VICA-smarthandle/vica_ros2_ws/maps/vica_map_0630.png

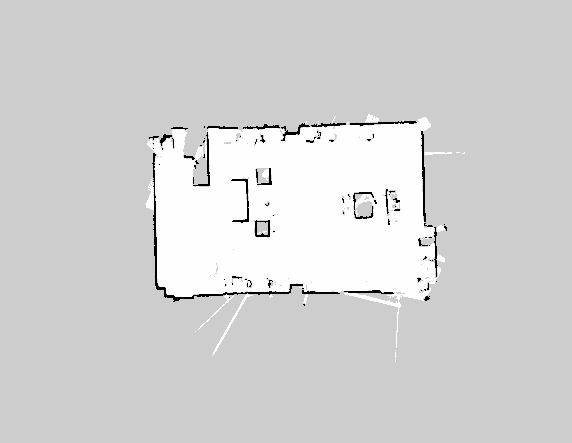
maps/vica_map_0630.png
