VICA-smarthandle/vica_ros2_ws/src/vica_description/meshes/left_wheel_1.stl

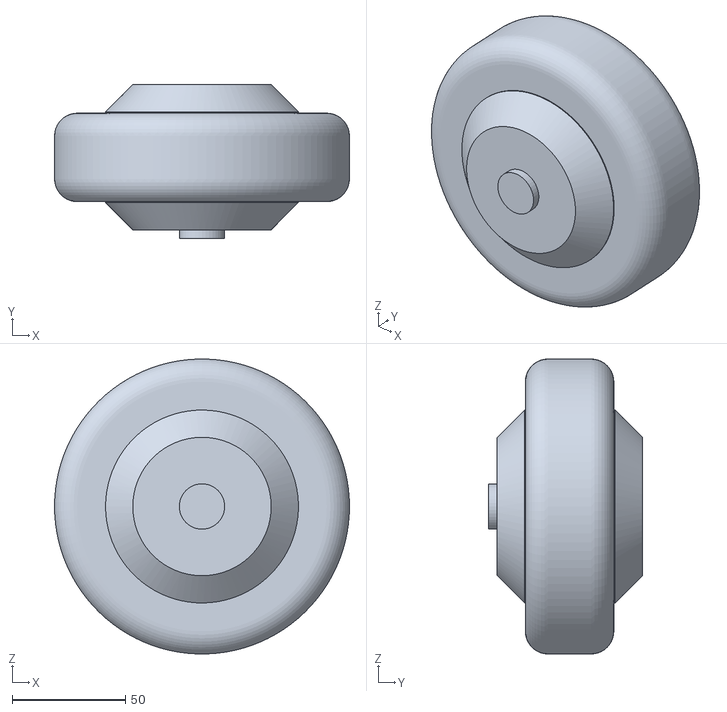
[picture p2: CAD file, 2026-09-11]
src/vica_description/meshes/left_wheel_1.stl
130.0 x 67.8 x 129.9
