VICA-smarthandle/vica_ros2_ws/src/vica_description/meshes/front_left_caster_steer_1.stl

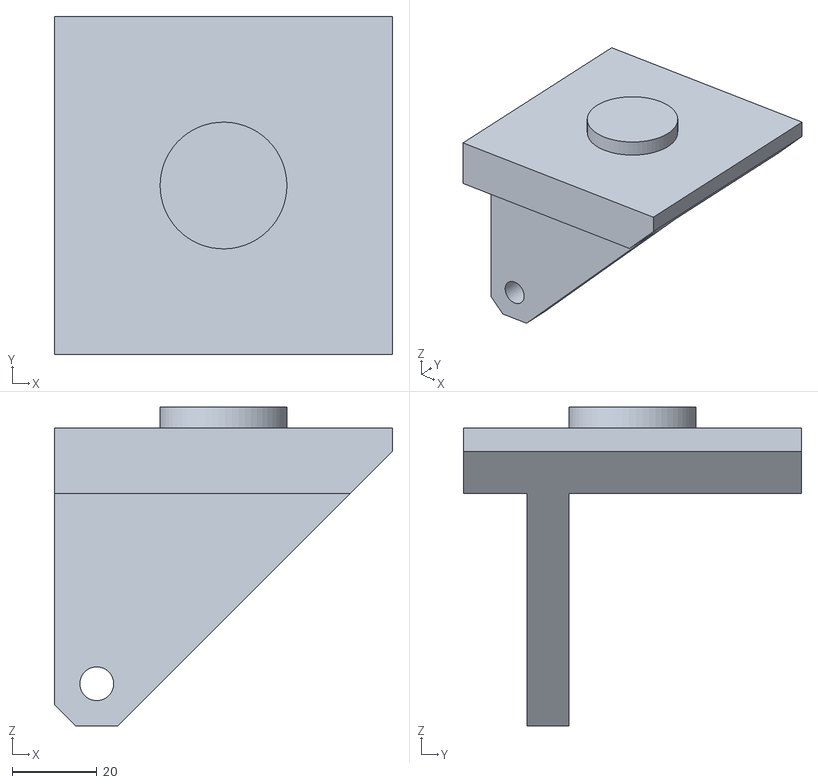
[picture p3: CAD file, 2026-09-11]
src/vica_description/meshes/front_left_caster_steer_1.stl
80.0 x 80.0 x 75.5
