VICA-smarthandle/vica_ros2_ws/src/vica_description/meshes/base_link.stl

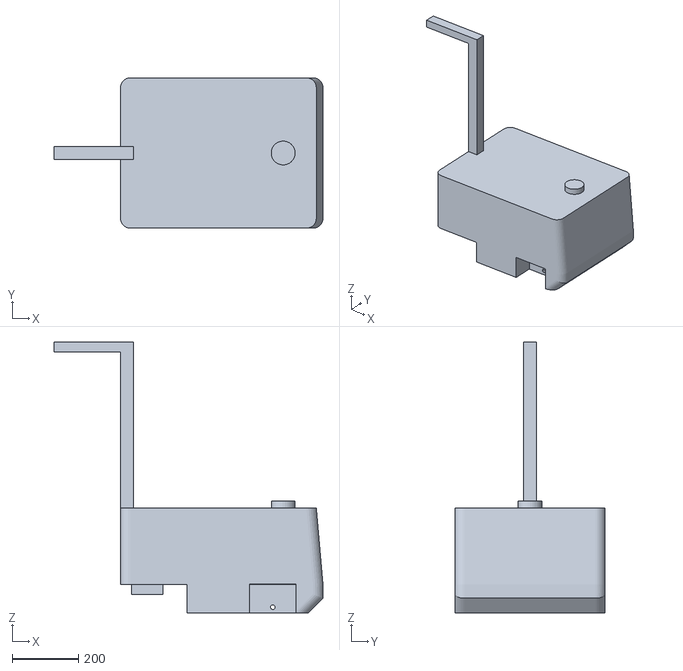
[picture p4: CAD file, 2026-09-11]
src/vica_description/meshes/base_link.stl
810.0 x 453.0 x 815.0
