VICA-smarthandle/vica_ros2_ws/src/vica_description/meshes/lidar_1.stl

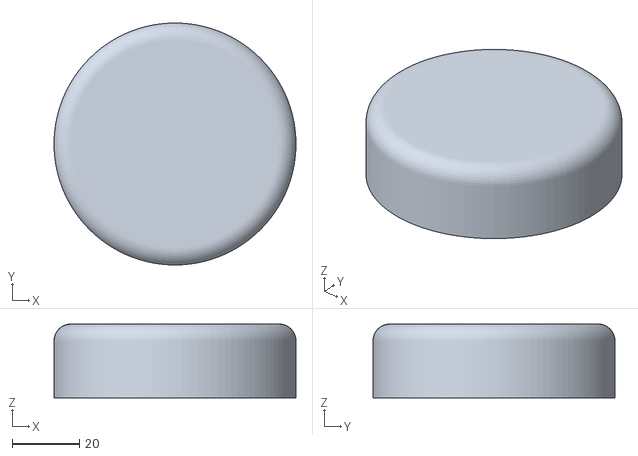
[picture p5: CAD file, 2026-09-11]
src/vica_description/meshes/lidar_1.stl
72.0 x 72.0 x 22.0
