VICA-smarthandle/vica_ros2_ws/src/vica_description/meshes/front_left_caster_wheel_1.stl

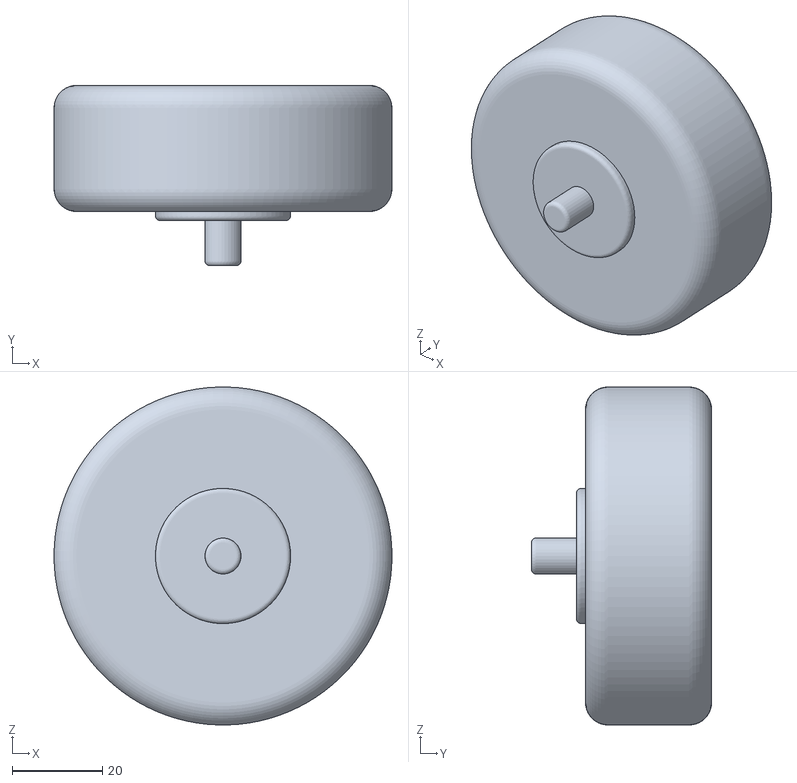
[picture p6: CAD file, 2026-09-11]
src/vica_description/meshes/front_left_caster_wheel_1.stl
75.0 x 40.0 x 75.0
