VICA-smarthandle/vica_ros2_ws/src/vica_description/meshes/base_link_mast.stl

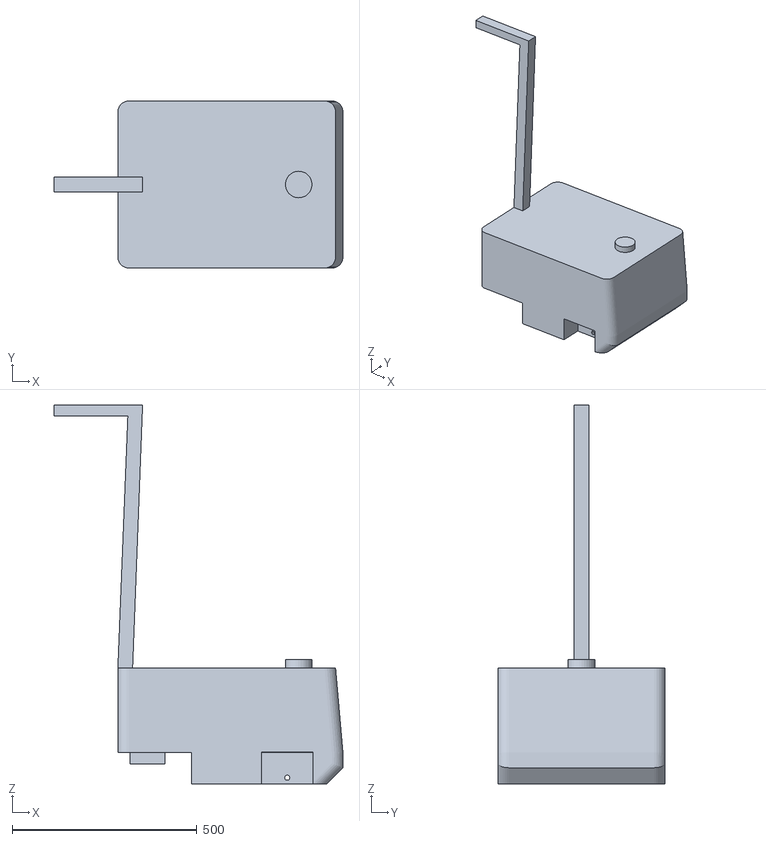
[picture p7: CAD file, 2026-09-11]
src/vica_description/meshes/base_link_mast.stl
783.0 x 453.0 x 1027.0
