VICA-smarthandle/vica_ros2_ws/(list of files, cad)

Other CAD files:
src/vica_description/meshes/front_right_caster_steer_1.stl
src/vica_description/meshes/right_wheel_1.stl
src/vica_description/meshes/front_right_caster_wheel_1.stl
