VICA-smarthandle/vica_ros2_ws/src/vica_system_monitor/config/probes.yaml

external_diagnostics_node:
  ros__parameters:
    diagnostic_period_sec: 1.0

    process_scan_period_sec: 5.0

    topic_probe_names:
      - lidar_scan
      - depth_scan
      - camera_depth
      - camera_color
      - odom
      - wheel_odom
      - handle_state
      - handle_uplink
      - app_bridge

    lidar_scan:
      component: lidar
      topic: /scan
      msg_type: sensor_msgs/msg/LaserScan
      qos: sensor_data
      min_hz: 7.0
      max_hz: 15.0
      fault_code: LIDAR_SCAN_STALE
      optional: false

    depth_scan:
      component: perception
      topic: /camera/depth_scan
      msg_type: sensor_msgs/msg/LaserScan
      qos: sensor_data
      min_hz: 3.0
      max_hz: 40.0
      fault_code: DEPTH_SCAN_STALE
      optional: true

    camera_depth:
      component: perception
      topic: /camera/camera/depth/camera_info
      msg_type: sensor_msgs/msg/CameraInfo
      qos: sensor_data
      min_hz: 10.0
      max_hz: 35.0
      fault_code: CAMERA_DEPTH_STALE
      optional: true

    camera_color:
      component: perception
      topic: /camera/camera/color/camera_info
      msg_type: sensor_msgs/msg/CameraInfo
      qos: sensor_data
      min_hz: 10.0
      max_hz: 35.0
      fault_code: CAMERA_COLOR_STALE
      optional: true

    odom:
      component: localization
      topic: /odom
      msg_type: nav_msgs/msg/Odometry
      qos: default
      min_hz: 20.0
      max_hz: 35.0
      fault_code: LOCALIZATION_ODOM_STALE
      optional: false

    wheel_odom:
      component: localization
      topic: /wheel/odom
      msg_type: nav_msgs/msg/Odometry
      qos: default
      min_hz: 5.0
      max_hz: 40.0
      fault_code: LOCALIZATION_WHEEL_ODOM_STALE
      optional: false

    link_probe_names:
      - cmd_vel_req_link

    cmd_vel_req_link:
      component: navigation
      topic: /cmd_vel_req
      min_publishers: 1
      fault_code: NAV2_CMD_PATH_DOWN

    handle_state:
      component: guidance
      topic: /vica/smart_handle_state
      msg_type: vica_interfaces/msg/SmartHandleState
      qos: default
      min_hz: 1.0
      max_hz: 4.0
      fault_code: GUIDANCE_NODE_SILENT
      optional: true

    handle_uplink:
      component: guidance
      topic: /ultrasonic/front_right
      msg_type: sensor_msgs/msg/Range
      qos: sensor_data
      min_hz: 2.0
      max_hz: 8.0
      fault_code: GUIDANCE_UPLINK_STALE
      optional: true

    app_bridge:
      component: app
      topic: /robot_status
      msg_type: std_msgs/msg/String
      qos: default
      min_hz: 1.0
      max_hz: 4.0
      fault_code: APP_BRIDGE_SILENT
      optional: true

    process_probe_names:
      - imu_adapter
      - ekf_node
      - controller_server
      - motor_node
      - realsense_node
      - voice_wakeword
      - voice_tts
      - voice_llm

    voice_wakeword:
      component: voice
      cmdline_pattern: src.ros_wakeword_node
      required: true
      warn_percent: 90.0

    voice_tts:
      component: voice
      cmdline_pattern: src.ros_tts_node
      required: true
      warn_percent: 90.0

    voice_llm:
      component: voice
      cmdline_pattern: src.ros_node
      required: true
      warn_percent: 90.0

    imu_adapter:
      component: localization
      cmdline_pattern: imu_base_link_adapter
      warn_percent: 55.0

    ekf_node:
      component: localization
      cmdline_pattern: ekf_node
      warn_percent: 20.0

    controller_server:
      component: navigation
      cmdline_pattern: controller_server
      warn_percent: 90.0

    motor_node:
      component: motor
      cmdline_pattern: mdrobot_can_keyboard_knob_node
      warn_percent: 25.0

    realsense_node:
      component: perception
      cmdline_pattern: realsense2_camera_node
      warn_percent: 60.0
