VICA-smarthandle/vica_ros2_ws/src/vica_safety/vica_safety/app_emergency_node.py

"""Public E-stop and reset orchestration ROS node."""

from datetime import datetime, timezone
import json
import threading
import time
from typing import Any, Optional

from action_msgs.msg import GoalStatus, GoalStatusArray
from action_msgs.srv import CancelGoal
from diagnostic_updater import Updater
import rclpy
from rclpy.callback_groups import ReentrantCallbackGroup
from rclpy.clock import Clock, ClockType
from rclpy.executors import ExternalShutdownException, MultiThreadedExecutor
from rclpy.node import Node
from rclpy.qos import qos_profile_action_status_default
from std_msgs.msg import Bool, String
from std_srvs.srv import Trigger

from .auto_recovery import AutoRecoveryPolicy
from .diagnostics import LABEL_BRIDGE, bridge_summary
from .freshness import is_fresh_ns, sec_to_ns
from .logging_utils import log_with_severity
from .reset_sequence import ResetSequence


CAUSE_MESSAGES = (
    ("tipped", "넘어짐이 감지되어 비상정지되었습니다."),
    ("physical_f1", "비상정지 버튼이 눌렸습니다."),
    ("voice", "이용자가 음성으로 멈춤을 요청해 비상정지되었습니다."),
    ("motor_can", "모터 드라이버 통신이 끊겨 비상정지되었습니다."),
    ("motor_can_stale", "모터 드라이버 통신이 끊겨 비상정지되었습니다."),
    ("physical_stale", "모터 드라이버 통신이 끊겨 비상정지되었습니다."),
)

TIP_RESET_REJECT_MESSAGE = (
    "비카가 아직 넘어져 있습니다. 비카를 세운 뒤 다시 해제해 주세요."
)

RESET_REJECT_PREFIX = "Safety reset 거부:"


def primary_cause(sources) -> Optional[str]:
    """Pick the latch cause the app popup should describe, or None."""
    names = set(sources)
    for name, _ in CAUSE_MESSAGES:
        if name in names:
            return name
    return None


def cause_message(cause: str) -> str:
    """Return the operator-facing popup text for one latch cause."""
    return dict(CAUSE_MESSAGES)[cause]


def reset_rejected_by_tip(step: str, reason: str) -> bool:
    """Report whether the central latch refused reset because the body is down."""
    if step != "estop_reset" or ":" not in reason:
        return False
    names = reason.split(":", 1)[1].strip().split(",")
    return "tipped" in names


def has_active_navigation_goals(statuses) -> bool:
    """Treat accepted, executing, and canceling Nav2 goals as active."""
    active = {
        GoalStatus.STATUS_ACCEPTED,
        GoalStatus.STATUS_EXECUTING,
        GoalStatus.STATUS_CANCELING,
    }
    return any(status in active for status in statuses)


def build_app_state(
    app_active: bool,
    emergency_active: bool,
    safety_state: str,
    message: str,
    timestamp: str,
    auto_recovered: bool = False,
    sources: tuple = (),
) -> dict:
    """Build the backward-compatible authoritative app state payload."""
    return {
        "node": "app_emergency_node",
        "active": emergency_active,
        "app_active": app_active,
        "emergency_active": emergency_active,
        "safety_state": safety_state,
        "reset_allowed": (
            not emergency_active
            and safety_state == "ESTOP_RELEASED_WAIT_RESET"
        ),
        "auto_recovered": auto_recovered,
        "sources": list(sources),
        "message": message,
        "timestamp": timestamp,
    }


class AppEmergencyNode(Node):
    """Own public E-stop services and the complete reset orchestration."""

    def __init__(self) -> None:
        super().__init__("app_emergency_node")

        self.declare_parameter("activate_service", "/app_estop_activate")
        self.declare_parameter("app_reset_service", "/app_estop_reset")
        self.declare_parameter("maintenance_reset_service", "/safety_reset")
        self.declare_parameter("app_emergency_stop_topic", "/app_emergency_stop")
        self.declare_parameter("state_topic", "/app_estop_state")
        self.declare_parameter("estop_reset_service", "/vica_safety/internal/estop_reset")
        self.declare_parameter(
            "supervisor_reset_service",
            "/vica_safety/internal/supervisor_reset",
        )
        self.declare_parameter("navigate_action_name", "/navigate_to_pose")
        self.declare_parameter("app_estop_publish_hz", 10.0)
        self.declare_parameter("state_publish_hz", 1.0)
        self.declare_parameter("call_timeout_sec", 2.0)
        self.declare_parameter("state_timeout_sec", 2.0)
        self.declare_parameter("source_settle_sec", 0.2)
        self.declare_parameter("estop_sources_topic", "/estop_sources")
        self.declare_parameter("auto_recover_settle_sec", 1.0)
        self.declare_parameter("auto_recover_check_hz", 2.0)
        self.declare_parameter("auto_recover_enabled", True)

        self.activate_service = str(
            self.get_parameter("activate_service").value
        )
        self.app_reset_service = str(
            self.get_parameter("app_reset_service").value
        )
        self.maintenance_reset_service = str(
            self.get_parameter("maintenance_reset_service").value
        )
        app_topic = str(self.get_parameter("app_emergency_stop_topic").value)
        state_topic = str(self.get_parameter("state_topic").value)
        estop_reset_service = str(
            self.get_parameter("estop_reset_service").value
        )
        supervisor_reset_service = str(
            self.get_parameter("supervisor_reset_service").value
        )
        action_name = str(
            self.get_parameter("navigate_action_name").value
        ).rstrip("/")
        app_publish_hz = float(
            self.get_parameter("app_estop_publish_hz").value
        )
        state_publish_hz = float(
            self.get_parameter("state_publish_hz").value
        )
        self.call_timeout_sec = float(
            self.get_parameter("call_timeout_sec").value
        )
        self.state_timeout_sec = float(
            self.get_parameter("state_timeout_sec").value
        )
        self.source_settle_sec = float(
            self.get_parameter("source_settle_sec").value
        )
        self.auto_recover_settle_sec = float(
            self.get_parameter("auto_recover_settle_sec").value
        )
        self.auto_recover_enabled = bool(
            self.get_parameter("auto_recover_enabled").value
        )
        auto_recover_check_hz = float(
            self.get_parameter("auto_recover_check_hz").value
        )
        estop_sources_topic = str(
            self.get_parameter("estop_sources_topic").value
        )

        self.cb_group = ReentrantCallbackGroup()
        self.reset_lock = threading.Lock()
        self.state_condition = threading.Condition()
        self.sequence = ResetSequence()

        self.steady_clock = Clock(clock_type=ClockType.STEADY_TIME)
        self.state_timeout_ns = sec_to_ns(self.state_timeout_sec)

        self.app_active = False
        self.emergency_active = True
        self.last_emergency_ns = None
        self.safety_state = "IDLE"
        self.last_safety_state_ns = None
        self.nav_statuses = []
        self.last_nav_status_ns = None
        self.last_message = "Safety 상태 확인 대기 중"
        self.auto_recovered = False
        self.last_estop_sources: tuple = ()
        self.last_cause: Optional[str] = None
        self.event_message = ""
        self.auto_recovery = AutoRecoveryPolicy(
            settle_ns=sec_to_ns(self.auto_recover_settle_sec),
        )

        self.app_estop_publisher = self.create_publisher(Bool, app_topic, 10)
        self.state_publisher = self.create_publisher(String, state_topic, 10)
        self.create_subscription(
            Bool,
            "/emergency_stop",
            self.emergency_callback,
            10,
            callback_group=self.cb_group,
        )
        self.create_subscription(
            String,
            "/safety_state",
            self.safety_state_callback,
            10,
            callback_group=self.cb_group,
        )
        self.create_subscription(
            String,
            estop_sources_topic,
            self.estop_sources_callback,
            10,
            callback_group=self.cb_group,
        )
        status_topic = f"{action_name}/_action/status"
        self.create_subscription(
            GoalStatusArray,
            status_topic,
            self.nav_status_callback,
            qos_profile_action_status_default,
            callback_group=self.cb_group,
        )

        cancel_service = f"{action_name}/_action/cancel_goal"
        self.cancel_client = self.create_client(
            CancelGoal,
            cancel_service,
            callback_group=self.cb_group,
        )
        self.estop_reset_client = self.create_client(
            Trigger,
            estop_reset_service,
            callback_group=self.cb_group,
        )
        self.supervisor_reset_client = self.create_client(
            Trigger,
            supervisor_reset_service,
            callback_group=self.cb_group,
        )

        self.create_service(
            Trigger,
            self.activate_service,
            self.handle_activate,
            callback_group=self.cb_group,
        )
        self.create_service(
            Trigger,
            self.app_reset_service,
            self.handle_reset,
            callback_group=self.cb_group,
        )
        self.create_service(
            Trigger,
            self.maintenance_reset_service,
            self.handle_reset,
            callback_group=self.cb_group,
        )
        self.create_timer(
            1.0 / app_publish_hz,
            self.publish_app_estop,
            callback_group=self.cb_group,
        )
        self.create_timer(
            1.0 / state_publish_hz,
            self.publish_state,
            callback_group=self.cb_group,
        )
        if self.auto_recover_enabled:
            self.create_timer(
                1.0 / auto_recover_check_hz,
                self.try_auto_recover,
                callback_group=self.cb_group,
            )

        self.diag_updater = Updater(self)
        self.diag_updater.setHardwareID('app_bridge')
        self.diag_updater.add(LABEL_BRIDGE, self.diagnose_bridge)

        self.get_logger().warn(
            "Public /safety_reset is an unauthenticated maintenance [GAP]."
        )
        self.get_logger().info(
            "Reset services share one orchestrator: "
            f"{self.app_reset_service}, {self.maintenance_reset_service}"
        )
        self.get_logger().info(
            "Reset clients: "
            f"{cancel_service}, {estop_reset_service}, "
            f"{supervisor_reset_service}"
        )

    def now_ns(self) -> int:
        """Return the current STEADY_TIME instant as integer nanoseconds."""
        return self.steady_clock.now().nanoseconds

    def emergency_callback(self, msg: Bool) -> None:
        """Track the authoritative central latch for app state and reset waits."""
        with self.state_condition:
            self.emergency_active = bool(msg.data)
            self.last_emergency_ns = self.now_ns()
            self.state_condition.notify_all()

    def safety_state_callback(self, msg: String) -> None:
        """Track Safety Supervisor state for the final reset confirmation."""
        with self.state_condition:
            previous = self.safety_state
            self.safety_state = str(msg.data)
            self.last_safety_state_ns = self.now_ns()
            self.auto_recovery.observe_safety_state(
                previous,
                self.safety_state,
            )
            self.state_condition.notify_all()

    def estop_sources_callback(self, msg: String) -> None:
        """Feed the central latch cause list into the auto-recovery policy."""
        sources = tuple(name for name in msg.data.split(",") if name)
        with self.state_condition:
            if sources:
                self.last_estop_sources = sources
            self.auto_recovery.observe_sources(sources, self.now_ns())
            self.update_cause_message(sources)

    def update_cause_message(self, sources) -> None:
        """Describe a new latch cause in the app popup (호출자가 lock 을 쥔다)."""
        cause = primary_cause(sources)
        if cause == self.last_cause:
            return
        previous = self.last_cause
        self.last_cause = cause
        if cause is not None:
            self.event_message = cause_message(cause)
            self.last_message = self.event_message
            return
        rejected = (
            self.last_message.startswith(RESET_REJECT_PREFIX)
            or self.last_message == TIP_RESET_REJECT_MESSAGE
        )
        if previous is not None and rejected and self.event_message:
            self.last_message = self.event_message

    def nav_status_callback(self, msg: GoalStatusArray) -> None:
        """Track active Nav2 action states, including canceling goals."""
        with self.state_condition:
            self.nav_statuses = [item.status for item in msg.status_list]
            self.last_nav_status_ns = self.now_ns()
            self.state_condition.notify_all()

    def handle_activate(self, request, response):
        """Latch the app source immediately and cancel Nav2 goals best-effort."""
        del request
        self.app_active = True
        self.publish_app_estop()
        self.last_message = "앱 E-stop이 활성화되었습니다."
        self.publish_state()
        nav_goal_clear, note = self.ensure_no_active_nav_goal()
        self.last_message = "앱 E-stop이 활성화되었습니다."
        if nav_goal_clear:
            self.last_message += " Nav2에 활성 Goal이 없음을 확인했습니다."
        else:
            self.last_message += f" Nav2 Goal 정리 확인 실패: {note}"
        self.get_logger().error(
            "[ESTOP ACTIVE] estop=True source=app "
            f"nav_goal_check={nav_goal_clear} reason={note}"
        )
        response.success = True
        response.message = self.last_message
        return response

    def handle_reset(self, request, response):
        """Run the same fail-closed orchestration for app and terminal reset."""
        del request
        if not self.reset_lock.acquire(blocking=False):
            return self.reject_reset(
                response,
                "nav_goal_check",
                "another reset is already in progress",
                sequence_started=False,
            )
        try:
            result = self.run_reset_sequence(response)
            if result.success:
                self.auto_recovery.notify_manual_reset()
                self.auto_recovered = False
            return result
        finally:
            self.reset_lock.release()

    def run_reset_sequence(self, response):
        """Cancel goals, clear the latch, then re-arm the supervisor."""
        self.sequence.begin()
        self.app_active = False
        self.publish_app_estop()
        self.publish_state()

        nav_goal_clear, message = self.ensure_no_active_nav_goal()
        if not nav_goal_clear:
            return self.reject_reset(response, "nav_goal_check", message)
        self.sequence.record("nav_goal_check", True, message)

        time.sleep(max(0.0, self.source_settle_sec))
        accepted, message = self.call_trigger(self.estop_reset_client, "estop_reset")
        if not accepted:
            return self.reject_reset(response, "estop_reset", message)
        self.sequence.record("estop_reset", True, message)

        if not self.wait_for_emergency_clear():
            return self.reject_reset(
                response,
                "emergency_clear",
                "fresh /emergency_stop=false was not observed",
            )
        self.sequence.record("emergency_clear", True, "emergency stop cleared")

        accepted, message = self.call_trigger(
            self.supervisor_reset_client,
            "supervisor_reset",
        )
        if not accepted:
            return self.reject_reset(response, "supervisor_reset", message)
        self.sequence.record("supervisor_reset", True, message)

        if not self.wait_for_safety_ready():
            return self.reject_reset(
                response,
                "ready",
                "fresh /safety_state=READY_TO_GO was not observed",
            )
        result = self.sequence.record("ready", True, "READY_TO_GO")
        self.last_message = (
            "Safety reset 완료: Nav2 Goal 없음, 중앙 래치 해제, "
            "Supervisor READY_TO_GO 확인"
        )
        self.get_logger().info(
            "[RESET ACCEPTED] ESTOP_RELEASED_WAIT_RESET -> READY_TO_GO "
            "estop=False"
        )
        response.success = result.success
        response.message = self.last_message
        return response

    def reject_reset(
        self,
        response,
        step: str,
        reason: str,
        sequence_started: bool = True,
    ):
        """Stop the sequence at the first failed step and report its cause."""
        if sequence_started and self.sequence.next_step == step:
            self.sequence.record(step, False, reason)
        if reset_rejected_by_tip(step, reason):
            self.last_message = TIP_RESET_REJECT_MESSAGE
        else:
            self.last_message = f"{RESET_REJECT_PREFIX} step={step}, reason={reason}"
        severity = "error" if "stale" in reason or "not observed" in reason else "warn"
        hint = ""
        if reset_rejected_by_tip(step, reason):
            hint = (" -- 세웠는데도 계속되면 ⑦ imu 칸(IMU 어댑터)을 다시 켠다: "
                    "1초 판정 뒤 지금 자세를 다시 낸다")
        log_with_severity(
            self.get_logger(),
            severity,
            f"[RESET REJECTED] step={step} reason={reason}{hint}",
        )
        response.success = False
        response.message = self.last_message
        return response

    def ensure_no_active_nav_goal(self) -> tuple[bool, str]:
        """Use the latest Nav2 state, requiring a new terminal state after cancel."""
        with self.state_condition:
            nav_status_seen = self.last_nav_status_ns is not None
            nav_statuses = tuple(self.nav_statuses)

        if not nav_status_seen:
            nav2_running = self.cancel_client.wait_for_service(timeout_sec=0.0)
            if not nav2_running:
                return True, "Nav2 is not running; goal check skipped"
            return True, "Nav2 has no goal status history; goal check skipped"
        if not has_active_navigation_goals(nav_statuses):
            return True, "no active Nav2 goal"

        if not self.cancel_client.wait_for_service(timeout_sec=1.0):
            return False, "Nav2 cancel service is unavailable"
        request_started = self.now_ns()
        result = self.call_sync(self.cancel_client, CancelGoal.Request())
        if result is None:
            return False, "Nav2 cancel response timed out"
        if result.return_code != CancelGoal.Response.ERROR_NONE:
            return False, f"Nav2 cancel return_code={result.return_code}"
        if not result.goals_canceling:
            return True, "no active Nav2 goal at cancel time"

        confirmed = self.wait_for_condition(
            lambda: (
                self.last_nav_status_ns is not None
                and self.last_nav_status_ns >= request_started
                and not has_active_navigation_goals(self.nav_statuses)
            )
        )
        if not confirmed:
            return False, "active or canceling Nav2 goal remains"
        return True, "all Nav2 goals canceled"

    def call_trigger(self, client, step: str) -> tuple[bool, str]:
        """Call one internal Trigger service with a finite deadline."""
        if not client.wait_for_service(timeout_sec=1.0):
            return False, f"{step} service is unavailable"
        result = self.call_sync(client, Trigger.Request())
        if result is None:
            return False, f"{step} response timed out"
        return bool(result.success), str(result.message)

    def call_sync(self, client, request) -> Optional[Any]:
        """Wait for a ROS service future while other executor threads run."""
        future = client.call_async(request)
        done = threading.Event()
        future.add_done_callback(lambda unused: done.set())
        if not done.wait(timeout=self.call_timeout_sec):
            return None
        try:
            return future.result()
        except Exception as exc:
            self.get_logger().error(f"service call failed: {exc}")
            return None

    def wait_for_condition(self, predicate) -> bool:
        """Wait for subscription state with a finite STEADY_TIME deadline."""
        deadline_ns = self.now_ns() + self.state_timeout_ns
        with self.state_condition:
            while not predicate():
                remaining_ns = deadline_ns - self.now_ns()
                if remaining_ns <= 0:
                    return False
                self.state_condition.wait(
                    timeout=min(remaining_ns / 1_000_000_000, 0.1)
                )
        return True

    def wait_for_emergency_clear(self) -> bool:
        """Require a fresh false central latch after its internal reset."""
        started = self.now_ns()
        return self.wait_for_condition(
            lambda: (
                self.last_emergency_ns is not None
                and self.last_emergency_ns >= started
                and not self.emergency_active
            )
        )

    def wait_for_safety_ready(self) -> bool:
        """Require a fresh READY_TO_GO state after Supervisor reset."""
        started = self.now_ns()
        return self.wait_for_condition(
            lambda: (
                self.last_safety_state_ns is not None
                and self.last_safety_state_ns >= started
                and self.safety_state == "READY_TO_GO"
            )
        )

    def try_auto_recover(self) -> None:
        """Clear a comm-only latch once, while stopped, without an operator."""
        with self.state_condition:
            if not self.auto_recovery.should_recover(self.now_ns()):
                return
            cause = ",".join(self.last_estop_sources) or "unknown"
            state_before = self.safety_state

        if not self.reset_lock.acquire(blocking=False):
            return
        try:
            self.get_logger().warn(
                f"[AUTO RECOVER] cause={cause} "
                f"settle={self.auto_recover_settle_sec:.1f}s "
                f"state_before={state_before}"
            )
            result = self.run_reset_sequence(Trigger.Response())
            with self.state_condition:
                self.auto_recovery.mark_attempted(success=result.success)
                self.auto_recovered = bool(result.success)
            if result.success:
                self.last_message = (
                    "통신이 복구되어 비상정지를 자동 해제했습니다 "
                    f"(원인: {cause})"
                )
                self.get_logger().info(
                    "[AUTO RECOVER] 완료: 관리자 개입 없이 래치를 해제했습니다"
                )
            else:
                self.get_logger().error(
                    f"[AUTO RECOVER] 실패: {result.message} "
                    "-- 이 사건은 관리자 reset이 필요합니다"
                )
        finally:
            self.reset_lock.release()

    def publish_app_estop(self) -> None:
        """Repeat the app source level without ever clearing the central latch."""
        msg = Bool()
        msg.data = self.app_active
        self.app_estop_publisher.publish(msg)

    def publish_state(self) -> None:
        """Publish authoritative integrated E-stop JSON for Flutter."""
        payload = build_app_state(
            app_active=self.app_active,
            emergency_active=self.emergency_active,
            safety_state=self.safety_state,
            message=self.last_message,
            timestamp=datetime.now(timezone.utc).isoformat(timespec="seconds"),
            auto_recovered=self.auto_recovered,
            sources=self.last_estop_sources if self.emergency_active else (),
        )
        msg = String()
        msg.data = json.dumps(payload, ensure_ascii=False)
        self.state_publisher.publish(msg)

    def diagnose_bridge(self, stat):
        """Report whether the app still has a working reset path."""
        now = self.steady_clock.now().nanoseconds
        emergency_fresh = is_fresh_ns(
            self.last_emergency_ns,
            now_ns=now,
            timeout_ns=self.state_timeout_ns,
        )
        safety_state_fresh = is_fresh_ns(
            self.last_safety_state_ns,
            now_ns=now,
            timeout_ns=self.state_timeout_ns,
        )
        level, message = bridge_summary(
            emergency_fresh=emergency_fresh,
            safety_state_fresh=safety_state_fresh,
        )
        stat.summary(level, message)
        stat.add('app_active', str(self.app_active))
        stat.add('emergency_active', str(self.emergency_active))
        stat.add('safety_state', self.safety_state)
        stat.add('emergency_fresh', str(emergency_fresh))
        stat.add('safety_state_fresh', str(safety_state_fresh))
        return stat


def main(args=None) -> None:
    """Run the public reset orchestrator with reentrant service callbacks."""
    rclpy.init(args=args)
    node = AppEmergencyNode()
    executor = MultiThreadedExecutor(num_threads=4)
    executor.add_node(node)
    try:
        executor.spin()
    except (KeyboardInterrupt, ExternalShutdownException):
        pass
    finally:
        node.destroy_node()
        if rclpy.ok():
            rclpy.shutdown()
