VICA-smarthandle/vica_ros2_ws/src/vica_user_guidance/vica_user_guidance/serial_link.py

"""Smart Handle 시리얼 전송 래퍼."""

from typing import Callable, Optional

from . import protocol

FAULT_NONE = 0
FAULT_PORT_OPEN = 1
FAULT_WRITE_FAIL = 2
FAULT_NOT_CONFIGURED = 3

DEFAULT_WRITE_TIMEOUT_SEC = 0.05
DEFAULT_RECONNECT_INTERVAL_NS = 2_000_000_000


class SerialLink:
    """1바이트 상태코드를 아두이노로 보낸다."""

    def __init__(
        self,
        port: str,
        baudrate: int,
        enabled: bool = True,
        write_timeout_sec: float = DEFAULT_WRITE_TIMEOUT_SEC,
        reconnect_interval_ns: int = DEFAULT_RECONNECT_INTERVAL_NS,
        serial_factory: Optional[Callable[..., object]] = None,
    ) -> None:
        self.port_name = port
        self.baudrate = baudrate
        self.enabled = enabled
        self.write_timeout_sec = write_timeout_sec
        self.reconnect_interval_ns = reconnect_interval_ns

        self._factory = serial_factory
        self._port = None
        self._fault_code = FAULT_NOT_CONFIGURED
        self._last_state_code = protocol.STATE_NORMAL
        self._write_error_count = 0
        self._last_attempt_ns: Optional[int] = None

        if self.enabled:
            self._open()

    @property
    def connected(self) -> bool:
        return self._port is not None

    @property
    def fault_code(self) -> int:
        return self._fault_code

    @property
    def last_state_code(self) -> int:
        return self._last_state_code

    @property
    def write_error_count(self) -> int:
        return self._write_error_count

    def send(self, state_code: int, now_ns: int) -> bool:
        """상태코드 1바이트를 전송한다. 성공하면 True."""
        if not protocol.is_sendable(state_code):
            raise ValueError(
                f"전송할 수 없는 상태코드입니다: {state_code} "
                f"({protocol.STATE_NAMES.get(state_code, '?')}). "
                "코드 4는 펌웨어 워치독 전용이고 6·7은 펌웨어 미구현입니다."
            )

        if self._port is None:
            return False

        try:
            self._port.write(bytes([state_code]))
            self._port.flush()
        except Exception:
            self._write_error_count += 1
            self._fault_code = FAULT_WRITE_FAIL
            self._close_port()
            self._last_attempt_ns = now_ns
            return False

        self._last_state_code = state_code
        self._fault_code = FAULT_NONE
        return True

    def send_raw(self, byte: int, now_ns: int) -> bool:
        """상태코드가 아닌 바이트(햅틱 명령 등)를 1개 전송한다. 성공하면 True."""
        if 0 <= byte <= protocol.STATE_CHARGED:
            raise ValueError(
                f"상태코드 범위({byte})는 send_raw 로 보내지 않는다. send() 를 쓸 것."
            )

        if self._port is None:
            return False

        try:
            self._port.write(bytes([byte]))
            self._port.flush()
        except Exception:
            self._write_error_count += 1
            self._fault_code = FAULT_WRITE_FAIL
            self._close_port()
            self._last_attempt_ns = now_ns
            return False

        self._fault_code = FAULT_NONE
        return True

    def read_available(self, now_ns: int) -> bytes:
        """수신 버퍼에 쌓인 바이트를 전부 반환한다. 없거나 미연결이면 b""."""
        if self._port is None:
            return b""
        try:
            waiting = self._port.in_waiting
            if not waiting:
                return b""
            data = self._port.read(waiting)
            return bytes(data) if data else b""
        except Exception:
            self._fault_code = FAULT_WRITE_FAIL
            self._close_port()
            self._last_attempt_ns = now_ns
            return b""

    def maybe_reconnect(self, now_ns: int) -> None:
        """backoff 간격이 지났으면 재연결을 1회 시도한다."""
        if not self.enabled or self._port is not None:
            return

        if self._last_attempt_ns is None:
            self._last_attempt_ns = now_ns
            return

        elapsed = now_ns - self._last_attempt_ns
        if 0 <= elapsed < self.reconnect_interval_ns:
            return

        self._last_attempt_ns = now_ns
        self._open()

    def close(self) -> None:
        """포트를 닫는다. 열린 적 없어도 안전하다."""
        self._close_port()

    def _open(self) -> None:
        factory = self._factory or self._default_factory
        try:
            self._port = factory(
                port=self.port_name,
                baudrate=self.baudrate,
                timeout=1,
                write_timeout=self.write_timeout_sec,
            )
        except Exception:
            self._port = None
            self._fault_code = FAULT_PORT_OPEN
            return
        self._fault_code = FAULT_NONE

    @staticmethod
    def _default_factory(**kwargs):
        """pyserial을 지연 import한다."""
        import serial  # noqa: PLC0415 — 지연 import가 의도다

        return serial.Serial(**kwargs)

    def _close_port(self) -> None:
        if self._port is not None:
            try:
                self._port.close()
            except Exception:
                pass
            self._port = None
