VICA-smarthandle/vica_ros2_ws/src/mdrobot_can_control/mdrobot_can_control/freshness.py

"""Shared steady-clock freshness predicate for the motor final stage."""

from typing import Optional


def sec_to_ns(seconds: float) -> int:
    """Convert a timeout expressed in seconds to integer nanoseconds."""
    return int(seconds * 1_000_000_000)


def is_fresh_ns(
    last_ns: Optional[int],
    now_ns: int,
    timeout_ns: int,
) -> bool:
    """Return True only for a received, non-reversed, in-window timestamp."""
    if last_ns is None:
        return False
    age_ns = now_ns - last_ns
    return 0 <= age_ns <= timeout_ns
