VICA-smarthandle/vica_ros2_ws/(commit log)

2026-06-01 Manage external ROS2 drivers with vica.repos
2026-06-01 Prepare motor odom launch workflow
2026-06-01 Defer motor launch workflow
2026-07-01 Integrate EKF, Nav2 scan filtering, and maps
2026-07-01 Add VICA description package
    [base_link.stl, controller.yaml, front_left_caster_steer_1.stl, front_left_caster_wheel_1.stl, front_right_caster_steer_1.stl, front_right_caster_wheel_1.stl, left_wheel_1.stl, lidar_1.stl]
2026-07-01 Update VICA description
    [VICA.xacro, base_link.stl, front_left_caster_steer_1.stl, front_left_caster_wheel_1.stl, front_right_caster_steer_1.stl, front_right_caster_wheel_1.stl, left_wheel_1.stl, lidar_1.stl]
2026-07-03 change TF
    [VICA.xacro]
2026-07-03 Update TF frame configuration
    [materials.xacro]
2026-07-14 [TONY] Import uncommitted work from operational ros2_ws
    지도(keepout·0529 location), nav2 파라미터, locations.json, URDF/rviz
    변경분을 실기 운영 워크스페이스(~/ros2_ws)에서 그대로 가져옴.
    [before_VICA.xacro]
2026-07-14 [TONY] Import app emergency-stop work from ros2_ws_test2
    앱 비상정지 체인 노드(emergency_stop_node, app_emergency_node,
    safety_supervisor_node)와 safety/motor bringup launch,
    keyboard_knob 수정분을 ~/ros2_ws_test2 미커밋 작업에서 가져옴.
    [app_emergency_node.py, emergency_stop_node.py, mdrobot_can_keyboard_knob_node.py, safety_supervisor_node.py]
2026-07-14 [TONY] Add vica_interfaces from vica-voice-llm (integration step 0)
    통합 진행순서 ⓪: 커스텀 msg(VicaIntent/EmergencyEvent/RobotState)의
    단일 소스를 로봇 워크스페이스로 이관. 원본은 vica-voice-llm
    ros2_ws/src/vica_interfaces (7007c86 기준, 내용 동일 복사).
2026-07-14 [TONY] Add vica_mission_manager v1 (integration step 2)
    /vica/intent 게이트 5조건 심사 후 통과 시에만 NavigateToPose 발행.
    상태 6종(idle/confirming/navigating/arrived/failed/estopped) 상태 머신,
    /vica/emergency 하드 긴급어 goal 취소(심층 방어), /emergency_stop 래치 연동,
    /vica/tts_request·/vica/robot_state 발행.
    게이트·전이 로직은 rclpy 비의존 순수 함수로 분리 (unit test 65개 통과).
    MultiThreadedExecutor + emergency 전용 callback group.
    스모크 테스트: (0,0) 플레이스홀더 거부, E-stop 체인, 해제 grace 검증 완료.
2026-07-14 [TONY] Publish TTS priority prefix from mission_manager
    Say 액션에 priority(emergency/narration/response) 추가, 노드가
    "{priority}:{text}" 형식으로 /vica/tts_request 발행 —
    ros_tts_node 큐 계약(vica-voice-llm src/tts_queue.py)과 정합.
    비상 멘트=emergency, 거부 응답=response, 시작·도착 등=narration.
    unit test 68개 통과, 토픽 스모크 확인 완료.
2026-07-14 [TONY] Wire voice emergency keywords to E-stop latch chain (integration step 3)
    emergency_estop_bridge(신규, vica_mission_manager 패키지): /vica/emergency
    하드 긴급어(멈춰/정지/스탑/스톱/안돼/위험해) → /voice_emergency_stop 펄스
    (기본 3s — keyboard_knob /estop_reset 이 /emergency_stop true 중에는
    해제를 거부하므로 입력은 방아쇠, 래치 유지는 keyboard_knob).
    emergency_stop_node 에 /voice_emergency_stop 입력 추가(앱 입력과 대칭 OR).
    감속 계열(천천히/느리게)은 v2 — 로그만 남기고 무시.
    unit test 74개 통과. 전체 체인 스모크: 긴급어→/emergency_stop true(32ms)
    → mission_manager estopped+긴급 TTS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
2026-07-21 Update VICA description visuals and camera link
    [VICA.xacro, materials.xacro]
2026-07-21 Align VICA base and sensor TF heights
    [VICA.xacro]
2026-07-22 [TONY] Switch default map to vica_map_0630 (demo map, integration step 1)
2026-07-22 [TONY] Gate estop release on /estop_state motor latch, not input OR
    실기 체인 시험(2026-07-16)에서 발견: 음성 펄스 만료로 /emergency_stop이
    false가 되면 모터는 아직 래치인데 mission_manager가 '해제되었습니다'
    멘트를 내보냄. estop 판정을 /emergency_stop OR /estop_state로 변경 —
    해제 멘트는 /estop_reset으로 래치가 실제 풀린 뒤에만 나간다.
2026-07-22 feat(localization): add wheel and imu EKF bringup
2026-07-22 refactor(safety): route motor commands through supervisor
2026-07-22 chore(sensor): remove unused rear scan filter
2026-07-23 fix(mission): remove emergency keywords from spoken messages
    The always-on emergency keyword monitor keeps the microphone open, so it
    also hears the robot's own speech. Four MSG_* strings contained hard
    emergency keywords, which made the robot trigger its own E-stop:
    speaker -> mic -> /vica/emergency -> emergency_estop_bridge
    -> /voice_emergency_stop -> emergency_stop_node
    "먼저 현재 안내를 멈춰 주세요" was the worst case: the phrase telling the
    user how to stop was itself a stop command.
    - MSG_BUSY: 멈춰 -> 취소해
    - MSG_ESTOP_REJECT / MSG_ESTOP_RELEASED: 비상 정지 -> 비상 멈춤
    - MSG_ESTOPPED: "비상 정지합니다." -> "안전을 위해 멈추겠습니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
2026-07-23 feat(mission): announce remaining distance while navigating
    A user who cannot see the robot has no way to tell whether arrival is
    imminent, so the guidance was silent between "안내를 시작합니다" and
    "도착했습니다". Announce the approach instead.
    - on_tick() now takes Nav2 feedback distance_remaining (optional, so
    existing callers keep working)
    - announce once per milestone, 10m and 3m by default
    - when several milestones are crossed at once (short trip), announce the
    one nearest to reality: starting 2m away must not say "10 meters left"
    - ignore None/0.0/negative, which Nav2 emits before the path is planned
    - milestones reset on new goal, idle and E-stop
    mission_manager_n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
2026-07-24 feat(ros2): integrate safety and destination mission flow
2026-07-24 fix(ros2): E-stop 리셋 판정과 RViz 설정 정비
    Nav2 action status의 마지막 상태를 기준으로 활성 Goal 취소 여부를 판정한다.\nGoal 이력이 없거나 취소 시점에 활성 Goal이 없는 경우를 안전하게 처리하고 관련 계약 테스트와 문서를 동기화한다.
    [app_emergency_node.py, test_app_emergency_contract.py]
2026-07-25 feat(nav2): nvblox_layer local costmap 통합 복구 + 도착 판정 contract
    Host 플러그인 dangling symlink(Goal 거부)와 nvblox slice 바닥 blanket
    (수락 후 무주행) 두 원인을 분리 해결. 실주행으로 nvblox_layer 활성 주행 확인.
    - vica_nvblox_bringup 신설: Docker nvblox 실행(global_frame=odom, camera
    remap) 고정, esdf_slice_min_height(기본 0.05)로 바닥 제외, run_nvblox.sh 대체
    - vica_nav2 dependency_checks + test_nvblox_dependency_contract: 플러그인
    xml/.so/msg 가용성 검증으로 dangling symlink 회귀를 런타임 이전에 차단
    - nav2_params.yaml: nvblox_layer 활성 상태 주석 정합화
    - test_nav2_params_contract: StoppedGo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
2026-07-25 feat(mission): Nav2 목적지 접근 감속(SpeedLimit) 추가
    목적지 잔여거리 approach_slowdown_distance_m(기본 3.0m) 이내 진입 시
    nav2_msgs/SpeedLimit(/speed_limit)로 controller 최대속도를
    approach_speed_limit_percent(기본 70%)로 제한한다. 주행 시작·도착·취소·
    실패·E-stop 시에는 제한을 해제(0%)한다.
    - SetNavSpeedLimit 액션 추가 및 mission_logic 상태 전이에 연동
    - approach_slowdown_distance_m / approach_speed_limit_percent 파라미터
    (launch → node → logic), 유효범위 검증 포함
    - nav2_msgs 의존 추가, /speed_limit 퍼블리셔
    - test_progress_narration: 접근 감속/해제 시나리오 계약 (89 tests 통과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
2026-07-25 chore(rviz): costmap layer marker·LaserScan 표시 조정
    nvblox/costmap 디버깅용 표시 설정 정리 — Marker namespace(layer) 활성화,
    LaserScan FlatColor·크기 5, Displays 트리 확장, 뷰 거리·창 크기 조정.
2026-07-25 docs(ros2): align current workspace documentation
2026-07-26 fix(safety): watchdog 시간 기준을 STEADY_TIME으로 통일
    Safety 입력 수신부터 motor 최종 정지까지 모든 경과시간 판단을 단일
    monotonic(STEADY_TIME) clock과 정수 나노초로 통일한다. system(wall) clock
    `time.time()`은 시간 동기화 보정·수동 변경·sim time 정지 시 age가 음수가 되어
    stale 판정을 뒤집을 수 있어 fail-safe를 깨뜨린다.
    - 공용 freshness 유틸(is_fresh_ns/sec_to_ns) 추가: vica_safety, mdrobot_can_control
    각 패키지 자립. 불변식 fresh = last_ns is not None and 0 <= age_ns <= timeout_ns
    - 미수신 sentinel을 0.0 → None으로, 음수 age(시간 역전)를 stale로 처리
    - 각 ROS 노드가 STEA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
    [app_emergency_node.py, emergency_latch.py, emergency_stop_node.py, freshness.py, mdrobot_can_keyboard_knob_node.py, motor_watchdog.py, safety_supervisor_node.py, test_app_emergency_contract.py]
2026-07-26 docs(safety): STEADY_TIME 실기 검증·머지 체크리스트 추가
    feat/safety-steady-clock 브랜치 전용 문서. Jetson 실기에서 이 브랜치를
    checkout하면 코드와 함께 딸려온다. 실기 종단 검증 3가지(Safety-CAN-motor
    종단, /clock 정지 내성, 시스템 시간 역전 내성)와 통과 시 dev 머지 / 실패 시
    브랜치 삭제 절차를 정리했다.
2026-07-27 fix(motor): knob stamp를 사이클 기준 시각으로 통일
    control_loop이 판정 기준 시각 `now`를 먼저 캡처한 뒤 drain_can_rx가 자체적으로
    더 나중 시각을 찍어, 방금 정상 수신한 knob이 음수 age(시간 역전)로 stale
    판정되었다. STEADY_TIME 전환에서 새로 도입한 "음수 age는 stale" 규칙과 기존
    호출 순서가 충돌한 결과다. fail-safe 방향이라 폭주 위험은 없으나, 최종 구동단
    출력이 주기적으로 0이 되어 주행이 끊긴다.
    - drain_can_rx(now_ns): stamp를 호출자의 사이클 기준 시각으로 주입한다.
    시각 재조회를 없애 호출 순서와 무관하게 사이클 내 음수 age가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
    [mdrobot_can_keyboard_knob_node.py, test_knob_cycle_stamp.py]
2026-07-27 docs(safety): STEADY_TIME 실기 검증 결과 기록
    2026-07-27 Jetson 실기(무부하)에서 체크리스트 세 검증을 모두 통과했다. 측정값과
    검증 방법, 그 과정에서 발견·수정한 결함을 5절에 기록한다.
    - §2.1 종단 4/4: 정상 주행 149샘플 안정, cmd 끊김 ≤234ms(기준 0.5s),
    knob 끊김 0.912s(기준 0.8s), 물리 E-stop 감지→정지 120ms
    - §2.2 /clock 정지: ROS 시간 45.96s 동결 중 타이머 4.5Hz 지속, 정지 233ms
    - §2.3 시간 역전: -1.09시간 점프에도 판정 유지, 역전 상태에서 정지 233ms.
    대조군인 표준 ros2 topic pub은 점프와 동시에 발행 정지
    - 측정 분해능 한계(로그 0.2s th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
2026-07-27 feat(motor): CAN 링크 상태 모델 추가
    주행 중 CAN 예외를 상태로 바꾸고 재연결 시점을 결정하는 순수 모델.
    시간 역전에서도 재연결을 막지 않아 복구 경로가 닫히지 않게 한다.
2026-07-27 fix(motor): CAN 장애에서 노드를 유지하고 /motor/can_ok를 발행
    주행 중 can1이 사라지면 bus.recv/send가 예외를 던져 프로세스가 종료됐다.
    예외를 CanLink 상태로 격리해 노드를 유지하고, 링크가 비정상이면 cmd·knob
    판정과 무관하게 출력을 0으로 막는다. 링크 상태는 /motor/can_ok로 발행해
    safety 계층이 걸쇠 판단에 쓴다. 재연결은 간격 제한을 두고 시도하되, 걸쇠는
    소유하지 않으므로 주행 재개는 관리자 reset을 거친다.
    [mdrobot_can_keyboard_knob_node.py]
2026-07-27 feat(safety): 중앙 걸쇠에 motor_can 원인 추가
    motor node의 CAN 링크 보고를 걸쇠 원인으로 흡수한다. false 수신은 물론
    미수신(motor_can_stale)도 원인으로 처리해 motor node 프로세스 사망까지
    fail-closed로 덮는다. 해제는 기존 관리자 reset 경로 하나를 그대로 쓴다.
    [emergency_latch.py, test_emergency_latch.py]
2026-07-27 feat(safety): /motor/can_ok를 중앙 걸쇠 입력으로 구독
    motor_can_timeout_sec(기본 0.5)로 신선도를 판정한다. f1_timeout_sec와 같은
    값으로 시작하며, 실기에서 실제 발행 주기를 측정해 확인한다.
2026-07-27 feat(motor): diagnostic_updater로 CAN 링크 상태 보고
    초안 6.1이 지정한 방식으로 /diagnostics에 CAN 링크 상태, 마지막 오류,
    cmd/knob age를 싣는다. 초안 3.1에 따라 보고 전용이며 정지 경로가 아니다.
2026-07-27 fix(motor): 재개방 실패가 노드를 죽이던 경로 차단
    try_reconnect_can이 재개방 전에 bus를 shutdown하지만, can.interface.Bus()
    자체가 실패하면 self.bus에 닫힌 핸들이 그대로 남았다. 닫힌 socketcan 소켓은
    CanError도 OSError도 아닌 ValueError('file descriptor cannot be a negative
    integer (-1)')를 던지므로(python-can 4.6.1, 실기 확인) except can.CanError를
    통과해 타이머 콜백 밖으로 탈출하고 노드가 죽었다. CAN 장애에서 노드를 살려
    두려던 이 브랜치의 목적이 장애 약 1초 뒤에 무너진다.
    - 재개방 실패 시 self.bus를 None으로 남기고, recv·send 앞에 None 가드를 둔다
    - CAN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
    [emergency_stop_node.py, mdrobot_can_keyboard_knob_node.py, test_can_reconnect.py, test_emergency_stop_contract.py]
2026-07-27 docs(safety): motor CAN health 실기 검증 결과 기록
    can1 down 시 motor node가 종료되던 결함(§5.5 범위 밖 결함)이 해소됐음을
    실기에서 확인했다. 세 시험 모두 통과했다.
    - can1 down: 노드 생존, 출력 0, 52ms 만에 중앙 걸쇠, reset 거부
    - 복구: 노드 재기동 없이 [CAN RECOVERED], 이후 관리자 reset 수락
    - 노드 강제 종료: 537ms 만에 motor_can_stale 중앙 걸쇠
    부수 확인 두 가지를 함께 남긴다. 드라이버 전원이 없으면 can1 up 자체가
    실패하므로 "CAN은 살아 있고 드라이버만 죽은" 거짓 OK 상태는 이 하드웨어에서
    성립하지 않는다. 반대로 인터페이스가 사라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
2026-07-27 test(safety): motor_can 커버리지 공백 3건 보강
    최종 리뷰가 지적한 대칭성·주장 검증 공백을 닫는다. 제품 코드 변경은 없다.
    - motor_can 시간 역전 테스트 추가 (physical에만 있던 축)
    - 모터 노드 사망 시 try_reset이 실제로 거부하는지 단언. evaluate가 stale을
    표시하는 것만으로는 이 브랜치의 핵심 주장이 보증되지 않는다
    - 경계값 테스트가 reset_allowed까지 단언하도록 보강
    [test_emergency_latch.py]
2026-07-28 docs(safety): 전부하 주행 중 /motor/can_ok 발행 주기 측정 결과
    Nav2 full stack + nvblox + RealSense가 모두 올라온 상태로 175초 실주행하며
    측정했다. 장애 0회, 최대 발행 간격 0.109초로 motor_can_timeout_sec 0.5초
    대비 4.6배 여유가 있다.
    무부하 0.042초(11.9배) 대비 여유가 절반 이하로 줄었으나 안전 범위다.
    0.109초는 Nav2 RUNNING 전환 순간의 일회성 스파이크이며 이후 130초 동안
    더 커지지 않았다.
    주행 중 장애가 0회이므로 걸쇠 디바운스 완화는 하지 않고 현재의 fail-closed와
    timeout 0.5초를 유지한다.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
2026-07-28 feat(mission): 안내 취소·일시정지·재개 경로 추가
    주행 중 로봇을 멈추는 방법이 비상정지뿐이었다. 비상정지는 중앙 래치가 걸려
    관리자 reset이 필요하므로, 사용자가 단순히 목표를 바꾸는 상황에는 과하다.
    안전 사건이 아닌 목표 조작을 위한 경로를 따로 만들었다.
    인터페이스:
    - MissionCommand.srv 신규. 취소·일시정지·재개가 공용으로 쓴다. 처음에는
    bool pause 하나로 정지와 재개를 겸하려 했으나 pause=false가 재개를 뜻해
    읽기 어렵고, E-stop 계열에서 false가 이미 다른 의미를 가져 혼동 위험이
    있었다. service를 셋으로 나눠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
2026-07-28 feat(user-guidance): Smart Handle 안내 계층 ROS 구현 (Phase 1~3)
    EKF /odom의 yaw 변화량으로 좌·우 회전을 감지해 Smart Handle 서보·LED에
    안내를 표시하는 계층을 추가한다.
    vica_interfaces:
    - TurnGuide.msg, SmartHandleState.msg 추가
    - Header·Time 사용에 따라 DEPENDENCIES std_msgs builtin_interfaces 선언
    (기존 msg 3종은 내장 타입만 써서 이 선언이 없었다)
    vica_user_guidance (신규):
    - turn_detector.py yaw 누적 → LEFT/RIGHT 판정 (순수 로직)
    - guidance_priority.py E-stop > 도착 > 회전 > 기본 병합 (순수 로직)
    - protocol.py 1바이트 상태코드 상수, 펌웨어 타이밍
    - serial_link.py 포트 부재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
2026-07-28 chore(user-guidance): 아두이노 펌웨어를 패키지 안으로 이동
    작업공간 루트의 source_file/smart_handle_firmware/를
    src/vica_user_guidance/firmware/로 옮긴다.
    이유:
    - source_file/은 루트 .gitignore에 제외되어 있어 bench로 검증한 펌웨어가
    어느 저장소에도 커밋되지 않는 상태였다
    - 펌웨어와 ROS 드라이버는 1바이트 상태코드 프로토콜을 공유한다. 같은
    패키지에 두면 프로토콜 변경 시 한쪽만 바뀌는 일을 막을 수 있다
    - source_file/은 원래 매뉴얼·데이터시트 보관용이며 그 용도로 남긴다
    경로 참조 갱신:
    - test_protocol.py, test_launch_contract.py가 새 경로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
2026-07-29 test(user-guidance): bench 단절 시험을 전송 중단 방식으로 재작성
    USB가 아두이노의 유일한 전원이라 케이블을 뽑으면 아두이노도 함께 꺼져
    LINK_LOST 표시를 볼 수 없었다(8번 항목이 유일한 미수행으로 남아 있었다).
    포트는 열어둔 채 전송만 멈춘다. 펌웨어 워치독은 lastRxMillis만 보므로
    "1.5초 무신호"라는 점에서 물리적 단절과 동일하다. 케이블을 뽑아서는 확인할
    수 없던 복구(전송 재개 -> 하늘색)까지 같은 항목에서 검증한다.
    실기 검증 결과 8/8 PASS.
    함께 고친 것:
    - 항목 설명 3건이 펌웨어 변경을 반영하지 못하고 있었다. 5번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
2026-07-29 feat(user-guidance): Smart Handle udev 규칙 추가
    /dev/ttyUSB* 번호는 USB 재열거 순서에 따라 바뀐다. 다른 USB-시리얼 장치를
    먼저 꽂으면 스마트핸들이 ttyUSB1이 되어 config 기본값이 어긋난다.
    /dev/vica_smart_handle 심볼릭 링크를 고정 부여한다.
    보드 시리얼(B003UMKG)까지 조건에 넣는다. 실측한 칩은 FTDI FT232R로
    idVendor/idProduct가 0403:6001인데, 이는 FT232R 계열 전체가 공유하는 값이라
    그것만으로는 장치를 특정하지 못하고 다른 FTDI 장치에도 같은 링크가 걸린다.
    보드를 교체하면 규칙도 함께 갱신해야 한다.
    ID_MM_DEVICE_IGNORE를 함께 둔다. 이 장비의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
2026-07-29 feat(user-guidance): goal 이벤트 파싱 실패를 경고로 남긴다
    /vica_goal_event의 payload를 파싱하지 못하면 도착 표시가 조용히 사라지는데,
    지금까지는 아무 로그도 남지 않아 단서가 없었다. mission_manager가 payload
    형식을 바꾸면 사용자에게 보이는 기능이 말없이 죽는다.
    2026-07-29 실기 검증에서 실제로 겪었다. 시험 스크립트가 평문
    "goal_succeeded"를 발행했고 도착이 동작하지 않았는데, 로그가 없어 원인
    파악에 디버깅 주기를 한 번 썼다. 실제 형식은 JSON이다.
    파싱 실패는 정상 운영에서 발생하지 않으므로 로그가 시끄러워지지 않는다.
    g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
2026-07-29 feat(user-guidance): 시리얼 포트를 udev 고정 이름으로 전환
    udev 규칙 설치와 /dev/vica_smart_handle 링크 생성을 확인한 뒤 기본값을 바꾼다.
    계획서 9.2절이 정한 순서다. 규칙 없이 먼저 바꾸면 모든 실행이
    FAULT_PORT_OPEN이 된다.
    적용 확인:
    - /etc/udev/rules.d/99-vica-smart-handle.rules 설치됨
    - /dev/vica_smart_handle -> ttyUSB0, root:dialout 0660 (chmod 불필요)
    - ID_MM_DEVICE_IGNORE=1 반영 (ModemManager 탐침 차단)
    - 노드 기동 시 connected=true, fault_code=0, write_error_count=0
    - arduino-cli upload도 심볼릭 링크로 정상 동작 (추정이 아니라 실행 확인)
    declare_parameter 기본값도 함께 바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
2026-07-29 feat(user-guidance): 정지 상태 yaw 드리프트 진단 도구 추가
    회전 임계값 25도가 실주행에서 안전한지 판단하려면 "yaw가 얼마나 흔들리나"
    보다 "정지 상태에서 회전 오탐이 나는가"를 직접 재는 편이 낫다. 전자는
    해석이 필요하고 후자는 답 그 자체다.
    그래서 turn_detector.TurnDetector를 그대로 재사용해 실제 판정 경로로
    측정한다. 로직을 복제하면 실제 노드와 달라져 측정이 무의미해진다.
    로봇을 움직이지 않는다. /odom을 구독만 하며 어떤 명령도 발행하지 않는다.
    판정:
    - 안전: 오탐 0, 임계값까지 여유 3배 이상
    - 주의: 오탐 0, 여유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
2026-07-29 fix(nav2): 복구 동작을 Safety 경로에 연결하고 planner를 SmacPlanner2D로 교체
    behavior_server의 속도 명령이 구독자 없는 /cmd_vel로 나가고 있었다. Nav2 humble
    navigation_launch.py는 controller_server에만 ('cmd_vel', 'cmd_vel_nav')를 주고
    behavior_server에는 remap을 주지 않는다. 2026-07-29 실측에서 /cmd_vel 발행자 5
    (전부 behavior_server), 구독자 0이었다. 즉 Spin·BackUp이 한 번도 로봇을 움직인
    적이 없고, planner가 실패하면 복구 6회가 전부 헛돌아 즉시 Goal failed가 됐다.
    CLAUDE.md의 "Nav2 최종 요청은 /cmd_vel_req" 계약 위반이기도 하다.
    노드 지정 remap(behavior_server:cmd_vel:=/cm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
    [vica_nvblox_overrides.yaml]
2026-07-29 docs(user-guidance): 회전 임계값 확정 근거를 주석에 반영
    enter_threshold_deg 25.0의 [미검증] 표기를 걷어낸다. 2026-07-29 바닥 주행
    (방2·화장실·안내소 순회)에서 실제 회전 8회가 전부 25.0~26.6°에 걸렸고,
    v=0.26 m/s로 40초 연속 직진하는 동안 오탐이 0회였다. 정지 상태 창 누적은
    yaw_drift_check 300초 측정에서 0.060°였다.
    값 자체는 바꾸지 않았다. 주석만 실측 근거로 교체한다.
2026-07-29 fix(nav2): 후방 footprint 기준을 STL에서 줄자 실측으로 바꾼다
    STL 실측 -0.505는 실제 차체보다 6 cm 짧다. 2026-07-29 줄자로 중심에서 핸들 끝까지
    56.5 cm를 쟀고, 같은 날 핸들 기둥 위치도 CAD(-0.265~-0.305) 대비 실측(-0.205)이
    7~10 cm 어긋나 CAD 후방부를 신뢰할 수 없음을 확인했다.
    구값 -0.60은 STL만 보고 "안전 여유"로 얹은 3.5 cm였는데 실측이 -0.565로 나와
    근거가 사라졌다. 전방·좌우와 같이 실측 + padding 0.05로 통일한다.
    외접반경은 0.707 -> 0.675 m가 된다. 지도 free 면적 106.4 m2 중 제자리 회전
    가능 면적이 42.0 -> 44.0 %다(+2.2 m2). 다만 이것으로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
2026-07-30 feat(nav2): planner를 Hybrid로 교체하고 nvblox를 global costmap에 넣는다
    같은 코스(방2 -> 화장실 -> 안내소)로 네 번 주행해 파라미터를 확정했다.
    결과: 완주 3/3, 총 145.6 s. 종전 최선(230.2 s) 대비 37 % 단축.
    ## 파라미터 변경 내역
    planner_server
    plugin SmacPlanner2D -> SmacPlannerHybrid
    SmacPlanner2D는 로봇을 점으로 본다(Node2D::isNodeValid ->
    inCollision(index, bool), 셀 하나). DWB ObstacleFootprint는 footprint
    전체를 보므로, planner가 통과 가능으로 만든 경로를 controller가 거부해
    통로 한가운데에서 20초 이상 굳었다. 맵 free 영역 106.4 m2에서 planner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
2026-07-30 tune(nvblox): 슬라이스를 분리하고 유령 decay 교착을 푼다
    주행 2회 결과를 담는다. 유령 지표는 개선됐으나 완주는 못 했다.
    ## 바꾼 파라미터와 이유
    vica_nvblox_overrides.yaml
    mapping_type static_tsdf -> dynamic
    global_costmap에 nvblox_layer를 넣은 뒤(직전 커밋) 사람이 static TSDF에 쌓여
    global costmap에 유령으로 남았다. 실측: 일시 LETHAL 셀 7,693 -> 33,138개,
    지속 중앙값 2.0 -> 9.0 s, p95 9.0 -> 46.0 s.
    하나의 decay로 '가구는 붙잡고 사람은 놓기'를 동시에 만족시킬 수 없어서
    두 mapper로 나눈다(nvblox_node.cpp 193~210, 921·927에서 decay가 따로 돈다).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
2026-07-30 feat(system-monitor): 관측 계층 메시지와 순수 판정 로직을 추가한다
    앱에 세부 오류를 표시하기 위한 관측 계층의 1·2단계다. 이 패키지는 정지 경로에
    들어가지 않는다(초안 3.1·3.2절). 기존 노드는 한 줄도 수정하지 않았다.
    vica_interfaces 메시지 3종:
    - RobotFault : 결함 하나. Header 없는 순수 데이터라 아래 둘이 재사용한다
    - RobotEvent : Header + RobotFault + transition(RAISED/ESCALATED/REMINDER/CLEARED)
    - RobotHealth : state + readiness 9종 + active_faults 배열
    readiness를 bool이 아니라 3상태(UNKNOWN/NOT_READY/READY)로 둔다. UNKNOWN은
    "정상"이 아니라 "관측 수단이 없다"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
    [freshness.py, test_agg_parser.py, test_event_deduplicator.py]
2026-07-30 tune(nvblox): 슬라이스 분리와 decay 가속을 되돌리고 exclude_last_view만 남긴다
    사람이 있는 조건에서 2/3 완주했다. 다만 유령에 대한 내 이론이 실측으로 틀렸다.
    되돌린 것 4개. 근거는 하나다 -- 유일하게 3/3 완주(145.6 s)한 조합 이후에 넣은
    변경 중 완주한 회차가 하나도 없다(1/3, 1/3, 1/3).
    mapping_type dynamic -> static_tsdf
    local nvblox 슬라이스 combined_map_slice -> static_map_slice
    슬라이스 분리는 유령 지표를 개선하지 못했다. 사람이 static TSDF에 쌓이는 것을
    막으려는 의도였는데 실측은 이랬다: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
2026-07-30 feat(system-monitor): 외부 대상을 대신 진단하는 어댑터 노드를 추가한다
    rplidar_ros, nvblox(Docker), D455는 외부 패키지라 fork하지 않으면 /diagnostics를 낼
    수 없다. 이 노드가 대신 관측해 표준 경로로 올린다. 그러면 외부 대상도 우리 노드와
    같은 경로(aggregator -> monitor -> 앱)로 흐른다.
    프로브 두 종류를 config/probes.yaml로 설정한다. 대상 추가에 코드 수정이 없다.
    - topic_rate : diagnostic_updater의 HeaderlessTopicDiagnostic + FrequencyStatusParam
    - process_cpu : /proc/<pid>/stat 기반 노드별 CPU %
    ROS 2 파라미터는 중첩 리스트를 담을 수 없어 이름 목록 + dotted namespa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
    [probes.yaml, test_config_contract.py, test_probe_config.py]
2026-07-30 test(nvblox): global의 nvblox_layer를 빼고 사람 조건에서 A/B 측정한다
    결론: 빼면 더 나쁘다. 예민함은 비용이 아니라 기능이었다.
    global_costmap.plugins
    [static_layer, obstacle_layer, nvblox_layer, inflation_layer]
    -> [static_layer, obstacle_layer, inflation_layer]
    이유: nvblox를 global에 넣은 뒤 평균 LETHAL이 벽(2,676셀)의 1.1배에서
    2.1~2.7배로 늘었다. 같은 코스 실측:
    nvblox 없음 2,923 / 2,918 / 2,954 (1.1배)
    nvblox 있음 7,164 / 6,814 / 6,140 / 5,578 / 6,865 (2.1~2.7배)
    사용자가 "인지가 너무 예민해졌다"고 지적했고 수치가 그것을 뒷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
2026-07-30 feat(system-monitor): 모니터 노드와 aggregator 설정·launch를 추가한다
    관측 계층 4단계다. /robot/health와 /robot/events를 발행해 앱이 세부 오류를 표시할 수
    있게 한다. 이 노드는 정지 경로에 들어가지 않는다(초안 3.1·3.2절).
    입력 경로가 두 갈래다:
    - 진단성 정보 : /diagnostics_agg (aggregator 집계)
    - 안전 상태 : /emergency_stop, /safety_state, TF를 직접 구독
    안전 상태를 직접 받는 이유는 aggregator가 1 Hz로 집계해 ESTOP 표시가 최대 1초
    늦어지기 때문이다. 진단이 1초 늦는 것은 유지관리에 문제가 없지만 안전 상태는 다르다.
    진단은 항목(name)별로 누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
2026-07-30 tune(nav2): planner를 Lattice로 바꾸고 global nvblox를 빼고 inflation을 0.35로 내린다
    주행 중 실제 충돌이 발생했다. 원인은 planner와 복구 동작의 충돌 임계값 비대칭이다.
    planner SmacPlannerHybrid -> SmacPlannerLattice
    두 블록의 키 이름을 바꿨다(GridBased <-> GridBasedAlt). Lattice는 Hybrid의
    minimum_turning_radius / motion_model_for_search / angle_quantization_bins /
    downsample_costmap을 받지 않아 블록 본문째로 교체해야 한다.
    이유: 하루 9회 주행을 전부 nvblox/costmap 축으로 썼는데 안내소 구간이 다섯 회차
    연속 실패했다. 다른 축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
2026-07-30 tune(nav2): inflation을 0.40으로 되돌린다 — 253 밴드 회전은 막지 못했다
    inflation_radius 0.35 -> 0.40 (양 costmap)
    사용자 지시. esdf_slice_max_height는 0.9 유지.
    0.35를 쓴 이유(지도에만 있는 유령 장애물의 inflation 회피)가 사라졌다 --
    사용자가 실물 장애물을 원위치로 복원했다. 그리고 0.35의 위험이 실제 충돌로
    나타났다(직전 회차: 화장실 구간에서 Spin이 253 밴드에서 회전해 핸들이 의자에
    부딪힘).
    완충 = 0.40 - 0.277 = 0.123 m 로 추종 오차 p95 0.120 m를 3 mm 차이로 덮는다.
    test_footprint_contract.py: inflatio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
2026-07-30 tune(bt): Spin 회전각을 90도에서 17도로 줄인다 — 사람 있는 조건 첫 3/3 완주
    ## 바꾼 것
    behavior_trees/vica_navigate_to_pose_no_backup.xml
    <Spin spin_dist="1.57"/> -> <Spin spin_dist="0.30"/> (90도 -> 17.2도)
    이유: 253 밴드에서 Spin이 회전을 시작해 핸들이 의자에 부딪혔다(직전 회차).
    Spin이 쓰는 CostmapTopicCollisionChecker::isCollisionFree는 254(LETHAL)에서만
    거부하고 253(INSCRIBED)은 통과시킨다. 헤더에 임계값 인자가 없고
    (isCollisionFree(pose, fetch)) Spin이 노출하는 파라미터는 simulate_ahead_time
    하나뿐이라, 설정으로 253을 거부하게 만들 수 없다. nav2_costmap_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
2026-07-31 fix(system-monitor): 실기동에서 드러난 기동 유예·문구·상태 결함 3건을 고친다
    젯슨 전 노트북 실행 검증에서 순수 로직 테스트가 원리적으로 잡을 수 없는 결함이
    드러났다. 셋 다 회귀 테스트를 먼저 쓰고 고쳤다.
    1. 기동 유예가 aggregator 경로에서 작동하지 않았다
    aggregator는 아직 뜨지 않은 부품에도 "Missing"을 1 Hz로 계속 발행한다. 그 입력은
    언제나 신선하므로 `not fresh` 조건을 쓰던 유예 분기에 도달조차 하지 못했다.
    미수신(None)으로 들어오는 TF 경로만 유예를 지켰다. 실측하면 grace 15~45초인
    컴포넌트들이 기동 1.3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
    [test_agg_parser.py, test_health_logic.py]
2026-07-31 refactor(system-monitor)!: 등급 축에서 비상정지를 떼어내 래치로 표현한다
    severity가 서로 다른 두 질문에 답하고 있었다.
    얼마나 나쁜가 OK / WARN / DEGRADED / STOP / FAULT
    어떤 모드인가 비상정지 래치가 걸렸다
    E-stop은 STOP보다 한 단계 심각한 것이 아니라 종류가 다르다. 래치가 걸리고, 관리자
    reset이 있어야 풀리고, emergency_stop_node가 소유한다. CLAUDE.md가 그 소유권을
    명시하는데 등급 값 하나가 그 의미를 몰래 들고 있었다.
    증상이 세 군데서 나왔고 셋째가 실제 버그다.
    1. _overall_state에 특례가 생겼다. "등급은 ESTOP인데 상태는 STOP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
    [test_config_contract.py, test_event_deduplicator.py, test_fault_catalog.py, test_health_logic.py]
2026-07-31 test(nav2): 복구를 걷어내 순수 주행을 측정한다 — inflation 0.45, Spin 양방향
    전제를 바꿨다. 지금까지의 완주 성적은 recovery가 실패를 흡수해서 나온 것이고
    순수 주행 실력은 한 번도 측정된 적이 없다. 12회차(155.4 s, 3/3)를 복구 없이
    다시 읽으면 DWB 무효 59회·lethal space 6회·최장정지 19.4 s가 전부 흡수되던
    것들이다. 측정 기준을 "완주했는가"에서 "어디서, 얼마의 여유를 남기고
    실패했는가"로 바꾼다.
    behavior_trees/vica_navigate_to_pose_clearing_only.xml (신규, 활성)
    Spin 2개와 Wait 1개를 뺐다. ClearEntireCostmap 4개, RecoveryNode,
    재시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
2026-08-01 fix(localization): 정지 중 자이로 편향을 빼서 EKF yaw 드리프트를 잡는다
    2026-08-01 Jetson 실측에서 바퀴를 띄운 정지 상태의 EKF /odom yaw가 시간당 161°
    드리프트했다. /wheel/odom yaw는 계속 정확히 0.00°였다.
    원인은 ekf.yaml의 두 입력이 모두 각'속도'만 준다는 것이다. odom0(/wheel/odom)은
    vx·vy·vyaw, imu0(/imu/base_link)는 vyaw다. 각도 그 자체를 주는 입력이 하나도 없어
    각속도를 적분해 각도를 만들며, 그래서 아무리 작은 편향도 시간에 비례해 무한히 쌓인다.
    경계별로 재서 편향 위치를 확정했다. 정지 30초 측정이다.
    원시 /camera/camera/imu gyro (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
2026-08-01 fix(system-monitor): process_cpu가 셸·런처 대신 실제 노드를 재게 한다
    2026-08-01 Jetson 실기에서 감시 노드가 imu_adapter CPU를 0.0 %로 보고했다. 실제는
    45 %였다. 같은 cmdline 패턴에 세 프로세스가 걸렸고 그중 노드가 아닌 것을 골랐다.
    pid 60999 /bin/bash -c ... imu_base_link_adapter ... 0.0 % <- 이것을 골랐다
    pid 61069 python3 /opt/ros/humble/bin/ros2 run ... adapter 0.1 %
    pid 61085 python3 .../vica_sensor_adapters/imu_base_link_... 45.5 % <- 진짜 노드
    _find_pid가 /proc 순회의 첫 일치를 그냥 반환했고 후보가 여럿이었다는 사실을 어디에도
    남기지 않았다. 셸 래핑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
    [test_process_selection.py]
2026-08-01 feat(system-monitor): probes.yaml 임계값을 실측으로 확정하고 Docker 프로브를 추가한다
    2026-08-01 Jetson 1차 측정(devlog 14절) 결과를 반영한다. 측정은 로봇 스택 40노드를
    띄운 뒤 **바퀴를 띄운 정지 상태**에서 했고 주행 명령은 발행하지 않았다.
    가장 중요한 수정은 /wheel/odom이다. 실측 9.53 Hz인데 min_hz가 20.0이라 **로봇이 주차만
    하면 영구 오탐이었다.** 20.0의 근거를 추적하니 encoder.yaml의 request_hz였는데 그 값은
    바로 위 request_position_feedback: false 때문에 적용되지 않는 벤치 전용 옵션이다.
    실제 주기는 모터 노드의 C5 요청 빈도가 정한다.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
    [probes.yaml, test_config_contract.py]
2026-08-01 fix(system-monitor): /wheel/odom 주기 설명을 주행 실측으로 정정한다
    앞 커밋(6b27905)에서 "실제 주기는 모터 노드의 C5 요청 빈도가 정한다"고 적었다. 틀렸다.
    주행 중 실측이 그것을 반증한다. 바퀴를 띄우고 0.26 m/s로 실제 회전시켰다.
    정지 9.45 Hz (바퀴 정지)
    일정 속도 9.45 Hz (바퀴 0.368 m/s)
    변동 속도 9.46 Hz (바퀴 0.534 m/s)
    CAN TX 14.9 -> 128.0 Hz
    CAN 요청이 8.6배 늘었는데 발행 주기는 전혀 변하지 않았다. 상한을 정하는 것은
    encoder_feedback 자신이다.
    self.timer = self.create_timer(1.0 / self.request_hz, self.loop) # 20.0
    def loop(sel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
    [probes.yaml]
2026-08-01 docs(system-monitor): /wheel/odom 9.45 Hz가 결함이 아님을 CAN 실측으로 확정한다
    앞 커밋(f93e53f)이 "약 37 %가 어디서 버려지는지 모른다"고 남겼다. 규명했다.
    MDROBOT 드라이버는 C5 응답을 약 105 ms마다 2~4프레임씩 뭉쳐서 보낸다. 버스트 자체가
    9.50 Hz이고 이것이 /wheel/odom 9.45 Hz와 일치한다. 버스트 안 프레임은 0.1 ms 간격이며
    같은 축의 값이 100 % 동일하다(68건 전부 동일, 다른 것 0건). 0.1 ms면 바퀴가 0.026 mm도
    움직이지 않으므로 애초에 다를 수 없다.
    즉 encoder_feedback이 버리는 37 %는 중복이며 정보 손실이 아니다. 9.45 Hz는 드라이버가
    실제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
2026-08-01 fix(localization): sensor_timeout을 실효 주기에 맞춰 0.1에서 0.2로 올린다
    /wheel/odom의 실효 주기가 9.45 Hz = 105.8 ms인데 sensor_timeout이 0.1(100 ms)이었다.
    즉 모든 주기마다 timeout을 넘겼다.
    robot_localization은 sensor_timeout이 지나면 그 센서가 끊겼다고 보고 보정 없이 예측만
    수행한다. 필터가 상시로 눈을 감고 도는 셈이었다.
    105.8 ms라는 값은 encoder_feedback의 설정이 아니라 MDROBOT 드라이버가 정한다. 드라이버가
    C5 응답을 약 105 ms마다 뭉쳐서 보내며 request_hz를 20에서 40으로 올려도 변하지 않는다
    (devlog 2026-07-31-health-monitor-implementation.md 14.14). 따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
2026-08-01 feat(safety): 세 노드가 /diagnostics를 발행해 Safety 상시 오탐을 없앤다
    vica_safety가 진단을 하나도 내지 않아 aggregator의 Safety 분석기가 항목 0개로
    남았고, 경로 자체가 Stale이 되어 앱에 "진단이 갱신되지 않았습니다"로 떴다.
    Safety가 READY_TO_GO로 정상 동작하는 중에도 관리자에게는 안전 장치가 고장난
    것처럼 보였다. 2026-08-01 Jetson 실기에서 확인한 오탐이다.
    /VICA/Safety level=3 message: "Stale"
    -> safety | DIAG_COMPONENT_STALE, safety_readiness=NOT_READY
    비상정지는 등급이 아니라 래치다. 버튼이 눌린 것을 ERROR로 올리면 정상 조작이
    고장으로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
    [app_emergency_node.py, diagnostics.py, emergency_stop_node.py, safety_supervisor_node.py, test_safety_diagnostics.py]
2026-08-01 feat(mission): 목적지 접근 감속을 다단계 사다리로 바꾼다
    급정지의 실체는 감속률이 아니라 속도 낙차(Δv)다. 최고속도가 0.26 m/s뿐이라
    decel_lim_x -2.5로도 0.104초·1.35 cm면 멈추므로, 핸들을 잡은 사용자에게
    전달되는 것은 "얼마에서 0으로 떨어졌는가"다. 그래서 "천천히 세운다"가 아니라
    "세우기 전에 이미 느리게 만든다"로 설계를 바꾼다.
    단발 래치(3.0 m에서 70 % 한 번)를 단계 목록으로 교체한다. 기본값은
    1.5 m 70 %, 1.0 m 55 %, 0.5 m 40 %다. 첫 감속 지점을 3.0 m에서 1.5 m로
    늦춘 것이 핵심 변경이며, 이미 저속인 로봇이라 3 m(그 자체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
2026-08-02 fix(monitor): 감시 계층이 만든 거짓 오류 세 건을 없앤다
    2026-08-01 실기에서 /robot/health가 상시 오류를 보고했고, 앱에 "주행 불가 ·
    위치추정 오류"가 떠서 설정을 의심하며 시간을 썼다. 셋 다 감시 쪽 문제였다.
    1) robot_localization의 죽은 진단
    name: 'ekf_filter_node: odometry/filtered topic status'
    message: No events recorded.
    Events since startup: 0 <- 기동 이후 단 한 번도 세지 않았다
    Minimum acceptable: 25.2 Hz
    같은 시각 /odom은 24.7 Hz로 정상 발행 중이었다. 주기가 낮은 것이 아니라
    카운터가 아예 돌지 않는다. ekf.yaml에 print_diagnostics: false를 넣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
    [test_agg_parser.py]
2026-08-02 tune(mission): 접근 감속을 3단계에서 2단계로 줄인다
    초안 (1.5, 70) (1.0, 55) (0.5, 40)에 "감속이 너무 느려서 답답하다"는 보고를
    받았다. 원인은 이 제한이 직진뿐 아니라 회전에도 같은 비율로 걸린다는 점이다.
    40 % 구간에서 max_vel_theta 0.4 -> 0.16 rad/s = 9도/초
    -> 도착 직전 제자리 회전 90도에 10초가 걸린다
    단계를 둘로 줄이고 시작 지점을 1.5 m에서 1.0 m로 늦춘다.
    마지막 1.5 m 소요 11.0 -> 7.5초
    마지막 회전 속도 9 -> 14도/초
    정지 시 Δv 0.104 -> 0.156 m/s
    정지 거리 3.3 -> 5.2 cm (xy_goal_tolerance 0.25 m의 1/5)
    안전 여유는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
2026-08-02 fix(guidance): 점멸등 좌우를 임시로 뒤집는다 — 정본은 펌웨어다
    "서보모터는 좌우 회전 피드백을 제대로 주는데 황색 점멸등만 좌우가 바뀌어서
    온다"는 실주행 보고를 받았다. 서보는 맞고 LED만 반대다.
    올바른 자리는 펌웨어다. 황색 점멸등은 .ino의 drawLine()이 그리는 ORANGE
    흐름선이고 어느 스트립에 그릴지는 WAVE_A/WAVE_B가 정한다. 그런데 젯슨에는
    arduino-cli도 Arduino IDE도 없어 펌웨어를 올릴 수 없다. 그래서 상위에서
    뒤집는다. 임시 조치이며, 펌웨어를 고칠 수 있게 되면 반드시 이 교환을 되돌리고
    .ino를 고친다. 양쪽을 다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
    [guidance_priority.py]
2026-08-02 chore(description): RViz 표시 구성을 주행 확인용으로 갱신한다
    2026-08-01 원격(xrdp)에서 RViz가 CPU를 크게 쓰며 느려졌다. 트리 높이를 줄이고
    동기화 기준을 PointCloud2로 바꿔 주행 중 확인에 필요한 항목만 남긴다.
    캐스터 링크 표시도 뺐다. 표시 구성일 뿐 주행 동작에는 영향이 없다.
    (cherry picked from commit e9700d5c139f9f53f0a5ff01fc562aefbcda7b03)
2026-08-02 tune(guidance): 회전 판정 임계값을 25도에서 20도로 낮춘다
    사용자 지시다. 방향 안내를 더 일찍 내보낸다.
    진입 시점 30°/s로 도는 자극 기준 0.83 -> 0.67초 (0.16초 빨라진다)
    직진 오탐 정지 시 창 누적 0.060°에 대해 여유 417배 -> 333배. 여전히 넓다
    놓치는 회전 2026-07-29 실주행에서 실제 회전 8회의 최솟값이 25.0°였으므로
    늘지 않는다
    config와 두 노드(turn_guide_node, yaw_drift_check)의 기본값을 함께 바꾼다.
    진단 도구가 다른 값을 쓰면 측정 결과를 그대로 비교할 수 없다.
    [미검증] exit_threshold_deg는 10.0으로 두어 히스테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
2026-08-02 fix(guidance): ROS의 좌우 교환을 걷어내고 보정 자리를 펌웨어로 못 박는다
    2026-08-01에 "황색 점멸등만 좌우가 바뀐다"는 보고를 guidance_priority.py에서
    상태코드를 뒤집어 대응했다. 그런데 아두이노는 상태코드 **하나**로 LED와 서보를
    같은 case에서 함께 정한다. LED는 맞았지만 **서보가 함께 뒤집혔다.** 시각장애인이
    손목으로 느끼는 것은 서보이므로 더 중요한 쪽을 깨뜨린 셈이다.
    2026-08-02에 ROS를 거치지 않고 펌웨어에 코드를 직접 넣어 원인을 확정했다
    (firmware/bench_test.py --hold 1 / --hold 2).
    코드 1 STATE_LEFT 서보 왼쪽 정상 · 주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
    [guidance_priority.py, smart_handle_firmware.ino]
2026-08-02 fix(guidance): 스마트핸들 LED 좌우를 펌웨어에서 바로잡는다
    D8(스트립 A)이 왼쪽, D9(스트립 B)가 오른쪽인데 주석 표기가 반대로 적혀 있어
    두 case의 LED 설정이 서로 뒤바뀌어 있었다. STATE_LEFT와 STATE_RIGHT에서
    currentMode와 setA/setB 두 줄만 맞바꾼다.
    servoMoveTo 줄은 건드리지 않았다. 서보가 물리적으로 거꾸로 장착돼 있어
    상수명과 반대로 부르는 것이 이미 올바른 보정이다. 상위 ROS에서 뒤집으면
    LED와 서보가 함께 뒤집히므로 보정 자리는 이 펌웨어뿐이다.
    노트북(x86_64)에서 arduino-cli로 실물에 업로드하고 bench_test.py로 확인했다.
    --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
    [smart_handle_firmware.ino]
2026-08-02 tune(nav2): planner 비교와 무관한 공통 설정을 Lattice 쪽에도 맞춘다
    이 브랜치는 SmacPlannerLattice 조합의 실주행 성능을 재는 A안이다. NavFn 조합
    (B안)과 **planner 축만 다르고 나머지는 같아야** 비교가 성립하는데, 2026-08-02
    오전에 두 축이 한 커밋(eab8003)에 섞여 있어 공통 개선이 B안에만 들어가 있었다.
    그 커밋에서 planner 비교와 무관한 부분만 옮긴다.
    Spin 회전속도 1.0/0.4 -> 0.4/0.15 도착 직전 급회전 보고
    smoother 직선감속 -2.5 -> -1.0 승차감. 정지거리 2.0 cm 증가는 padding이 덮는다
    BT 트리 clearing_only -> no_backup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
2026-08-02 tune(nav2): DWB가 내다보는 거리를 넓힌다 — sim_time 1.7 -> 2.5
    장애물을 4초 전부터 보고도 감속하지 않던 문제를 고친다.
    DWB는 '거리'가 아니라 '시간'을 내다본다. sim_time x max_vel_x 가 궤적 길이다.
    1.7 x 0.26 = 0.44 m + footprint 앞단 0.355 m = 검사 도달 0.80 m
    2.5 x 0.26 = 0.65 m + 0.355 m = 검사 도달 1.01 m
    obstacle_max_range 는 3.0 m 인데 DWB 는 0.80 m 앞만 검사했다. costmap 에 찍힌
    2.2 m 분을 controller 가 한 번도 읽지 않았다. 2026-08-02 run1104 에서 의자가
    1.5 m 앞에 찍히고 4초 뒤 LETHAL 이 될 때까지 속도가 0.20 -> 0.24 m/s 로 오히려
    올라간 이유다.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
2026-08-02 tune(nav2): inflation 0.50을 기준선으로 확정하고 회전반경 실험을 되돌린다
    2026-08-02 실주행 네 회차의 결과다. 사용자 판정: "회전반경 0.5 · inflation 0.5가
    베스트". 그 조합을 기준선으로 남긴다.
    ■ inflation_radius 0.45 -> 0.50
    0.45 1.0 m 통로에서 중앙 +-5 cm 가 전부 비용 0 -> 중앙으로 갈 유인이 없어
    벽에 붙어 돈다. planner "lethal space" 14회
    0.55 중앙마저 비용 115 -> planner 가 통로 자체를 우회한다.
    이동 거리 29.1 -> 36.2 m (+24 %), planner 실패 0회, Goal 전부 성공.
    "좁은 코너는 아예 안 간다"는 보고가 이 거리 증가다
    0.50 중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
2026-08-02 tune(nav2): footprint를 실측 육각형으로 바꾸고 padding 실험을 정리한다
    2026-08-02 실주행 세 회차의 결과다.
    ■ footprint 사각형 -> 육각형
    줄자 재실측: 손잡이 제외 차체 61 cm · 손잡이 돌출 29 cm · 합계 90 cm
    가로 45.5 cm · 손잡이 가장 넓은 곳 7 cm · 손잡이 높이 80 cm
    차체는 앞뒤 대칭(각 30.5 cm)이고 뒤로 29 cm 더 나온 것은 손잡이 하나다.
    사각형은 그 29 cm 를 차체 폭 45.5 cm 로 꽉 찬 것으로 다뤘다. 실제는 7 cm 막대다.
    R=0.5 호로 1.0 m 코너를 돌 때 필요한 폭
    사각형 0.990 m (여유 +1 cm) -> 육각형 0.750 m (여유 +25 cm)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
2026-08-02 perf(sensor): IMU 어댑터 출력을 50 Hz로 제한한다
    2026-08-02 주행 중 CPU 실측(scripts/vica_cpu_record.sh, 180초)에서 이 노드가
    **점유 1위**였다.
    imu_base_link_a 34.7 % <- 1위
    realsense2_came 26.6 %
    controller_serv 26.0 %
    ekf_node 25.7 %
    하는 일은 IMU 메시지의 좌표계를 바꿔 다시 내보내는 것뿐인데, D455 가 200 Hz 로
    보내고 EKF 는 30 Hz 만 쓰므로 6배를 헛돌고 있었다.
    같은 주행의 다른 수치가 문제의 성격을 보여준다.
    load average 17.1 (코어 8개)
    전체 CPU 461 % (4.6 코어) <- 40 % 이상 놀고 있다
    계산이 많아서가 아니라 **실행 대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
2026-08-02 tune(nav2): 판정 기준을 '사람이 따라올 수 있는가'로 바꿔 값을 확정한다
    2026-08-02 오후 여섯 회차의 결론이다. 최종값은 이렇다.
    planner SmacPlannerLattice · 0.5 m 격자
    footprint 육각형(손잡이 7 cm)
    footprint_padding 0.05
    inflation_radius 0.55 <- 이번 변경
    sim_time 2.5
    ObstacleFootprint.scale 0.15
    ■ inflation_radius 0.50 -> 0.55
    사용자 지시: "0.50 은 유턴할 때나 벽 근처에서 회전할 때 이용자가 부딪힐 수
    있을 것 같다."
    같은 날 오전에 0.55 를 '실패'로 판정했었다(이동 거리 +24 %, 좁은 통로 회피).
    그 판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
2026-08-04 test(nvblox): slice 계약이 VICA.xacro를 정본으로 읽게 한다
    COLLISION_Z_OFFSET = -0.044가 URDF와 별개로 하드코딩되어 있었다. body_center_z를
    고쳐도 이 테스트는 옛 값으로 계산해 통과하므로, 계약이 깨지지 않은 채 조용히
    어긋난다. 값을 복사하는 대신 정본을 파싱한다.
2026-08-04 fix(urdf): 구동륜·캐스터 조인트 기하를 CAD·실측에 맞춘다
    구동륜 간격이 0.293으로 적혀 있었다. 줄자 실측은 0.364이고 CAD 0.3618과도 2.2 mm
    안에서 맞는다. 캐스터 휠은 10 mm 안쪽, 차체·라이다 메시는 3 mm 어긋나 있었다.
    wheel_base_m 0.37은 그대로 둔다. 그건 회전 시험으로 맞춘 오도메트리 보정 상수라
    실측 기하와 같을 필요가 없다.
    -0.044를 인용하던 주석 세 곳을 같은 커밋에서 고친다. 나눠 두면 그 사이에 거짓
    주석이 남는다.
    visual origin이 joint origin을 정확히 상쇄해 RViz에서는 정상으로 보였고, 오차
    방향이 회전축과 같아 바퀴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
    [VICA.xacro]
2026-08-04 refactor(urdf): 좌표 상수를 property로 묶는다
    이번 오류 3건이 전부 손으로 적은 좌표 상수에서 나왔다. y 계열을 property 하나로
    모으고 라이다 메시 z를 body_center_z 수식으로 바꿔, 같은 수를 두 번 적지 않게
    한다. xacro 출력은 직전 커밋과 완전히 동일하다.
    [VICA.xacro]
2026-08-04 feat(urdf): camera_optical_frame을 추가한다
    실물은 RealSense 드라이버가 optical 프레임을 발행하지만 Isaac에는 드라이버가
    없다. 정본을 하나로 유지하려고 URDF가 제공한다. RealSense 기본 이름
    (camera_color_optical_frame 등)은 TF 중복 충돌을 피하려고 쓰지 않는다.
    [VICA.xacro]
2026-08-04 refactor(description): 실주행 TF launch를 GUI에서 분리한다
    기동 매뉴얼 ②단계가 실주행에서 display.launch.py를 띄우는데, 이 launch는
    joint_state_publisher_gui(Qt)를 조건 없이 함께 올린다. 헤드리스에서는 뜨지 않아
    TF 트리가 통째로 끊긴다.
    joint_state_publisher_gui는 joint_state_publisher에 Qt 창만 얹은 래퍼라 발행
    로직이 같다. 창만 빠지고 RViz의 바퀴 메시는 그대로다. display.launch.py는
    확인용으로 현행 유지한다.
2026-08-04 refactor(description): TF launch를 기반+상위 구조로 나눈다
    robot_state.launch.py를 기반으로 두고 gui 인자로 GUI 유무를 가른다.
    display.launch.py는 그것을 include하며 gui:=true를 넘기고 RViz만 얹는다.
    nav2_bringup과 이 저장소의 vica_slam_bringup이 쓰는 계층 구조와 같다.
    로직이 같다. 창만 빠지고 RViz의 바퀴 메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
2026-08-04 chore(scripts): 옛 좌표의 run_tf_vica.sh를 지운다
    before_VICA.xacro 시절 좌표(laser 0.00995/0.319, camera 0.105/0.265)로 static TF를
    발행한다. 현재 URDF는 0.185/0.192, 0.28683/0.130이다. 참조하는 문서·코드가 없고
    기동 매뉴얼도 언급하지 않으며, 존재하지 않는 /home/ji_w/ros2_ws를 source한다.
    살려두면 URDF와 이중 정본이 되어 같은 어긋남이 재발한다. git 이력에 남는다.
2026-08-04 chore(scripts): 일회성 진단 스크립트 run_tf_tree.sh 를 지운다
    view_frames 로 TF 트리를 덤프하고 RealSense optical 프레임 존재를 확인하던
    일회성 도구다. 사용자가 임시 발행용이었음을 확인해 주었다.
    ROS_DOMAIN_ID=7 과 $HOME/ros2_ws/tf_trees 를 하드코딩하고 있어 다른 장비에서
    그대로 쓸 수도 없다. 같은 진단이 필요하면 ros2 run tf2_tools view_frames 를
    직접 부르면 된다. git 이력에 남는다.
2026-08-04 fix(voice): 안내 멘트의 "(으)로" 를 이름 받침에 맞춰 정한다
    MSG_START·MSG_RESUMED 가 "(으)로" 표기를 그대로 두고 있어 TTS 가
    "별빛관 1층 화장실으로 안내를 시작합니다" 처럼 읽었다 (2026-08-04 실기 확인).
    안내를 시작할 때마다 나오는 문장이다.
    josa_euro() 로 받침을 보고 '로/으로' 를 정한다. vica-voice-llm 의
    destination_loader._josa_euro 와 같은 로직이며, 저장소 간 의존을 만들지 않으려고
    사본을 둔다 (freshness.py 사본과 같은 판단).
    say_destination() 을 거치게 해서 호출부가 josa 를 빠뜨릴 자리를 없앴다.
    test_spoken_text 에 회귀 검사 3건 추가:
    -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
2026-08-04 fix(description): display.launch.py의 gui 인자를 실제로 동작하게 한다
    --show-args가 gui(default: 'true')를 보였지만 include에서 "true"로
    하드코딩되어 gui:=false를 줘도 무시됐다. DeclareLaunchArgument로 gui를
    선언하고(기본값 false) 그 값을 robot_state.launch.py include에 그대로
    넘긴다.
    기본값을 false로 정한 이유: joint_state_publisher_gui를 쓴 이유는 RViz에서
    바퀴 메시가 사라져서였는데, 실제로 그 문제를 푸는 것은 슬라이더가 아니라
    그 안에 포함된 joint_state_publisher다 — 바퀴가 continuous 조인트라
    /joint_states가 있어야 TF가 생기고 RViz가 그 링크를 그린다. 슬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
    [VICA.xacro]
2026-08-04 fix(voice): 주행 실패·비상해제 안내를 폐기 대상 등급에서 올린다
    MSG_NAV_FAILED·MSG_ESTOP_RELEASED 가 priority 미지정(=narration)으로 나가고
    있었다. narration 은 TTS 큐 정원(8) 초과 시 가장 먼저 버려지는 등급이다
    (vica-voice-llm tts_queue._trim). 거리 안내가 밀린 상황에서 주행이 실패하면
    "이동에 실패했습니다" 가 조용히 사라질 수 있다.
    두 멘트 모두 사용자가 현재 상태를 아는 유일한 단서다. 눈으로 확인할 수 없는
    사용자에게는 침묵이 곧 상태 오해로 이어지므로 response 로 올린다.
    회귀 검사 2건 추가 — 주행 실패(NavStatus.FAILED)와 비상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
2026-08-06 chore(localization): 참조되지 않는 ekf 사본을 지운다
    ekf_config/ekf.yaml 은 어떤 launch 도 읽지 않는다(git grep 참조 0건). 그런데
    sensor_timeout 0.1 을 품고 있다 — 정본은 /wheel/odom 실효 주기가 9.45 Hz
    (105.8 ms)라 매 주기 timeout 을 넘기던 문제를 고쳐 0.2 로 올린 값이다.
    print_diagnostics 항목도 없어 기본 true 로 남으므로, 실기에서 앱에 "주행 불가 ·
    위치추정 오류"로 뜨던 거짓 ERROR 도 함께 되살아난다.
    누가 ekf_params_file:= 로 이 경로를 넘기면 조용히 두 버그로 돌아간다.
    정본은 src/vica_localization/config/ekf.yaml 하나다.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
2026-08-06 docs(nav2): 코드와 어긋난 주석을 고치고 근거 없는 값에 표식을 단다
    2026-08-06 설정 전수 점검에서 찾은 것들이다. Nav2 가 읽는 값은 하나도 바꾸지
    않았다 — YAML 을 파싱해 dev 와 대조한 결과 값 변경 0 / 키 추가 0 / 키 삭제 0
    이고, BT 도 XML 노드 구조가 동일하다.
    어긋나 있던 주석:
    - planner 두 블록의 헤더가 서로 반대편에 붙어 있었다. 활성 블록(GridBased)에
    "비교용 대안. Nav2 가 로드하지 않는다"가 달려 있어 실제로 돌아가는 planner 를
    안 쓰는 것으로 오해하게 했다. A/B 로 키 이름만 맞바꾸며 헤더를 안 옮긴 결과다.
    - inflation 0.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
2026-08-08 fix(monitor): Nav2 가 죽은 상태를 정상으로 읽던 판정을 고친다
    lifecycle_manager 진단으로 Nav2 생존을 판정하는 fallback 에 결함이 셋 있었다.
    셋 다 "Nav2 가 내려갔는데 앱에 주행 준비 완료가 뜬다"로 나타난다.
    - 문구: `'active' in message` 가 "Nav2 is inactive" 에도 걸렸다. Nav2 가 죽은
    바로 그 순간에 활성으로 보고했다. 두 문자열은
    libnav2_lifecycle_manager_core.so 에서 확인했다.
    - 등급·신선도: diag_items 는 만료 제거를 하지 않고, aggregator 는 발행이 끊긴
    항목의 message 를 그대로 둔 채 level 만 STALE 로 바꿔 재발행한다. 둘 다 보지
    않아 한 번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
    [test_nav2_liveness.py]
2026-08-11 chore: 린터를 통과하지 못하던 네 패키지를 정리한다
    encoder_feedback · mdrobot_can_control · vica_cartographer · vica_sensor_adapters 가
    ament_flake8 / ament_pep257 을 통과하지 못했다. 워크스페이스 시험이 8건 실패였고 그
    때문에 나머지 실패가 묻혔다. 이제 12개 패키지 678건이 전부 통과한다.
    기능 변경은 없다. 아래에 각 부류마다 무엇으로 그것을 증명했는지 함께 적는다.
    ## Q000 따옴표 321건 — AST 동일성으로 증명
    가장 큰 덩어리이자 유일하게 위험했던 부분이다. 모터·엔코더 노드 소스 전체의 따옴표를
    바꾸는 일이라 손으로 하면 오타 하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
2026-08-13 fix(nav2): footprint 를 하드웨어 최종 실측으로 갱신한다
    손잡이가 29 -> 19 cm 로 짧아졌다. 차체 61 cm 는 그대로여서 총 세로가
    90 -> 80 cm 가 되고, 폭은 45.5 -> 45 cm 다. 좌표로는 후방 -0.595 ->
    -0.495, 반폭 0.2275 -> 0.225 다.
    효과는 통과보다 회전에서 크다(padding 0.05 포함):
    내접 0.2775 -> 0.275 m 통과 가능성. 3 mm 차이라 사실상 그대로다
    외접 0.651 -> 0.552 m 제자리 회전. 10 cm 줄었다
    제자리 회전 필요 직경 1.30 -> 1.10 m
    L자 코너 최소 통로 0.728 -> 0.670 m
    손잡이 끝이 외접반경을 정하므로 뒤를 줄인 효과가 회전에 그대로 나타난다.
    코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
2026-08-13 tune(nav2): 검증된 update_min 을 반영하고 주행 속도를 0.5 로 올린다
    이번 회차의 기준선이다. 여기서부터 Spin 제거 · alpha1 · max_beams 를 한
    단계씩 얹는다.
    update_min_a/d 를 0.2 / 0.25 에서 0.10 / 0.10 으로 내린다. 2026-08-12 probe
    측정에서 효과가 확인됐다(~/vica_amcl_logs, 21:01 -> 21:15):
    1 m 당 갱신 4.83 -> 10.04 회 (2.08배)
    무갱신 중앙값 1.05 -> 0.45 s (0.43배)
    무갱신 p95 1.40 -> 0.65 s (0.47배)
    최악 무갱신은 2.75 -> 4.05 s 로 오히려 나빠져 8/11 기준(3 s 미만)에 못 미친다.
    비교 스크립트가 CPU 포화를 지목했으므로 max_beams 는 60 으로 둔다. CPU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
2026-08-13 fix(nav2): 복구에서 제자리 회전을 제거한다
    시뮬 12패스에서 복구가 주행 시간의 87~91 %를 차지했고 그중 Spin 이 27.6 s 로
    최대 항목이었다. 그런데 Spin 의 충돌 검사는 254 만 거부하고 253 은 통과시켜
    벽 가까이서도 회전을 시작한다. 253 은 내접반경 0.2775 m 이내라는 뜻이고 그
    자리에서 돌면 후방 꼭짓점이 0.651 m 를 쓸어 2026-07-30 에 핸들이 의자에
    부딪혔다. inflation_radius 를 올려 253 진입을 줄여봤으나 접촉 샘플이
    18개 -> 18개로 동일했다.
    효과도 없다. RoundRobin 이 좌/우를 번갈아 내므로 6회 순환의 순 회전은
    +17.2도뿐이고, 통로 1.0 m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
2026-08-13 test(nav2): 1단계 Spin 제거를 0810 지도에서 실주행으로 확인한다
    회차 run1_nospin_0810 (231 s, 목적지 3곳 순회). 기준선은 run0_baseline_0810.
    No valid trajectories 83 -> 14 6분의 1
    lethal space 18 -> 7
    제자리 회전 38회 32.4 s -> 12회 10.3 s
    벽 최소 이격 0.15 -> 0.22 m
    정지 구간 수 30 -> 9
    회전을 없앴더니 궤적 실패가 줄었다. Spin 이 상황을 악화시키고 있었다는 뜻이다.
    남은 회전 12회는 Spin 이 아니라 DWB 가 주행 중 내는 것이다. 사용자 관찰:
    "경로가 막히면 Spin 없이 멈춰 서 있는 것을 확인" — 예상한 대가이고, 이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
2026-08-13 tune(nav2): 2단계로 AMCL 회전 잡음 alpha1 을 0.4 로 올린다
    NAV2-B1 3단계다(회차 순서로는 2단계). alpha1 만 0.2 -> 0.4 로 올리고 나머지
    셋은 0.2 로 둔다. 이 로봇은 제자리 회전 직후에 오차가 컸고, 값을 올리면 회전
    시 입자 분산이 커져 스캔 매칭이 자세를 되돌릴 여지가 생긴다. 넷을 같은 값으로
    두면 "회전이 병진보다 못 미덥다"는 사실이 모델에 들어가지 않는다.
    근거는 devlog/2026-07-31.md:29-50 — t+86 의 AMCL 점프 -10.8도가 오히려 자세를
    더 틀리게 만들었다.
    max_beams 는 60 으로 둔다. 1단계 회차에서 load average 최대가 13.8 로 8코어를
    넘었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
2026-08-13 revert(nav2): alpha1 0.4 를 되돌린다 - 주행 품질이 나빠졌다
    2026-08-13 실기에서 실패했다. 사용자 판정: "주춤거림·머뭇거림이 눈에 띄게
    늘었다. 위치오차 민감도가 올라가서 그런 것 같다." 값을 0.2 로 되돌린다.
    bag 기록은 없다(회차 시작 신호를 놓쳤다). ~/.ros/log 로 확인했고 주행 길이가
    달라 발생률로 환산했다.
    alpha1 0.2 (611 s) alpha1 0.4 (209 s)
    No valid trajectories 28 0.046/s 60 0.287/s 6.3배
    lethal space 1 0.0016/s 16 0.077/s 47배
    plan 생성 실패 10 16 4.7배
    제어주기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
2026-08-13 tune(nav2): 3단계로 AMCL 라이다 표본을 180 빔으로 올린다
    max_beams 60 -> 180. AMCL 이 한 번 갱신할 때 쓰는 빔 수이고, 60 은 유효
    반사의 일부만 보는 것이라 좁은 곳에서 지형 특징을 놓친다.
    방향은 update_min 과 같은 쪽이다 — "더 잘 보게" 만든다. 실패한 alpha1 0.4 와는
    성격이 다르다. 그쪽은 입자를 퍼뜨려 "덜 확신하게" 만들었고 lethal space 가
    47배로 늘어 planner 가 멈춰 섰다.
    이번 회차의 관건은 CPU 다. 필터 갱신 비용이 빔 수에 비례하므로 amcl CPU 가
    3배 가까이 오를 수 있는데 여유가 넉넉한 편이 아니다:
    1단계 회차 실측 전체 346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
2026-08-13 test(nav2): max_beams 180 을 실주행으로 확인한다 - 오차가 줄고 CPU 는 안 올랐다
    회차 run3_beams180_0810 (509 s). AMCL probe 기록은 ~/vica_amcl_logs/beams180_0813_2028.
    갱신당 평균 보정량 0.021 -> 0.016 m 24 % 감소
    최대 보정량 0.275 -> 0.151 m 45 % 감소
    최악 무갱신(이동 중) 4.05 -> 2.10 s 8/11 기준 3 s 를 처음 통과
    무갱신 중앙값 0.45 -> 0.25 s
    amcl CPU 7.6 -> 6.7 % 오르지 않았다
    제어주기 놓침 32 -> 30 회
    odom 점프 0
    빔을 3배로 올렸는데 amcl CPU 가 오르지 않았다. 사용자 관찰도 "좌우 흔들림
    없음"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
2026-08-13 tune(nav2): 복구 대기를 재배분한다 - 2 s 씩 20회로 더 자주 다시 본다
    동적 장애물 절차서 2단계다. wait_duration 5 -> 2, number_of_retries 6 -> 20.
    두 값은 한 세트다 - 총 인내 = (retries / 2) x wait 이므로 하나만 바꾸면
    6 s(wait 만 2로) 또는 50 s(retries 만 20으로)라는 극단으로 간다.
    1단계 6회 x 5 s -> 15 s 버티고 재계획 6번
    2단계 20회 x 2 s -> 20 s 버티고 재계획 20번
    바뀌는 것은 총 시간보다 다시 보는 빈도다. 5초일 때는 사람이 비켜나도 남은
    시간을 다 채우고서야 상황을 본다.
    근거는 2026-08-13 run3 실측이다. 사람이 앞을 막으면 DWB 궤적 419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
2026-08-13 tune(nvblox): 3단계로 유령 소멸을 30.6 s 에서 9.6 s 로 줄인다
    static_mapper.tsdf_decay_factor 0.95 -> 0.85. 사용자 판정으로 10 초를 실기에서
    먼저 본다.
    근거는 run4_wait2x20_0810 의 129~157 s 구간 실측이다.
    130.7 s 라이다 전방 최소 0.81 -> 1.21 m 사람이 비켜났다
    132.0 s 전방 2.01 m 완전히 트였다
    157.0 s 전방 2.01 m, 명령 vx 0.000 26 초째 서 있다
    라이다는 즉시 지웠는데 지도가 사람을 붙잡고 있었다. 그동안 planner 는
    "no valid path found" 를 냈다. 2단계에서 BT 대기를 5 -> 2 s 로 줄여 열 배 자주
    다시 봐도 소용이 없었던 이유가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
2026-08-13 tune(nvblox): 유령 소멸을 20 s 로 정한다 - 10 s 는 낮은 장애물을 잃었다
    tsdf_decay_factor 0.85(9.6 s) -> 0.925(20.1 s).
    10 초를 실기에서 시험했고 실패했다. 사용자 판정: "낮은 의자다리 같은 부분을
    못 봐서 멈추고, 복구 시간도 크게 차이가 나지 않고 오히려 주행이 불안정하다."
    두 가지가 확인됐다.
    1. 소멸을 앞당겨도 복구가 빨라지지 않는다. 사람만 빨리 지워지는 것이 아니라
    지형 정보도 같이 사라지고, 낮은 장애물이 지도에서 빠지면 그 자리를 다시 볼
    때까지 planner 가 흔들려 복구를 새로 부른다. 벌어들인 시간을 도로 잃는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
2026-08-13 test(nav2): 복구 예산 A/B 를 준비하고 nvblox decay 축을 닫는다
    nvblox tsdf_decay_factor 를 0.95(소멸 30.6 s)로 되돌린다. 이 축은 양쪽으로
    시험했고 둘 다 실패했다. 사용자 판정으로 원래 값을 유지한다.
    0.85 ( 9.6 s) 낮은 의자다리를 못 봐서 멈춘다. 복구 시간도 차이가 없고
    오히려 주행이 불안정하다
    0.925(20.1 s) 같은 의자다리에서 같은 증상. 사람이 비켜난 뒤에도 대기를
    거의 다 채웠다
    실측도 단조롭지 않았다(No valid trajectories: 30.6 s 210회 / 9.6 s 61회 /
    20.1 s 382회). 회차마다 사람이 막은 시점과 위치가 달라 d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
2026-08-13 test(nav2): 복구 예산 A/B 판정 - 30회 x 1 s 를 채택한다
    같은 코스에서 두 회차를 재고 B 안을 고른다.
    A: 10회 x 2 s B: 30회 x 1 s
    No valid trajectories 160 7 23배 개선
    제어주기 놓침 18 5
    최장 정지 70.9 s 34.7 s
    load average 최대 18.50 9.99 8코어 아래로
    도착 후 대기 평균 7.16 s 5.20 s
    lethal space 1 53
    lethal space 가 늘어난 것은 분모가 달라서다. A 는 10번 시도하고 포기했고 B 는
    30번 시도했다. 결과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
2026-08-13 tune(nav2): 복구 재시도를 20회로 줄인다 - wait 1 s 는 고정
    30회 x 1 s(총 15 s) -> 20회 x 1 s(총 10 s). 재계획 빈도는 그대로 두고 총 인내만
    줄인다. 사용자 판정: 30회는 통과 불가능한 자리에서 15 s 를 다 쓰는데 그것이 길다.
    wait 1 s 는 고정이다. A/B 실측에서 갈린 것이 총 시간이 아니라 다시 보는
    빈도였다(A 10회 x 2 s: No valid 160 / B 30회 x 1 s: 7). Wait 가 도는 동안에는
    상황을 보지 않으므로 wait 값이 곧 재출발 지연이고, 1 s 가 이 구조의 최소값이다
    (Humble WaitAction 은 InputPort<int>).
    [미검증] 총 10 s 는 계약 하한 15 s 에 못 미쳐
    test_recovery_patien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
2026-08-15 revert(nav2): 복구 예산을 nav2 기본값 6 x 5 s 로 되돌린다
    사용자 판정이다. 하루 동안 네 조합을 실기로 쟀는데 어느 쪽도 만족스럽지 않아
    기준점으로 복귀한다.
    6회 x 5 s = 15 s, 재계획 6번 <- 지금 (nav2 기본값)
    20회 x 2 s = 20 s, 재계획 20번 Goal failed 0. 그러나 비켜난 뒤에도 대기를 다 채움
    10회 x 2 s = 10 s, 재계획 10번 No valid 160, 놓침 18, load 18.5
    30회 x 1 s = 15 s, 재계획 30번 No valid 7, 놓침 5, load 10.0
    20회 x 1 s = 10 s, 재계획 20번 Goal failed 재발(run7, 82.2 s 지점)
    run7 이 마지막 시도였고 예산을 줄이는 방향을 닫았다. 20 s 였던 run4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
2026-08-15 feat(nav2): dev(DWB) 에 collision_monitor 를 넣는다 - 갇히기 전에 멈춘다
    NAV2-B5. velocity_smoother 와 /cmd_vel_req 사이에 끼운다.
    controller --cmd_vel_nav--> velocity_smoother --cmd_vel_smoothed-->
    collision_monitor --/cmd_vel_req--> Safety --> motor
    종전의 SetRemap(cmd_vel_smoothed -> /cmd_vel_req)을 지운다. 남겨 두면
    velocity_smoother 가 monitor 를 건너뛰어 감시가 통째로 무의미해진다.
    /cmd_vel_req 가 Safety 의 유일한 입력이라는 계약은 그대로고 발행자만 바뀐다.
    근거는 2026-08-15 run9 실측이다. 사람이 정면 0.36 m 까지 붙자 DWB 궤적 419개가
    전멸했고 그 뒤 46초를 서 있었다. footprin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
2026-08-15 fix(nav2): collision_monitor 입력 토픽을 /cmd_vel 로 바로잡는다
    배선이 통째로 끊겨 있었다. 2026-08-15 실기에서 로봇이 한 발도 못 움직였다.
    /cmd_vel_nav 23.8 Hz controller 는 명령을 내고 있었다
    /cmd_vel_smoothed 발행 없음 monitor 가 여기를 보고 있었다
    /cmd_vel_req 발행 없음
    /cmd_vel_safe 발행 없음 모터까지 아무것도 못 갔다
    앱에는 "주행 중" 으로 보이는데 로봇은 정지해 있었다. collision_monitor 는
    active 였고 발동 로그도 없어서, 노드만 보면 정상으로 보인다.
    원인은 velocity_smoother 의 실제 발행 이름이다. 노드 기본 출력은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
2026-08-15 feat(mission): 주행 실패 시 같은 목적지로 자동 재시도한다
    2026-08-15 실기에서 정체의 절반이 "사람이 앱을 다시 누르기까지 걸린 시간"
    이었다. run9 #6 구간 46초의 내역:
    198.3~222.4 s (24 s) Nav2 가 복구를 시도하다 Goal failed
    222.4~242.6 s (20 s) 아무도 아무것도 안 함. 로봇은 실패 상태로 대기
    242.6 s 사람이 앱에서 목적지를 다시 보냄
    뒤의 20초는 Nav2 도 nvblox 도 아니다. 재시도가 없어서 생긴 공백이다. Nav2 는
    이미 포기하고 "다시 시도해 주세요" 안내까지 마친 상태였다.
    기본값은 3초 간격 2회다. 무한 재시도는 하지 않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
2026-08-15 tune(nav2): 복구 예산을 30회 x 1 s 로 바꾼다 - 두 계약을 동시에 만족한다
    총 인내 15 s · 재계획 30회 · 재출발 지연 1 s.
    오늘 여섯 조합을 실기로 재고 나온 값이다.
    6회 x 5 s = 15 s, 재계획 6번 Goal failed 발생 · 정체 34.0 s
    20회 x 2 s = 20 s, 재계획 20번 failed 0. 그러나 비켜난 뒤에도 대기를 다 채움
    10회 x 2 s = 10 s, 재계획 10번 No valid 160 · 놓침 18 · load 18.5
    30회 x 1 s = 15 s, 재계획 30번 No valid 7 · 놓침 5 · load 10.0 <- 지금
    20회 x 1 s = 10 s, 재계획 20번 Goal failed 재발
    40회 x 1 s = 20 s, 재계획 40번 총량이 길다는 사용자 우려로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
2026-08-15 fix(cartographer): 차체 프레임이 지도에 들어오지 않게 min_range 를 올린다
    TRAJECTORY_BUILDER_2D.min_range 0.15 -> 0.25.
    /scan 30장 정밀 측정에서 후방 좌우 대칭으로 근접 반사가 잡혔다.
    -147~-138도 0.221~0.239 m(검출률 89%), +138~+150도 0.220~0.273 m(98%).
    손잡이를 분리한 상태와 부착한 상태의 값이 거의 같아(차이 0~17 mm) 차체
    고정 구조물로 확정했다. 라이다가 로봇 중심보다 18.5 cm 앞이라 중앙의
    구조물이 뒤쪽으로 보인 것이다. base_footprint 로 옮기면 x +0.003 y ±0.136 이다.
    Nav2 는 영향이 없다. costmap 은 footprint_clearing_enabled 로 매 주기
    footprint 내부를 FRE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
2026-08-15 fix(cartographer): 삼켜지던 odom_topic 인자를 실제로 연결한다
    vica_slam_bringup.launch.py 가 자식 launch 에 '/odom' 을 하드코딩해서, 명령줄의
    odom_topic:=... 이 경고 한 줄 없이 무시되고 있었다. ROS 2 launch 는 선언 안 된
    인자를 오류로 잡지 않는다 - include_launch_description.py 의 raise 는 '필수 인자
    누락'에만 해당한다.
    실제 launch 파일로 재현해 확인했다.
    수정 전 odom_topic:=/wheel/odom -> cartographer_node 의 remap odom:=/odom
    수정 후 odom_topic:=/wheel/odom -> odom:=/wheel/odom
    인자 없음 -> odom:=/odo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
2026-08-15 chore: 라이선스 미선언 패키지 셋에 Apache-2.0 을 선언한다
    vica_nav2 · vica_nvblox_bringup · vica_sensor_adapters 의 package.xml 이
    "TODO: License declaration" 인 채였다. 나머지 패키지가 Apache-2.0 이므로
    같은 값으로 맞춘다(vica_description 만 MIT).
    공모전 제출물에 라이선스 미선언 패키지가 섞여 있으면 지적받을 수 있어 정리한다.
    근거와 전체 목록은 docs/model_licenses.md 4절.
    vica_sensor_adapters 는 description 도 "TODO: Package description" 이었다.
    실제 구성(imu_base_link_adapter · vslam_covariance_adapter)을 적는다.
    mdrobot_can_control 과 encoder_feedback 에도 같은 미선언이 남아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
2026-08-15 feat(nvblox): human 모드로 사람만 골라 빨리 잊게 한다 [시험]
    mapping_type: static_tsdf -> human_with_static_tsdf, use_segmentation: true.
    마스크 공급자는 PeopleSemSegNet shuffleseg(TensorRT fp16)다.
    dynamic 모드와 다르다. dynamic 은 nvblox 가 스스로 판정하다 사람이 배경에도
    섞여 3회 실패했고, human 은 밖에서 준 마스크로만 가른다. 코드가 둘을 섞지
    못하게 막는다(multi_mapper.cpp:244 의 CHECK).
    마스크는 네 토픽 시간 동기의 한 축이라 camera_info 짝이 반드시 필요하다.
    리사이즈된 960x544 쪽을 물린다 - 마스크가 그 크기다. 실측으로 확인했다.
    토픽 이름에 camera0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
2026-08-15 feat(nav2): 뒤가 막혀 갇혔을 때 앞으로 빠져나오게 한다
    복구 RoundRobin 에 DriveOnHeading(전진 0.15 m, 0.05 m/s)을 넣는다.
    왜 필요한가. 이 로봇은 뒤가 길어서, 서 있을 때 planner 가 요구하는 뒤 여유가
    footprint 뒤끝 0.545 + inscribed_radius 0.275 = 0.820 m 다. 그런데 안내
    로봇이라 이용자가 항상 0.4~0.7 m 뒤에 선다. 라이다가 그 사람을 찍으면 global
    costmap 에 253 이 생기고 footprint 가 그것을 밟아 planner 가 "Starting point
    in lethal space" 로 출발을 거부한다. 설계상 상시 발생하는 조건이다.
    run13(2026-08-15) 실측. 벽에서 1.78 m 떨어진 빈 공간인데도
    뒤 0.45 m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
2026-08-15 Revert "feat(nav2): 뒤가 막혀 갇혔을 때 앞으로 빠져나오게 한다"
    This reverts commit ff8a7a81bfa62275cc43c49f28e443e236673cd5.
2026-08-15 feat(mission): 질문 발화에 재청취 요청을 함께 발행한다 (/vica/listen_request)
    "안내를 취소할까요?"는 질문인데, 지금은 사용자가 답 한마디("아니요")를 하려면
    웨이크워드를 다시 불러야 한다. 음성 저장소의 재청취 신설(96581c6)에 맞춰,
    Mission Manager 도 질문을 말할 때 /vica/listen_request(true)를 발행한다.
    웨이크워드 노드가 질문 TTS 종료 직후 청취 창을 연다.
    - Say 에 expects_reply 필드(기본 False)를 더한다. 일반 안내 멘트에 재청취가
    걸리면 말 끝날 때마다 마이크가 열려 소음이 발화로 들어가므로, 질문에만
    명시적으로 표시한다 (현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
2026-08-16 perf(sensors): IMU 어댑터 출력 상한을 40 Hz 로 내린다
    publish_rate_hz 50.0 -> 40.0.
    2026-08-15 주행 실측에서 이 노드가 CPU 32.6 % 로 3위였다. 하는 일은 IMU
    메시지의 좌표계를 바꿔 다시 내보내는 것뿐이고, 비용의 대부분은 메시지당
    tf_buffer.lookup_transform 이다. 그런데 실제 출력이 41.3 Hz 여서 상한 50 은
    사실상 걸리지도 않고 있었다. 40 으로 내려야 상한이 실제로 작동한다.
    30 으로 더 내리지 않는다. EKF 주기(30 Hz)와 같아져 여유가 사라지고, 지터
    때문에 어떤 주기는 표본 0개 어떤 주기는 2개를 받게 된다. 40 은 1.33배다.
    곁가지로 자이로 편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
2026-08-16 fix(nvblox): 전경 감쇠를 5 Hz 로 맞춘다 - 카메라 15 Hz 와 한 세트다
    decay_dynamic_occupancy_rate_hz 10.0 -> 5.0.
    전경 지도는 관측으로 쌓이고 감쇠로 줄어든다. 그 균형이 깨지면 블록이 통째로
    해제되어(decay_integrator.deallocate_decayed_blocks: 1) dynamic_map_slice 가
    "빈 지도"가 아니라 0칸이 된다.
    카메라 30 Hz · 감쇠 10 Hz -> 3:1 쌓인다 (종전)
    카메라 15 Hz · 감쇠 10 Hz -> 1.5:1 못 버틴다 (실측 0칸)
    카메라 15 Hz · 감쇠 5 Hz -> 3:1 쌓인다 (지금)
    2026-08-15 CPU 경합(코어 평균 81 %, load 14)을 풀려고 run_d455.sh 를 30 -> 15 Hz
    로 내렸는데 감쇠를 그대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
    [vica_nvblox_overrides.yaml]
2026-08-16 fix(nvblox): human 모드에서 컬러를 리사이즈된 스트림으로 물린다
    원본 컬러(640x480)를 물리면 nvblox가 4초 만에 SIGABRT로 죽었다.
    image_masker.cu:258 Check failed:
    (input.rows() == mask.rows()) && (input.cols() == mask.cols())
    호출 경로 NvbloxNode::processColorImage()
    깊이 경로는 마스크 카메라 모델로 투영해 자르므로 크기가 달라도 되지만,
    컬러 경로는 픽셀 대 픽셀로 겹치는 방식이라 마스크(960x544)와 크기가
    같아야 한다. 세그멘테이션이 리사이즈한 컬러를 그대로 발행하므로 그것을
    쓴다. 타임스탬프도 같은 파이프라인에서 나와 4개 동기가 더 잘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
2026-08-16 fix(nvblox): 마스크 잡티 제거를 꺼 사람이 static으로 새는 것을 막는다
    run17에서 정체 두 건(23.0초·18.4초)을 slice bag과 대조했더니, 정체 내내
    마스크는 0 %(사람 없음)인데 static 가까운칸이 10196 -> 5335로 서서히
    줄었다. 사람이 이미 비킨 뒤 static에 남은 자국이 감쇠하기를 기다린 것이다.
    원인은 multi_mapper의 잡티 제거였다. 마스크에서 2000픽셀보다 작은 연결
    덩어리를 잡음으로 보고 지우는데, 지워진 픽셀은 배경이 되어 static TSDF로
    들어간다.
    run17 마스크 3625장, 사람이 잡힌 1077장을 덩어리 단위로 셌다.
    임계 살아남는 픽셀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
    [vica_nvblox_overrides.yaml]
2026-08-16 tune(nav2): 사람이 앞을 막는 것을 주행 실패로 보지 않게 한다
    controller_server.failure_tolerance 0.3 -> 10.0.
    사람이 앞을 막으면 DWB 가 궤적을 전부 버리는 것은 정상이다. 로봇이 사람
    쪽으로 갈 궤적을 고르면 안 되기 때문이다. 그런데 0.3 초는 그 정상 상태를
    곧바로 '주행 실패'로 바꾼다. 실패로 선언되면 경로를 통째로 버리고
    복구동작(지도 지우기 -> Wait 1 s -> 경로 재작성)으로 넘어가는데, 그 절차가
    돌던 중에는 사람이 비켜도 절차를 마쳐야 다시 간다. 사용자가 관찰한
    "무조건 30초 이상 서 있다"가 이것이다.
    run19 실측. 좁은 모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
2026-08-16 tune(nav2): 복구 재시도를 20회로 되돌린다 (사용자 지정)
    number_of_retries 30 -> 20. wait_duration 1 s 는 그대로다.
    같은 날 controller_server.failure_tolerance 를 0.3 -> 10.0 으로 올렸으므로
    두 값은 한 세트로 본다. 참는 구간(컨트롤러 10 s)이 앞에 오고 그 뒤에
    복구 구간(20회)이 온다.
    DriveOnHeading 은 이미 67f1a89 에서 되돌아가 있어 손대지 않았다.
2026-08-16 fix(nav2): global costmap 에 nvblox_layer 를 다시 넣는다
    plugins 에 "nvblox_layer" 추가(inflation_layer 앞). 2026-07-30 에 뺐던 것을
    되돌린다.
    7월에 적어 둔 기전이 그대로 재현됐다. run22 를 odom 이동거리 기준으로
    재니(1초에 3 cm 미만을 멈춤으로 판정) 주행 중 정체가 6건이었고, 가장 긴
    두 건이 이것이었다:
    +256~286 30.0초 앞 0.52~1.56 m 경로재작성 29회 Starting point in lethal
    +204~225 21.0초 앞 1.08~3.12 m 경로재작성 19회 (같은 문구)
    앞이 1.5~3.1 m 비어 있는데도 못 간다. global 이 장애물을 늦게 알아서
    planner 가 그 자리로 경로를 냈고, 도착하니 이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
2026-08-16 revert(nav2): global 의 nvblox_layer 를 다시 뺀다 - 실주행에서 크게 나빠졌다
    8753ad6 을 한 회차 만에 되돌린다. 이 축은 닫는다.
    run22(309초, 없음) run23(211초, 있음)
    planner 시작점 lethal 6회 -> 146회 24배
    planner 경로 실패 17회 -> 161회 9배
    복구 동작 2회 -> 37회 18배
    주행 시간이 2/3 인데도 이렇다. 시간으로 보정하면 35배다. 그리고 +93초부터
    기록 끝까지 118초를 한 번도 못 나아갔다(odom 이동거리 기준, 1초에 3 cm
    미만을 멈춤으로 판정). 회복하지 못했다.
    바닥 오인은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
2026-08-16 tune(nvblox): 전경 감쇠를 10 Hz 로 되돌린다 - 카메라를 30 Hz 로 올린 짝이다
    decay_dynamic_occupancy_rate_hz 5.0 -> 10.0.
    run_d455.sh 를 640x480x15 -> 640x480x30 으로 되돌리면서 함께 간다. 관측보다
    감쇠가 빠르면 전경 블록이 해제되어 dynamic_map_slice 가 0칸이 된다
    (decay_integrator.deallocate_decayed_blocks: 1). 카메라 30 Hz 에 감쇠 10 Hz 는
    3:1 로 2026-08-15 이전과 같은 비율이다.
    카메라를 올리는 근거는 사람 마스크 검출률 실측이다.
    1 m 100 % / 0.6 m 93 % / 코앞 0 %
    놓친 프레임의 사람은 배경 취급되어 static TSDF 로 들어가고, 로봇이 그 자리를
    지나가 버리면 카메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
2026-08-16 tune(nvblox): 카메라를 15 Hz 로 되돌리며 전경 감쇠도 5 Hz 로 되돌린다
    8af9b4f 를 되돌린다. decay_dynamic_occupancy_rate_hz 10.0 -> 5.0.
    run_d455.sh 도 640x480x30 -> 640x480x15 로 함께 되돌렸다(git 밖).
    30 Hz 시험에서 얻은 것:
    깊이 29.99 Hz · 마스크 29.99 Hz 로 어긋나지 않았다. 지난번 30 Hz 를
    깨뜨린 4중 동기 실패(깊이 11.6 / 마스크 5.2)는 재현되지 않았다.
    CPU 코어 평균 56 %(지난번 81 %), RAM 6.9/16.0 GB.
    IMU 40 Hz · align_depth off · 리사이즈 배선이 만든 여유다.
    되돌리는 이유는 nvblox 쪽 기준이 15 Hz 로 충분하기 때문이다.
    update_esdf_rate_hz 10.0 <-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
2026-08-16 tune(nvblox): 관측 무게 상한을 2.0 으로 낮춰 코앞 잔상만 골라 줄인다
    static_mapper.projective_integrator_max_weight 5.0 -> 2.0 (기본값에서 override).
    소멸 30.6 초 -> 23.4 초.
    관측무게 x tsdf_decay_factor^n <= esdf_integrator_min_weight
    5.0 x 0.95^n <= 0.1 -> 76 tick / 2.5 Hz = 30.6 초
    2.0 x 0.95^n <= 0.1 -> 58 tick = 23.4 초
    이 축을 여는 근거는 run24 실측이다. 컨트롤러가 보는 지도(local costmap)에서
    로봇 앞 부채꼴(0.3~1.5 m, 좌우 ±0.7 m)의 통과불가 칸을 셌다.
    +33.5 ~ +55.1 초 218 ~ 296칸, 그동안 라이다 최근접 2.8 m
    +55.7 초 0칸
    **22초 동안 앞이 막혀 있었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
2026-08-16 tune(nvblox): 관측 무게 상한을 1.0 으로 한 단계 더 내린다 - 대가가 안 나타났다
    static_mapper.projective_integrator_max_weight 2.0 -> 1.0. 23.4 초 -> 18.0 초.
    2.0 으로 두 회차(run25·run26)를 돌린 결과 우려한 대가가 나타나지 않았다.
    지워지는 속도 평빨라졌다 (사용자 관찰)
    낮은 장애물을 스칠 뻔한 일 0회 (사용자 확인)
    run25 에서 감쇠가 실제로 일하는 것도 확인했다. 앞쪽 부채꼴의 통과불가 칸이
    286 -> 87 -> 63 -> 0 으로 내려갔는데, 마지막 0 은 복구의 ClearEntireCostmap 이
    아니라 감쇠였다(지우기 요청 +170.1, 0 이 된 것 +176.3). 로봇이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
2026-08-16 revert(nvblox): 관측 무게 상한을 2.0 으로 확정 복귀 - 1.0 에서 접촉이 났다
    684ffc5 를 되돌린다. projective_integrator_max_weight 1.0 -> 2.0.
    1.0(18.0 초)에서 접촉이 두 번 났다.
    1회차 주행 중 부딪힘. 다만 그때 nvblox 가 두 개 떠 있어 판정 보류했다
    2회차 중복을 모두 정리한 깨끗한 조건에서 코너를 돌다 스쳤다
    두 번째는 변수가 하나뿐이라 1.0 이 원인으로 확정된다.
    5.0(기본) 30.6 초 원래 값
    2.0 23.4 초 run25·run26 두 회차, 스칠 뻔한 일 0회 <- 확정값
    1.0 18.0 초 접촉 2회 <- 실패
    0.5 12.6 초 2026-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
    [vica_nvblox_overrides.yaml]
2026-08-16 revert(nvblox): 관측 무게 상한을 기본값 5.0 으로 되돌린다 - 여유가 줄었다
    cb2c9a3 을 되돌린다. projective_integrator_max_weight override 를 주석 처리해
    nvblox 기본값 5.0(소멸 30.6 초)으로 돌아간다.
    2.0 은 세 회차(run25·run26·run27) 접촉 0회였지만 사용자 관찰이 "안정성이
    떨어지는 느낌, 장애물에 좀 더 붙는 느낌"이었다. 기전이 맞다 - 지도에서 빨리
    사라지면 costmap 이 더 비어 보이고 로봇이 더 붙어서 돈다. 값이 일을 하고
    있고 그 양이 과했다.
    되돌리는 이유 셋:
    1. 얻는 게 7.2초뿐이고 정작 고치려던 "코앞 사람"은 그대로다. 코앞은 마스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
    [vica_nvblox_overrides.yaml]
2026-08-18 feat(urdf): 카메라를 핸들 기둥 마스트로 옮긴다 (설계값 - 실측 대기)
    camera_x 0.28683 -> -0.225, camera_z 0.130 -> 0.885 (지면 1.075 m).
    2026-08-17 실주행에서 카메라를 높이니 주행이 좋아진 것을 확인하고
    하드웨어 설계를 바꾸는 중이다.
    STL 실측(base_link.stl)으로 자기 몸 가림을 계산했다:
    앞쪽 최고 구조물 0.385 m (x 0.1~0.3)
    카메라(-0.225, 1.075)에서의 내림각 52.5도, 시야 반각 32.3도
    -> 수평~아래 20도까지 자기 몸이 화면에 안 들어온다
    -> 아래 15도 권장 (바닥 사각 앞끝 1.17 -> 0.46 m). rpy 주석에 기록
    IMU 어댑터는 안 바꾼다 - TF 의 회전만 쓰고(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
    [VICA.xacro]
2026-08-18 perf(sensors): IMU 어댑터에 평균 내기와 TF 캐시를 넣는다
    카메라(와 그 안의 IMU)를 핸들 기둥 마스트(지면 1.075 m)로 올리는 준비다.
    평균 내기: 스로틀이 200 Hz 표본 5장 중 4장을 버리던 것을, 버리지 않고
    합산해 뒀다가 발행 주기(40 Hz)마다 평균 낸다. 5표본 평균이라 40 Hz 진동
    성분은 완전 상쇄, 백색잡음은 sqrt(5)=2.2배 감쇠한다. 수 Hz 의 느린
    흔들림은 평균으로 못 지운다 - 자이로에게 그건 진짜 회전이다. 그쪽은
    기구 강성이 담당한다. 비용은 콜백당 덧셈 6개로, 콜백 깨움·역직렬화는
    구독하는 이상 어차피 200 Hz 로 일어나므로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
2026-08-18 feat(urdf): 마스트·손잡이 바 미리보기 형상을 얹는다 (시각화 전용)
    연장 기둥(0.863->1.075)·손잡이 바(지면 약 1.05, 카메라 7.5cm 뒤)·마운트 팔.
    collision 에는 넣지 않는다 - footprint·계약 시험의 실측 기준(base_link.stl)을
    지킨다. 치수는 어림값이며 실물 CAD 가 나오면 메시로 교체한다.
    [VICA.xacro]
2026-08-18 fix(urdf): 마스트 미리보기를 실제 손잡이 형상 연장으로 바꾼다
    어림 프리미티브 3개(사용자 판정: 별로)를 지우고, base_link.stl 사본에서
    지면 0.5 m 위 정점만 +212 mm 올린 base_link_mast_preview.stl 로 교체한다.
    그 높이 위에는 기둥·손잡이뿐이라 손잡이 형태·방향은 그대로 두고 기둥
    길이만 늘어난다. 손잡이 꼭대기 0.863 -> 1.075 m (카메라 높이).
    visual 만 바꾼다. collision 은 base_link.stl 원본 그대로 - footprint·계약
    시험의 실측 기준이다.
    [VICA.xacro, base_link_mast_preview.stl]
2026-08-18 fix(urdf): 미리보기에서 아래 가로대를 지우고 기둥을 카메라에 붙인다
    사용자 확인 반영. base_link_mast_preview.stl 재생성:
    - 뒤끝 전폭 레일(높이 0.248~0.363)과 그 치마(차체 연결면 0.133~0.363)를
    삭제 - 손잡이 두 개로 보이던 것의 아래쪽
    - 손잡이 기둥을 +27 mm 전진해 앞면(-0.265)을 카메라 상자 뒤면(-0.238)에
    밀착
    - 기둥 밑동은 차체 안(지면 0.15)까지 내려 심어 뜨지 않게 함
    - 그립은 형태 그대로 지면 1.045~1.075 (카메라 높이)
    collision 은 여전히 base_link.stl 원본. TF(joint)는 손대지 않음.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
    [base_link_mast_preview.stl]
2026-08-18 chore(urdf): 마스트 메시를 정식 이름으로 승격한다
    base_link_mast_preview.stl -> base_link_mast.stl. 사용자가 이 형상을 새
    설계의 정식 모델로 확정했다. visual 참조·주석을 함께 갱신한다.
    collision 은 base_link.stl 원본 유지 - 실물 완성 후 재실측 전에는 바꾸지
    않는다.
    [VICA.xacro, base_link_mast.stl]
2026-08-18 fix(urdf): 마스트 메시를 삭제 없이 재생성한다 - 뒷몸통을 잘못 지웠었다
    이전 판(2c01187)은 "아래 손잡이"를 지운다며 뒤끝 곡면 껍데기(0.248~0.363)와
    치마를 삭제했는데, 그것은 가로대가 아니라 **로봇 뒷몸통 껍데기**였다.
    RViz 의 Collision Enabled 가 켜져 있는 동안 원본 collision 메시가 구멍을
    대신 메워 보여서 못 알아챘고, collision 을 끄자 몸통이 사라져 드러났다.
    사용자가 본 "아래 손잡이"의 정체는 collision 이 그리던 옛 그립(0.863)이었다.
    visual(새 마스트 1.075)과 collision(옛 형상)이 겹쳐 그려진 것이므로
    메시에서 지울 것이 애초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
    [base_link_mast.stl]
2026-08-18 chore(maps): 안 쓰는 옛 지도 부속 파일을 지운다
    location/vica_map_0529·0604 의 목적지 파일과 maps/map_keepout 세트.
    keepout 은 시험 장소가 계속 바뀌어 쓰지 않기로 했고(2026-08-16 사용자 판단),
    옛 지도 목적지도 더는 안 쓴다. 사용자가 직접 정리했다.
2026-08-20 feat(nav2): D455 깊이를 voxel_layer 관측 소스로 넣는다 [시험]
    local costmap voxel_layer 의 observation_sources 에 depth_cloud
    (/camera/camera/depth/color/points, PointCloud2) 를 추가한다. 카메라는
    run_d455_cloud.sh(pointcloud + decimation 4 -> 160x120 x 15 Hz)로 띄우고,
    이 시험에서는 세그멘테이션·nvblox 를 기동하지 않는다.
    목적: 사용자 기준(2026-08-19) "잔상을 남기지 않고 지형 정보를 빠르게
    갱신"의 판정. nvblox human 모드는 검출 실패분이 static TSDF 로 새어
    30.6초 감쇠를 기다려야 하는 구조인 반면, voxel_layer 는 광선 청소라
    잔상 개념이 구조적으로 없다. 사람은 비키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
2026-08-20 fix(nav2): voxel 격자를 1.2 m 로 올려 마스트 카메라의 광선 청소를 살린다
    z_voxels 16 -> 24 (0~0.8 -> 0~1.2 m). 카메라(지면 1.075)가 격자 밖이라
    'sensor origin out of map bounds... cannot raytrace' 와 함께 청소만 꺼지고
    마킹은 계속되어 전방이 까맣게 영구 축적 -> 무주행 (첫 기동에서 실측 재현).
    1.2 m 는 카메라에 12.5 cm 여유. 라이다(0.382)는 원래 격자 안이라 무관.
2026-08-20 fix(nav2): voxel 층 두께로 천장을 1.2 m 로 올린다 - 층수는 16 이 하드 상한
    z_voxels 24 는 무효였다. nav2_voxel_grid 가 열 하나를 uint32 에 2비트씩
    담는 구조라 'only sizes <= 16 are supported'(voxel_grid.hpp:72)이고,
    파라미터는 24 를 받되 격자는 조용히 16 으로 돌았다(voxel_grid 토픽
    size_z=16 실측). z_resolution 0.05 -> 0.075 로 바꿔 16 x 0.075 = 1.2 m.
    카메라(1.075)가 격자 안에 들어와 광선 청소가 산다.
2026-08-20 revert(nav2): voxel depth_cloud 시험을 원복한다 - dev(1927123) 상태로
    두 함정(NEON 파라미터 이름, z_voxels 16 하드 상한)을 고친 뒤에도 전방이
    까맣게 차며 무주행이 재현됐다(사용자 실측 2회). 관문 ①(바닥 오검출)을
    통과하지 못한 상태로 판단 - min_obstacle_height 0.10 으로 원거리 바닥
    잡음을 못 막았거나 청소가 여전히 죽어 있던 것으로 추정되나 규명 전에
    사용자 판단으로 중단. 조사 기록은 이 브랜치 커밋들에 남긴다.
    카메라 포인트클라우드는 런타임 파라미터로 껐고, 다음 기동부터는 기존
    run_d455.sh 를 쓴다.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
2026-08-20 fix(ekf): IMU 융합을 임시 비활성한다 - 마스트 진동이 yaw 를 흔든다
    imu0 블록을 주석 처리한다(삭제 아님 - 사용자 지시: 지우지 말 것).
    카메라에 내장된 IMU 가 마스트(지면 1.075 m)로 올라간 뒤 기둥 진동이
    자이로 vyaw 에 섞여 yaw 가 크게 틀어진다. 기구 고정 전까지 바퀴
    오도메트리(/wheel/odom: vx·vy·vyaw)만으로 /odom 을 발행한다.
    대가는 회전 정밀도(자이로 161->4.7 deg/h 보정을 잃음, 표류는 AMCL 이
    지도로 보정). 마스트 강성 확보 후 주석을 풀어 되돌린다.
2026-08-20 revert(ekf): IMU 융합을 되돌린다 (5f442c0 원복, 사용자 지시)
    바퀴 단독 시험을 마치고 원래 구성(wheel/odom + imu vyaw)으로 복귀한다.
2026-08-20 fix(ekf): IMU 융합 비활성을 재적용한다 (사용자 결정)
    되돌렸던 8803f33 을 다시 뒤집어 5f442c0 상태로 간다. 마스트 기구 고정
    전까지 바퀴 오도메트리만으로 /odom 을 발행한다. imu0 블록은 주석으로
    보존되어 있어 강성 확보 후 주석 해제로 복귀한다.
2026-08-20 feat(nav2): 회전 속도 상한을 0.4에서 0.5로 올린다
    사용자가 직접 변경·실주행 1회 수행. 회전은 그간 유일하게 안 건드린
    병목 축이었다(2026-08-12 동적 장애물 회차 기록). 코너·유턴에서 회전이
    느려 머뭇거리는 문제를 줄이려는 시도이며, 이번 회차는 EKF 바퀴 단독
    (IMU 비활성) 상태로 달렸으므로 회전 정밀도 판정은 다음 회차와 함께 본다.
2026-08-20 revert(nav2): 회전 속도 상한을 0.4로 되돌린다 (df60ce6 원복)
    0.5로 올려 실주행했으나 좋아진 점이 없어 사용자 결정으로 원복한다.
2026-08-20 revert(ekf): IMU 융합을 복원한다 (02c1fae 원복)
    바퀴 단독(엔코더만) 실주행에서 나아진 점이 없었고 지도 틀어짐이 보여
    사용자 결정으로 IMU vyaw 융합을 되살린다. 마스트 진동 문제는 기구
    고정으로 풀고 융합은 유지한다.
2026-08-21 fix(monitor,mission): 알람 폭주를 줄이고 일시정지 복구 불가를 고친다
    ## vica_system_monitor — 알람이 너무 많고 같은 알람이 반복되던 문제
    원인은 두 가지였고 서로 다르다.
    1. 래치된 결함(SAFETY_ESTOP_LATCHED, SAFETY_RESET_REQUIRED)이 재알림 간격을
    무시하고 매 tick(1 Hz) 이벤트를 냈다. 앱은 reminder 를 화면에 쌓지 않으므로
    목록이 넘치지는 않았으나 그 메시지가 전부 rosbridge 를 지난다. 시험 중에는
    ESTOP_RELEASED_WAIT_RESET 로 한참 있게 되므로 그동안 초당 한 건이 계속 나갔다.
    2. 화면에서 같은 항목이 반복되던 진짜 기전은 깜빡임이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
    [test_event_deduplicator.py]
2026-08-23 feat(interfaces): 사람 접근에 필요한 계약 두 개를 넣는다
    PersonDetection.msg 와 RequestApproach.srv 를 추가한다. 설계는
    devlog/2026-08-23-사람접근-구현설계.md 3절이다.
    탐지 결과는 요청이지 goal 이 아니다. RequestApproach 가 goal 권한의 경계이며
    좌표를 Nav2 로 보내는 것은 Mission Manager 뿐이다.
    두 가지를 관행에 맞췄다.
    - request_id 를 넣는다. MissionCommand·RequestDestination 과 같은 자리이며
    mission_manager_node 가 canonical UUID 인지 검증하고 어긋나면 거절한다.
    - 응답 필드를 message 로 한다. 기존 두 srv 와 이름을 통일한다.
    TRACK_ID_NONE 상수를 둔다. 추적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
2026-08-23 feat(mission): 사람 앞 1.1 m 지점을 goal 로 계산한다
    approach_goal(person, robot, safety_distance_m=1.1) 을 넣는다. 사람에게서
    로봇 쪽으로 안전거리만큼 물러난 점과 사람을 바라보는 yaw 를 돌려준다.
    rclpy 에 의존하지 않으며 Pose2D 는 mission_logic 것을 그대로 쓴다.
    1.1 m 의 근거를 상수로 박고 시험이 직접 검산한다.
    circumscribed 0.4962 + 사람 몸 반경 0.25 + goal 오차 = 하한 1.00 m
    1.1 m 는 여유 10.4 cm (접근 전용 tolerance 0.10 이면 25.4 cm)
    경계 조건 넷을 정한다.
    - 사람과 로봇이 같은 위치(1 mm 미만)면 None 을 돌려준다. 예외를 던지지 않는
    이유는 이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
2026-08-23 feat(perception): 접근 대상 판정 로직을 새 패키지로 넣는다
    vica_perception 패키지를 만들고 detection_gate.py 에 두 판정을 넣는다.
    rclpy 에 의존하지 않는 순수 로직이며 ROS 노드는 아직 없다.
    stable 신뢰도 0.6 이상이 1.0초 연속 오탐을 거른다
    approachable 3초간 이동 0.3 m 미만 + 1.5~4.0 m 지나가는 사람을 거른다
    판정을 둘로 나눈 근거는 로봇이 걷는 사람을 따라잡지 못한다는 것이다. 주행
    상한 0.5 m/s 로도 보행 1.2 m/s 의 2.4배 느리다. 3 m 접근에 6.3초 걸리는 동안
    걷는 사람은 7.6 m 를 가 포기 기준(2.0 m)을 4배 넘긴다. stable 만으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
2026-08-23 feat(mission): 접근 상태 세 개를 상태 기계에 넣는다
    APPROACHING·AWAITING_USER·RETURNING 을 추가한다. 기존 코드는 세 줄만 고쳤고
    나머지는 전부 추가다(+427/-3).
    IDLE -approachable-> APPROACHING -도착-> AWAITING_USER
    ^ | |
    | | 실패·이탈·포기 +- "네" -> IDLE
    +----- RETURNING <------+--------------------+- "아니오"·8초 -> RETURNING
    E-stop 과 긴급어의 goal 취소 조건을 NAVIGATING 에서 _GOAL_ACTIVE_STATES
    (NAVIGATING·APPROACHING·RETURNING)로 넓힌다. 접근·복귀 중에도 goal 이 살아
    있으므로 이것을 안 고치면 로봇이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
2026-08-24 fix(description): 카메라 높이를 줄자 실측 0.910 m 로 맞춘다
    2026-08-18 에 넣은 1075 mm 는 설계값이었고 한 번도 재본 적이 없었다. 이번
    재부착으로 실제 높이가 바뀌어, 바닥에서 카메라 몸체 중앙까지 910 mm 로
    실측했다. D455 는 렌즈가 몸체 중앙 높이에 일렬이라 몸체 중앙 = 렌즈 중심이다.
    camera_z 0.885 -> 0.720 (지면 0.910 - base_link 0.190. 16.5 cm 내려감)
    오차 방향이 비대칭이라 그냥 두면 안 된다. URDF 가 실물보다 높으면 nvblox 가
    바닥을 그만큼 띄워 투영해 slice 띠(0.05~0.9) 한가운데에 걸리고 주변이 통째로
    장애물이 된다. 반대로 낮으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
    [VICA.xacro]
2026-08-24 feat(cartographer): 앱이 매핑을 시작·저장하고 지도를 실시간으로 보게 한다
    지도를 그리는 동안 어디를 더 돌아야 하는지 보려면 지도가 자라는 것을 봐야 한다
    (vica_map 프로파일: "rviz 는 ... 여기서는 필수다"). 그런데 그 확인 수단이 젯슨
    화면의 RViz 뿐이고, RViz 하나가 코어 1.5개를 쓴다. CPU 가 모자라면 EKF 가 30 Hz
    에서 15.5 Hz 로 떨어지고, Cartographer 는 오도메트리 예측에 기대므로 **보려는
    행위가 지도를 직접 나쁘게 만든다**(devlog/2026-08-01).
    그래서 화면이 아니라 지도만 보낸다.
    ## map_preview_node — /map 을 PNG 로 떠서 앱에 준다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
2026-08-24 feat(perception): person_detector_node 골격을 넣는다 (Phase A5)
    - YOLO(.engine, track 모드) 로 시각장애인을 찾아 /vica/person_detection 발행.
    계약(PersonDetection.msg) 준수: frame map 변환은 노드가 끝내고, distance_m 은
    몸통 depth 중앙값(지팡이 픽셀 배제), 못 재면 NaN. stable/approachable 판정은
    detection_gate(A3) 에 위임한다.
    - 순수 기하(person_geometry)를 분리해 pytest 12건. 전체 72 passed.
    - 컨테이너에서 빌드·기동 확인. ros2 run 은 venv 를 못 태우므로
    'yolo_env 활성화 후 python3 -m vica_perception.person_detector_node' 로 띄운다.
    - [미검증] 사람이 화면에 있을 때의 실발행.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
2026-08-24 feat(mission): RequestApproach 서비스를 배선한다 (Phase B2)
    - /vica/mission/request_approach: UUID·track_id 일치·좌표 유효성 검증 후
    approach_goal(1.1 m) 계산, mission_logic.on_approach_request 로 판단 위임.
    - /vica/mission/cancel_approach: MissionCommand 재사용(srv 계약대로).
    - 로봇 map 위치는 /amcl_pose 구독으로 얻는다 - goal 후퇴 방향용이라
    AMCL 갱신 주기 신선도면 충분하다. tf2 리스너보다 싸다.
    - 스모크 실측: 검증 사슬 7단 전부 설계대로 응답
    (UUID/불일치/NONE/NaN/위치없음 -> 노드 거절, appr=F -> not_approachable,
    정상 -> nav_not_ready). pytest 317 passed.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
2026-08-24 feat(perception): approachable 탐지를 Mission Manager 에 요청한다 (Phase B3)
    - RequestApproach 클라이언트: canonical UUID, 비동기 호출(5 Hz 콜백을 서비스
    왕복에 볼모로 잡지 않는다), 미응답 중 재호출 건너뜀.
    - ApproachRequestThrottle(순수): track 당 초 1건으로 호출 상한. 거부된 호출은
    기록을 안 남긴다 - 창이 밀려 영원히 못 보내는 함정 방지. 시험 9건.
    - pytest 326 passed. 컨테이너 빌드 완료.
    Claude-Session: https://claude.ai/code/session_017szPSgWRk9pHGvApxpipi9
2026-08-24 feat(interfaces,mission): affirm/deny 의도 계약과 접근 응답 라우팅 (Phase B7 절반)
    - VicaIntent.intent 에 affirm/deny 값을 계약으로 추가(구조 변경 없음).
    어느 질문의 답인지는 담지 않는다 - 상태를 가진 Mission 이 판정한다.
    reply 는 빈 문자열이어야 한다(수락/거절 발화는 Mission 몫, 이중발화 방지).
    취소 확인 긍/부정은 기존 경로(cancel 재발화) 유지 - 경로를 섞지 않는다.
    - mission_manager_node: affirm/deny -> on_approach_answer 라우팅.
    AWAITING_USER 가 아니면 로그만 남기고 무시(로직이 빈 목록 반환).
    - producer/consumer 전수조사: 생산 vica-voice-llm, 소비 여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
2026-08-24 fix(cartographer): 매핑 launch 에서 safety 를 빼고 motor 를 끌 수 있게 한다
    터미네이터 vica_map 레이아웃의 safety 칸이 `mode=AUTO` 다. 창을 띄우는 순간
    자동으로 실행되므로, 매핑 launch 가 또 띄우면 **항상** 두 벌이 된다.
    motor 칸은 `mode=HOLD`(사람이 엔터를 눌러야 실행)라 사정이 다르다. 사람이 먼저
    눌렀을 수도 있고 안 눌렀을 수도 있어서, 끄고 켤 수 있어야 한다.
    - safety include 제거. safety 가 motor 보다 먼저여야 한다는 순서
    (docs/vica_robot_bringup_manual.md 4절)는 그대로 유효하고, 그 순서를 지키는
    주체가 이 파일이 아니라 터미네이터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
2026-08-24 feat(mission): 수락하면 180도 돌아 핸들을 사람 쪽으로 낸다 (TURNING)
    - affirm -> Say(수락) + SpinInPlace(pi) -> State.TURNING -> spin 종료/실패/
    15초 시계로 IDLE. 회전 실패는 안내 실패가 아니라 조용히 끝낸다.
    - 재접근 억제는 회전 전에 건다. 회전 중 재요청은 busy 거절(시험 반영).
    - E-stop 은 _GOAL_ACTIVE_STATES 에 TURNING 이 들어가 spin 도 취소된다.
    - 노드: BasicNavigator.spin() 실행, 상태 감시는 기존 _poll_nav_status 재사용.
    파라미터 approach_turn_yaw_deg=180 (0 = 끔).
    - 정지 거리 1.1 m 가 애초에 이 회전 반경 기준 설계다(설계 6.3절).
    - detector: TF 조회를 이미지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
2026-08-24 fix(mission,perception): 실기에서 잡힌 결함 2건을 고친다
    - mission: /amcl_pose 구독을 transient_local 로. AMCL 은 보관(latched) 발행이라
    volatile 구독은 노드가 나중에 켜지면 보관본을 못 받아, 로봇이 움직이기
    전까지 접근 요청이 전부 '위치 없음'으로 거절됐다(실측).
    - perception: 접근 요청 미응답 플래그가 서비스 사망 시 영구 고착되던 것을
    2초 시계로 풀어준다. Mission 재시작 사이에 보낸 call_async 가 영영 안 끝나
    이후 요청이 전부 조용히 건너뛰어졌다(실측).
    Claude-Session: https://claude.ai/code/ses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
2026-08-24 tune(cartographer): 라이다가 보는 만큼 쓰게 하고 원본 상태를 함께 남긴다
    ## CM-1 — max_range 8.0 -> 11.0
    라이다는 12 m 를 보는데 8 m 에서 자르고 있었다. RPLIDAR 드라이버 신고값이
    0.15~12.00 m 이고 실내 실측 최대 반사가 9.04 m 였다.
    복도에서 앞뒤 위치를 알려 주는 것은 **멀리 있는 것들**이다 — 복도 끝, 문, 교차로.
    8 m 에서 자르면 그걸 버리고 양옆 벽만 남는데, 양옆 벽은 앞뒤에 대해 아무 말도
    하지 않는다. 2026-08-12 에 44 m 복도에서 최대 7.01 m 가 어긋난 것이 그 앞뒤
    미끄러짐이다(회전은 0.031 로 멀쩡했다).
    12.0 이 아니라 11.0 인 이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
2026-08-24 feat(interfaces): 지도 삭제 서비스 정의를 추가한다
    srv/DeleteMap.srv. 처리는 VICA_Supervisor 의 map_list_node 가 한다 — 그 노드가
    maps_root 를 이미 소유하고 목록을 발행하기 때문이다.
    안전장치를 srv 주석에 함께 적었다. 이름 규칙(^[A-Za-z0-9_-]+$)으로 경로 문자를
    막고, maps/CURRENT_MAP 이 가리키는 지도는 거부하며, 목적지 카탈로그는
    delete_destinations 가 true 일 때만 함께 지운다.
2026-08-24 tune(cartographer): 라이다 사거리를 8 m 에서 11 m 로 올린다 (NAV2 CM-1)
    TRAJECTORY_BUILDER_2D.max_range 8.0 -> 11.0
    TRAJECTORY_BUILDER_2D.missing_data_ray_length 8.5 -> 11.5
    ## 왜
    8 m 에서 자르면 그걸 버리고 양옆 벽만 남는데, **양옆 벽은 앞뒤에 대해 아무 말도
    하지 않는다.** 2026-08-12 에 44 m 복도를 그렸을 때 최대 7.01 m 가 어긋난 것이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
2026-08-24 chore(gitignore): pbstream 예외를 뺀다
    .pbstream 을 만들지 않기로 했다(사용자 판정 2026-08-21). 만들지 않는 파일을 제외
    목록에 들고 있을 이유가 없다. pure localization 작업이 확정되면 그때 다시 넣는다.
    map_list_node 의 삭제 대상 확장자에는 .pbstream 을 남겨 둔다. 수동으로 만든 것이
    있을 수 있고, 없으면 지우는 시도가 그냥 무시되기 때문이다.
2026-08-25 fix(mission): SpinInPlace import 누락으로 첫 승인에서 노드가 죽던 것을 고친다
    증상: 접근 요청이 승인되는 순간 _run_actions 의 isinstance(action, SpinInPlace)
    에서 NameError -> executor 전파 -> 프로세스 exit 1. 함수 안에서만 쓰는 이름이라
    구문검사·모듈 import·pytest 를 모두 통과하고 실기에서만 터졌다 (2026-08-25
    14:18 실측, 8/24 저녁 침묵의 진범이기도 하다).
    원인: TURNING 배선 때 import 치환 대상 문자열이 직전 편집(Pose2D 추가)으로
    달라져 있었는데 그 치환에만 assert 를 안 걸어 조용히 누락됐다.
    교훈: 자동 치환은 전 건 assert, 검증은 심볼 존재(m.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
2026-08-25 feat(nav2): 앱에서 초기 위치를 잡고 확정 전에 채점한다
    Nav2 를 켜면 AMCL 은 자기가 어디 있는지 모른다. 지금까지는 젯슨 화면의 RViz 에서
    2D Pose Estimate 로 찍어 줬다. 관리자 앱만 들고 현장에 나가면 그 일을 할 방법이
    없어서 앱에서 하게 만든다.
    확인과 확정을 나눈다. /initialpose 는 발행하는 순간 되돌릴 수 없고, AMCL 은
    recovery_alpha_fast/slow 가 0.0 이라 스스로 전역 재초기화를 하지 않는다. 잘못
    찍으면 사람이 다시 잡아 주기 전까지 계속 틀린 채로 간다.
    /vica/pose_check 점수만 계산한다. AMCL 을 건드리지 않는다
    /vica/pose_commit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
2026-08-25 fix(description): 카메라 높이를 재고정 실측 1.05 m 로 맞춘다
    재부착으로 0.910 -> 1.050 m (사용자 고정). depth 바닥 실측으로 검증:
    광선각 20.6/26.6/29.4도에서 높이차 1.05/1.03/1.04 m 일정 = 높이·수평 일치.
    camera_z 0.720 -> 0.860. 재학습 데이터셋(robot_view_dataset)도 이 높이에서
    촬영됨(CAPTURE_INFO.md).
    Claude-Session: https://claude.ai/code/session_01SBWJs3nzeAJhrX24pyNb8i
    [VICA.xacro]
2026-08-25 tune(nav2): 도착 방향 허용범위를 0.25 -> 0.15 rad 로 좁힌다
    도착한 뒤 로봇이 바라보는 방향을 더 정확히 맞추려는 것이다. 0.25 rad 는 14.3도라
    안내 로봇이 "저쪽입니다" 하고 선 방향이 눈에 띄게 어긋난다. 0.15 rad 는 8.6도다.
    xy_goal_tolerance 는 건드리지 않는다. 한 번에 한 축만 움직인다.
    docs/nav2_backlog.md §9 확인함 -- goal tolerance 는 닫힌 축이 아니다.
    파일 전체에 이 값은 general_goal_checker 한 곳뿐이고 FollowPath 에는 없다.
    대가는 도착까지 걸리는 시간이다. stateful 이 False 라 매 주기 yaw 를 다시 보고,
    StoppedGoalChecker 라 rot_stopped_velocity 0.05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
2026-08-25 fix(nav2): 초기 위치 확정의 유령 재검 두 결함을 고친다
    2026-08-25 실기에서 나왔다. Nav2 를 내린 채 확정했더니 (1) 받는 쪽이 없는데
    '반영했습니다'라고 답했고 (2) 재검을 죽은 회차가 마지막으로 믿던 자세와 비교해
    '요청한 자리에서 308 cm 차이'라는 유령 오보를 냈다. 지도·스캔이 캐시로 살아
    있어 기존 입력 검사로는 못 잡는 구멍이었다.
    - /initialpose 구독자가 0 이면 확정을 거부하고 Nav2 를 켜라고 안내한다
    - 확정 직전에 AMCL 자세 캐시를 비워, 재검은 확정 이후 새로 온 자세로만 한다
    (안 오면 기존의 '검증은 못 했습니다'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
2026-08-25 fix(nav2): 힌트 창이 못 보는 180도 뒤집힘을 격차에 드러낸다
    2026-08-25 실기 ①에서 대칭 복도의 반대 방향 힌트가 77점·격차 41로 조용히
    통과했다. 힌트 창(±45도)은 진짜 방향을 아예 못 보므로 창 안 2등만으로는
    뒤집힘을 잡을 수 없다.
    - 찾은 자세의 180도 반대쌍을 직접 채점해 **보고용** 격차에 넣는다. 앱은
    '헷갈릴 방향 있음(차이 N점)' 을 보여주고, 노드는 경고 문구를 붙인다
    - 확정 가능(ok) 판정은 창 안 격차 그대로다 — 대칭 복도에서 방향을 가르는
    것은 사람뿐이라는 설계 계약(test_direction_hint_resolves_the_flip)을 지킨다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
2026-08-25 fix(cartographer): motor 소유권을 터미네이터로 고정한다
    2026-08-25 매핑 실기 결정. E-stop 해제가 motor 생존을 요구하므로 매핑을
    시작하려면 어차피 motor 가 먼저 떠 있어야 하고, 매핑 중 motor 가 죽었을
    때(CAN 순단 등)의 복구 경로도 터미네이터뿐이다. 감독이 반쪽만 소유하면
    시작과 복구의 규칙이 갈라진다 — 실기에서 관리자가 그 틈에 빠졌다.
    - motor 를 필수 노드에 넣는다: 없으면 앱 준비 카드에 '먼저 띄워야 할 것:
    motor' 가 뜨고 시작이 잠긴다
    - 매핑 launch 에 start_motor:=false 를 고정해 감독은 motor 를 절대 띄우지
    않는다. 중복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
2026-08-26 fix(mission): 거리 안내를 3m 한 번으로 줄이고 짧은 출발은 침묵한다
    10m 지점을 없앤다 — 목적지 간 거리가 3~7m 인 지도에서 출발하자마자
    '10미터 남았습니다' 오보가 반복됐다(2026-08-20 실기, 사용자 결정).
    첫 양수 잔여거리를 출발 거리로 삼아, 출발이 지점 이하면 그 지점은
    안내 없이 접는다. 시험 145 통과.
2026-08-26 feat(interfaces): 지도별 홈 위치 서비스 계약을 추가한다
    홈은 목적지가 아니라 로봇의 설정값이다. 사용자가 고르는 장소가 아니라 안내가
    끝난 뒤 스스로 돌아가는 자리라, destinations.yaml 에 넣지 않고 같은 폴더의
    home.yaml 하나로 관리한다. 파일이 하나라서 "지도당 1개"가 저절로 지켜진다.
    목적지에 is_home 플래그를 두지 않은 이유는 그렇게 하면 "홈이면 사용자 요청을
    거른다"를 모든 진입점(음성·앱·재시도·일시정지 복귀)마다 넣어야 하고, 한 곳만
    빠뜨려도 사용자가 로봇을 홈으로 보낼 수 있게 되기 때문이다. 그 실수는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
2026-08-26 feat(mission): 홈 위치를 파일로 저장하는 순수 로직을 만든다
    rclpy 에 기대지 않아 로봇 없이 개발 PC 에서 시험할 수 있다. pose_score.py ·
    mapping_session.py 와 같은 이유다.
    새로 만든 홈은 visited_ok 가 항상 False 다. 좌표를 정한 것과 그 자리에 실제로
    갈 수 있는 것은 다른 사실이고, 후자는 한 번 가 봐야만 안다. 로봇을 세워놓고
    잡은 경우에도 마찬가지다 - 그 자리에 서 있다는 것이 "Nav2 가 거기까지 경로를
    그릴 수 있다"를 뜻하지는 않는다.
    invalidate_if_map_is_newer 는 같은 map_id 로 지도 파일만 바뀐 경우를 잡는다.
    새 이름으로 저장하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
2026-08-26 feat(mission): 홈으로 돌아가는 길을 잇고 관리자 복귀 서비스를 연다
    복귀 기계는 이미 있었고 갈 곳만 없었다. 사람 접근 기능을 만들 때 "거절당하면
    대기 위치로 돌아간다"를 함께 만들어 뒀는데, return_destination 에 좌표를 넣어
    주는 코드가 없어 항상 None 이었다(mission_logic.py:543). home.yaml 을 읽어 그
    자리에 넣는다. 복귀 주행 코드는 새로 쓰지 않았다.
    /vica/mission/return_home 은 관리자 전용이다. 권한을 검사해서 막는 것이 아니라
    사용자 쪽에 문이 없게 만들었다 - 홈은 목적지 카탈로그에 없어 UUID 가 없고,
    음성은 목적지를 UUID 로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
2026-08-26 feat(mission): 거리 안내를 전면 제거한다 (2026-08-26 사용자 결정)
    실사용에서 거리 멘트가 회전·도착 멘트와 겹쳐 큐를 밀리게 했고 정보
    가치보다 소음이 컸다. 이정표를 빈 튜플로 두고 판정 배선은 남긴다.
2026-08-27 fix(mission): 접근 뒤 자동 홈 복귀를 기본으로 끄고 파라미터로 연다
    어제 홈 좌표를 return_destination 에 넣으면서, 사람에게 다가갔다 거절당했을 때
    로봇이 홈까지 스스로 달리게 됐다. 그 동작은 아직 실기로 한 번도 확인되지
    않았다. 확인 전에 자동 주행부터 켜면 아무도 안 보는 사이에 로봇이 처음 달려
    보게 된다.
    auto_return_home 파라미터를 두고 기본값을 false 로 한다. 꺼져 있으면 접근을
    마친 자리에 그대로 서며, 홈 좌표를 넣기 전의 원래 동작과 같다.
    관리자가 앱에서 부르는 복귀(/vica/mission/return_home)는 이 값과 무관하게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
2026-08-28 fix(mission): 접근 질문의 응답 8초를 재생 종료부터 세도록 배선한다
    on_approach_question_spoken(설계 6.2절)은 있었지만 부르는 곳이 없어
    시계가 질문 생성 시각부터 돌았다. STT 자동 답변 창(재생 종료 후
    4초 녹음 + whisper 2초)과 합치면 8초와 경주가 된다. /vica/tts_done
    에서 접근 질문 문장을 확인해 로직에 알린다.
    Claude-Session: https://claude.ai/code/session_01ERdX5FrQ3GuAbHEJ8PaXs4
2026-08-28 feat(nav2): local costmap 에서 nvblox 층을 빼고 라이다 단독으로 간다 (사용자 판정)
    nvblox 는 잔상 문제로 노드를 안 띄운 지 오래라 층만 남은 구성은 굶은
    눈이었다. 구성을 현실과 일치시킨다. 블록은 남겨 한 줄로 복귀 가능하다.
    대가는 라이다 평면(0.382 m) 밖 장애물을 어떤 층도 못 보는 것 — 시험
    구역에서 그 높이 물체를 치우고 운용한다. install 에만 있던 yaw 0.15
    블록도 src 로 동기화해 빌드가 8/25 튜닝을 되돌리지 않게 했다.
    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
2026-08-28 fix(nav2): local costmap 을 obstacle_layer 로 교체한다 - voxel 2D 출력 고장
    voxel_layer 는 스캔을 받아 내부 3D 격자에 장애물 기둥을 실시간으로
    찍으면서(실측 226~264개 변동) 2D costmap 출력은 14,400칸 전부 0 이었다.
    장애물 회피·감속이 전혀 없던 당일 충돌들의 원인이다. 2D 라이다
    단독에는 global costmap 이 쓰는 표준 obstacle_layer 로 간다.
    voxel_layer 블록은 카메라 3D 복귀 대비로 남긴다.
    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
2026-08-28 fix(nav2): yaw_goal_tolerance 를 0.25 로 유지한다 (사용자 결정)
    0.15 는 8/25 에 install 에만 적용된 미검증 값이었다. 검증 전이므로
    0.25 를 유지하고, 낮추는 실험은 주석의 절차대로 별도 회차에서 한다.
    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
2026-08-28 revert(nav2): obstacle_layer 교체를 되돌린다 - voxel 유지 (사용자 판정)
    1ee3dd9 원복. 사용자 실기 이력: 과거 obstacle_layer 구성에서 장애물
    회피가 안 됐고 voxel_layer 로 바꾼 뒤 우회에 성공했다. 그 이력을
    근거로 voxel 을 유지한다. 오늘 실측(내부 3D 는 찍히는데 2D 출력 0)은
    사실로 남는다 - 다음 기동에서 costmap 출력부터 재검증할 것.
    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
2026-08-28 feat(safety): 통신 원인 E-stop에 부팅 유예와 정지 중 자동 복구를 넣는다
    젯슨 로그 8월 전체(1215개 파일) 집계가 근거다. E-stop 원인의 70 %가
    motor_can_stale 이고, 전이 직전 상태로 나누면 이렇다.
    IDLE -> FAULT 229회 부팅 직후
    CLEARED -> * 154회 대기 중
    READY_TO_GO -> * 142회 reset 후 출발 대기 중
    RUNNING -> ESTOP_ACTIVE 12회 주행 중
    RUNNING -> FAULT 2회 주행 중 통신 지연
    앞의 세 줄(525회)이 이 커밋의 대상이고 마지막 두 줄은 손대지 않는다.
    타임아웃은 타이트하지 않았다. /motor/can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
    [app_emergency_node.py, auto_recovery.py, diagnostics.py, emergency_latch.py, emergency_stop_node.py, test_app_emergency_contract.py, test_auto_recovery.py, test_emergency_latch.py]
2026-08-28 docs(safety): E-stop 원인 분류표와 부팅 유예·자동 복구를 문서에 반영한다
    원인 6종의 감지 대상을 표로 고정한다. 특히 motor_can 이 CAN 소켓 오류만 잡고
    드라이버 무응답은 physical_stale 로 나타난다는 점을 적는다 - 이 구분을 모르면
    physical_stale 을 보고 물리 버튼을 찾게 된다.
    Claude-Session: https://claude.ai/code/session_01LVGWKdj4m7BPkXtSMMQPNh
2026-08-28 fix(mission): "다시 말씀해 주세요" 뒤에 재청취 창을 연다
    MSG_STALE_CONFIRM 은 다시 말해 달라는 질문인데 expects_reply 표시가
    빠져, 말해 놓고 안 들어서 사용자가 "비카야"를 다시 불러야 했다
    (2026-08-28 조사). 같은 파일의 취소 되묻기(MSG_CANCEL_CONFIRM)와 같은
    방식으로 표시만 추가 — 절차·상태 전이는 그대로다.
    Claude-Session: https://claude.ai/code/session_01AuwT8hoDQ2CSqrRrzjaPPK
2026-08-29 fix(description,nav2): 카메라 높이와 차체 세로 실측을 반영한다
    2026-08-29 줄자 실측(사용자 확정)으로 두 값이 바뀌었다.
    - camera_z 0.860 -> 0.835. 지면 1.05 -> 1.025 m 다. nvblox 가 깊이를 투영하는
    높이라 실물과 어긋나면 바닥이 뜨거나(주변이 통째로 장애물) 꺼진다(조용히
    안 보임). 2026-08-17 에 실제로 겪은 실패라 1 cm 도 넘기지 않는다.
    - footprint 후방 -0.495 -> -0.415. 손잡이 돌출이 19 -> 11 cm 로 줄어 총 세로가
    80 -> 72 cm 가 됐다. 앞(+0.305)과 반폭(±0.225)은 그대로다. local·global
    두 costmap 에 같은 값을 넣는다.
    내접반경은 0.275 m 로 바뀌지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
    [VICA.xacro]
2026-08-29 tune(nav2): 유턴 폭을 줄이려고 rotation_penalty 를 5.0 -> 2.0 으로 내린다
    목표는 사용자 요구다 — 폭 3 m 복도에서 1.5 m 안에 유턴한다.
    padded footprint 스윕으로 재보면 호로만 돌 때와 제자리 회전이 이만큼 다르다.
    제자리 회전 0.945 m
    R 0.35 1.438 m
    R 0.50 1.705 m <- 지금 격자. 3 m 복도의 절반을 넘게 쓴다
    활성 planner 는 Lattice(GridBased)이고 격자는 diff · turning_radius 0.5 다.
    그 격자에 제자리 회전 primitive 가 112개 중 32개 들어 있는데 rotation_penalty
    5.0 이 그것을 5배 비싸게 만들어 planner 가 고르지 않고 있었다. 격자를 갈거나
    Hybri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
2026-08-29 tune(nav2): rotation_penalty 축을 닫고 5.0 으로 되돌린다
    5.0 -> 2.0 -> 1.0(하한) 세 값 모두 주행 거동이 달라지지 않았다.
    이유는 회전을 정하는 것이 planner 가 아니기 때문이다. DWB 는 경로를 '따라야 할
    선'이 아니라 점수 기준의 하나로 쓴다. 궤적을 수십 개 시뮬레이션해 점수 합이 가장
    높은 것을 고르므로, planner 가 어떤 경로를 내든 DWB 가 자기 점수표로 다시 고른다.
    bag run1047(498.8 s): 주행 중 제자리 회전 4건, 전부 0.5~1.2 s(최대 27도).
    유턴 180도 는 max_vel_theta 0.4 로도 7.85 s 가 필요한데 그런 회전은 0건이다.
    1.3 m 공간 유턴 실패. r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
2026-08-29 feat(mission): 접근 멘트를 녹음 정본으로 바꾸고 회전 완료 훅을 단다
    approach-voice-flow.md 확정 흐름의 남은 두 조각 (2026-08-25 설계):
    - 멘트 교체: 임시 문구를 사전 녹음 정본(voice ment_cache)과 글자까지
    일치시킨다 - 일치해야 합성 없이 녹음이 재생된다. 수락 멘트는 회전
    예고다(예고 없는 움직임 금지). tts_done 8초 기점 비교는 상수를
    따라가므로 함께 움직인다.
    - 회전 완료 훅: TURNING 성공 시 "회전이 완료되었습니다" + 온보딩을
    말한다. 온보딩 끝은 질문이라 expects_reply 로 재청취 창이 열리고,
    회전으로 사용자가 핸들 방향에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
2026-08-29 tune(nav2): NAV2-B7 세 단계를 실주행으로 판정한다 — 셋 다 유턴을 못 고쳤다
    유턴 시 호를 그리다 lethal 에 걸리는 문제(NAV2-B7)에 DWB 튜닝 3단계를 시도했다.
    사용자 선택으로 안전한 것부터 3 -> 2 -> 1 순으로 실행했다.
    ## 3단계 max_vel_theta 0.4 -> 0.5 (유지)
    상한이 실제 병목임을 먼저 확인했다 — run1241 에서 이동 시간의 17.4 % 를 상한에
    눌려 보냈고 p90 이 정확히 0.400 이었다.
    결과(run1326): 상한에 눌린 시간 17.4 -> 13.1 %, 손 횡속도 0.066 유지,
    제어주기 150 ms 초과 0.1 %, Goal 실패 0
    유턴: **무효**. 각속도 상한은 '얼마나 빨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
2026-08-29 tune(mission): 온보딩 문구를 음성 정본(B안)과 함께 움직인다
    "새로 말을 걸 때는 '비카야'라고 불러주세요" — 호출어의 사용 시점을
    알려주는 판 (2026-08-29 사용자 결정, voice replies.py 와 글자 일치).
    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
2026-08-29 feat(mission): E-stop 전이를 음성으로 안내한다 (관리자 호출·reset 대기·자동 복구)
    시각장애인에게 E-stop 이후는 "말없이 안 움직이는 시간"이었다 — 걸리는
    순간만 말하고, 관리자만 풀 수 있는 reset 대기 구간은 침묵했다
    (2026-08-29 사용자 확정 문구 3종):
    - 걸림(사람 개입·주행 중 끊김): "안전을 위해 멈추겠습니다. 관리자를
    호출했습니다."
    - 걸림(통신 원인·정지 중): "연결 문제로 잠시 섰습니다. 곧 자동으로
    복구됩니다." — 1.4초 자동 복구 상황에 관리자 호출은 거짓이라 갈랐다.
    - 원인 전부 해제·래치만 남음: "안전 확인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
2026-08-29 feat(nav2): R 0.30 diff 격자를 만들어 Lattice 에 넣는다 — 작은 호와 제자리 회전을 함께
    화장실 구간(vica_map_0630, 목표 3.5/5.4) 유턴이 항상 실패했다. 원인은 공간이
    아니라 경로 모양이었다.
    지도 실측: 그 지점 여유 0.70 m+ => 통로 폭 1.40 m
    반경 1 m 안 free 셀의 92 % 가 제자리 회전 가능
    제자리 회전 0.945 m 면 되는데 planner 가 1.705 m 짜리 호를 그려 벽으로 들어갔다.
    Nav2 가 제공하는 격자는 0.5 / 1.0 뿐이고 1.0 은 §11 에서 닫혔다. Hybrid 로 바꾸면
    반경을 파라미터로 줄일 수 있으나 제자리 회전 primitive 가 없어 좁은 곳에서 60초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
2026-08-29 feat(nav2): R 0.25 · R 0.10 격자를 저장소에 넣는다 — 실주행으로 R 0.10 을 택했다
    2026-08-29 유턴 작업의 후속이다. R 0.30(0d37de8)만으로는 좁은 구간을 못 돌아
    반경을 더 줄인 격자 두 벌을 만들어 실주행으로 비교했다. 생성기와 절차는
    config/lattice/README.md 에 적힌 그대로다(nav2_smac_planner lattice_primitives).
    R 0.30 조각 88 (제자리 32 + 직진 16 + 곡선 40)
    R 0.25 조각 104 (제자리 32 + 직진 16 + 곡선 56)
    R 0.10 조각 112 (제자리 32 + 직진 16 + 곡선 64)
    실주행 판정:
    R 0.25 호가 커져 "방 -> 경유지2 / 입구" 에서 테이블 다리에 부딪혔다.
    l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
2026-08-29 feat(nav2,description): D455 깊이를 2D 스캔으로 눌러 costmap 에 넣고 마스트 기울기 3도를 실측 반영한다
    라이다는 지면 0.382 m 단일 평면만 본다. 그 밖의 물체 -- 책상 상판·다리 -- 는
    어떤 costmap 에도 안 들어와 8/29 주행에서 "방 -> 경유지2 / 입구"가 두 번
    충돌로 막혔다. 깊이를 두 번째 눈으로 넣는다.
    ## 1. 마스트가 위로 3.0도 들려 있었다 (VICA.xacro)
    URDF 는 수평(rpy 0 0 0)이라고 알고 있었다. 그 어긋남 때문에 바닥점이 20~40 cm
    떠서 계산됐고, costmap 이 로봇 앞을 통째로 LETHAL 로 덮어 "길이 막혔다"가 났다.
    3도는 2 m 앞에서 10.5 cm 다.
    재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
    [VICA.xacro]
2026-08-30 tune(nav2): sim_time 을 2.5 -> 2.0 으로 내린다 — 갇혀 있는 시간이 3분의 2로 줄었다
    2026-08-02 에 2.0 을 시험해 실패하고 2.5 로 되돌린 기록이 있다(No valid
    trajectories 74 -> 168회). 그러나 **그때는 max_vel_x 가 0.26 이었다.** 그 뒤 0.5 로
    올렸으므로 같은 sim_time 이라도 실제 검사 거리가 다르다.
    8/02 실패한 2.0 2.0 x 0.26 + 0.355 = 0.875 m
    8/02 되돌린 2.5 2.5 x 0.26 + 0.355 = 1.005 m
    지금 2.0 2.0 x 0.50 + 0.355 = 1.355 m <- 8/02 의 2.5 보다 35 % 멀다
    8/02 의 결론("우회 궤적은 멀리 봐야 나온다")은 여전히 옳고, 지금의 2.0 이 그 조건을
    이미 만족한다. 처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
2026-08-30 tune(mission): 목적지 접근 감속 거리를 [1.0, 0.5] -> [0.8, 0.4] 로 당긴다
    max_vel_x 를 0.26 -> 0.5 로 올린 뒤 이 사다리가 재검토되지 않았다. 같은 60 % 라도
    속도가 두 배라 도착 직전 상황이 달라졌다.
    설계(0.26/0.4) 지금(0.50/0.5)
    0.5 m 이내 60 % 직진 0.156 m/s 직진 0.300 m/s
    회전 13.8 도/초 회전 17.2 도/초 <- 오히려 빨라졌다
    즉 **회전은 설계보다 빠르고 정지 낙차만 두 배**가 됐다. 사용자가 느낀 "도착 직전이
    답답하다"는 무제한 구간(28.6 도/초)과의 대비였다.
    정지 낙차를 절대값으로 재보니 급하지 않았다.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
2026-08-30 fix(localization): wheel_base_m 을 0.37 -> 0.387 로 올린다 — 휠이 회전을 4.7 % 과대평가했다
    bag 실측으로 찾았다. 1초 넘게 이어진 회전 구간에서 IMU 와 휠의 회전각을 견주면
    휠이 일관되게 크게 잰다(자이로 편향은 빼고 비교).
    run0918 10구간 IMU/휠 0.9527 총 회전 550도에서 26도 차이
    구간별 0.902 ~ 0.973 로 모두 같은 방향 — 우연이 아니라 계통 오차다
    자이로의 스케일 오차는 보통 1 % 이내이므로 휠 쪽으로 봤다. 회전각은
    (오른바퀴 - 왼바퀴) / wheel_base_m x 시간 이므로 이 값이 작으면 회전각이 크게
    나온다. 0.37 x 1.047 = 0.387.
    ## 실주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
2026-08-30 feat(sensors): 정차할 때마다 자이로 편향을 다시 잰다 (ZUPT)
    종전에는 기동 직후 한 번만 재고 고정이었다. 편향은 온도에 따라 변하므로 30분
    뒤에는 안 맞는다.
    wheel_base 를 고쳐 회전 스케일을 맞춘 뒤(473d2cb) bag 을 다시 보니 AMCL yaw 보정
    추세가 -1.16 도/분 남아 있었고, 그 정체가 이 편향(+0.013 도/초)이었다. 스케일
    오차는 회전한 양에, 편향은 시간에 비례하므로 둘은 따로 잡아야 한다.
    ## 가장 큰 위험 — 직진을 정차로 착각하는 것
    직진 중에도 자이로 평균은 0 에 가까워 크기만으로는 정지와 구별되지 않는다.
    그런데 직진 중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
2026-08-30 docs(sensors): ZUPT 실주행 검증을 기록한다 — 드리프트 추세가 0 에 붙었다
    run1202 (317초 · 44.4 m):
    AMCL yaw 보정 추세 -1.16 도/분 -> +0.03 도/분
    IMU/휠 회전 비율 1.010 -> 0.992 (유지)
    주행 중 28회 갱신
    로그가 결정적이다. 편향이 주행 내내 145 ~ 233 deg/hour 사이에서 움직였다.
    **편향은 고정된 값이 아니었다.** 기동 시 한 번 재서 고정하면 그 순간 값에
    갇히는데 실제로는 60 % 폭으로 변한다.
    가장 긴 주행이었는데도 추세가 0 에 붙은 것이 특히 의미가 있다 — 편향은 시간에
    비례해 쌓이므로 길수록 잘 드러나야 하는데 그렇지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
2026-08-30 feat(interfaces): VicaIntent 에 wait/finish 절과 wait_minutes 필드를 더한다
    도착 후 대화(arrival-dialog-flow) 작업 A — 계약 확장. wait 는 시간을
    wait_minutes(없으면 -1)에 담고, finish 는 홈 복귀 신호. 둘 다 reply=""
    (발화는 상태를 아는 Mission 몫). 상한 강제는 Mission. colcon 재빌드 필요.
    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
2026-08-30 feat(mission): 도착 후 대화 상태기계를 구현한다 (작업 C, 로직)
    arrival-dialog-flow 정본. 도착 → 유형별 질문(restroom=대기 제안 /
    entrance=종료 제안 / 그 외=대기 여부) → 답 갈래:
    - affirm/deny 는 질문 태그(_asking_is_finish)로 해석 — "네"의 뜻이 유형마다
    뒤집힌다. wait 는 시간 있으면 즉시 대기, 없으면 그 외 유형만 "몇 분쯤?"
    후속 질문(restroom/entrance 는 기본 30분). finish·도착 후 cancel(=finish,
    사용자 결정)·종료형 affirm 은 홈 복귀.
    - 무응답 사다리: 못 알아들으면 재질문 1회, 완전 침묵 8초 또는 재질문 실패 시
    떠나기 예고 + 3초 유예(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
2026-08-30 feat(mission): 도착 후 대화를 노드에 배선한다 (작업 C 노드 + D + E)
    - 라우팅: 도착 후 대화 중이면(is_awaiting_arrival_answer) 모든 답을
    on_arrival_answer 로 보낸다 — 같은 말도 이 상태에선 뜻이 다르다.
    - IntentData 에 wait_minutes 를 msg 에서 채운다.
    - /vica/tts_done: 도착 후 질문 재생완료도 8초 기점으로 배선.
    - /vica/wake 구독: WAITING 각성(on_wake) + 복귀 브레이크(on_return_brake,
    작업 E — RETURNING 중 '비카야'면 복귀 취소하고 다시 안내 질문).
    - home.yaml 로더(load_home): 목적지 폴더의 __home__ 을 복귀 목적지로.
    없으면 제자리 대기 폴백. 앱팀 홈 저장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
2026-08-30 tune(mission): 도착 후 대화를 기본 on 으로 바꾼다 (2026-08-30 사용자 결정)
    arrival_dialog 기본값 False -> True. 끄려면 arrival_dialog:=false.
    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
2026-08-30 fix(mission): 도착 멘트와 대기 질문을 한 발화로 합친다 (실기 순서 역전)
    실기(2026-08-30): 도착 멘트는 narration, 대기 질문은 response 라 TTS 큐
    우선순위(response > narration)로 질문이 먼저 재생돼 순서가 뒤집혔다.
    게다가 narration TTL 6초라 도착 멘트가 폐기될 수도. 두 멘트를 한 문장
    ("방 앞에 도착했습니다. 다녀오시는 동안 여기서 기다릴까요?")으로 합쳐
    response 로 낸다 — 순서 역전·폐기가 사라지고 재생 완료 시점이 명확해
    8초 응답 창 시작도 어긋나지 않는다. 캐시 미적중(매번 합성)은 수용
    (도착 멘트가 목적지별이라 원래 캐시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
2026-08-30 fix(mission): 도착 후 대화의 새 목적지 '제안'은 즉시 출발하지 않는다
    실기(2026-08-30): WAITING 각성 후 "입구로 가자"에 확인 질문("안내해드릴
    까요?")이 나오기도 전에 출발했고, 뒤따라온 "그래" 확정 답은 이미 주행
    중이라 MSG_BUSY 로 거절됐다. 원인: on_arrival_answer 의 navigate 분기가
    need_confirm(제안/확정 2단계)을 무시하고 무조건 Navigate 를 냈다.
    수리: 제안(need_confirm=True)은 exit_arrival_dialog 로 대화를 닫고 일반
    확인 흐름(CONFIRMING)에 합류 — 음성이 말한 확인 질문에 "그래" 하면
    그때 출발한다(평소 흐름과 동일). 확정(need_confirm=False)만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
2026-08-30 fix(mission): 무응답 시계가 귀를 보고, 복귀 중 답이 로봇을 세운다
    실기(2026-08-30): 답이 STT(1.5초)·LLM(1~2초)을 통과하는 동안 8초 시계가
    먼저 울려 "응답이 없어" 하고 홈으로 떠났고, 늦게 도착한 답은 버려져
    세울 방법이 없었다. 두 겹으로 수리:
    ① 귀 홀드 — /vica/listen_state(음성 0ffa3ca) 구독. 창이 열려 있거나
    (open/speech) 전사 직후 LLM 처리 중(closed +6초 유예)이면 무응답
    판정을 잡아둔다. 빈손(empty)은 유예 없음. 닫힘 신호 유실 대비 20초
    상한 — 귀가 영영 바빠 보여도 결국 떠난다.
    ② 복귀 그물 — RETURNING 중 wait/navigate 답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
2026-08-31 fix(safety): 통신 미수신 판정을 0.5초에서 3초로 늘린다
    0.5초는 순간적인 CAN·DDS 지연을 통신 단절과 구분하지 못했다. 2026-08-20
    "다시출발 먹통" 사건의 원인 중 하나가 그 순단이었고, 아무도 끊지 않았는데
    걸린 래치를 관리자가 앱에서 풀어야 했다.
    f1_timeout_sec 와 motor_can_timeout_sec 를 3.0 으로 올린다. 대가는 진짜
    단절일 때 정지가 2.5초 늦는 것이다 - 0.5 m/s 주행 중이면 그사이 1.25 m 를
    더 간다. 사용자가 그 대가를 알고 지정했다(2026-08-31).
    물리 버튼 반응은 느려지지 않는다. 이 값은 프레임이 아예 안 오는 시간을
    재는 것이고,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
    [emergency_stop_node.py]
2026-08-31 fix(mission): WAITING 을 앱 취소로 풀 수 있게 한다 (관리자 회수)
    WAITING(최대 30분 제자리 대기) 신설 때 취소 게이트를 갱신하지 않아,
    관리자가 대기 중인 로봇을 회수할 방법이 없었다(새 목적지도 취소도
    거절 — E-stop 뿐). 취소 게이트에 WAITING 을 더하고, 취소 시 대기
    타이머·질문 태그를 완전히 정리한 뒤 제자리 IDLE 로 내린다 —
    "취소 후 새 명령" 두 걸음 철학 그대로. ASKING_* 는 길어야 1분이고
    침묵이면 저절로 홈에 오므로 열지 않는다(사용자 결정 — 범위 최소).
    시험 2건 추가, 미션 289 통과.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
2026-08-31 fix(mission): 그 외 유형 질문을 대기형으로 바꾸고 상태 구멍 둘을 막는다
    ① 질문 개편(사용자 결정): "이제 괜찮으신가요? 아니면 여기서 대기할까요?"
    → "여기서 대기할까요?" — 네=대기(시간 질문으로), 아니오=종료로 단순.
    유형 태그를 (종료형, 시간질문형) 2축으로: restroom 네→기본 30분,
    entrance 는 시간 안 묻고 30분(스펙 정합), 그 외만 "몇 분쯤?".
    ② 시간 질문의 네/아니오 오해석 차단: 옛 질문 태그가 남아 "네"가
    종료(홈행)로 둔갑하던 구멍 — 숫자가 올 때까지 재질문 사다리로.
    ③ 시계 유실 폴백: 질문 재생이 barge-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
2026-08-31 docs(mission): 30초 폴백을 최후 안전망(watchdog)으로 격하 표기한다
    근본 수리는 TTS 쪽(끊긴 발화도 tts_done 발행) — 이 폴백은 신호 유실·
    TTS 사망 같은 계통 밖 사고 전용임을 주석으로 못박는다.
    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
2026-08-31 fix(nav2): 초기 위치 탐색을 3단계로 바꾸고 공분산을 RViz 값으로 넓힌다
    같은 자리 주변을 여러 번 짚어도 68 점과 72 점이 오갔다. 합격선이 70 이라
    손가락 1~2 cm 차이로 당락이 갈렸다. 원인이 둘이었다.
    **격자 해상도.** 정밀 탐색이 2.5 cm 격자 위에서만 답을 골라 그 사이의 진짜
    최고점을 못 찾았다. 정밀 범위(+-10 cm)도 거친 격자(10 cm)의 반올림 오차를
    겨우 덮는 크기라, 거친 1등이 조금만 어긋나면 따라가지 못했다.
    단계를 하나 더 뒀다. 1단계가 넓게 훑어 봉우리 후보 10 개를 추리고(서로 15 cm
    /10도 이상 떨어진 것만 - 안 그러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
2026-08-31 fix(description): 카메라 재장착 후 높이·기울기를 다시 실측해 반영한다
    카메라를 탈착 후 재장착하면서 자세가 바뀌었다.
    높이 1.025 -> 1.045 m (지면에서 렌즈 중심까지, 줄자 실측)
    camera_z 0.835 -> 0.855
    기울기 위로 3.00도 -> 위로 0.71도
    camera_pitch -0.0524 -> -0.0124
    기울기 측정 3회 -2.35 / -2.31 / -2.24 도, 편차 0.05. 평면 두께 8 mm, 점 17,000개.
    바닥 평면 RANSAC 으로 쟀다(scripts/vica_camera_pitch.py).
    ## 도구의 결함을 하나 고쳤다
    이 도구가 재는 것은 **URDF 기준 잔여 오차**다. TF 가 이미 camera_pitch 를 반영하고
    있기 때문이다.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
    [VICA.xacro]
2026-08-31 feat(mission): 앱 명령 전권화 — 선점 주행과 전면 취소 (2026-08-31 결정)
    관리자 앱의 권한을 확정한다 (ESTOPPED 만 예외 — reset 경로 보호):
    - 새 목적지(on_app_destination): 어느 상태든 내부적으로 전부 취소하고
    즉시 출발. 멘트는 기존 출발 안내만(신규 문구 없음 — 사용자 결정).
    목적지 품질 검증(공개·좌표·Nav2 준비)은 음성 게이트와 같은 기준.
    - 취소(on_app_cancel): 어느 상태든 전부 정리하고 IDLE. IDLE 취소는
    조용히 수락. **음성 취소와 분리** — 음성은 기존 게이트(주행·일시정지·
    대기) 유지: 지나가는 "취소" 한마디가 접근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
2026-08-31 tune(mission): E-stop 해제 멘트를 짧게 바꾼다
    "비상 멈춤이 해제되었습니다. 새로운 목적지를 말씀해 주세요." →
    "비상멈춤이 해제되었습니다." (2026-08-31 사용자 확정 — E-stop 에피소드의
    멘트가 많다는 지적에 따른 감량). 구운 캐시 재굽기 전까지는 실시간 합성
    (F2, 0.7초)으로 폴백된다.
    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
2026-08-31 tune(mission): E-stop 멘트를 걸림 1 + 해제 1 로 감량한다
    "멈춰" 한 번에 비슷한 말 3연발(음성 즉답 + 걸림 멘트 + 곧이어 대기
    멘트)이던 것을 정리 (2026-08-31 사용자 결정):
    - reset 대기 멘트(MSG_ESTOP_WAIT_ADMIN) 삭제 — 원인 펄스가 몇 초 만에
    꺼져 걸림 멘트 직후 연달아 나왔다. on_estop_sources 는 통신/사람 판별
    스냅샷 추적만 남김.
    - 걸림 분기(관리자 호출 vs 자동복구)와 해제 멘트는 유지.
    음성 즉답 제거는 voice 쪽 커밋. 시험 305 통과.
    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
2026-08-31 tune(mission): 정지 중 E-stop 은 침묵한다 — 안내 규칙 최종 단순화
    움직이는 중(주행·접근·회전·복귀)에 걸릴 때만 "안전을 위해 멈추겠습니다.
    관리자를 호출했습니다"를 말한다 (2026-08-31 사용자 결정 — 정지 중 걸림은
    사용자에게 달라지는 게 없다). 침묵 걸림은 해제도 침묵(짝 맞춤,
    _estop_announced). 연쇄 단순화: 자동복구 예고 멘트(MSG_ESTOP_COMM)는
    정지 중 전용이라 존재 이유가 사라져 삭제, 그 판별 재료였던
    /estop_sources 구독·추적·COMM 상수도 전부 제거. E-stop 중 명령 거절
    멘트는 유지(반복이 아니라 응답). 시험 306 통과.
    Co-Au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
2026-08-31 feat(interfaces): 금지구역 저장·조회 서비스 계약을 추가한다
    SaveKeepout·GetKeepout 두 srv 를 넣는다. keepout_map_node 가 제공하고 관리자
    앱이 부른다.
    topic 왕복이 아니라 service 인 이유는 이 요청에 "됐다/안 됐다"가 있기
    때문이다. topic 이면 request_id 를 붙여 답장을 짝짓는 일과 상태 5종을 앱이
    직접 관리해야 한다. 최근 앱 기능(PoseCheck·SaveHome·SaveMap·DeleteMap)이
    모두 service 이고 앱에는 이미 callService 가 있다.
    zones_json 은 사각형 목록 **전체**다. 부분 수정 규약을 두지 않으므로 삭제도
    '그 사각형이 빠진 목록'이며, 그래서 삭제 전용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
2026-08-31 feat(nav2): 앱이 그린 금지구역을 global costmap 에 물린다
    global_costmap 에 filters 와 KeepoutFilter 를 넣고, 마스크를 발행하는 서버
    두 대(map_server + costmap_filter_info_server)와 전용 lifecycle_manager 를
    launch 에 붙인다. filters 는 plugins 와 별개 항목이다 — 공식 문서가 inflation
    layer 와의 간섭을 막으려고 분리했다고 명시한다.
    기존 plugins 목록과 순서, inflation·footprint·padding 은 건드리지 않았다
    (docs/nav2_backlog.md §9). 금지구역은 그 위에 더하는 기능이지 닫아 둔 축을
    다시 여는 구실이 아니다.
    **local_costmap 에는 아직 넣지 않는다.** local 의 global_frame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
2026-08-31 feat(nav2): 확인한 자세에서 본 라이다 점을 앱에 함께 보낸다
    RViz 는 초기 위치를 잡고 나면 그 자세 기준으로 라이다 점을 지도에 겹쳐
    보여준다. 사람은 그 그림으로 "맞았나"를 눈으로 판단한다. 앱에는 점수 하나뿐이라
    68 점이 나와도 사람 때문인지 자세가 틀린 것인지 알 수 없었다.
    앱이 /scan 을 직접 구독하지 않는다. 10 Hz x 721 점이 rosbridge 로 오가는 것도
    낭비지만, 더 큰 문제는 **좌표 변환을 앱이 할 수 없다**는 것이다. /scan 은 라이다
    기준 각도·거리로 오므로 지도에 그리려면 로봇의 정확한 자세가 필요한데, 지금
    잡으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
2026-08-31 tune(mission): 해제 안내를 emergency 로 올린다 — 걸림 멘트를 끊고 즉시 알린다
    response 등급이면 걸림 멘트("안전을 위해 멈추겠습니다…")가 아직 재생 중일 때
    그 완주를 기다려 낡은 소식이 된다. TTS 큐의 emergency 선점(하던 말 끊고 즉시
    재생)을 그대로 타서 해제 순간 "비상멈춤이 해제되었습니다"가 바로 나간다.
    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
2026-08-31 tune(mission): E-stop 해제 유예를 2초에서 1초로 줄인다
    해제 안내가 그만큼 빨리 나간다. 래치 깜빡임 방어(유예 자체)는 유지한다.
    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
2026-08-31 fix(mission): 접근 응답 8초를 질문 재생완료부터 센다 — 창이 0초였다
    접근 질문 음성이 정확히 8.0초인데 응답 시계가 질문을 큐에 넣는 순간부터
    돌아, 재생이 끝나는 순간 만료 판정과 경합해 답할 창이 0초였다
    (2026-08-31 실기 로그 2건 — 질문 후 8.2초 만에 "실례했습니다" 이탈).
    도착 후 대화와 같은 방식으로: 진입 시엔 탈출용 안전망 30초만 걸고,
    진짜 8초는 tts_done(끊긴 발화에도 발행됨)부터 센다.
    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
2026-08-31 fix(mission): 확인 질문의 네/아니오에 정식 통로를 만든다 — LLM 추측 제거
    CONFIRMING 에서 출발이 확정되는 유일한 길이 "LLM 이 '그래'를 대화 기록으로
    목적지를 추측해 확정 navigate 로 재구성하는 것"뿐이었다. 추측이 어긋나면
    엉뚱한 목적지, affirm 으로 해석되면 접근 질문 전용 배선이라 통째로 버려져
    30초 뒤 "안내 요청이 취소되었습니다"로 끝났다 (2026-08-31 야간 실기:
    affirm 무시 4건·확인 타임아웃 취소 7건·'그래' 단독 navigate 추측 8건).
    확인 중인 목적지는 미션이 이미 안다(_confirming_dest_id). affirm 이면 그
    목적지로 on_intent 의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
2026-08-31 feat(user-guidance): 전방 초음파 2채널을 스마트핸들 펌웨어에 얹는다
    DYP-A22 IIC x2 를 나노 A4/A5 에 논블로킹 상태머신으로 통합한다.
    기존 서보·LED 로직은 한 줄도 건드리지 않는다(A-2 사고 이력).
    - 순차 발사(GAP 5ms -> TRIG 0xBC -> WAIT 100ms -> READ), 채널당 약 4.8Hz.
    빔이 겹치는 배치라 동시 발사는 서로의 메아리를 읽는다(설계 문서 §4.2)
    - 0xFFFF(미완료)/0xFFFE(간섭) 폐기 + 3점 중앙값, 3연속 실패 시 0(무효)
    - 0xFFFD 는 실기로 규명한 '범위 내 에코 없음' 마커 — clear(3001)로 구분해
    전달한다. 실패로 치면 앞이 뚫릴 때마다 costmap 을 지울 수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
2026-08-31 feat(user-guidance): 상향 초음파 프레임을 받아 Range 로 발행한다
    같은 시리얼 포트의 상향 8B 프레임을 드라이버가 읽어
    /ultrasonic/front_left·front_right (sensor_msgs/Range) 로 발행한다.
    노드를 새로 만들지 않는 이유: 포트는 하나고 두 프로세스가 같이 못 연다.
    - ultrasonic_frame.py: 스트림 누적 파서(순수 함수). 반쪽 프레임·붙은
    프레임·쓰레기 재동기·체크섬·버퍼 상한을 시험 9개가 고정한다
    - serial_link.read_available(): 논블로킹 수신. 수신 예외도 전송 실패와
    같은 경로로 포트를 닫아 재연결에 합류(시험 3개)
    - 타임스탬프 보정: 순차 발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
2026-08-31 feat(nav2,description): 초음파 URDF 링크와 센서별 range 레이어를 단다
    - VICA.xacro: usonic_front_left/right 링크 (+0.305, ±0.107, -0.0987, 수평).
    드라이버 ultrasonic_frame_ids 와 이름 일치 필수
    - local_costmap: range_sensor_front_left/right 두 레이어로 분리해서 추가.
    한 레이어에 두 토픽을 넣으면 확률 장부를 공유해, 겹침 구역에서 비스듬한
    면에 소리가 튕긴 센서의 거짓 '에코 없음'이 이웃 센서의 마크까지 지운다
    — 실주행에서 LETHAL 109->0->109 깜빡임으로 로봇이 상자를 밀고 갔다.
    분리하면 clear 는 자기 장부만 지우고 master 는 max 결합이라 마크가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
    [VICA.xacro]
2026-09-01 fix(monitor): nvblox 대신 카메라 스캔을 감시한다
    Nav2 는 nvblox 를 쓰지 않는다. nav2_params.yaml 의 global·local plugins 어디에도
    nvblox_layer 가 없다. 그런데 감시만 남아 있어서 Docker 를 띄우지 않으면 앱
    시스템 진단에 '3D 인식 저하'가 상시로 떴다. **쓰지도 않는 것을 감시하다 낸
    경고**이고, 이런 경고가 상시로 떠 있으면 사람이 결함 표시 자체를 무시하게 된다.
    카메라가 실제로 쓰이는 길은 이것뿐이다.
    /camera/camera/depth/color/points (D455)
    -> depth_band_to_scan (0.30~1.05 m 띠만 눌러 2D 로)
    /camera/depth_scan
    -> local_costmap 의 observation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
    [probes.yaml, test_config_contract.py, test_fault_catalog.py]
2026-09-01 feat(safety): 비상정지 원인을 앱 상태에 함께 보낸다
    /app_estop_state 에 sources 를 더한다. 지금 래치를 붙들고 있는 원인
    (physical_f1·app·voice·motor_can·*_stale)이다.
    앱이 이 값을 쓰는 이유는 하나다. 물리 버튼이나 음성으로 걸린 비상정지는 로봇이
    이용자에게 "관리자를 부르겠다"고 안내하므로 관리자 화면도 그 사실을 알아야
    한다. 반대로 관리자가 앱에서 직접 누른 것은 부르는 사람과 받는 사람이 같아
    그 안내가 필요 없다. **원인 없이는 앱이 이 둘을 가릴 수 없다.**
    /estop_sources 로도 나가지만 앱이 그것을 따로 구독하게 하지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
2026-09-01 fix(mission): 늦은 취소가 방금 보낸 goal 을 죽이지 않게 번호표를 단다
    앱 전권화의 [취소 -> 즉시 출발] 경로에서 취소 스레드가 _nav_lock 을 새
    출발보다 늦게 잡으면 cancelTask() 가 '지금 잡혀 있는' 새 goal 을 취소했다
    — 앱 명령이 조용히 사라지는 증상(8/20 다시출발 먹통과 같은 얼굴).
    goToPose/spin 이 수락될 때마다 주행 번호(_nav_gen)를 올리고, 취소 스레드는
    쪽지에 적힌 번호와 지금 번호가 다르면 취소를 건너뛴다 — 옛 goal 은 Nav2
    선점으로 이미 내려가 있다. 거부된 goal 은 번호를 올리지 않아 대기 중인
    취소가 옛 goal 을 마저 지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
2026-09-01 fix(mission): 안내 종료의 홈 복귀가 auto_return_home 에 막히지 않게 한다
    dev 의 도착 후 대화(종료 답·무응답 떠남·대기 만료 -> 홈 복귀)가 머지되면서
    feat 의 접근 뒤 제자리 정책(auto_return_home 기본 꺼짐, 2026-08-27) 게이트
    뒤로 지나가게 됐다. 기본 설정에서 사용자가 '끝났어요'라고 해도 로봇이
    종료 멘트만 하고 제자리에 서 있었다 — test_arrival_dialog 3건이 이것을
    잡고 있었다.
    _go_home 이 dialog_finish=True 로 게이트를 지나가게 한다. 접근 뒤 복귀
    (_enter_returning 직접 호출 3곳)는 종전대로 스위치를 따른다 — 두 상황은
    다르다: 접근 거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
2026-09-01 tune(mission): 중복·군더더기 멘트 5건을 지운다 (2026-09-01 감량)
    회전 완료(온보딩이 대신함)·재시도 안내(침묵 재출발)·홈 복귀중 2곳
    (예고·대기 안내가 이미 말함)·엇갈린 confirm(침묵이면 재요청 유도)·
    취소 재확인 타임아웃의 "이어갑니다"(조용히 계속). "약 N미터"는 이미
    마일스톤이 비어 안 나가므로 배선만 남긴다. 질문 11·안전/확인 12는 유지.
    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
2026-09-01 fix(cartographer): 매핑 정지를 비동기로, 시작 전 필수 노드를 실제로 검사한다
    정지: 종전 handle_stop 은 SIGINT->SIGTERM->SIGKILL 각 8초 유예를 콜백 안에서
    _lock 을 잡은 채 기다렸다(최악 24초). 그동안 start/stop/save/상태 tick 이 줄을
    서고 rosbridge(default_call_service_timeout=0.0)까지 막혀 앱 전체가 먹통이
    됐다 — 저장을 즉시 응답으로 바꾼 2026-08-21 교훈과 같은 병. 이제 StopEscalation
    (순수 로직)이 '지금 보낼 신호'만 알려주고, 상태 타이머가 매 tick 사다리를 한
    칸씩 밟는다. 완료는 /vica/mapping_status 의 idle 로 알린다. STARTING 시한
    초과 정리도 같은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
2026-09-01 feat(mission): 취소·앱 선점 때 발화 큐를 청소한다 (StopSpeech)
    상태는 즉시 바뀌는데 입에 물린 낡은 멘트가 이어 나와 헛소리가 됐다.
    _force_clear_all 맨 앞에 StopSpeech 를 넣어 음성 취소·앱 취소·앱 선점
    세 경로 모두 하던 말 중단 + 대기 비긴급 폐기(/vica/tts_stop, barge-in
    과 같은 계약)를 먼저 밟는다. 긴급 발화는 건드리지 않는다.
    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
2026-09-01 feat(mission): "비카야"가 답-대기 상태를 조용히 접는다 — 옛 질문의 답 차단
    호출 = 새 대화(2026-09-01 사용자 결정). CONFIRMING·도착 질문·접근 질문
    상태가 살아 있으면 새 대화의 첫 마디(짧은 "그래" 오전사 등)가 옛 질문의
    답으로 오인 접수된다. 접는 멘트는 없고, WAITING 각성·RETURNING 브레이크
    흐름은 그대로다. 접근 질문 접기는 같은 사람 재접근을 억제하고 제자리에
    선다(복귀 주행 없음).
    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
2026-09-01 fix(mission): WAITING·복귀 중 "비카야"도 질문 없이 접는다 (A안)
    각성 질문("다시 안내를 시작할까요?")은 도착-대화 문법을 빌려 쓴 오배선
    이라 "네"가 시간 질문("몇 분쯤 걸리실까요?")으로 샜고, 실기(8/31 21:42)
    에서 혼란→무응답 판정→사용자를 두고 홈행 연쇄를 만들었다. "네?"가 이미
    말할 차례를 알리므로 대기·복귀를 접고 새 대화(확인 흐름)로 받는다.
    복귀 브레이크의 quiet 경로(늦은 답 선처리용 ASKING 진입)는 유지.
    MSG_WAIT_RESUME_ASK 삭제 — 멘트 감량 6번째.
    Claude-Session: https://claude.ai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
2026-09-01 fix(mission): 확인 중 같은 목적지 재제안은 답으로 확정한다
    "응 화장실로 가자"를 LLM 이 재제안(confirm=True)으로 되돌리면 같은 확인
    질문이 반복됐다(8/31 야간: 3수째에야 출발). 확인 중인 목적지와 같으면
    on_confirm_answer 정식 통로(게이트 포함)로 보내 출발한다.
    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
2026-09-01 tune(user-guidance): 초음파 지향각을 50도에서 40도로 되돌린다 — 운영 과잉 봉쇄
    50도(호 폭 1.31m)를 운영에 올려 보니 좁은 곳 과잉 봉쇄가 체감으로
    심해졌다(사용자 보고). 실주행 8회차에서 봉쇄/회피 양립을 검증한
    40도(호 폭 1.05m)로 복귀한다. max_range 1.5m·센서별 레이어 분리 등
    다른 조건은 무변경. 펌웨어 레지스터(US_ANGLE_LEVEL 0x02)와 ROS
    fov(0.698)를 함께 바꿔 일치를 유지한다. 실기 재플래시 완료(프레임 5.0Hz).
    Claude-Session: https://claude.ai/code/session_01Nr4RVBupFvpBqJZQQdqEaw
2026-09-01 tune(user-guidance): 지향각을 50도로 재확정한다 — 40도 복귀는 오진이었다
    e3e72a5 의 근거였던 '50도 과잉 봉쇄 체감'은 초음파가 아니라 라이다가
    바닥의 모니터 선을 장애물로 본 것이 원인으로 판명됐다(사용자 확인).
    9회차 주행에서 검증된 50도(fov 0.873)로 되돌린다. max_range 1.5m·
    레이어 분리는 무변경. 실기 재플래시 완료(프레임 5.0Hz).
    교훈을 config 주석에 남긴다: 봉쇄 증상이 보이면 각도를 의심하기 전에
    라이다가 보는 실물(선·틈)부터 확인할 것.
    Claude-Session: https://claude.ai/code/session_0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
2026-09-01 fix(mission): StopSpeech 를 tts_request 제어 메시지로 보낸다 — 순서 보장
    별도 토픽(tts_stop)은 뒤이어 시키는 새 멘트("안내를 시작합니다")와 도착
    순서가 뒤집힐 수 있다 — 음성 쪽 "네?" 증발과 같은 경합. 같은 토픽의
    "control:stop" 으로 청소→새 멘트 순서를 보장한다.
    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
2026-09-01 feat(perception): 주행 중에는 사람 탐지 추론을 멈춘다
    접근 요청은 mission_logic 이 IDLE 에서만 수락하므로("안내를 받고 있는
    사용자가 우선이다") 주행 중 추론은 결과가 버려질 것이 확정된 계산이었다.
    /vica/robot_state 의 is_moving·is_paused 를 보고 _on_color 첫 줄에서
    되돌아 나온다. 구독은 유지한다 — 끊었다 다시 걸면 DDS 재발견 동안
    도착 직후의 재개가 늦는다(A안, 사용자 결정).
    상태를 모르면(미수신·3초 stale·시간 역전) 켜는 쪽으로 넘어진다. 이
    노드는 안전 회로가 아니고(/vica/person_detection 구독자 0, 장애물은
    라이다·depth_band_to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
2026-09-01 fix(safety,nav2): 유령 정지와 허위 실패를 만들던 시한 두 개를 넓힌다
    estop_timeout_sec 0.5 -> 2.0: /emergency_stop 하트비트(30Hz)가 CPU·DDS
    순단에 0.5초 지각하는 것만으로 감독이 FAULT -> WAIT_RESET 로 떨어져,
    래치는 안 걸렸는데 관리자 초기화만 요구하는 유령 정지가 실기에서 반복됐다
    (17:34 로그 실증, 자동복구 사각지대). motor_can 3.0초와 같은 철학이다.
    bt_navigator default_server_timeout 20 -> 100ms: load 높을 때 서버가
    20ms 안에 접수를 못 해 'Timed out ... acknowledge' / 'Failed to get
    result in node halt' 로 goal 이 ABORTED — 로봇은 도착했는데 앱에는
    실패+관리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
    [safety_supervisor_node.py]
2026-09-01 feat(nav2): pose_bootstrap 세션 게이트와 실기 확정 합격선 65
    세션 게이트: scan 상시 수신 + TF 청취기가 이 노드 CPU 의 사실상 전부
    (코어 ~16%)인데 쓰이는 건 초기위치 잡는 몇 분뿐이다. 서비스가 불릴 때
    스스로 귀를 열고(첫 스캔 최대 1.5초 대기 — MultiThreadedExecutor 라
    구독은 계속 돈다) 마지막 요청 후 5분 무사용이면 닫는다. 앱 변경 불필요.
    MIN_SCORE 70 -> 65: [TARGET] 절차대로 실기에서 확정. 정답 자리 주변인데
    71부터야 통과했고 주위 5m 가 트인 자리는 더 낮았다. 낮춘 만큼의 오확정
    위험은 라이다 점 겹쳐보기로 사람이 이중 확인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
2026-09-02 tune(user-guidance): 초음파 마킹 폭만 30도로 줄인다 — 코너 부풀림·주춤 실험
    물리 빔(레벨 3, 50도)은 그대로 두고 발행 field_of_view 만 0.873 -> 0.524.
    이 값은 costmap 이 그리는 호의 폭이라 감지력·감속 반응은 불변이다.
    근거(bag 실측):
    - usonic_stutter01: 부분 감속 13건 중 92%가 초음파 마크 상관(CM 0발동)
    - usonic_corner01 렌더링 3장: 실물 실루엣 너머로 초음파 호가 살을 붙여
    코너 10cm 틈을 지도에서 닫음 — 복불복 통과의 원인
    - inflate_cone 은 소스 확인 결과 원뿔 밖 자투리 판정용이라 부적합
    효과: 1.5m 거리 마킹 호 폭 1.31 -> 0.79m. 대가: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
2026-09-02 docs(user-guidance): 마킹 폭 30도를 A/B 실측으로 확정 표기한다
    같은 검출 잣대로 마킹 50° 1.6건/분 -> 30° 0.2건/분(8분의 1),
    평균 속도 동일, 스냅샷에서 마크가 실물 실루엣 밀착. 사용자 체감
    '주행 중 멈춤 좋아짐'으로 확정. (usonic_stutter01 vs usonic_fovnarrow02)
    Claude-Session: https://claude.ai/code/session_019wqHp2h915isRz2yPtaqnr
2026-09-02 fix(mission): 취소할 주행이 없을 때도 대기 사실을 앱에 알린다
    2026-09-02 실기: 홈 도착 뒤 앱이 '주행 중'으로 굳어 주행 취소를 눌러도 아무
    일이 없었다. 로봇은 이미 IDLE 이라 on_app_cancel 이 조용히 수락하고 아무
    이벤트도 내지 않아, 앱의 유령 표시를 되맞출 길이 없었다.
    대기 상태에서 앱 취소가 오면 state_idle 을 한 번 낸다. 앞으로 어떤 이유로
    앱 표시가 뒤처져도 취소 버튼이 새로고침 역할을 한다. 주행 중 취소는 종전대로
    goal_canceled 만 낸다 — 같은 사건을 두 번 알리지 않는다.
    _publish_goal_event 가 destination=None 을 받게 했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
2026-09-02 feat(monitor): 감독 FAULT 를 결함으로 보고하고 할 일을 문구에 담는다
    아무도 누르지 않았는데 주행이 막히는 유일한 안전 상태인데, 화면에 이름이
    없었다. 2026-09-01 실기에서 관리자가 본 것은 "일부 기능 저하" 다섯 글자뿐이라
    왜 안 가는지도, 무엇을 해야 하는지도 알 수 없었다.
    ## 왜 조용히 지나갔나
    _judge_safety 의 검사 다섯 개를 감독 FAULT 가 전부 통과했다.
    래치 걸렸나 -> 아니다 (estop_latched=False, 중앙 래치는 안 걸린다)
    상태 방송이 끊겼나 -> 아니다 (감독은 살아서 방송 중이다)
    ESTOP_ACTIVE 인가 -> 아니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
2026-09-02 feat(description): 초음파 센서를 URDF 에 보이게 한다
    usonic_front_left/right 가 visual 없는 빈 링크라 rviz 에서 TF 축만 떴다.
    센서가 실제로 어디에 붙어 있는지, 범퍼 앞면보다 튀어나오지는 않는지를 눈으로
    확인할 수 없었다.
    DYP-A22 일반 규격(방수 원통형, 직경 22 mm · 길이 20 mm)을 cylinder 로 넣는다.
    카메라(D455)를 box placeholder 로 둔 것과 같은 방식이다.
    링크 원점은 **센서 앞면**(측정 원점)이고 몸체는 그 뒤로 뻗으므로, 원통 중심을
    길이의 절반만큼 -x 로 물렸다. 이걸 빼먹으면 실물보다 20 mm 앞으로 튀어나온
    것처럼 그려져 usonic_x(0.30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
    [VICA.xacro]
2026-09-02 feat(monitor): 스마트 핸들·초음파와 앱 브리지를 진단에 연결한다
    앱 시스템 진단의 부품 9개 중 3개가 회색('관측 불가')이었다. 그중 둘의 근거가
    낡아 있었다.
    ## guidance — 상향 통신이 이미 생겼다
    설정 주석은 "아두이노 -> 젯슨 상향 통신이 없다"였는데, 2026-08-31 초음파
    연동으로 생겼다. 펌웨어가 4.8Hz 로 프레임을 올리고 드라이버가 Range 로
    발행한다(실측 4.675Hz). fault_catalog 의 GUIDANCE_UPLINK_STALE 도 "현재 상향
    경로가 없어 발행되지 않으며"라고 적혀 있었다 — 그 코드가 이제 실제로 쓰인다.
    **아두이노 하나에 핸들 안내와 초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
2026-09-02 feat(monitor): 음성은 노드 실행만 확인하고, 그 한계를 화면에 남긴다
    앱 진단의 마지막 회색 칸이었다. 주기 토픽이 없어 topic_rate 로는 볼 수 없고
    (음성 토픽은 사람이 말을 걸 때만 나온다), 프로세스 생존만 /proc 으로 볼 수
    있다. 사용자 판정(2026-09-02): **일단 실행 여부만 보고, 정확한 상태 연결은
    LLM 파트 수정이 끝난 뒤에 한다.**
    ## required 옵션을 프로세스 프로브에 추가했다
    종전 프로세스 프로브는 대상이 없으면 OK('미구성')로 보고했다. Docker 안
    프로세스는 안 떠 있는 것이 정상인 경우가 많아서다. 그대로 두면 **음성 노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
    [probes.yaml, test_config_contract.py]
2026-09-02 fix(nav2,monitor): 주행 명령 경로를 되살리고 감시하며, 합격선을 55 로 내린다
    세 가지를 함께 넣는다. 앞의 둘은 같은 사고의 예방과 탐지다.
    ## 1. collision_monitor 기동 재시도 (D-1)
    2026-09-02 하루에 두 번, 초기 위치를 제대로 잡았는데도 로봇이 안 갔다. 두 번
    다 Nav2 재기동으로만 풀렸다. 원인은 collision_monitor 활성화 실패다 — 그 노드가
    /cmd_vel_req 를 만드는 **유일한 발행자**라, 잠들면 Nav2 가 멀쩡히 경로를 계산해도
    명령이 밖으로 못 나간다. 프로세스는 살아 있어 노드 목록에는 보인다.
    실패 기록(19:25 회차):
    19:25:54.98 관리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
    [probes.yaml, test_config_contract.py]
2026-09-02 feat(destination): 목적지에 도착 문자 연락처(contact_phone)를 저장한다
    물류 배송이 도착하면 앱이 문자를 보낼 번호다. normalize_destination 은
    적힌 키만 새 dict 로 만들어서, 여기 넣지 않으면 앱이 보내도 조용히 버려진다
    (저장은 성공한 것처럼 보이고 다시 불러오면 비어 있다).
    - 숫자만 남겨 저장하고 휴대폰 번호 모양(01[016789] + 7~8자리)이 아니면 거부한다.
    'abc' 처럼 숫자가 없는 값은 빈 값으로 눙치지 않고 거부한다 — 오타가 조용히
    사라지면 관리자는 번호를 적었다고 믿는다.
    - 비어 있으면 빈 값이다. 연락처 없는 장소는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
2026-09-02 feat(mission): 물류 배송 전용 서비스 /vica/mission/request_delivery — private 목적지 허용
    배송은 교수 사무실처럼 private 로 저장된 곳으로 가는 일이 많다(2026-09-02
    사용자 결정). 일반 앱 주행과 음성 경로의 private 차단은 그대로 둔다.
    - 요청 모양은 RequestDestination 그대로이고 이름만 다르다. MissionCommand 처럼
    "무엇을 할지는 service 이름이 정한다". 음성/LLM 은 서비스 클라이언트가 없어
    이 문에 닿지 못한다(홈 복귀와 같은 논리).
    - on_app_destination(allow_private=True) 는 authorization 검사 하나만 푼다.
    접근 불가·지도 밖·Nav2 미준비·E-stop 은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
2026-09-03 feat(mission): 배송 출발 멘트를 "배달을 시작합니다"로 가른다
    배송은 사람을 데려가는 일이 아니라 물건을 옮기는 일이라 "안내를 시작합니다"가
    어색하다. 2026-09-03 사용자 승인:
    MSG_START_DELIVERY = "{name}{josa} 배달을 시작합니다."
    문장 틀만 다르고 조사 계산(say_destination)은 그대로다 — "407호로",
    "식당으로" 처럼 받침에 맞게 붙는다.
    가르는 것은 `is_delivery` 하나이며 request_delivery 서비스에서만 켠다.
    `allow_private`(권한)와 겸용하지 않는다 — 지금은 늘 같이 켜지지만 뜻이
    달라(하나는 권한, 하나는 말투) 겸용하면 "배송인데 공개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
2026-09-03 feat(carto): CM-7 loop closure 검색창을 3 m 로 줄인다 [실기 전]
    복도 매핑 실패 3회(8/12·9/3 두 회)의 translation 최대 오차가 전부
    기본 검색창 7 m 언저리(7.01/7.27/7.85)였다. 복도 자기유사성 때문에 창
    끝까지 미끄러진 가짜 loop closure 가 62~68 % 점수로 통과해 지도를
    찢는다(9/3 1 m 초과 48~59 %). CM-1(max_range 11)이 적용된 상태의
    결과라 다음 축으로 이 창을 연다.
    이번 실주행의 변수는 이 값 하나다. 2.0·min_score 0.70 은 이번 bag 의
    offline 재생으로 비교한다. 판정은 §6 — 최대 1 m 미만, 1 m 초과 0건.
    Claude-S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
2026-09-03 feat(carto): CM-3 loop closure 합격 점수를 0.70 으로 올린다 [실기 전]
    CM-7(창 3 m) 위에 얹는 2회차. 1회차에서 가짜 매칭이 창 끝(2~3 m)에
    몰려 창만으로는 못 막는다는 것이 확인됐다. 1회차 점수 분포에서
    진짜 중앙 71.0 / 가짜 중앙 67.0 이라 0.70 이 가짜 73 % 를 걸러내고
    진짜 2168건을 남긴다. 구속조건 총수가 절반 밑으로 떨어지면 0.68 로.
    Claude-Session: https://claude.ai/code/session_014TcPNrrVrrQj9VTJE6CdgF
2026-09-03 feat(mission): 관리자 홈 복귀 중 일시정지·다시 출발을 허용한다 [실기 9/3 통과]
    배송을 마치고 홈으로 돌아가는 로봇을 관리자가 앱에서 잠깐 세울 길이 없었다.
    check_pause_gate 가 NAVIGATING 만 허용했기 때문이다(2026-09-03 검토).
    - check_pause_gate(returning_home=): 관리자가 부른 홈 복귀(RETURNING +
    _returning_home)도 허용한다. 접근 뒤 자동 복귀는 그대로 막는다 — 다시
    출발을 누를 주체가 없다.
    - on_pause_request: 홈 복귀를 멈춘 사실을 _paused_returning_home 에 보관한다.
    - on_resume_request: 보관 표시가 있으면 NAVIGATING 이 아니라
    _enter_returning(is_home=T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
2026-09-03 fix(monitor): 진단 어댑터가 설정 타입 오류로 죽지 않게 하고, 죽으면 한 건으로 알린다
    2026-09-03 실기: 시스템 진단에 라이다·위치추정(STOP)·인지·안내·음성·앱
    (DEGRADED) 여섯 개가 "진단이 갱신되지 않았습니다"로 떴고 알림에
    [발생] 라이다… 가 쌓였다. 주행은 정상이었다. 원인은
    external_diagnostics_node 가 기동 8초 만에 죽은 것이다.
    InvalidParameterTypeException: 'cmd_vel_req_link.min_publishers'
    to '1' of type 'INTEGER', expecting type 'DOUBLE'
    probes.yaml 의 min_publishers: 1(정수)이 노드 기본값 1.0(실수)과 달랐다.
    150296d(9/2)가 넣은 뒤 이 노드가 정상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
    [test_agg_parser.py, test_config_contract.py]
2026-09-03 fix(monitor): 진단 경고를 부품 등급으로 승격하지 않고, 발생도 3 tick 확인 뒤 알린다
    2026-09-03 16:33 실기: 앱 '알림 및 로그'에 위치추정이 [발생]/[해소]를 번갈아 20~40초
    간격으로 쌓였다. 로봇은 정상 주행이었다.
    실측: /odom 은 EKF 명목 30 Hz 인데 CPU 부하(1분 15~24, YOLO 구경 칸 85~94 %) 아래서
    정지 상태에도 24.2~24.9 Hz, 주행 중엔 잠깐씩 허용 하한 16 Hz(min 20×0.8) 아래로
    떨어졌다. 어댑터는 그때 WARN 을 냈다.
    번갈아 뜬 경로는 둘이었다.
    1) health_logic._build_fault 가 진단 등급이 아니라 부품 정책 등급(위치추정=STOP)을
    써서 "주기 조금 처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
    [test_config_contract.py, test_event_deduplicator.py, test_health_logic.py]
2026-09-03 fix(ekf): 회전(vyaw)을 바퀴 대신 자이로에만 맡긴다 [벤치·실기 전]
    복도 매핑 bag 에서 한 바퀴(정답 360°) 누적 회전이 자이로 +361.1° ·
    바퀴 +334.9° · EKF +343.8° 였다. EKF 가 바퀴의 7 % 과소를 따라가
    복도가 24 m 에 4° 씩 휘었다(두 회차 동일, 실측 폭은 같음). 바퀴
    과소는 모든 속도에서 나타나고 바닥에 따라 달라지므로 wheel_base 재조정
    대신 yaw 입력에서 바퀴를 뺀다. 직진·횡은 그대로 바퀴.
    판정: 제자리 10바퀴 벤치 3600°±5° → 매핑 1회 복도 휨 소멸.
    Claude-Session: https://claude.ai/code/sessi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
2026-09-03 docs(ekf): 자이로 단독 yaw 벤치 결과 — 9바퀴에서 EKF−자이로 −0.3° 합격
    제자리 회전 175초: 자이로 +3244.7°(9.01바퀴) · 바퀴 +3084.5°(−4.8 %) ·
    EKF +3244.5°. 바퀴 vyaw 를 뺀 뒤 EKF 가 자이로에 붙었다. 남은 검증은
    복도 매핑 1회에서 왼쪽 복도 휨(24 m 에 4°)이 사라지는지.
    Claude-Session: https://claude.ai/code/session_01XZ6KpJWeCFP6rXMJTaKWKA
2026-09-03 fix(localization): wheel_base_m 0.387 -> 0.37 재조정 [B안 벤치 전]
    제자리 회전 벤치 2회에서 바퀴가 자이로보다 4.6~4.8 % 덜 셌다.
    회전 = (우-좌)/wheel_base 라 0.387 이 그만큼 크다는 뜻이고,
    0.387 x 0.953 = 0.369 ≈ 옛 값 0.37. EKF 는 바퀴 회전을 포함한 원래
    설정 그대로 두고, A안(자이로 단독)과 같은 벤치로 비교한다.
    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
2026-09-03 docs(localization): B안 벤치 — 바퀴는 0.37 로 −0.6 % 정확, EKF 는 +111° 이탈
    5바퀴 벤치(bag yaw_bench_5L_B): 자이로 +1817° · 바퀴 +1806°(−0.6 %) ·
    EKF +1928°. wheel_base 0.37 은 이 바닥에서 맞는 값이지만, 바퀴 회전을
    EKF 에 넣으면 두 입력이 일치하는데도 EKF 가 70초 이후 앞서 나간다.
    원인 미규명. 같은 벤치에서 A안(자이로 단독)은 EKF−자이로 ±0.4°.
    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
2026-09-03 chore(localization): C안 구성 — 자이로 단독 yaw(EKF) + wheel_base 0.37
    A안(EKF 바퀴 vyaw 제외, 벤치 ±0.4°)에 B안 벤치에서 확인된 바퀴 제원
    교정(0.37, 바퀴−자이로 −0.6 %)을 얹는다. 바퀴 회전은 EKF 에 안 들어가지만
    /wheel/odom 자체는 정확해진다. 판정: 5바퀴 벤치 EKF−자이로 ±3° → 매핑 1회.
    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
2026-09-03 docs(localization): C안 벤치 합격 — EKF−자이로 −0.2°, 바퀴−자이로 −0.55 %
    5바퀴 벤치(bag yaw_bench_5L_C): 자이로 +1807.1° · 바퀴 +1797.1° · EKF
    +1806.9°. 자이로 단독 yaw + wheel_base 0.37 조합이 벤치를 통과했다.
    남은 검증은 복도 매핑 1회(왼쪽 복도 휨 소멸, 길이 66 m·단면 17.1 m).
    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
2026-09-04 fix(firmware): 서보 좌우를 반전한다 — 실물이 상수명과 일치하게 바뀌었다
    사용자가 실물에서 서보가 반대로 움직이는 것을 확인했다. LED 는 정상이다.
    2026-08-02 부터 이 자리에는 "서보가 거꾸로 장착돼 있으니 상수명과 반대로 부르는
    것이 정상이다. 건드리지 말 것"이라고 적혀 있었다. 그 전제가 더는 맞지 않아
    두 case 의 servoMoveTo 인자를 서로 맞바꾼다.
    STATE_LEFT SERVO_RIGHT -> SERVO_LEFT
    STATE_RIGHT SERVO_LEFT -> SERVO_RIGHT
    이제 상수명 그대로다. 뒤집힘이 사라진 이유(장착 방향 변경·서보 교체 등)는
    확인하지 않았다.
    **LED 줄(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
    [smart_handle_firmware.ino]
2026-09-04 feat(carto): 매핑 미리보기 JSON 에 로봇 자세를 동봉한다 — 앱 지도 위 화살표용
    매핑 중에는 AMCL 이 없어 /robot_status 의 위치가 /odom 좌표로 대체되고
    map_id 도 비어, 앱이 미리보기 위에 로봇을 그릴 길이 없었다(RViz 없이는
    어디를 그리는지 알 수 없다는 운영자 불편, 2026-09-04).
    - vica_2d.lua: publish_tracked_pose = true. map 프레임 기준 base_footprint
    자세를 /tracked_pose 로 낸다. SLAM 계산에는 관여하지 않는 노드 옵션.
    - map_preview_node: /tracked_pose 를 BEST_EFFORT depth 1 로 받아 저장만 하고,
    period_sec(2초)마다 나가는 JSON 에 robot_x·robot_y·robot_yaw(도, 반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
2026-09-04 feat(carto): 지도 이름을 한글로 받고 id 는 자동 생성한다 — 표시 이름은 meta.json 에만
    "사람이 읽는 이름"과 "기계가 쓰는 id"를 가른다. id 는 파일·yaml·URL·터미널에
    그대로 들어가므로 영문 규칙(^[A-Za-z0-9_-]+$)을 그대로 두고, 한글은 표시 이름으로만
    maps/<id>.meta.json 과 상태 JSON(map_name)에 싣는다. 지도를 쓰는 다른 노드는 한
    줄도 바뀌지 않는다.
    - plan_map_save: 영문 이름은 옛 규칙 그대로(lobby -> lobby_0904, 표시 이름도 id),
    그 밖은 표시 이름 + map_<MMDD>_<HHMMSS>. NFC 고정(macOS 자모 분해), 40자·경로
    문자 거부. normalise_map_name 은 그대로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
2026-09-04 feat(interfaces): RenameMap.srv — 지도 표시 이름만 바꾸는 서비스
    VICA_Supervisor 의 map_list_node 가 /rename_map 으로 처리한다. maps/<id>.meta.json
    의 display_name 만 바뀌고 파일·URL·목적지·금지구역(map_id 기준)은 그대로다.
    새 srv 라 vica_interfaces 는 다시 빌드해야 한다.
    Claude-Session: https://claude.ai/code/session_01434vSfgENuk2Kpo77exM2k
2026-09-05 feat(guidance): 손잡이 터치센서를 상향으로 올린다 (1단계)
    D10 에 정전식 터치센서가 붙었다. 설계는
    docs/superpowers/specs/2026-09-04-touch-sensor-integration-design.md 다.
    신호를 ROS 까지 올리는 데까지가 이번 범위다. 그 신호로 무엇을 할지(모드 진입
    3초·손 놓음 0.5초 판정, /vica/handle_mode)는 mission_manager 몫이라 2단계다.
    이 순서인 이유는 상위 계약이 이미 확정돼 있기 때문이다. vica-voice-llm 의
    src/handle_mode.py 가 전체 흐름과 멘트를 갖춰 두고 "터치센서가 미장착이라
    3초를 감지할 수단이 없다"며 대기 중이다. 음성 쪽은 만들어져 있고 신호만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
2026-09-05 feat(firmware): 진동모터를 수동 명령으로 울린다 — D10 은 터치센서가 아니라 햅틱이었다
    D10 에 붙은 것은 터치센서가 아니라 진동모터였다(사용자 정정). 7/28 계획서 6절이
    예정한 부품이며 MOSFET 드라이버·플라이백 다이오드 회로다. 진짜 터치센서는
    미장착이다.
    햅틱 수동 명령 두 개를 하향 프로토콜에 더한다. 상태코드(0~7)와 겹치지 않는 별도
    바이트라 applyState() 를 거치지 않는다 — LED·서보는 그대로이고 모터만 떨린다.
    0x10 150ms on/off x3 도착 패턴
    0x11 800ms x1 비상 패턴
    패턴은 계획서 6.2절 그대로다("비상제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
2026-09-05 tune(firmware): 햅틱 ON 시간을 두 배로 — 진동이 약하다
    사용자 판정 "좀 더 강하게". 디지털 핀은 ON 동안 이미 100% 라 세기를 올릴 손잡이는
    ON 시간뿐이다. ERM 진동모터는 회전이 올라오는 데 50~100ms 가 걸려서 150ms ON 은
    채 돌기도 전에 꺼진다.
    짧은 패턴 150 -> 300 ms ON (OFF 150 유지, 3회)
    긴 패턴 800 -> 1200 ms ON
    protocol.py·bench_test.py 의 문구를 같이 맞췄다.
    [미검증] 실물 체감은 사용자 확인 대기. 여전히 약하면 다음 손잡이는 하드웨어다 —
    MOSFET 게이트 전압(로직레벨 여부)·모터 전원 전압·직렬 저항.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
2026-09-05 feat(guidance): 주행 중 햅틱을 토픽으로 수동 트리거한다 — /vica/haptic_request
    사용자 요구: "주행 중 원하는 타이밍에 명령으로 진동 울리기". 터치센서는 보류.
    주행 중에는 user_guidance_driver_node 가 시리얼 포트를 잡고 있어 bench_test.py
    --haptic 이 못 붙는다. 억지로 열면 DTR 토글로 나노가 리셋돼 LED·서보가 잠깐
    죽는다. 그래서 떠 있는 노드를 거친다.
    /vica/haptic_request std_msgs/String "short" | "long"
    → 0x10 / 0x11 한 바이트를 10 Hz 상태코드 사이에 끼워 보낸다
    주행 중: ros2 topic pub --once /vica/haptic_request std_msgs/String "{data: long}"
    bench 중: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
    [serial_link.py, test_launch_contract.py, user_guidance_driver_node.py]
2026-09-05 revert(guidance): 터치센서 ROS 연동을 걷어내고 햅틱 토픽만 남긴다
    실기: 스마트핸들 노드를 띄우자 빨간불(LINK_LOST) + 연동 불가. 원인은 노드 사망.
    AttributeError: 'UserGuidanceDriverNode' object has no attribute 'touch_contact'
    in diag_loop
    touch_enabled=false 로 끄면 _setup_touch() 를 건너뛰는데 diag_loop 가 거기서만
    만들어지는 touch_contact 를 읽었다. 첫 진단 tick(0.5초)에 죽고 → 펌웨어 워치독
    1.5초 → 빨간불. 780f720 을 노드로 실제 띄워보지 않고 넘긴 탓이다.
    사용자 결정: 터치센서는 보류(오늘 작업 불가). **터치는 원상복구, 햅틱 토픽만 유지.**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
    [protocol.py, touch_frame.py, user_guidance.yaml, user_guidance_driver_node.py]
2026-09-05 feat(guidance): 터치센서 1단계 재도입 — active-low·시간 브리지, 노드 사망 결함 수정
    2026-09-05 인수인계 문서로 바로잡은 사실 위에 다시 올린다.
    핀 D11 (D10 은 진동모터)
    극성 idle HIGH / 터치 LOW — 09-04 의 "잡으면 HIGH" 는 반대였다
    신호 터치 중 출력이 LOW/HIGH 로 빠르게 튄다. idle 은 994회 측정에 흔들림 0
    펌웨어
    - INPUT_PULLUP + LOW=잡음. 풀업이라 OUT 선이 빠지면 HIGH 로 떠서 '놓음'이 된다
    (단선 = 놓음). 07-30 결정의 NC fail-safe 가 그대로 성립한다.
    - 디바운스 -> 시간 브리지. 마지막으로 LOW 를 본 시각 하나만 기억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
    [protocol.py, smart_handle_firmware.ino, test_launch_contract.py, touch_frame.py, user_guidance.yaml, user_guidance_driver_node.py]
2026-09-05 config(guidance): 터치센서를 끈다 — touch_enabled false (09-05 실기, 센서 하드웨어 미확정)
    실기에서 손잡이를 잡아도 user_contact 가 뒤집히지 않았다. 노드 없이 시리얼을
    직접 관찰해도 2,400 프레임 중 D11 이 LOW 인 적이 0 — 노드·파서·펌웨어는 무죄,
    센서 부품·배선 쪽이다(금속선만 있고 모듈이 없을 가능성). true 로 두면
    "센서는 살아 있는데 손이 없다"로 보여 2단계가 헷갈리므로 false 로 확정한다.
    정식 터치 모듈을 D11 에 달고 LOW 가 보이면 이 한 줄만 true 로 되돌린다.
    Claude-Session: https://c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
2026-09-07 fix(guidance,localization): TF 공백에 Nav2 가 죽지 않게 한다 — 초음파 발행 게이트·엔코더 respawn
    2026-09-07 실기에서 규명한 사슬을 두 곳에서 끊는다. 모터 노드를 껐다 켜는
    사이 /wheel/odom 이 34 초 끊겼고, 그동안 Nav2 의 RangeSensorLayer 가
    odom -> usonic_* 조회 예외를 미포착으로 흘려 controller_server 가 SIGABRT 로
    죽었다(크래시 덤프 스택으로 확인). 그 뒤 Nav2 가 goal 을 전량 거부해
    사람접근이 track_suppressed 로 막혔고, 회전 안내·AMCL·detector 도 함께 무너졌다.
    - range_tf_gate(신설): TF 가 없는 채널은 Range 를 발행하지 않는다. 메시지가
    없으면 upd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
    [range_tf_gate.py, user_guidance_driver_node.py]
2026-09-09 feat(perception): 접근 거리 범위를 파라미터로 뺀다 — 기본값은 그대로 1.5~4.0 m
    상한 4.0 m 가 상수로 박혀 있어 "얼마나 먼 데까지 접근하게 할 것인가" 를 실기에서
    비교할 수 없었다. 값은 그대로 두고 밖에서 바꿀 수 있게만 한다.
    approach_min_distance_m 기본 1.5 (DEFAULT_MIN_DISTANCE_M)
    approach_max_distance_m 기본 4.0 (DEFAULT_MAX_DISTANCE_M)
    아무것도 안 주면 종전과 완전히 같다. 잘못된 범위(하한 >= 상한)는 GateThresholds
    의 __post_init__ 이 기동 때 예외로 막으므로 조용히 틀리지 않는다.
    기동 로그에 실제 적용값을 찍는다 — 실기에서 "지금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
2026-09-09 feat(perception): 사람 접근 상한을 4.0 -> 8.0 m 로 올린다 (2026-09-09 실기 판정)
    3 m 앞까지 와야 로봇이 반응하는 것이 실제 이용자에게 너무 늦다는 사용자 판정이다.
    체감 거리와 로봇이 재는 거리가 1~1.5 m 어긋나기 때문에, 상한 4.0 m 는 실제로는
    **체감 3 m** 에서만 접근이 걸렸다(같은 날 여러 차례 확인).
    체감 4 m -> 로봇 4.8~5.0 m
    체감 5 m -> 로봇 6.0 m
    체감 6 m -> 로봇 7.0~7.5 m
    체감 7 m -> 로봇 8 m 초과
    어느 쪽이 맞는지는 사람 키로 독립 계산해 갈랐다: 1.7 m x fy 379.2 / 화면 134 px
    = 4.81 m 이고 depth 측정은 4.97 m 였다. 카메라와 무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
2026-09-09 feat(sensor_adapters): IMU base_link 어댑터를 C++ 로 옮긴다 — 25.2% -> 3.8%
    D455 자이로는 200Hz 가 하드웨어 최저(200/400 만 지원)라 입력을 줄일 수 없는데,
    파이썬은 그 194Hz 를 **받기만 해도 16.4%** 를 쓴다. 2026-09-09 확인 실험에서
    같은 조건 C++ 는 0.0% 였다(아무 계산 없이 합산만 하는 최소 노드로 대조).
    그 탓에 EKF 가 설정 30Hz 를 못 지키고 9.6Hz 로 절뚝였고, 그 여유 부족이 9/7
    TF 공백 사고를 키웠다(load 20.69 에서 TF 완전 정지 -> controller_server 사망,
    13.65 에서는 최대 공백 2.29 초로 무사).
    옮기면서 계약은 한 줄도 바꾸지 않았다.
    - gyro_bias: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
2026-09-09 feat(mission): 사람 접근 속도 상한을 파라미터로 뺀다 — 기본값은 그대로 60 %
    2026-09-09 실측에서 접근이 느린 원인을 이 값으로 특정했다. 7.77 m 접근에 19.6 초가
    걸렸는데, 속도가 깎이는 곳을 전 구간에서 확인해 보니 요청·승인·실제 바퀴가
    0.300 / 0.300 / 0.40 으로 **일치**했다 — 즉 어디서 막힌 것이 아니라 처음부터
    0.5 x 60 % = 0.30 m/s 로 허락된 만큼만 가고 있었다.
    knob(당시 35 %)도 Nav2 도 범인이 아니었다. 좁은 문이 이 값 하나였다.
    감지~1.1 m 이 값이 정한다 (60 % = 0.30 m/s)
    마지막 1.1 m collision_monitor 가 (40 % = 0.12 m/s,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
2026-09-09 feat(mission): 접근 속도 상한을 launch 인자로도 받는다
    노드 파라미터로만 빼 두면 실기에서 값을 바꿀 길이 없다 — ros2 launch 는
    --ros-args 를 받지 않기 때문이다(2026-09-09 실기에서 그 명령을 안내했다가 에러).
    ros2 launch vica_mission_manager mission_manager.launch.py \
    person_approach_speed_percent:=100.0
    기본값 60.0 은 그대로다.
    Claude-Session: https://claude.ai/code/session_01GXJDPemN2hkP8moEe7VmrC
2026-09-09 feat(mission): 사람 접근 속도를 60 % -> 100 % 로 올린다 (2026-09-09 실기 판정)
    접근 거리를 4 m 에서 8 m 로 늘리면서 도착까지 19.6 초가 걸렸고, 종전 상한 4.0 의
    근거였던 "10초 이내" 를 지킬 수 없게 됐다. 원인을 구간별로 재보니 속도가 깎이는
    곳이 한 군데도 없었다 — 요청·승인·실제 바퀴가 0.300 / 0.300 / 0.40 으로 일치했다.
    즉 어디서 막힌 것이 아니라 처음부터 이 값(0.5 x 60 %)만큼만 허락된 것이었다.
    knob 도 Nav2 도 범인이 아니었다. 당시 knob 35 % 였는데 접근 상한 0.30 이 그보다
    낮아 걸리지도 않았고, 뒤에 98 % 로 올려도 접근 속도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
2026-09-09 feat(motor): 속도 조절 줄의 실제 구간을 0~100 으로 편다 (knob_min/max_pct)
    2026-09-09 실기에서 "줄을 당겨도 속도가 안 준다" 는 것을 확인하고 원인을 잡았다.
    줄이 실제로 움직이는 knob 구간이 **55~98** 인데 코드는 0~100 으로 해석해, 눈금의
    가운데 43 % 만 쓰고 있었다. 그래서 줄이 아무 역할도 못 했다:
    완전히 당겨도 55 % -> 정지 기준(deadzone 5 %)에 한참 못 미쳐 서지 않는다
    조금 놓으면 60~98 % -> 전부 주행 상한 0.5 m/s 위라 속도가 변하지 않는다
    다이얼 자체는 멀쩡했다(25초 관찰: 54~98 사이를 부드럽게 오감). 값이 아니라 **해석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
2026-09-09 feat(motor): 이 로봇의 줄 구간(55~98)을 launch 기본값으로 준다
    노드 기본값은 (0, 100) 이라 아무것도 바꾸지 않는다 — 종전 동작을 지키기 위한
    값이다. 이 장비에서 실제로 쓰려면 값을 줘야 하는데, motor_bringup.launch.py 에
    인자 선언이 없어 줄 방법이 없었다(2026-09-09 실기에서 실행 실패).
    knob_min_pct 55
    knob_max_pct 98
    바꾸려면 launch 인자로 준다. 줄이나 연결부를 고쳐 실제로 0~100 이 나오게 되면
    두 값을 0, 100 으로 되돌린다.
    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
2026-09-10 feat(mission): 마이크 방향을 제자리 회전량으로 바꾼다
    DOA 는 0~359 도이고 SpinInPlace 는 양수가 반시계다. 270 도를 왼쪽으로
    270 도 돌지 않고 오른쪽으로 90 도 돌도록 -파이~파이 로 접는다.
    sign 은 마이크 각도 증가 방향이라 장비마다 실측으로 정한다.
    Claude-Session: https://claude.ai/code/session_011taY6SXMXEdCF6mmSxbQsT
2026-09-10 feat(mission): 대기 중 호출 방향으로 고개를 돌린다 (SEEKING)
    마이크는 거리를 모르고 각도도 오차가 커서 소리로 목표점을 만들지 않는다.
    돌아서 카메라가 확인한 뒤에야 기존 접근 경로가 이어받는다.
    안내 중 호출은 열지 않는다 — 그것은 지금 안내받는 사용자의 명령이다.
    정면(10도 미만)이면 돌지 않고 찾는 창만 연다.
    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
2026-09-10 fix(mission): SEEKING 중 목적지 요청도 접근 상태와 같이 거부한다
    _APPROACH_STATES 에 SEEKING 이 빠져 있어 회전 중 음성 목적지 명령이
    그대로 통과했다. Navigate 가 나가면서 진행 중인 SpinInPlace 를
    취소하지 않아 두 goal 이 동시에 /cmd_vel_req 로 나가는 결함이었다
    (리뷰 라운드 1 결함 1). TURNING 과 같은 처리로 맞추고, 기존
    MSG_APPROACH_BUSY 멘트를 그대로 쓴다 — 새 멘트 없음.
    _GOAL_ACTIVE_STATES 설명 주석도 SEEKING 을 반영해 갱신한다(지적 2).
    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
2026-09-10 feat(mission): 고개를 돌린 뒤 찾는 창을 열고, 없으면 조용히 되돌아간다
    회전이 끝나면 IDLE 로 내려놓는다. 접근 관문이 IDLE 만 통과시키므로 관문을
    건드리지 않고 기존 접근 경로에 합류할 수 있다.
    사람을 못 찾으면 말없이 원래 각도로 돌아간다. 안 되돌리면 오작동 한 번에
    카메라가 벽만 보는 자세로 굳는다. 복도 소음 오인에 말을 걸면 주변을
    놀래키므로 멘트는 없다.
    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
2026-09-10 feat(mission): /vica/wake_doa 를 받아 SEEKING 을 연다
    마이크 각도 증가 방향(wake_doa_sign)은 장비 실측값이라 파라미터로 뺐다.
    회전 중에는 is_moving 을 세워 YOLO 추론을 멈춘다 — 화면이 통째로 흐르는
    동안의 탐지는 변위 관문에 어차피 걸려 버려진다.
    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
2026-09-10 fix(mission): wake 소비 직후의 wake_doa 를 시각으로 거절한다 (C1)
    /vica/wake 와 /vica/wake_doa 는 같은 콜백 그룹이라 wake 가 먼저 상태를
    IDLE 로 내린다. 그 직후 도착하는 wake_doa 를 state == IDLE 만으로 통과시키면
    "옛 대화를 접었을 뿐"인 wake 소비를 새 호출로 오인해 SEEKING 이 열린다 —
    사용자가 핸들을 잡고 로봇 뒤(WAITING/ASKING_NEXT 등)에 서 있을 때 "비카야"
    한마디에 최대 180도 제자리 회전이 터지는 사고.
    on_wake·on_return_brake 가 실제로 상태를 바꿨을 때만 소비 시각을 기록하고
    (_wake_consumed_at), on_wake_doa 가 그 직후 WAKE_CONSUMED_GUARD_SEC(2.0초)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
2026-09-10 fix(mission): 탐색 창·회전 goal 이 상태 청산 경로 두 곳에서 안 끊긴다 (I1, I2)
    I1: _seek_deadline/_seek_return_yaw 를 비우는 곳은 _to_idle() 하나뿐인데,
    IDLE 로 가는 길 중 두 곳이 그걸 안 거친다 — on_intent 의 확정 navigate
    시작 블록과 exit_arrival_dialog. 탐색 창이 열린 채로 이 길을 타면 안내
    한 판이 통째로 끝난 뒤 IDLE 에서 낡은 복귀각으로 갑자기 도는 사고가 난다.
    두 곳 모두에서 두 필드를 비운다.
    I2: _force_clear_all(앱 선점·전체 취소)이 CancelNav 를 내는 조건이 등록
    목적지 상태(NAVIGATING/APPROACHING/RETURNING)로 좁게 걸려 있었다. SEEKING
    (제자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
2026-09-10 feat(launch): wake_doa_sign·seek_look_sec 를 launch 인자로 노출한다 (I3)
    두 파라미터가 노드에는 있는데 DeclareLaunchArgument 가 없어 표준 기동
    경로로는 값을 넣을 수 없었다. 기존 인자들과 같은 패턴(ParameterValue +
    value_type)으로 노출한다.
    wake_doa_sign 실측값 +1.0 을 근거와 함께 주석에 남긴다(2026-09-10, 사용자와
    2회 걷기 측정 — 로봇을 마주 보고 오른쪽으로 이동 시 마이크 각도가 0°에서
    119°로 증가, 반시계 증가로 Nav2 규약과 같은 부호). 기본값 1.0 은 그대로 둔다.
    seek_look_sec 기본값은 8.0(mission_logic.SEEK_LOOK_SEC 과 같은 근거, I6).
    Co-Authored-By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
2026-09-10 fix(mission): wake_doa 무판정 로그를 항상 남기고 창 시간을 재검토한다 (I4, I6)
    I4: /vica/wake_doa 를 받고도 아무 일을 안 한 4가지 경우(10도 미만이라
    회전 생략·IDLE 아님·E-stop·nav 미준비, 여기에 C1 의 방금 wake 소비 직후
    까지 더해 5가지)가 전부 무로그였다. 실기에서 "로봇이 안 돌았다"의 원인을
    부호 오류/관문 거절/사각지대 중 무엇인지 가릴 수 없었다. 수신 DOA·계산된
    yaw·판정을 한 줄로 항상 남긴다. 멘트가 아니라 로그이므로 멘트 최소주의와
    무관하다.
    I6: SEEK_LOOK_SEC=6.0 의 근거 주석이 "stable 1.0s + still window 3.0s"만
    계산했는데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
2026-09-10 docs(mission): 운영 코드 주석의 절차 참조를 파일 관례로 바꾼다 (M2, M3)
    M2: "리뷰 라운드 1 결함 1" 은 이 저장소 밖에서는 무엇인지 알 수 없는 내부
    절차 참조다. 이 파일의 관례(설계 N절·날짜)로 바꾼다 — 운영 코드 주석과
    그 결함을 재현하는 시험 docstring 둘 다.
    M3: _APPROACH_STATES 분기의 인라인 주석이 "접근·질문·복귀 중에는"이라
    TURNING·SEEKING 을 안 적는다. 이 튜플을 의심하는 사람이 가장 먼저 읽는
    줄이라, 둘을 넣고 왜 필요한지(진행 중인 SpinInPlace 취소 없이 Navigate 가
    나가는 사고 방지)도 함께 적는다.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
2026-09-10 test(mission): 복귀 회전 시험 2건을 보강한다 (M4, M5)
    M5: test_calling_again_accumulates_the_way_back 가 상태·필드만 보고 두 번째
    SpinInPlace 발행 자체는 확인하지 않았다 — 액션이 안 나가도 통과해버린다.
    반환 액션에서 SpinInPlace 를 직접 단언하도록 고친다.
    M4: "복귀 회전도 10도 미만이면 생략한다"(설계 5요점) 시험이 0건이었다.
    설계 5요점 중 유일한 무보험 분기이며, 회귀하면 사람 옆에서 5도짜리 잔여
    회전이 튀어나온다. 정면 근처 호출 2회(각 10도 미만, 누적도 10도 미만) 뒤
    창 만료에 SpinInPlace 가 없는지 확인하는 시험을 추가한다.
    C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
2026-09-10 feat(mission): 접근 온보딩 직후 60초간 wake_doa 를 거절한다
    접근 회전이 끝나 사용자가 손잡이를 받아든 직후는 wake 가 아니라 회전
    완료가 상태를 IDLE 로 내린 것이라 기존 _wake_consumed_at 도장이 안 찍힌다.
    재청취 창이 만료된 뒤 "비카야, 화장실"처럼 부르면 DOA≈180(핸들 쪽)이
    그대로 SEEKING 을 열어, 손잡이를 잡고 로봇 옆에 선 사용자 앞에서 최대
    180도 제자리 회전이 재현된다(2026-09-10 사용자 결정).
    on_tick 의 TURNING 분기(회전 성공·실패 둘 다)에서 _user_attached_until 을
    now + USER_ATTACHED_SUPPRESS_SEC(60초, REAPPROACH_SUPPRESS_SEC 와 같은 값)
    로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
2026-09-10 fix(mission): wake_doa 진단 로그 순서를 실제 관문과 맞추고 가드를 3초로
    _on_wake_doa 의 판정 문자열이 "10도 미만" 을 시각 관문(_wake_consumed_at·
    _user_attached_until)보다 먼저 확인하고 있었다. 그 결과 시각 관문이
    실제로 거절했는데 yaw 가 우연히 10도 미만이면 로그가 "생략(10도 미만,
    창만 유지)" 로 찍혀 창이 열린 것처럼 보였다 — 실제로는 열리지도 않았다.
    이 로그는 실기에서 "로봇이 안 돌았다"의 원인(부호 오류·관문 거절·
    사각지대)을 가릴 유일한 단서라 순서가 맞아야 계측기 노릇을 한다.
    on_wake_doa 안의 실제 순서(state/estop/na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
2026-09-10 test(mission): on_return_brake·AWAITING_USER 의 wake_doa 도장을 검증한다
    on_return_brake 가 찍는 _wake_consumed_at 도장을 부르는 시험이 이제까지
    없었다 — 그 도장 한 줄을 지워도 기존 시험이 전부 통과했다(리뷰 지적).
    그 줄은 복귀 중 "비카야" 직후의 wake_doa 를 막는 유일한 장치이고 취소
    경합까지 딸려 있다. AWAITING_USER(사람 1.1m 앞에서 질문 대기 중)도
    같은 사각지대였다.
    각각 도장 줄을 임시로 지우고 새 시험이 실제로 빨개지는 것을 확인한 뒤
    되돌렸다 — 지우고도 통과하면 아무것도 안 지키는 시험이기 때문이다.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
2026-09-10 docs(mission): 주석에 남은 절차 참조("C1")를 현상 서술로 바꾼다
    자기 검토에서 발견 — WAKE_CONSUMED_GUARD_SEC 주석과 새 시험 docstring
    에 "C1" 이 남아 있었다. 이 저장소 관례는 코드 주석에 절차 라벨 대신
    증상을 그대로 적는 것이다. 뜻은 그대로 두고 표현만 고쳤다.
    Claude-Session: https://claude.ai/code/session_01YE5j95Z2JJ8NQVaiXeoDmR
2026-09-10 fix(mission): 회전량 0 지름길에도 접근 온보딩 억제를 건다
    on_approach_answer 의 approach_turn_yaw_rad == 0.0 지름길은 State.TURNING
    을 거치지 않고 곧장 온보딩으로 가 on_tick 의 도장 두 곳에 안 닿았다.
    회전을 껐어도 사용자는 이미 승낙하고 그 자리에 있으므로 회전 여부와
    무관하게 같은 억제가 필요하다. 지금 기본값(180도)에서는 안 타는 길이지만
    그 파라미터를 0으로 두면(좁은 곳 등) 억제 없이 사고 조건이 조용히
    되살아난다.
    시험 1건 추가: approach_turn_yaw_rad=0.0 으로 접근 승낙 → 곧바로
    on_wake_doa → SpinInPlace 부재. 도장 줄을 지우면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
2026-09-10 fix(mission): 제자리 회전 로그에 용도를 실어 세 회전을 가른다
    지금 제자리 회전은 세 종류다: 수락 뒤 핸들 내주기(180도), 호출 방향 보기,
    못 찾아 원위치로. 셋이 같은 문구로 찍혀서 실기에서 "왜 돌았는지"를 사후에
    가릴 수 없었다.
    특히 호출 회전과 그 8초 뒤의 원위치 회전은 밖에서 보면 "부르지도 않았는데
    또 돌았다"로 보인다. 2026-09-10 실기에서 실제로 그 관찰이 나왔다.
    각도를 도(度)로 함께 찍는다 — 라디안만으로는 어느 쪽으로 얼마나 돌았는지
    현장에서 읽기 어렵다.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
2026-09-10 feat(mission): 코앞 호출은 걸어가지 않고 바로 질문한다 (근접 호출)
    detection_gate 가 TOO_NEAR(1.5 m 안)로 거절해도 stable=true·approachable=false
    결과는 이미 /vica/person_detection 에 발행되고 있었다. 그 값을 안 써서 탐색
    창(8초) 동안 사람을 보면서도 말없이 원위치로 돌아가는 문제를 고친다.
    mission_logic.on_person_detection 을 새로 추가해 탐색 창(IDLE +
    _seek_deadline) 중에만 이 결과를 본다. 1.0~1.5 m 는 걸어가지 않고 질문 후
    수락 시 정상 회전, 1.0 m 미만은 회전까지 생략한다 — 손잡이가 뒤로 길게 나와
    있어 코앞에서 180도를 돌면 사람을 칠 수 있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
2026-09-10 feat(mission): 복귀 중 호출로 끊기면 무응답 뒤 스스로 복귀를 재개한다
    홈 복귀 중 "비카야"로 브레이크가 걸리면 IDLE 에서 무기한 멈춰 있었다
    (재개 타이머가 없었다). 15초 침묵하면 떠나기 예고(MSG_LEAVING_NOTICE
    재사용), 3초 유예(LEAVING_GRACE_SEC 재사용) 뒤 복귀를 다시 낸다.
    "복귀가 끊겨 있다"는 사실(_return_interrupted)과 "언제 재개할지"
    (_return_resume_deadline)를 필드로 나눴다 — 탐색 회전(SEEKING)이
    끼어들어도 사실은 _to_idle() 을 거치며 살아남고, 시각은 회전이 끝나
    IDLE 로 돌아온 시점 기준으로 새로 잡는다(호출 시각부터 누적하지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
2026-09-10 fix(mission): 복귀 사다리 대기 중에는 호출 회전을 아예 거절한다
    리뷰 수정 라운드 1. 회전 왕복(최대 16초)에 사다리 재대기(18초)가 겹치면
    오탐 한 번이 30초 넘게 로봇을 통행로에 붙잡을 수 있다는 판단으로,
    _return_interrupted 가 살아 있는 동안은 on_wake_doa 를 통째로 거절한다.
    같은 관문이 무회전 분기(정면 호출)가 _to_idle() 을 안 거치고 탐색 창만
    열어 사다리와 겹치던 결함도 뿌리에서 없앤다 — 재현 시나리오를 시험으로
    남겼다.
    기존 시험 하나(회전이 끼어들어도 결국 재개된다)는 이제 회전이 거절되는
    쪽으로 뜻을 바꿨다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
2026-09-10 feat(mission): 핸들 쪽(뒤 180도±45도) 호출은 회전 없이 곧바로 접근 질문한다
    핸들이 로봇 뒤에 있어, 뒤에서 "비카야"로 부르면 회전해 사람을 보는 순간
    핸들을 사람 반대편으로 빼앗아 갔다(2026-09-10 실기 관찰). 소리가 핸들
    부채꼴(180도±45도)에서 왔다는 사실 자체가 "이미 핸들 옆에 서 있다"는
    증거이므로 카메라 확인 없이 곧바로 질문한다.
    - HANDLE_SIDE_MIN_YAW_RAD(135도) 추가: 정면 사각지대 SEEK_MIN_YAW_RAD의
    거울쌍. on_wake_doa 의 같은 층(yaw 계산 뒤, SEEKING 진입 전)에 놓았다.
    - 새 대화는 approach_track_id 가 없다 — _suppress_track 이 이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
2026-09-10 feat(mission): 안내를 수락하면 손잡이 위치를 말하고 손잡이를 진동시킨다
    시각장애인은 로봇이 돌았는지, 손잡이가 어느 쪽인지 알 방법이 없어 실기에서
    손잡이를 더듬어 찾는 상황이 반복됐다(2026-09-10). 수락 직후·온보딩 직전에
    "손잡이는 지금 계신 쪽에 있습니다. 진동이 나는 곳을 잡아주세요." 를 말하고
    같은 순간 /vica/haptic_request 로 long 을 낸다.
    온보딩이 나가는 세 자리(회전 생략·회전 성공·회전 실패) 전부에 넣었다.
    회전 실패가 가장 중요하다 — 손잡이가 어긋난 채 남아 가장 헤매는 사용자다.
    거절에는 안내도 진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
2026-09-11 fix(mission): 핸들 쪽 호출의 형제 wake 가 같은 호출의 질문을 접지 못하게 한다
    on_wake_doa 가 먼저 처리돼 핸들 쪽(180°±45°) 질문을 연 경우, 같은 호출의
    형제 신호인 /vica/wake 가 수 ms 뒤 뒤따라 오면 on_wake 의 AWAITING_USER
    분기가 이를 "옛 대화"로 오인해 접었다 — 2026-09-11 오전 실기 5회 연속
    재현. C1(wake 먼저 도착)의 거울상이라 같은 _wake_consumed_at 도장을
    반대 방향으로 쓴다: on_wake_doa 의 핸들 쪽 분기가 도장을 찍고, on_wake 의
    AWAITING_USER 분기 맨 앞에서 도장이 3초 이내면 접지 않고 그대로 둔다.
    3초가 지난 뒤의 진짜 "비카야"와, 정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
2026-09-11 fix(mission): 뒤쪽 호출로 연 질문의 거절·무응답을 제자리에서 끝낸다
    핸들 쪽(로봇 뒤 180°±45°) 호출은 사람이 이미 손잡이 자리에 서 있고
    로봇이 걸어간 적이 없다. 이 상태의 거절·무응답이 기존처럼 복귀 주행
    (_enter_returning)으로 새면, 출발 회전(rotate-to-heading)이 손잡이로
    그 사람을 훑는다 — auto_return_home 기본 설정에서 실기 없이도 발견되는
    안전 결함이다. on_wake_doa 의 핸들 쪽 분기에서 세우는 _never_approached
    로 갈라, 거절·무응답 모두 멘트는 그대로 내고 _to_idle() 로 끝낸다(홈
    미지정일 때의 기존 동작과 같은 모양). 정상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
2026-09-11 docs(user_guidance): haptic_request 주석을 실제 발행자에 맞춘다
    미션 매니저가 손잡이 안내 시점에 /vica/haptic_request 를 자동 발행하게
    됐는데(affb594) protocol.py 와 user_guidance_driver_node.py 는 여전히
    "수동 전용"이라 적어 계약을 잘못 말하고 있었다. 드라이버 노드 자체가
    스스로 보내지 않는다는 사실은 그대로 남기고, 자동 발행자가 생겼다는
    사실만 덧붙인다. 겸사겸사 HAPTIC_CMD_LONG 의 "비상 패턴" 주석에 손잡이
    안내가 같은 패턴을 재사용하기로 한 사용자 결정을 남긴다 — 나중에 진짜
    비상 진동을 붙일 때 패턴 구분 문제가 생길 수 있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
2026-09-11 docs(mission): Action Union·wake_doa 판정 순서 주석을 코드에 맞춘다
    M-2: Action Union 에 SpinInPlace·StopSpeech 가 빠져 있던 기존 결함을
    고친다 — Haptic 을 넣으면서 목록이 정본처럼 보이게 됐으니 나머지 액션
    타입도 채운다.
    M-4: _on_wake_doa 의 판정 순서 서술이 실제 elif 체인과 달랐다. 코드는
    결과(회전 시작·핸들 쪽 전이)를 먼저 보고 못 맞히면 그제서야 개별 관문을
    순서대로 되짚는데, 주석은 관문 순서가 그대로 결과 판정 순서인 것처럼
    적어 "10도 미만"과 "180도 근방"의 순서가 코드와 반대였다. 글을 코드에
    맞춘다.
2026-09-11 fix(mission): 온보딩 멘트에서 인사말을 뺀다
    MSG_APPROACH_ONBOARDING 앞의 "안녕하세요? 반갑습니다! "를 없앤다(사용자
    승인 문구, 2026-09-11) — 접근 질문(MSG_APPROACH_QUESTION)에서 이미 인사를
    했으니 온보딩에서 또 하면 중복이다. 나머지 문구("비카야"로 불러 달라는
    안내·목적지 질문)는 그대로다.
2026-09-11 Revert "fix(mission): 온보딩 멘트에서 인사말을 뺀다"
    This reverts commit 61c1ac541001fe466f7bc9d4a41a91f99ed0c3f7.
2026-09-11 fix(mission): 손잡이 진동을 힌트 재생이 끝난 시점에 낸다
    Haptic 을 Say(MSG_HANDLE_HINT) 와 같은 자리에서 그 즉시 내보내면, 노드가
    /vica/haptic_request 로 바로 발행하는 반면 TTS 는 앞선 큐(이전 멘트·LLM
    응답)를 다 비운 뒤에야 재생된다. HAPTIC_CMD_LONG 은 1200ms 한 번뿐이라
    사용자가 "진동이 나는 곳을 잡아주세요"를 들을 즈음엔 진동이 이미 멎어
    있었다(I-2).
    on_approach_question_spoken 이 쓰던 것과 같은 모양으로 판다: 상태기계는
    힌트를 낼 때 _pending_handle_hint 만 세우고 Haptic 은 만들지 않는다.
    새 on_handle_hint_spoken(now) 가 그 표시를 보고서야 H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
2026-09-11 fix(mission): 뒤쪽 호출의 거절·무응답도 다른 접근과 같이 홈 복귀로 통일한다
    b149c93 을 되돌린다. 뒤쪽(핸들 쪽) 호출로 연 질문의 거절·무응답만 제자리에서
    끝내던 예외를 걷어내고, 정면·옆·근접 호출과 같은 복귀 주행(_enter_returning)
    을 탄다 — 홈이 있고 auto_return_home 이면 Navigate(홈), 없으면 제자리.
    "뒤쪽만 다르게"를 두지 않고 한 가지 동작으로 통일하자는 사용자 결정
    (2026-09-11 실기 중)이다.
    b149c93 이 적은 위험(뒤에 선 사람을 출발 회전의 손잡이가 훑을 수 있음,
    costmap 이 사람을 막아 goal 실패·collision_monitor 정지 가능)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
2026-09-11 feat(mission): 온보딩 뒤 빈손이면 한 번 되묻고 홈으로 돌아간다
    실기 2026-09-11: 온보딩("자, 이제 어디로 가고 싶으신가요?")을 말한 뒤
    mission_logic 은 IDLE 로 내려가 아무 시계도 걸지 않았다. 음성 노드가 15초
    창을 열었는데 사용자 말이 너무 짧거나 조용해 STT 가 기각하면
    /vica/listen_state 로 "empty:ghost"/"empty:short-reject" 같은 상태만 내고
    아무 말 없이 닫혔다 — 시각장애인은 말을 했는데 로봇이 침묵하고, 다시
    "비카야"를 불러야 한다는 것을 알 길이 없었다.
    도착 후 대화의 무응답 사다리(MSG_ARRIVAL_RETRY/_arrival_retried, 복귀
    재개 사다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
2026-09-11 fix(mission): 뒤쪽 호출의 거절·무응답을 다시 제자리에서 끝낸다 (사용자 재결정)
    1378f8c 를 되돌려 b149c93 의 동작을 복원한다. 실기(2026-09-11 15:40)에서
    사용자가 다시 정했다: 뒤쪽(핸들 쪽) 호출은 로봇이 대개 홈에서 응대하므로
    거절·무응답 뒤 굳이 홈 복귀 주행을 걸 이유가 없고, 뒤에 선 사람 옆에서
    출발 회전을 하지 않는 편이 낫다. 정면·옆·근접 호출의 거절·무응답은 기존대로
    복귀 주행이다. 온보딩 뒤 되묻기 사다리(e7b938c)의 마지막 홈 복귀는 그대로
    둔다 — 이미 수락한 뒤의 무응답이라 성격이 다르고, 홈이면 움직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
2026-09-11 fix(mission): 온보딩 되묻기 사다리의 시계를 멘트 재생이 끝난 시점부터 15초로 잰다
    실기(2026-09-11 15:32~15:48)에서 사다리 한 판이 76~95초 걸렸다. 두 원인:
    ① 질문 뒤 음성 청취 창은 30초(확인 질문용 CONFIRM_WINDOW_SEC)라 빈손 신호를
    기다리면 한 단이 30초, ② 미션의 40초 폴백이 그 창보다 먼저 울려 신호 대신
    시계로 움직였다. 사용자 결정: "15초 → 되묻기 → 15초 → 예고 → 3초".
    접근 질문의 8초와 같은 방식으로 노드가 tts_done 문구 대조(온보딩·되묻기)로
    재생 종료를 알리고(on_dest_prompt_spoken), 그 시점 + DEST_ANSWER_WAIT_SEC(15)
    에 전진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
2026-09-11 fix(mission): 회전 뒤 사람 찾는 창을 8초에서 6초로 줄인다
    사용자 결정(2026-09-11 실기): 정면·측면 호출로 돌아선 뒤 8초를 기다리는
    것이 길다 — 사람이 없을 때(오탐·미검출)만 체감되는 시간이고 그동안 다음
    "비카야"가 쌓인다. 오늘 실기 11회에서 회전 종료→사람 확인은 1.5~4.0초
    (최대 4.0)였다. 6초는 실측 최댓값에 2초 여유로, 프레임 간격 리셋 한 번을
    견딘다. launch seek_look_sec 기본값도 6.0.
    Claude-Session: https://claude.ai/code/session_01X6TuVrkmpyHJ1PHDZyaUEf
2026-09-16 fix(nav2): 초기 위치 점수 미달 문구를 '다른 위치입니다. 다시 선택해 주세요.'로
    앱 화면에 그대로 뜨는 문장이라 짧고 지시가 분명한 말로 바꾼다(2026-09-15 사용자
    수정). 방향 창 끝자락 안내(YAW_EDGE_NOTE)는 로그 진단용으로 남기고 앱이 화면에서
    뗀다. test_pose_score 35건 통과.
    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
2026-09-16 fix(description,nav2): base_link 원점을 차체 중심에서 구동륜 축으로 15.4 cm 옮긴다
    차동구동이라 실제 회전 중심은 구동륜 축 중점이다. 그런데 base_link 원점은 CAD
    원점인 차체 한가운데였고 구동륜 joint 가 거기서 x +0.154 에 있었다. 한편
    encoder_feedback.py(292~299행)는 좌우 바퀴 이동거리의 평균과 차이로
    odom -> base_footprint 를 내므로, TF 가 실제로 추적하는 점은 이미 구동륜 축이었다.
    보정 항은 없다. 즉 '오도메트리가 가리키는 점'과 '거기 붙여 둔 몸 모양'이
    15.4 cm 어긋난 채로 돌아가고 있었다.
    nav2_params.yaml 의 footprint 주석은 "base_link(구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
    [VICA.xacro]
2026-09-16 chore(maps): 8/10~9/10 실기 지도와 keepout 을 저장소에 넣는다
    `.gitignore` 는 `maps/_live/` 와 `maps/CURRENT_MAP` 만 빼고 `maps/` 자체는 추적한다.
    그런데 실제로 추적되던 것은 `vica_map_0630` 셋뿐이고, 그 뒤 실기에서 만든 지도는
    전부 작업 트리에만 있었다. 폴더가 지워지면 9/3 배송·9/4 촬영에 쓴 지도가 사라진다.
    들어가는 것(16 셋, 약 15 MB)
    - 매핑 회차: 0810 · 0817 · 0819 · 0829 · 0829_2 · 0903 · 0903_1 · 0903_c ·
    0903_d · 0910 · vica_map_00 · vica_map_01 · robot_0903 · robot-4_0903
    - 0630 은 지도 본체만 추적 중이었으므로 빠져 있던 keepout 두 파일을 마저 넣는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
    [robot-4_0903.yaml, robot-4_0903_keepout.yaml, robot_0903.yaml]
2026-09-16 feat(nav2): Route Server 2판 — 레일 1 m 간격·IsRoutePathUsable 거름망·2단계 BT (run8 실주행 7/7)
    왜 (2026-09-16 run1·3·5 bag 으로 확정)
    - 1판은 route_server 가 "Route found with 1 nodes and 0 edges" 로 점 1개 경로를
    내놓아 controller 가 "Received plan with zero length" 를 2739·999·237회 뱉으며
    섰다. route 없이 달린 run4 는 0회. 유령 장애물·목적지 좌표·keepout 은 대조로 배제.
    - 원인 둘. (1) 레일이 꺾이는 점만 남겨 작업실→화장실 복도가 6.71 m 엣지 하나였다.
    (2) nav2_route 1.1.20 goal_intent_extractor.cpp 는 로봇이 첫 노드를 지나치면 그
    노드를 잘라내고, 엣지가 하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
2026-09-17 feat(nav2,mission): 레일 코너 둥글리기(fillet)·접근 감속 사다리 출발 굳음 수리 (run9 실주행 8/8)
    레일 (scripts/vica_route_graph.py fillet_corners, 루트 저장소 커밋 참조)
    - run8 에서 smooth_corners 를 끄니(NaN 사고) 코너가 뾰족해져 DWB 가 지나쳤다 되돌아왔다
    (방2→화장실 w ±0.29 왕복). 생성기가 15~120° 코너를 반지름 ≤0.5 m 호로 바꿔 GeoJSON 에
    굽는다. 호 위 점이 설 수 없는 칸이면 그 코너는 그대로 둔다. 0630: 노드 42→74, 최대 엣지
    0.94 m, 30~120° 뾰족 코너 0(되돌림 4 = 목적지 스퍼). run9: w 표준편차 0.20→0.18.
    - 시험 test_route_graph_corners_are_rounde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
2026-09-17 feat(nav2): 레일 5판 — README 방식 2 "당근"(레일 위 3 m 앞까지만 planner) + 2단계 GoalReached 게이트 (run11 9/9)
    왜 (run9·run10 bag)
    - 4판까지는 레일이 costmap 에서 무효면 planner 가 최종 목적지까지 자유주행을 그렸다.
    출발 순간 레일 첫 0.8 m 위에 뒤따르는 사람이 서 있어(run10: 치명 칸이 로봇 뒤
    0.78~0.80 m·±170°) 첫 틱이 늘 무효였고, 그 자유주행이 로봇을 planner 가 좋아하는
    휴게실 대각선으로 끌고 가 1초마다 레일과 엇갈려 배회했다(화장실→안내소 46~70 s).
    - 4판의 앞 2.5 m 검사(TruncatePathLocal→IsPathValid)로는 첫 0.8 m 문제를 못 막았다.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
2026-09-17 fix(nav2): 레일 6판 — 당근 planner 실패 시 레일 경로로 후퇴, 목적지 0.25 m 안에서는 재계획 중단
    run11(5판) 부작용 둘의 수리. 둘 다 기성 BT 노드, XML 만.
    A. CarrotOrRail: ComputePathToPose(당근)이 실패하면 ComputeRoute 를 다시 불러 레일 경로를
    그대로 FollowPath 에 준다(4판까지의 동작). 5판은 매 틱 planner 가 필요해 벽 옆(여유
    0.3~0.45 m)에서 뒤에 사람이 0.5~0.6 m 로 붙으면 발자국 테두리가 치명 칸에 닿아
    "Starting point in lethal" 140회(run10 4회), 당근·목적지 둘 다 계획 실패로 11 s·28 s
    정지, costmap 초기화 60회. 레일로 후퇴하면 DWB 가 스스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
2026-09-17 fix(nav2): 레일 7판 — 레일 원본을 {rail_path} 로 분리, 6판의 도착 방향 사고 수리
    run12(6판) 12/12 완주였으나 성공 순간 로봇 방향이 목적지와 달랐다: 방2 +48/+143/+80/+82°,
    입구 −155°, 안내소 −144° (run11 은 ≤9°). 원인: ComputeRoute 가 레일을 {path} 에 쓰는데
    목적지 옆에서 레일이 점 1개(방향 identity=0°)로 줄면 거름망이 거르기 전에 {path} 가 그
    점으로 덮이고, 6판 B(GoalReached 면 재계획 안 함) 때문에 아무도 덮어쓰지 않아 FollowPath
    가 그 점을 목표로 삼아 0° 에서 도착 처리했다. 목적지 yaw 가 0° 인 곳(화장실·안내소)만
    우연히 멀쩡했다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
2026-09-17 feat(nav2): 0903_d 나무형 레일 + global scan 표시 6 m·소거 8 m (run16·17 실주행)
    - maps/vica_map_0903_d_route.{geojson,png}: 등뼈 407호↔테스트1 42.7 m + 화장실 곁가지 6.1 m, 노드 60·
    무방향 엣지 60·최대 엣지 0.98·뾰족 코너 0·가닥 1·교차 0·금지구역 침범 0. run15 9/9·run16 5/5.
    - global_costmap obstacle_layer.scan: obstacle_max_range 3.0→6.0, raytrace_max_range 3.5→8.0.
    이유: run15 에서 사람이 3 m 안에 들어와야 costmap 에 적혀 당근 planner 의 유효 반응 거리가 1.2 m 였다.
    결과(run16·17): 경로 이탈 시작 1.07→1.68/1.77 m, 3 m 밖에서 보인 2건은 정지 없이 통과. CPU 45~51 %,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
2026-09-17 feat(nav2): 레일 8판 — 앞 3 m 레일이 비면 레일 직접, 막히면 6 m 당근
    - RouteCarrot: ComputeRoute → 거름망 → TruncatePathLocal(3 m) → Fallback[
    RailDirect = IsPathValid({rail_ahead}) → ComputeRoute({path}) … 레일을 그대로 FollowPath
    CarrotBeyond = TruncatePathLocal(6 m) → GetPoseFromPath(당근) → Fallback[ComputePathToPose, ComputeRoute] ]
    - 왜: run15~17(0903_d)에서 5~7판의 "늘 당근" 은 코너를 끊어 돌았다(w 버스트 4~9, 기존 planner 도 같음 —
    lattice 가 매초 22.5° 눈금에서 새로 그림) 하고 레일에 굽어 둔 호를 쓰지 않았다(접점 이탈 1 m).
    4판(레일 직접)은 코너 w 표준편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
2026-09-17 fix(nav2): 레일 8판-1 — 레일에서 0.5 m 안에 있을 때만 레일 직접 모드
    - RailDirect 앞에 IsRoutePathUsable(max_dist_from_path 0.5, NearRailGate). 0.5 m 밖이면 당근 모드가
    매끄러운 복귀선을 그린다.
    - 왜(run18): 출발 때 뒤 0.4 m 에 선 사용자가 앞 3 m 레일 조각을 막아 당근 모드 → 6 m 당근이 넓은 호 U턴
    (레일 이탈 1.39 m·벽 0.36 m·far 3회) → 호 끝에서 레일 모드가 멀리서 켜지자 레일 경로(가까운 노드에서
    시작하는 선)가 로봇 옆 1.3 m 에 놓여 DWB 가 w ±0.5 로 좌우를 번갈아 치며 8 s 다가붙음(407호→화장실
    직진 w 표준편차 0.23, 다른 구간 0.03~0.1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
2026-09-17 fix(nav2): 레일 8판-2 — 문턱 0.8 m + 복귀용 당근 3 m (모드 셋)
    - NearRailGate 0.5→0.8 m. run19: 0.5 는 정상 주행의 13 %(레일선 0.5 m 밖) 까지 걸어 당근 모드 81 %·far 96회,
    코너가 당근식(붙어 감 1.3 m·화장실→407호 펄스 버스트 7~8)으로 돌아갔다. 0.8 m 밖은 3~6 %, 1.0 m 밖은
    0~4 % 로 전부 U턴 뒤 복귀 구간(run16·18 실측).
    - RejoinCarrot: 앞 3 m 조각이 비었는데 0.8 m 밖이면 3 m 조각 끝점을 당근으로 planner 가 완만한 복귀선을
    그린다. run18 은 이 상황에서 레일 모드가 멀리서 켜져 DWB 가 옆 선에 붙느라 지그재그(w 표준편차 0.23).
    막혔을 때만 6 m 당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
2026-09-17 feat(nav2): 0903_d 레일 재생성 — Y 접점 호 반지름 1.0 m (run21 시험용)
    접점 호 R 0.48→0.97~1.0. 노드 60→59, 최대 엣지 1.00, 뾰족 0, 벽 여유 최소 1.20 m, 교차 0, 금지구역 침범 0.
    이유: run20 에서 R 0.48 은 w 상한 0.5 에 0.5 m/s 로 못 따라가 안쪽 자르기·펄스가 남았다(devlog §11).
    Claude-Session: https://claude.ai/code/session_01EQr7nT17VwBmqKhRyKscpi
2026-09-17 test(nav2): 비교 시험용 — BT 를 8판(e0e781b)으로 되돌림, 레일은 호 1.0 m 유지 (run22)
    - 사용자 요청: 코너 기하(접점 호 1.0)는 두고 "레일 0.5/0.8 m 안" 문과 복귀 당근(8판-1·8판-2)을 뺀 8판 BT 로
    빠르게 A/B. run21(8판-2 + 호 1.0)은 짧게 달려 "별로 나아진 것 같지 않다"는 체감. 이따 run20·21·22 를 한 번에 비교.
    - 되돌린 내용: NearRailGate·RejoinCarrot 제거. 앞 3 m 레일이 비면 레일 직접, 막히면 6 m 당근(8판 그대로).
    - 계약 시험도 e0e781b 판(13 통과).
    Claude-Session: https://claude.ai/code/session_01EQr7nT17VwBmqKhRyKscpi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
2026-09-17 fix(nav2): 레일 8판-2 복원 — 문턱 0.8 m + 복귀 당근 3 m (run22 A/B 결과)
    - run22(8판 BT + 접점 호 1.0): 사용자 판정 "너무 경로로 가려 한다, 못 쓸 것 같다". 8판-2(836f103)로 되돌린다.
    - 유지: 접점 호 1.0 m 레일(99e9458), 표시 6 m·소거 8 m.
    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
2026-09-18 fix(nav2): 레일 8판-3 — 회피 당근 6 → 3 m
    - 8판에서 3→6 으로 늘린 근거("run16 회피 횡 이탈 0.27 m 에 묶임")는 실주행으로 반증됐다:
    6 m 에서도 횡 이탈 0.25~0.37 m 로 그대로(run18·19·20). DWB 는 sim_time 으로 앞 1.4 m 만 보고
    사람은 1.5~2 m 에서 나타나므로 planner 목표를 멀리 둔다고 회피 폭이 늘지 않는다.
    - 비용은 컸다. U턴 창에서 planner 경로가 옆으로 벌어진 폭 중앙값: 3 m 0.52 m vs 6 m 3.02~4.31 m
    (굽이는 1.04~1.06 로 동일 — 폭만 목표 거리에 비례). 그 폭 → 레일 이탈 0.6~0.9 m → 안쪽 문(0.8 m)
    실패 58 % → 모드 갈림 → 코너·직진 흔들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
2026-09-18 feat(nav2): controller 를 DWB → MPPI 로 전환 (레일 8판-3 위에서)
    - DWB 설정은 `FollowPathDWB` 로 이름만 바꿔 그대로 보존했다. 되돌리기 = MPPI 블록을
    지우고 FollowPathDWB 를 FollowPath 로 되돌리기.
    - 왜: 레일까지 온 뒤 남은 것이 controller 축이다. run23 에서도 코너 조향이 펄스로 남았고
    (버스트 3.9·부호 반전 2.7) 원인은 1 Hz 로 바뀌는 경로를 DWB 가 이산 속도 격자에서 매번
    새로 쫓는 구조였다. MPPI 는 이전 명령에 잡음을 얹어 궤적 수천 개의 가중평균을 내므로
    경로가 바뀌어도 명령이 튀지 않는다. 08-29 실측(nav2/mppi2 5a6acc7): 손 횡속도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
2026-09-18 fix(nav2): MPPI 7개 값을 08-29 실측 조합으로 되돌린다 (run24 결과)
    run24(2026-09-18, 0903_d, 목적지 8) 판정: 8/8 완주·CPU 문제 없음이나
    요구 네 가지 중 셋이 미달이라 되돌린다.
    직진 조향 부호반전 17.3 -> 46.3 회/분 (run23 DWB 대비, 같은 레일·같은 코스)
    흔들림 한 주기 4.2 -> 2.3 s
    조향이 직전과 같은 주기 76.4 -> 14.1 %
    U턴 제자리 비율 38 -> 51 %
    일반 코너 벽 여유 0.73 -> 0.95 m (유일한 성공)
    사람 사건당 정지 0.64 -> 2.67 s
    사람이 손잡이로 느낀 것: 좌우 약 8도씩 2.3초마다, 장애물 없는 직선에서도.
    범인은 MPPI 가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
2026-09-18 fix(nav2): MPPI temperature 0.3 -> 0.6 — 손잡이 잔떨림의 정본 원인은 표본 잡음
    run25(2026-09-18, 되돌린 값 eef2aa0)로 원인이 확정됐다. 직전 가설
    ("따라가는 힘↑ + 감쇠↓ 가 진동을 만든다")은 **반증됐다** — critic 7개를
    08-29 실측 조합으로 되돌렸는데 직진 조향 반전이 46.3 -> 47.9 회/분으로
    그대로였다. critic 가중치는 이 축이 아니다.
    진짜 사슬(수치로 닫힘):
    1) MPPI 출력은 궤적 1000개의 가중평균이라 표본 잡음이 남는다.
    주기당 |Δw| ≈ 1.9 x wz_std / √batch_size
    run24 wz_std 0.45 → 0.0271 (예측 0.0142, 배수 1.91)
    run25 wz_std 0.50 → 0.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
2026-09-20 feat(mission): 도착 대화 — 대기형 질문의 거절은 종료형으로 되묻고, 침묵은 같은 질문을 한 번 더
    2026-09-20 사용자 결정: '아니오' 한 번(오전사 포함)이나 8초 침묵 한 번으로 떠나지 않는다.
    - deny(대기형): "여기까지 안내를 마칠까요?"로 되묻는다. 네=끝(홈행), 아니오=대기.
    - 침묵 8초: 같은 도착 질문을 한 번 더 묻고, 그래도 침묵이면 떠나기 예고(기존 사다리).
    실기 18:18('그럴래?'→거절→귀가)·18:55(노드 사망 중 무응답→귀가) 사건.
    test_progress_narration 3건 실패는 이 변경 전에도 같음(기존 표류).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
2026-09-21 feat(nav2): MPPI 남은 네 값을 한 번에 — 잡음 축 둘 + 시야 축 둘
    run26 까지로 두 축이 분리돼 확인 가능해졌으므로(잡음은 식으로, 시야는 코너
    속도로) 네 값을 함께 적용한다. 사용자 판단(2026-09-21).
    [잡음 축] batch_size 1000 -> 2000 표본 잡음 x1/√N = x0.71
    wz_std 0.5 -> 0.35 표본 잡음에 비례 = x0.70
    [시야 축] time_steps 36 -> 56 지평 1.8 -> 2.8 s (nav2 기본)
    prune_distance 1.5 -> 3.0 MPPI 가 보는 경로 길이
    **잡음 축은 식으로 검증된다**(7.1): 주기당 |Δw| ≈ 1.9 x wz_std / √batch.
    run26 실측 0.0159 → 예상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
2026-09-21 feat(nav2): 제어 주기 20 -> 10 Hz (model_dt 0.1 · steps 28) + temperature 1.2
    run27 에서 제어주기 놓침 225회(그 전 네 회차는 0). 계산을 줄이되 지평은 지킨다.
    controller_frequency 20.0 -> 10.0
    model_dt 0.05 -> 0.1 **강제 짝**
    time_steps 56 -> 28 지평 2.8 s 그대로
    temperature 0.6 -> 1.2
    **model_dt 는 선택이 아니다.** optimizer.cpp setOffset():
    controller_period > model_dt -> throw runtime_error (노드가 안 뜬다)
    controller_period == model_dt -> shift_control_sequence = ON (warm start)
    controller_period < model_dt -> WARN, shifting OFF
    1/10 = 0.1 이므로 model_dt 0.1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
2026-09-21 feat(interfaces): RobotState 에 로봇 대장 칸 10개 — 대화 단계·지금 있는 곳·가는 중·직전 도착·하려다 만 곳·대기·배터리
2026-09-21 feat(mission): map.yaml 에서 건물·층을 읽는 map_meta — 지도 한 장 = 한 층
2026-09-21 feat(mission): 로봇 대장 자료형·좌표→장소 라벨·ledger.json 보존·메시지 칸 파생 (순수 모듈)
2026-09-21 fix(mission): LedgerStore.read()가 손상된 UTF-8 파일도 복원하지 않도록 — UnicodeDecodeError 포착
2026-09-21 feat(mission): 대장용 접근자 — 대기 요청 분·남은 초
2026-09-21 feat(mission): 로봇 대장을 채워 방송·보존 — 층은 map.yaml, 위치는 AMCL 좌표, 도착·취소·확인 접힘은 사건과 전이로
2026-09-21 fix(nav2): MPPI temperature 1.2 -> 0.9 — 너그러운 평균은 경계심도 낮춘다
    run28 에서 잔떨림은 DWB 급이 됐다(손잡이 좌우속도 0.072 vs DWB 0.084, 좌우가속
    0.159 vs 0.183). 실효 표본도 545 -> 1412/2000 으로 돌아왔다.
    그런데 같은 회차에 로봇이 레일에서 0.63 m 벗어나 벽 0.43 m 까지 갔다(외접 0.620).
    `start_lethal` 12회 · abort 24 · 완주 7/8 · 일반코너 제자리 36 %.
    **temperature 는 부드러움과 경계심을 같은 손잡이로 돌린다** — 꼴찌 의견까지 평균에
    넣으면 "저기 벽이 있다"는 의견도 묻힌다. 0.9 면 실효 표본 1000 근처로 경계심을
    얼마간 되찾으면서 잔떨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
2026-09-21 docs(mission): map.yaml·ledger.json 경로 규약
2026-09-21 feat(nav2): MPPI gamma 0.015 -> 0.05 — 직전 명령을 더 붙들어 조향 뒤집힘을 줄인다
    run30(temperature 0.9)으로 잔떨림 **크기**는 DWB 를 넘어섰다(손잡이 좌우속도 0.071
    vs DWB 0.084 · 좌우가속 0.164 vs 0.183). 남은 것은 **방향 바뀜** 37.5 vs DWB 35.8 뿐이다.
    `gamma` 는 그 축을 직접 건드리는데 **아직 한 번도 안 건드렸다.**
    소스 근거(optimizer.cpp `updateControlSequence`): 비용에 아래 항이 더해진다.
    gamma / wz_std² × Σ(지금 명령 × 잡음)
    즉 **직전 명령에서 벗어나는 표본에 값을 물린다.** 올리면 가중평균이 직전 명령 쪽에
    머물러 조향이 덜 뒤집힌다.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
2026-09-21 fix(nav2): MPPI gamma 0.05 -> 0.03 — 0.05 는 한 번에 너무 올렸다
    run31(gamma 0.05) 사용자 관찰:
    ① 직진 성향이 너무 강하다 — 코너 돌 때와 회피할 때 확실히 **각지게** 간다
    ② 직진 주행이 오히려 **더 비틀거린다**
    가설(미검증): gamma 는 직전 명령에서 벗어나는 표본에 벌점을 물린다. 0.05 면 직진 중
    "꺾자"는 후보가 계속 비싸져 꺾기를 미루다 한 번에 꺾는다 — "각지게" 와 맞는다.
    늦게·크게 고치는 탓에 직진도 덜 고요해졌을 수 있다.
    0.03 은 nav2 기본값 0.015 와 0.05 의 중간이다. 되돌림이 아니라 이분 탐색이다.
    바꾼 값은 이것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
2026-09-21 feat(nav2): gamma 축 종료(0.015 복귀) + wz_std 0.35 -> 0.5 로 유턴 축 개방
    **gamma 는 코너를 못 고친다.** 실주행 세 점으로 닫는다.
    0.05 (run31) 각짐 심함 + 직진이 오히려 더 비틀거림
    0.03 (run32) 둘 다 중간
    **어느 값에서도 코너의 흔들림·멈칫은 그대로**였다.
    nav2 기본값 0.015 로 되돌려 변수를 하나 줄인다.
    **wz_std 0.35 -> 0.5** — 이번 회차의 유일한 변수다.
    이 값은 회전 후보의 폭이다. 넓히면 '확 꺾는' 답이 후보에 들어와 유턴을 호로 돌 수
    있고, 좁히면 잔떨림이 준다. **둘을 반대로 움직이는 단일 노브**라 run27 부터 잔떨림
    쪽에 붙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
2026-09-21 fix(mission): 대장 전이표를 순수 함수로 — 접근 대상 제외·goal_sent 저장·NaN 방어·미캘리브레이션 제외 (최종 리뷰 M1·M4)
    goal-event→대장 전이(_publish_goal_event)와 CONFIRMING 접힘 감지(_tick)를
    ledger.py 의 순수 함수 apply_goal_event·confirm_abort_name 으로 옮겼다.
    노드는 결과만 복사·저장한다 — 리뷰가 지적한 "시험 0건" 구멍이 이제 시험
    가능해졌다.
    - M1: 사람 접근 합성 목적지(approach: 접두)가 홈처럼 이름을 ""로 취급돼
    대장에 안 남는다. 감지기가 켜진 실기에서 접근 한 번이 "아까 어디
    갔었지?" → "접근 대상" 으로 오염되던 결함.
    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
2026-09-21 fix(mission): map_meta 가 깨진 인코딩 파일에도 안 죽게 (최종 리뷰 M2)
    load_map_meta 의 except 에 ValueError 를 더한다 — Path.read_text 의
    UnicodeDecodeError 는 ValueError 계열이라 OSError·yaml.YAMLError 만으로는
    안 잡혔다. 이 로더는 노드 __init__ 에서 불려 못 잡으면 미션 노드 기동
    자체가 죽는다. LedgerStore.read() 는 이미 같은 결함을 고쳤는데(Task 3)
    이 로더만 남아 있었다.
2026-09-21 feat(nav2): wz_std 0.42 로 절충 + pose_bootstrap 실행기 스레드 28 -> 2
    **wz_std 0.5 -> 0.42.** run32(0.35) 와 run33(0.5) 사이를 찾는다.
    0.35 제자리 15.9 % · 일반코너 33 % · 손잡이 0.072 · 벽여유 0.89 m
    0.50 제자리 5.6 % · 일반코너 0 % · 손잡이 0.096 · 벽여유 0.30 m
    0.5 가 **일반 코너의 제자리 회전을 33 -> 0 %** 로 확실히 고쳤다(사용자 관찰
    "코너에서 멈칫"의 정체). 대가는 잔떨림 +33 % 와 벽여유였다.
    **U턴 제자리는 55 -> 50 % 뿐이라 이 축으로는 안 고쳐진다** — 유턴은 별개 축이다.
    **pose_bootstrap_node 실행기 수정.** `MultiThreadedExecutor()` 가 인자 없이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
2026-09-21 feat(nav2): controller 를 MPPI -> RPP 로 전환. MPPI 는 FollowPathMPPI 로 보존
    **MPPI 판정 — 열한 회차(run24~34) 끝에 접점이 없다.**
    MPPI 가 이긴 것: 손잡이 진동 **크기**(0.071 vs DWB 0.084) · 벽 여유(0.75 vs 0.56 m) ·
    동적 장애물(첫 포착 2.03 vs 1.24 m) · 궤적 전멸 0회 · controller CPU(15.1 vs 19.1 %).
    **끝내 못 고친 둘**:
    ① 방향 바뀜 DWB 35.8 회/분 vs MPPI 최선 37.5 — **구조적**이다. MPPI 는 평균이라
    명령이 거의 매 주기 바뀐다(같은 값 유지 5 % vs DWB 76 %).
    ② U턴 제자리 DWB 38 % vs MPPI 50~61 % — 어떤 값으로도 못 내렸다.
    `wz_std` 하나가 둘을 반대로 돌리고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
2026-09-21 fix(nav2): velocity_smoother min_velocity[2] -1.0 -> -0.5 — 좌우 회전 상한을 맞춘다
    RPP 전환(8335a23)에서 max_velocity[2] 를 1.0 -> 0.5 로 내렸는데 min_velocity[2] 가
    -1.0 으로 남아 **좌우가 비대칭**이었다. 왼쪽은 0.5 까지만 돌면서 오른쪽은 1.0 까지
    열려 있었다는 뜻이다.
    지금까지 안 드러난 이유: DWB 는 자체 max_vel_theta, MPPI 는 자체 wz_max 를 갖고 있어
    스무더가 회전 상한이 아니었다. **RPP 에는 회전 상한 파라미터가 없어 이 값이 유일한
    방어**이므로 비대칭이 그대로 새어 나간다.
    이제 셋 다 대칭이다.
    max_velocity[2] 0.5 min_velocity[2] -0.5
    max_a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
2026-09-21 fix(nav2): RPP max_lookahead_dist 0.75 -> 1.20 — 조준점이 레일 노드를 건너뛰게 한다
    run35 사용자 관찰: "직진을 잘하기도 하고 아니기도 하다. 곡선으로 노드들을 따라가려
    해서 그런가?" **맞다.** 실측 흔들림 파장 1.25 m 가 레일 노드 간격 1.00 m 와 맞는다.
    **고칠 자리는 min 이 아니라 max 였다.**
    조준거리 = v x lookahead_time 을 [min, max] 로 자른다. 순항 0.44 m/s 면
    0.44 x 2.5 = 1.10 m 인데 **max 0.75 에 걸려 잘리고 있었다**(0.30 m/s 이상 전부).
    레일은 직선 구간도 1 m 마다 점이 찍힌 꺾은선이다. 조준점이 그보다 짧으면 한 구간
    안에만 머물다 **노드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
2026-09-23 feat(guidance): 스마트핸들 보드를 Arduino Nano에서 ESP32U로 이식
    시나리오·상태코드·상향 프레임·타이밍은 그대로 두고 보드에 묶인 것만 고쳤다.
    - 핀: 서보 19 / LED 왼쪽 17·오른쪽 18 / 레벨시프터 OE 16(HIGH=켜짐, 신설) /
    I2C SDA 22·SCL 21(ESP32 기본과 반대, 스캔 실측) / 진동 4 / 터치 14
    - 서보: AVR Servo.h → ESP32Servo (50 Hz·544~2400 µs 명시 = 나노 기본과 동일)
    - I2C: Wire.begin(SDA,SCL), setWireTimeout(AVR 전용) → setTimeOut(25)
    - LED 30→31개 (실물 끝 1개 미점등)
    - 초음파 앞 두 채널 주소 {0x68,0x74} → {0x69,0x6A}: 사용자가 센서 8개를
    0x68~0x6F로 재주소했고,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
2026-09-23 feat(guidance,nav2,description): 초음파 8채널 — 펌웨어·파서·URDF·costmap 레이어
    왜
    - 09-22 에 센서 8개(0x68~0x6F)를 자리별로 실측했지만 펌웨어·ROS 는 앞 두 개만 읽었다.
    사용자 요청(09-23): 8개 전부 costmap 에 넣는다. 유효 거리·발행 fov 는 앞 두 개와 동일
    (1.5 m, 물리 빔 50°, 지도 표시 30°).
    무엇을
    - 펌웨어: 서로 등진 채널 2개를 한 라운드로 묶어 4라운드(420 ms/바퀴, 채널당 약 2.4 Hz).
    같은 방향 센서는 서로의 메아리를 읽으므로(인수인계 §4.2) 절대 같이 쏘지 않는다.
    상향에 8채널 프레임 AA 57(20 B) 추가. 옛 AA 55(8 B, 앞 두 개)는 라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
    [VICA.xacro]
2026-09-23 feat(description): RViz 기본 설정에 초음파 Range 표시 8개 추가
    urdf.rviz 에는 Range 표시가 하나도 없었다. 앞 2(하늘색)·옆 4(초록)·뒤 2(주황)를
    LaserScan 다음에 넣어 기동 즉시 부채꼴 8개가 보이게 한다.
2026-09-24 fix(guidance): 드라이버 실행기를 2스레드로 — TF 수신이 시리얼 루프에 굶어 초음파 TF 게이트가 항상 닫히던 결함
    run37(09-24) 31분 동안 /ultrasonic/* 8채널이 0건이었다. 보드는 2.4 Hz 로 정상이었고
    (재기동 8분에 보류 프레임 1,133개), _range_tf_ok 의 can_transform(odom->usonic_*, 프레임시각)
    이 계속 실패해 Range 를 내지 않았다. 원인은 단일 스레드 spin: uplink_loop(20 Hz)·send·diag 와
    /tf 수신(≈135 msg/s)이 한 줄에서 처리돼 TF 버퍼가 뒤처졌다(별도 스레드 버퍼로 같은 조회는
    49/50 성공, 정지 중 드라이버는 1/3 만 통과). tf2_ros.TransformListener 는 /tf 구독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
    [user_guidance_driver_node.py]
2026-09-24 fix(nav2): 후방 초음파 레이어 2개 끔 — 손잡이 잡은 사람 다리를 장애물로 찍어 출발·회전을 막는다
    run38(09-24, 초음파 8채널 첫 유효 회차). goal 시작 8회 중 7회에서 첫 전진까지 2.9~13.8 s 걸렸고
    그 사이 RPP 'detected collision ahead' 11~111회. 그때 후방 초음파 값 0.12~0.23 m = 손잡이를
    잡고 선 사람의 다리(차체 뒷면에서 패딩 포함 발자국 끝 0.16 m 안쪽). 유일하게 바로 출발한
    11:34:07 은 후방 0.92~1.04 m. 회차 전체 collision ahead 1,325회(run36 11 · run37 228).
    뒷바퀴 옆 두 개(5·8)도 정지 시 0.27~0.30 m 를 찍은 적이 있어 회전 중 발자국 회전 반경(0.62)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
2026-09-24 fix(nav2): RPP min_lookahead_dist 0.45 -> 0.6 — 레일 복귀 호를 키운다
    복귀는 느린 속도에서 시작해 조준거리가 하한에 붙는다. 반지름 = L^2/(2*옆이탈)이라 옆이탈
    0.5 m 에서 0.20 -> 0.36 m, 조준각 asin(0.5/L) 90 -> 56 도로 제자리 회전 문턱(74.5 도) 아래.
    run36 코너 창 재계산에서 조준점 각 최대 101~113 -> 93~101 도. 장애물 감지엔 영향 없음
    (충돌 예측 길이는 min(1.2 s, 조준점 거리)). 대가는 코너 안쪽 자르기(R 1.0 호에서 4.5 cm).
    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
2026-09-24 fix(nav2): 도착 yaw 축 — planner tolerance 0.05, PoseProgressChecker, RPP 회전 0.5/가속 2.0
    run37 409호(-80 도로 도착) 해부: (1) Lattice 가 tolerance 0.2 안의 근사해로 -90 도 끝점(0.14 m)을
    내고 목적지 0.25 m 안에서 얼려짐, (2) 그 방향으로 20 s 제자리 회전 -> SimpleProgressChecker 가
    이동 0 으로 '진전 없음' -> 복구 재전송 -> 그 자리(-80 도)에서 즉시 도착. 화장실은 끝 방향이
    0/90 도로 1초마다 교대. 도착 판정(xy 0.25/yaw 0.25 rad)은 DWB 때와 같아 건드리지 않았다.
    - GridBased.tolerance 0.2 -> 0.05: 방향 틀린 근사해 금지(90 도 = Dubins 0.157 m).
    - progress_checker Simple -> Pose(requi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
2026-09-24 revert(nav2): 도착 yaw 축 4개를 수정 전(852c3db)으로 되돌린다 — run41 도착 헌팅
    tolerance 0.05·PoseProgressChecker·RPP 회전 0.5/가속 2.0 → 0.2·Simple·0.35/1.2.
    run41(09-24 13:44, CPU 정상·TF 30 Hz·지연 14 ms)에서 도착 정렬이 헌팅했다.
    run40 에서는 TF 지연 탓으로 봤으나 TF 가 정상인 이번에도 재현돼 그 판단은 틀렸다.
    - 409호(첫 도착): 정렬 59.6 s 뒤 사용자 취소. 목적지 0.22~0.30 m 에서
    좌우 ±16~19° 로 넘쳐 돌기를 반복(허용 ±14.3°). 반경 경계(0.25)를 넘나들
    때마다 당근 쪽으로 −110°·−154° 까지 크게 돌았다.
    - 테스트1: 반경 안(0.18~0.20 m)에서도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
2026-09-24 fix(nav2): 초음파를 costmap 에서 빼고 collision_monitor Range 소스로 — 정지 대신 감속
    local costmap 초음파 레이어 6개 enabled False(후방 2개는 9ad3caa 에서 이미 off),
    collision_monitor observation_sources 에 us_front_left·us_front_right·us_left_wheel·
    us_right_wheel(type range, obstacles_angle 0.05) 추가. 뒷바퀴 옆 2개는 어디에도 넣지 않는다.
    run43(09-24 14:44, 초음파 6층·후방 off) 근거:
    - 주행 중 완전 정지(≥1 s) 9회 전부 RPP "collision ahead" → failure_tolerance 10 s →
    ClearLocalCostmap → 즉시 0.5 m/s 출발. RangeSensorLayer 마크는 같은 센서가 그 칸을
    다시 비춰야만 지워져 로봇이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
2026-09-24 revert(nav2): 초음파 collision_monitor 이전을 되돌린다 — run44, 감속만 하고 못 피함 (뒷바퀴 옆 2층은 off 유지)
    413c8dd 되돌림: costmap 초음파 층(앞 2·바퀴 옆 2) 다시 켬, collision_monitor 는 scan 단독.
    뒷바퀴 옆 2층(right_rear_wheel·left_rear_wheel)은 사용자 요청대로 off 유지.
    run44(09-24 15:50~16:07) 결과 — "시험해 봤다" 기록:
    - 완주 5/5. collision ahead 9/분(run43 110), 완전 정지 0.6/분(run43 1.5).
    - 레일 위 30 cm 꼬깔콘: 라이다(0.382 m)는 못 봄(전방 1.7~2.4 m), 앞 초음파 0.13~0.52 m
    → collision_monitor 감속 → 정지 11 s. 지도에 없으니 planner·RPP 가 돌아가지 못하고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
2026-09-24 feat(guidance): 초음파 측정 결과 통계 프레임(AA 58) — 0xFFFE 간섭을 다른 실패와 나눠 센다
    펌웨어가 0xFFFF(미완료)·0xFFFE(동주파수 간섭)·I2C 실패를 모두 usFail 로 뭉뚱그려
    "간섭이 있나"를 알 수 없었다(3회 연속이면 값이 0 이 되어 간섭은 유령이 아니라 감지
    누락으로 나타난다). 판정 로직과 거리 프레임(AA 57)은 그대로 두고 세기만 추가한다.
    - 펌웨어: 채널별 ok/clr(FFFD)/ffff/fffe/oth/i2c 를 창마다 세어 12바퀴(≈5 s)마다
    AA 58 seq [8×6] xor(52 B) 송신. 옛 파서는 헤더가 달라 1바이트씩 지나친다.
    - 드라이버: StatFrameAccumulator 로 같은 스트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
2026-09-24 feat(guidance): 초음파 레지스터 정지 시험 — 채널별 지향각·노이즈 레벨, 시험 명령, 되읽기 프레임(AA 59)
    run45(09-24) 에서 0xFFFE 는 7.5분 8,630회 중 9회(전부 costmap 에서 꺼 둔 후방 오른쪽)로
    간섭은 사실상 없었다. 다음 축은 레지스터: 0x06 노이즈 저감(바닥 1 cm 물체 과민 억제)과
    바퀴 옆 지향각 60°(측면이 센서 하나라 넓혀 보기). 세워 두고 설정을 바꿔 가며 재려고 만든다.
    - 펌웨어: 지향각·노이즈를 채널별 배열로(부팅 기본값 3 / 1 — 운영 동작 불변).
    하향 시험 명령(드라이버는 안 보냄, 워치독 무관): 0x30 기본값, 0x31~0x35 노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
2026-09-24 feat(guidance): 바퀴 옆 초음파 2개를 60° 로 — 물리 빔(레벨 4)과 costmap 칠하는 폭을 함께
    측면은 costmap 에 들어가는 센서가 한쪽에 하나뿐이라(뒷바퀴 옆은 run43 뒤 off) 넓혔다.
    노이즈 저감(0x06)은 1 유지 — 정지 시험 두 판에서 1~5 결과가 같았다(마우스 100 %·충전 선
    0 % 가 레벨과 무관, 데이터시트는 올리면 약한 물체를 놓친다고 적음).
    정지 시험(09-24, usonic_register_bench.py, 바퀴 옆 50° 대 60°):
    - 빈 곳: 바닥 헛값 0(두 각도 모두 72/72 에코 없음)
    - 박스 30·60·≈100 cm: 차이 ≤0.6 cm, 놓침 0/71, 표준편차 ≤0.5 cm
    - 빔 가장자리 꼬깔콘 약 0.5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
2026-09-28 feat(vcc): 자작 컨트롤러 VCC 패키지 뼈대와 기하 계산 — 유턴 폭 표 재현 시험 포함
    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
2026-09-28 feat(vcc): LETHAL 거리장과 몸 전체 여유 계산 — inflation 사각지대 없음을 시험으로 고정
    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
2026-09-28 feat(vcc): 조준점·곡률·차선 평행이동 경로 — RPP 교점 식 재사용(Apache 2.0 표기)
    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
2026-09-28 feat(vcc): 코너 미리보기 감속·직접 거리 근접 감속·도착 감속
    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
2026-09-28 feat(vcc): 공용 출력단 — 출발 0.25 까지 0.5 s·이후 1.75 s, 제동 1.25 유지, 외부 정지 뒤 재동기화
    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
2026-09-28 feat(vcc): 초음파 확인 규칙 — 받은 지 1 s·연속 2회 일치·에코 없음 제외
    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
2026-09-28 fix(vcc): 몸 여유 계산 — 창 밖 자세에서 칸 범위 자르기
    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
2026-09-28 feat(vcc): 차선 13개 고르기 — 20 cm 확보 > 레일 가까움 > 차선 유지, 0.3 s 줏대·1 s 복귀·옆 이동 0.10 m/s·옮기는 동안 감속
    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
2026-09-28 feat(vcc): 유턴 방식 고르기 — R 0.2 → 0.1 → 제자리 → 막힘, 몸 모양으로 가상 주행
    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
2026-09-28 feat(vcc): 도착 정렬 — 남은 각 한 번 회전, 모터 지연만큼 일찍 끊고 넘침으로 지연 학습, 최대 3회, 최악 15 s 안(진행 감시 20 s)
    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
2026-09-28 feat(vcc): 상황 4개 전환 — 전환표·60/25도 히스테리시스·0.5 s 유지·안전 즉시·평행 이탈은 유턴 아님
    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
2026-09-28 feat(vcc): 한 주기 조립 — 거리·차선·상황·출력단을 잇고 실패 3종을 구분
    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
2026-09-28 feat(vcc): 경로 창 부품 — FeasiblePathHandler 개념(가까운 점 범위·끝 2점 유지·1점 경로 거부 선택)을 Humble 용으로
    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
2026-09-28 feat(vcc): nav2_core::Controller 어댑터 — LETHAL 거리장·초음파 직접 구독·PlannerException 3종·/vcc/state
    Task 13. vica_vcc_controller::VccController(nav2_core::Controller) 를 구현했다.
    setPlan 은 core::PathWindow 에 경로를 넘기고, computeVelocityCommands 는 로봇 자세를
    plan 좌표계로 옮겨 창을 뽑고, local costmap LETHAL 칸만으로 거리장을 채우고,
    초음파 4채널을 직접 구독(SensorDataQoS, mutex 로 콜백 스레드와 공유)해 거리장에
    합친 뒤 core::VccCore::step 을 부른다. 실패 3종(CollisionAhead/Blocked/AlignFailed)
    은 모두 nav2_core::PlannerException 으로만 던진다(std::runtime_error 금지).
    /vcc/stat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
2026-09-28 feat(nav2): FollowPath 를 VCC 로, RPP 는 FollowPathRPP 로 보존·초음파 range 층 4개 끔·계약 시험 VCC 분기
    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
2026-09-28 test(vcc): 젯슨 한 주기 bench — p99 6.09 ms (예산 19.1 ms)
    CMakeLists.txt 의 bench_vcc_core 세 줄(add_executable·target_link_libraries·
    install) 주석을 풀고 test/bench_vcc_core.cpp 를 추가한다. 매 주기 5x5 m
    거리장을 새로 만들고(field.grid().reset·markLethal·compute) 움직이는
    기둥까지 넣어 실제 플러그인과 같은 부하로 1000회 잰다.
    젯슨(aarch64, this Jetson) 실측 3회:
    p50=5.92 p90=6.08 p99=6.09 max=10.02 (exit=0)
    p50=5.92 p90=6.08 p99=6.10 max=15.01
    p50=6.14 p90=6.31 p99=6.32 max=16.67
    p99 는 예산 19.1 ms(DWB 수준, 설계서 9절) 의 3분의 1 이하다. 파라미터를
    줄이지 않았다(계산량 예산은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
2026-09-28 fix(vcc): 초음파 확인을 받은 순간 odom 호 중심점 비교로 — 다가가는 중 확인 실패·v·나이만큼 멀어 보임(I1)
    2.4 Hz 측정에서 정면 접근 시 연속 거리 차가 0.42·v 라 v > 0.36 m/s 면 0.15 비교로 영영 확인되지
    않았다. 또 제어 주기의 최신 TF 로 옮겨 물체가 v·나이만큼 멀리 놓였다(위험한 쪽).
    - 구독 콜백에서 받는 순간 센서 자세(odom, 최신 TF)를 측정값에 저장, TF 실패 시 버린다
    - confirmed 는 두 측정의 호 중심점(odom) 거리 ≤ us_confirm_tol 로 판정
    - 여유 계산 점은 최신 측정의 저장 자세로 만든다(readingToArcPoints)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
2026-09-28 fix(vcc): 막힌 유턴에서 Hold↔Track 반복·앞으로 기어감 제거(I2)
    Hold 가 차선만 보고 풀려 Track 으로 나가면, 최소 유지 0.5 s 동안 조준점이 뒤인데 곡률 ≈0 의 전진
    명령(≤0.18 m/s)이 나갔다. 0.80 m 통로 20 s 모의에서 반대로 1.42 m, Blocked 62회가 정상 명령 138회와
    섞여 failure_tolerance 가 끝내 차지 않았다.
    - Hold 는 (도착 전·유턴 필요·유턴 막힘) 이면 나가지 않는다
    - Track 에서 유턴이 필요하면 최소 유지 시간 전이라도 v = 0(돌 수 있으면 Turn 이 제자리로 돈다)
    Claude-Session: https://claude.a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
2026-09-28 fix(vcc): 새 goal 은 도착 정렬만 초기화·reset 은 실측 속도에서 이어 감·reset_gap 1.5 s(I3)
    setPlan 이 끝점 0.5 m 이동을 새 goal 로 보고 core 전체를 reset 했다. 레일 BT 당근 모드는 끝점을
    ~1 Hz 로 옮겨 reset 이 반복됐고, 출력단이 0 이 되어 명령이 0.5 -> 0.05 로 떨어졌다가 다시 램프,
    차선 d 도 0 으로 돌아갔다. reset_gap 0.5 s 는 CPU 멈칫에도 걸렸다.
    - VccCore::onNewGoal: 도착 정렬(횟수·지연 추정)만, Align·Hold 면 상황도 초기화. 차선·출력단 유지
    - OutputStage::reset(measured): 실측 (v, w) 를 한계로 잘라 이어 간다. reset_gap 경로가 velocity 를 넘긴다
    - reset_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
2026-09-28 fix(vcc): 실제 명령 호로 충돌 예측(모든 이동 상황)·차선 d 를 실제 옆 위치에 재동기(I4)
    충돌 검사가 내부 차선 경로만 봤고 실제로 달리는 pure-pursuit 호는 검사하지 않았으며, 정지거리
    검사는 Track 에서만 돌았다. 또 d 가 실제 옆 위치와 다시 맞춰지지 않았다(reset 뒤 0, 유턴 뒤 ~2R).
    - motionCollides: 이번 명령 (v, w) 를 max(v/감속, |w|/각감속) + 지연 동안 이어 가며 0.05 m/0.05 rad
    마다 몸통 여유 < 0 이면 CollisionAhead(명령 0, 출력단은 실측에서). Track·Turn·Align 모두
    - 기존 Track 차선 경로 정지거리 검사는 그대로 둔다
    - 매 주기 경로 첫 점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
2026-09-28 fix(vcc): 도착 정렬 회전 원 막힘이면 돌지 않고 Hold(I5, 설계서 6.1 ③→④)
    제자리 회전이 0.62 m 뒤 몸통을 벽·초음파 점 쪽으로 쓸고 갈 수 있는데 검사가 없었다.
    - yaw 가 허용오차 밖이고 (Align 중이거나 도착 반경 안) 이면 매 주기 남은 각만큼 제자리 회전을
    가상 주행(simulateTurnClearance)해 turn_clearance 미만이면 align_blocked
    - Track·Turn 도착 -> Align 대신 Hold, Align -> Hold(최소 유지 무시), 막힌 동안 Hold 유지
    - 멈춘 뒤 Blocked. I4 의 명령 호 검사도 함께 막는다
    Claude-Session: https://claude.ai/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
2026-09-28 fix(vcc): 최종 리뷰 잔손질 — speed_cap atomic·유턴 방향 고정·정렬 횟수 유지·us_fresh·deactivate 경로 지움·곡률 유지 감속(M1~M6)
    - M1 speed_cap_ 을 std::atomic<double> 로(구독 스레드 쓰기·액션 스레드 읽기)
    - M2 Turn 에 들어갈 때 고른 방향을 잠근다. 재계획은 반지름·방식만 바꾼다(planTurn only_dir)
    - M3 같은 goal 안에서 Align 에 다시 들어와도 도착 횟수·지연 추정을 지우지 않는다
    - M4 /vcc/state 에 us_fresh=<나이 us_max_age 안 채널 수>(설계서 10절)
    - M5 deactivate 가 경로 창과 마지막 goal 도 지운다(설계서 6.2 ⑥)
    - M6 곡률이 있을 때 |v·κ| > max_w 면 v 를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
2026-09-28 test(vcc): bench 로봇이 자기 차선을 따라가게 — d 재동기(I4) 뒤에도 대표 부하를 잰다
    bench 의 로봇은 제자리였다. I4 재동기가 d 를 매 1.5 s 마다 0 으로 되돌려 v 0.10 에 묶이고 계산이
    싸게(p99 2.5 ms) 나왔다. 로봇의 옆 위치를 d 로 두고 세상(레일·벽·기둥)을 그만큼 옮겨 놓는다.
    같은 bench 로 옛 코드(c9154cb) p99 6.23 ms, 새 코드 6.50 ms(-O0, 같은 플래그).
    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
2026-09-28 fix(vcc): 옆 초음파 확인을 이전 호까지 거리로 — 벽 옆 순항에서도 인정
    호 중심끼리 비교하면 옆 채널(±90°)이 긴 벽을 지날 때 매 측정이 벽의 다른 점을 가리켜
    0.36 m/s 넘으면 영영 확인되지 않았다. 연속한 두 측정마다 새 호 중심점이 이전 측정의
    호(받은 순간 센서 자세 기준)에서 tol 안인지로 본다. 정면 접근은 그대로 통과하고
    한 번 튄 값·같은 방위의 어긋난 거리는 여전히 걸러진다.
    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
2026-09-28 test(vcc): 플러그인 시험 costmap 수명 정리·TIMEOUT — 병렬 부하 멈춤 제거
    8개 병렬·섞기 실행에서 "Destroying" 뒤 멈추던 원인을 gdb 로 잡았다. 시험마다 마지막 노드가
    사라져 Fast DDS 참가자가 지워질 때, 같은 도메인의 다른 프로세스를 원격 참가자로 떼어 내다
    FlowController 송신 스레드와 서로 잠근다(PDP::disable ↔ RTPSMessageGroup::send).
    - 프로세스마다 로봇(7)과 다른 도메인(30~99, pid 기준)에 두어 원격 참가자를 없앤다.
    - 모음 동안 붙잡이 노드 하나를 살려 참가자를 시험마다 지우지 않는다.
    - 고정 장치가 costmap 을 cleanup → shutdown 으로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
2026-09-28 feat(guidance): 레일 회전 예고 순수 로직과 오프라인 계산기
    2026-09-28 사용자 합의. 방향지시등 사전 예고를 /plan 대신 Route Server 레일로
    다시 설계한다. 노드 연결 전 단계 — 새 파일 3개뿐, 기존 동작은 바뀌지 않는다.
    VCC 는 검토 중이라 VCC 이전 단계(test_Route_Server c0b2e0e)에서 땄다.
    예고 레일에서 한 방향 45° 이상 꺾이는 코너만, 몸이 돌기 약 2초 전
    사후 기존 yaw 판정(20°) 그대로 — 레일 밖·장애물 회피·목적지 근처(B안)
    중복 예고한 회전을 실제로 돌 때 신호가 끊겼다 다시 켜지면 안 된다
    왜 레일인가: 09-02 롤백 원인은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
2026-09-28 feat(guidance): 레일 회전 예고를 turn_guide_node 에 연결 — 45° 이상 코너를 몸이 돌기 2초 전에
    2026-09-28 사용자 결정. VCC 실기 때 함께 시험할 수 있게 노드에 붙인다.
    바뀐 것
    - turn_guide_node: enable_rail_forecast 가 true 면 /rail_plan(레일)과
    TF map→base_footprint 로 RailTurnArbiter 를 돌려 PREPARE 를 낸다.
    false 면 레일 구독·TF 조회를 아예 안 만들어 이전과 완전히 같다.
    코드 기본값은 false, config 에서만 true (시험이 고정).
    - route_server launch: plan -> /rail_plan remap. route_server 가 상대 이름
    `plan` 으로 게시해 planner_server 의 /plan(당근·마무리)과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
2026-09-28 fix(vcc): 차선 옮김 속도 상한을 목표 속도 기준으로(run48 느림 주범)
    옮김 속도 후보가 실측 속도부터 시작해, 옮기는 동안 speedCap 이 그 값에 묶여
    가속하지 못했다(run48 TRACK 의 31 %, 유턴 뒤 0.1 m/s 로 2~10 s). 후보를
    목표 속도 min(desired, speed_cap) 부터 고르고, 고른 속도가 목표보다 낮을 때만
    묶는다. 옆 간격 진행은 그대로 실측 v 기준(옆 속도 ≤ lane_rate).
    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
2026-09-28 fix(vcc): 레일 옆 오차를 첫 구간 연장선 기준·2주기 확인으로 재동기
    run48 가짜 되튐 75회: 옆 오차를 경로 첫 점(최대 0.74 m 앞)의 자세 방향으로 재
    코너 노드에서 틀렸고, 한 주기 튄 값에도 d 를 옮겼다(64 % 가 새 경로 뒤 0.25 s 안).
    옆 오차는 첫 구간(p0->p1)을 뒤로 늘인 직선까지의 수직 거리로 재고, 문턱
    lane_resync_threshold(0.15)를 2주기 연속 넘을 때만 다시 맞춘다(reset 뒤 첫 경로는
    바로). 유턴을 마치면 d 를 바로 맞추고 목표도 가장 가까운 차선에 둔다.
    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
2026-09-28 fix(vcc): 출력단 되감김 여유 0.15·파라미터화(모터 지연 0.45 s)
    되감김 여유 0.05 가 모터 지연 0.45 s x 램프 0.5 m/s^2(≈0.23)보다 작아 램프 중
    매 주기 명령이 실측 쪽으로 되감겼다(run48 톱니, 0 -> 0.25 에 0.85 s). 여유를
    0.15 로 올리고 ROS 파라미터 resync_margin 으로 뺐다. 0.45 s 지연 모터 모의에서
    0 -> 0.25 가 0.6 s, 0.5 까지 2.4 s, 램프 중 명령 감소 없음. 실제 정지(실측 0)
    뒤에는 0.2 이하에서 다시 올린다.
    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
2026-09-28 fix(vcc): 초음파 가까운 값 즉시 인정·min_range 접촉·1.5 s 기억(노란 콘)
    run48 노란 콘 충돌: front_left 가 콘을 4번 봤지만 코드가 전부 버렸다.
    - 0 < range <= min_range(0.01~0.02 m)는 무효가 아니라 접촉 — min_range 에 둔다.
    - us_near_confirm_range(0.40) 안은 한 값으로 확인한다(두 번째 프레임 0.42 s 대기 없음).
    대가: 가까운 헛 반사 한 번도 장애물로 본다.
    - 채널마다 확인된 값을 us_memory_time(1.5 s) 기억한다. 확인 안 된 값 하나(먼 반사
    1.18 m)로 지우지 않고, 기억 자리보다 tol 넘게 멀리 본 값·에코 없음이 2번 연속일
    때만 지운다. 여유 계산은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
2026-09-30 feat(guidance): 잡음 확인 진동 tick 신설·비상/도착 자동 진동·터치 켜기 (터치×진동 설계 3절)
    - 펌웨어: HAPTIC_CMD_TICK 0x12(300 ms ×1) 추가. applyState() 가 상태가
    바뀔 때만 도므로 ESTOP 진입 = 길게 ×1, ARRIVED 진입 = 짧게 ×3 을 한 줄씩
    넣었다(07-28 계획서 6.2절 edge 트리거 복원, 설계 D4·D6). 컴파일 확인, 미업로드.
    - 드라이버 HAPTIC_PATTERNS·protocol·bench_test 에 tick. 네 곳의 바이트 값을
    test_haptic_contract 가 한데 묶어 고정한다(좌우회전 case 엔 진동 없음 포함).
    - touch_enabled true: ESP32 GPIO14 에 센서 연결(3.3 V·잡으면 LOW, 사용자 09-28).
    - SmartHandl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
2026-09-30 feat(mission): 손잡이 잡기 대기·놓침 정지·다시 잡으면 재출발 (터치×진동 설계 4절)
    - GripMeter(순수): 접촉 비율을 메시지 개수가 아닌 시간으로 잰다. smart_handle_state
    는 바뀐 순간 + 2 Hz 뿐이라 개수로 세면 두드릴 때 부풀고 쥘 때 4개뿐이다.
    1 s 넘게 안 오면 '놓음'(죽은 드라이버가 잡고 있다고 말하지 않게).
    - 잡기 대기(D1·D2): 수락 뒤 손잡이를 내준 세 자리(회전 완료·실패·생략)에서 힌트와
    긴 진동을 같은 순간 내고 2 s 마다 반복. 2초 중 80 % 잡으면 tick + 온보딩(활성),
    15 s 넘으면 온보딩(비활성). 센서가 없으면 곧장 온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
2026-09-30 feat(vcc): 도착 심판 LatchedGoalChecker·멈춤 반경·정렬 재무장 — run49 도착 교착 2/8
    run49 에서 8번 중 2번 도착 판정을 못 하고 섰다(화장실 ALIGN 25 s, 409호 HOLD 17 s).
    갈래 셋을 함께 고친다(사용자 결정 B안 + xy 0.15).
    - LatchedGoalChecker(새 goal checker 플러그인, 같은 .so): 끝점 xy 안에 한 번 들면 위치에
    도장을 찍고 이후 방향·정지만 본다. Humble stateful 은 새 경로마다 reset 으로 지워지고
    레일 BT 는 1 Hz 로 경로를 준다. 도장은 로봇·끝점이 0.5 m 넘게 멀어질 때만 푼다.
    - ALIGN 에서 Track 으로 나가는 거리 xy+0.10(0.35) -> align_exit_dist 0.5(= unlatch).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
2026-09-30 feat(bt): AlignPathEndToGoal — 목적지 경로 끝점 방향만 목적지 방향으로
    run49 경로 30여 개 중 끝점이 목적지와 어긋난 것은 2개(0.13~0.14 m, +27°·−90°)뿐이었지만
    −90° 가 409호 도착 교착 한가운데 있었다. 목적지는 모두 벽에서 0.9~1.6 m 라 '벽 때문' 가설은
    반증됐고, 목적지 0.25 m 언저리에서 lattice 가 tolerance 안 다른 자세로 끝낸 것으로 본다.
    끝점이 목적지 0.5 m 안일 때 방향만 바꾸고 위치는 그대로 둔다. 항상 SUCCESS.
    BT 엔진 로드·포트·동작을 따로 확인했다(위치 1.14 유지, 방향 = 목적지).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
    [test_path_end_align.cpp]
2026-09-30 config(nav2): 도착 판정 LatchedGoalChecker xy 0.15 적용·레일 트리 9판(끝점 방향 맞춤)
    - general_goal_checker: StoppedGoalChecker xy 0.25 -> LatchedGoalChecker xy 0.15, unlatch 0.5.
    되돌리기는 주석에 적었다. 실패 신호: 도착 판정 3 s 넘는 회차가 절반 초과, 0.15 안에 못 들어감.
    - FollowPath: align_exit_dist 0.5, arrive_margin 0.03, align_rearm_time 3.0.
    - 레일 트리: NearGoalKeepPath·LastMile 의 ComputePathToPose(goal) 뒤에 AlignPathEndToGoal
    (Sequence 로 묶음). no_backup 트리는 "기본 트리와의 차이 = BackUp·Spin 뿐" 계약이 있어 두지 않는다.
    - 계약 시험: unlatch == align_exit_dist, arrive_margin < xy/2,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
2026-09-30 feat(nav2): 갈림길 V자 방지 — PenaltyScorer + 0903_d 호 엣지 벌점 + 레일 시험 두 지도로
    - route_server edge_cost_functions 에 PenaltyScorer. 엣지 metadata.penalty 를 비용에 더한다.
    - 0903_d 레일: 모양은 그대로, Y 갈림길 호 엣지 10개(양방향 20)에 penalty 0.1 만 추가.
    재생성(학과사무실 누락)은 다른 회차에서.
    - 계약 시험: 레일 파일 시험을 0630 하나 → 0630·0903_d. 코너 시험은 id 순서 대신 실제
    이웃 각으로. 고리 조건은 0630 에만. 새 시험 3개 — PenaltyScorer 설정, 갈림길 직진 V자
    없음(모양으로 판정: 옛 레일은 27곳 실패, 새 레일 통과), 벌점은 갈림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
2026-09-30 config(vcc): U턴 반지름 [0.2, 0.1] -> [0.4, 0.3, 0.2, 0.1]·끝점 방향 맞춤은 1° 넘을 때만
    run50(09-30) 결과를 받아 두 가지를 고친다.
    - turn_radii: U턴 5회 전부 R 0.20(목록 최대)이었다. 사용자 "U턴이 너무 작다".
    앞에서부터 몸이 쓸고 가는 자리가 비는 첫 반지름을 쓰므로, 트인 곳은 0.4, 좁은 곳은
    자동으로 0.3·0.2·0.1·제자리로 내려간다. 필요 폭 R 0.4 = 1.53 m, 0.3 = 1.35, 0.2 = 1.19.
    성공 신호: U턴 R 중앙값 0.3 이상. 실패 신호: U턴 중 HOLD·collision ahead. 되돌리기 [0.2, 0.1].
    - AlignPathEndToGoal: 사원수를 정확히 같음으로 비교해, 실제 차이 0.0° 인 경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
    [test_path_end_align.cpp]
2026-09-30 feat(interfaces): 레일 편집 서비스 DraftRoute·SaveRoute·GetRoute
    앱 레일 편집(설계서 docs/superpowers/specs/2026-09-28-app-route-editor-design.md 2.5)이
    쓰는 서비스 세 개. 처리는 VICA_Supervisor/ros2/route_graph_node.py.
    - DraftRoute: 지도·장소로 자동 초안 스케치(파일 안 씀, 수 초 걸림)
    - SaveRoute: 스케치 저장(+route_server 적용) 또는 preview_only 미리보기.
    base_version/overwrite 로 다른 곳 저장과 충돌을 가른다.
    - GetRoute: 편집 원본·판·요약(장소별 레일 거리)·적용 상태
    빌드 필요: colcon build --packages-select vica_interfaces (스택을 내린 뒤).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
2026-10-01 fix(nav2): use_route:=true 여도 레일 파일이 없으면 기존 트리 — 레일 트리는 서버 없으면 주행 불가
    터미네이터 nav2 칸이 use_route:=true 를 기본으로 붙이게 되면서(10-01) 레일 파일 없는
    지도가 문제가 됐다. 종전 launch 는 플래그만 보고 BT 를 레일 트리로 바꿨는데, 파일이
    없으면 route_server 를 띄우지 않는다. 공식 BtActionNode 는 서버가 없으면 트리 생성 때
    예외를 던진다(humble bt_action_node.hpp 101~108행) — 목적지마다 실패해 주행이 안 된다.
    select_bt_expression: use_route 참 **그리고** 레일 파일(route_graph 또는
    <지도>_route.geojson)이 있을 때만 레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
2026-10-01 config(vcc): turn_clearance 0.05 -> 0.15 — U턴 중 차체-벽 최소 간격 약 10 -> 20 cm
    run51(09-30, bag 유실) 사용자: 복도 R 0.4 는 좋지만 화장실 통로는 느리고 불안, 0.3 이어야.
    그 순간 collision ahead 2회. 호 전체를 미리 돌려 보고 가장 가까운 순간의 여유가 0.05 만
    남아도 큰 반지름을 골랐던 것으로 본다. 같은 기준으로 0.4 -> 0.3 -> 0.2 -> 0.1 -> 제자리.
    성공 신호: 복도 R 0.4, 화장실 통로 R 0.3 이하, U턴 중 collision ahead 0.
    실패 신호: 복도에서도 R 0.2 이하로 떨어지거나 HOLD(돌 자리 없음)가 생긴다. 되돌리기 0.05.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
2026-10-01 test(nav2): 도착 정지거리 계약을 VCC 도착 감속 기준으로 — 최고 속도 상향 대비
    옛 계약은 "smoother 최고 속도에서 바로 완만히 서도 허용오차 안" 이다(DWB 시절).
    VCC 는 끝점 0.6 m 안에서 거리 비례로 줄이고 멈춤 반경(xy − arrive_margin)에서 0 을 내므로,
    멈춤 반경에 닿는 속도 + 지연 0.3 s 로 정지거리를 잰다. 기준(허용오차 안에서 선다)은 그대로.
    최고 속도 0.5/0.7/0.8 에서 0.034/0.050/0.058 m < 0.15. 다른 컨트롤러는 옛 식 유지.
    설정 변경 없음(사용자: 최고 속도 0.7 은 결정만, 적용 보류).
    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
2026-10-01 config(vcc): curve_min_radius 1.2 -> 0.8 — 코너 과감속 완화
    run50 코너 6곳(40~79°): 차선 경로를 20 cm 세 점으로 읽은 반경 0.35~0.7 m 로 0.14~0.30 m/s
    까지 줄였는데, 실제 회전 반경은 0.9~1.7 m 였다(조준점 0.6~1.2 m 가 꺾임을 깎음).
    0.8 이면 같은 판독에서 0.22·0.31·0.44 m/s(읽은 반경 0.35·0.5·0.7). 사용자: 0.6 은 너무 확.
    성공 신호: 코너 최저 속도 평균 ≥ 0.25, 비틀거림 증가 없음. 실패: 코너에서 벽 쪽 붙음·collision ahead.
    되돌리기 1.2.
    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
2026-10-01 config(vcc): 최고 속도 0.5 -> 0.7 — 출발 2단계·코너 미리 줄이기·장애물 감속 거리를 1.4배
    사용자 결정(10-01, run52 뒤). run50 기준 0.5 에서 명령은 0.5 를 끝까지 냈다(실제 0.51~0.58).
    - VCC desired_linear_vel 0.7 + velocity_smoother max_velocity[0] 0.7(한 세트, 한쪽만이면 0.5 로 잘림).
    - linear_accel 0.143 -> 0.2: 0.25 -> 0.7 을 2.25 s. 출발 1단계(0 -> 0.25 를 0.5 s)는 그대로
    (0.7 m/s² 는 손잡이 사용자 "급함" 기록).
    - curve_decel 0.3 -> 0.42: 같은 1.5 m 미리보기 안에서 줄이게.
    - slow_clearance 0.35 -> 0.49: 사람·장애물 옆을 지나는 속도는 0.5 시절과 같게.
    - 그대로: 제동 1.25(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
2026-10-01 config(vcc): turn_clearance 0.15 -> 0.30 — 화장실 앞 U턴은 R 0.3, 복도는 R 0.4
    run52(10-01) 사용자: 화장실 통로는 R 0.3 이 맞다. 라이다 7장 중앙값으로 화장실 앞 R 0.4 여유 0.25,
    R 0.3 0.41, 407 앞 복도 R 0.4 0.45 → 0.30 이면 화장실만 한 단계 작아진다. 실제 차체-벽 최소 ≈ 35 cm.
    409 앞은 기록이 흔들려 불확실. 최고 속도 0.7(9515aaf)과 같은 회차에 처음 달린다(사용자 지시).
    성공: 화장실 앞 R 0.3, 복도 R 0.4, U턴 중 HOLD·collision ahead 0. 되돌리기 0.15.
    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
2026-10-01 config(vcc): min_approach_linear_velocity 0.05 -> 0.10 — 도착 직전 기어가기 단축
    run52(10-01) 409·테스트1: 휜 경로 끝에서 코너 감속(0.12)에 거리 비례 감속이 곱해져 마지막
    0.3 m 를 0.05 m/s 로 3~5 s. 최저값은 거리 비례 감속만 막고 다른 감속은 덮지 않는다(min 바깥).
    멈춤 지점 0.12 에서 0.10 m/s → 약 3~4 cm 더 가 목적지 ~8 cm 안. 계약 시험 0.050 m 그대로.
    최고 속도 0.7(9515aaf)·turn_clearance 0.30(955139c)과 같은 회차에 처음 달린다(사용자 지시).
    성공: 0.6 m 진입 → 멈춤 3 s 이하, 0.1 m/s 미만 구간 1 s 이하. 되돌리기 0.05.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
2026-10-01 config(vcc): slow_clearance 0.49 -> 0.35 — 사람 앞에서 너무 멀리 서는 것 완화
    run53(10-01) 사람 앞(테스트1 가는 길 166~180 s): 차체 앞면 0.86 m 에서 감속 시작, 0.74 m 부터
    0.03~0.1 m/s 로 기어감. 요인 셋 중 VCC 몫인 slow_clearance(9515aaf 에서 1.4배로 올린 값)만 되돌린다.
    collision_monitor 감속 구역(앞 0.74 m)은 0.7 m/s 에서 정지 구역을 지켜 주므로 그대로.
    성공: 사람 앞 감속 시작이 ~0.7 m 안쪽. 되돌리기 0.49.
2026-10-01 feat(vcc): U턴 반지름 선택 30 cm·유지 15 cm 분리 — 도는 중 제자리로 떨어지는 것 방지
    run53(10-01) 화장실 앞 U턴 2회: turn_clearance 0.30 하나로 매 주기 0.4 부터 다시 고르니 벽에
    다가가며 0.4 -> 0.3 -> 제자리로 떨어졌고, 제자리는 그 U턴 끝까지 고정됐다(9/75·36/102 주기,
    turn_blocked HOLD, 제자리 47° 3.6 s). 사용자: "이후에도 0.3 여유가 있어야 하니 제자리 회전하듯".
    - planTurn(..., keep): 도는 중이면 지금 방식·반지름의 남은 호를 keep_clearance 로 먼저 보고
    통과하면 그대로 둔다. 실패하면 종전대로 처음 기준(clearance)으로 다시 찾는다.
    - 도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
2026-10-01 config(vcc): U턴 반지름 최대 0.3·여유 0.20 하나로 — run54 U턴 대기 10~14 s 해소
    run54(10-01): 고를 때 0.30 이 마지막 수단인 제자리 회전에도 걸려(화장실 앞 제자리 여유 ≈ 0.27)
    turn_blocked 10.6·13.7 s. U턴 시간은 회전 0.45 rad/s 고정이라 각이 정하고, 화장실 앞 R 0.4 가
    11 s 걸린 것은 앞면이 벽 쪽으로 쓸려 collision_monitor 감속(6~8 s) 때문이다(R 0.2 는 6 s, 감속 0).
    복도는 R 0.4 6.1~7.9 s vs R 0.2 6.7 s 로 차이 없다.
    - turn_radii [0.4, 0.3, 0.2, 0.1] -> [0.3, 0.2, 0.1](사용자 결정: 최대 0.3).
    - turn_clearance 0.30 + turn_keep_clearance 0.15 -> turn_clearance 0.20 하나(keep 줄 삭제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
2026-10-01 fix(firmware): 재제작 보드 핀 반영 — 레벨시프터 OE 16→4, 진동 4→16, 부팅 직후 진동 방지
    2026-10-01 핸들 보드를 다시 만들며 사용자가 OE 와 진동 핀을 맞바꿨다(터치 14·LED 17/18·
    서보 19 는 그대로). GPIO4 는 스트래핑 핀이 아니라 부팅에 영향 없음. L9110 입력은 비어 있으면
    모듈이 HIGH 로 끌어올려 부팅 동안 모터가 돌기 때문에(09-30 실측) setup() 맨 처음에 진동 핀을
    LOW 로 잡는다. 보드(…6b:c0)에 통합 이미지로 기록·검증 완료, 주변장치 미연결 상태에서 터치·초음파
    프레임 정상 송신 확인.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
    [smart_handle_firmware.ino]
2026-10-01 feat(bt): 레일 안쪽 문 문턱 두 개(나갈 때 0.8·돌아올 때 0.5) — 레일↔자유주행 경로 교대 억제
    run52~54(10-01): 로봇이 레일에서 0.75~0.9 m 에 머물면 안쪽 문(NearRailGate 0.8 m)이 1 Hz 로
    열렸다 닫혀 레일 경로와 복귀 당근(planner) 경로가 번갈아 controller 에 갔다.
    robot far from path 25~32회, VCC 차선 d 0 <-> 0.6 점프 2.9~6.9회/분, 짧은 정지·코너 급정지 1회.
    - RailDistanceGate(순수): 한 번 max_dist 밖으로 나가면 rejoin_dist 안으로 들어와야 다시 통과.
    목적지가 0.5 m 넘게 바뀌면 처음부터. IsRoutePathUsable 노드 자리마다 따로 기억.
    - 포트 rejoin_dist_from_path(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
2026-10-01 config(nav2): global 인플레이션을 벽 0.55·새 물체 0.35 로 분리 — 사람 앞 큰 우회 줄이기
    run55(10-01) 긴 복도: 사람이 복도(3.15 m) 가운데 서자 계획기 경로가 사람 주위 0.55 띠를 피해 옆으로
    0.57~1.33 m 벌어졌고, VCC 가 그 경로를 따라 90° 가까이 틀었다 되돌아와 비틀거렸다(TURN 4회).
    - InflationLayer 는 자기 차례에 이미 찍힌 LETHAL 주위만 칠하고 덧칠은 max(old, new)(Humble 소스 확인).
    global plugins 를 static_layer -> inflation_layer(0.55) -> obstacle_layer -> obstacle_inflation_layer(0.35)
    로 두면 지도 벽은 0.55, 지도에 없던 물체(사람·의자·콘)는 0.35 띠만 받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
2026-10-01 feat(maps): 0630 레일을 앱에서 새로 그림 — 첫 앱 레일 저장(10-01)
    관리자 스케치 노드 14·선 14 → route_graph_node 가 다듬은 레일 노드 61·31.0 m·갈림길 4
    (Y 2곳 벌점 엣지 10). 장소 9곳 전부 레일 2 m 안(가장 먼 입구 1.0 m).
    알림 7건(저장은 허용): 벽 0.70 m 안 4곳(최소 0.43 m @ -3.97,4.64 · y 5.6~5.8 위쪽 복도 3곳),
    뾰족한 코너 2곳(64°·73°), Y 로 못 만든 갈림길 1곳(-5.56,3.23). 주행 때 이 근처를 볼 것.
    _route_edit.json 은 앱 편집 원본(다음 편집의 출발점). 옛 레일은 maps/.route_backup/ 에
    백업돼 있다(커밋 안 함). 실주행 전.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
2026-10-02 feat(maps): 0630 앱 레일 3판 — 화장실 U자 삭제·위 복도 갈림 + 화장실 가지 (run59 실주행 8/8)
    - 옛 레일(고리 하나·되돌이 끝점)은 run57 에서 출발 때 경로가 뒤집혀 맴돌았다(화장실 35 s·863°)
    - 2판(10:30): 뾰족 끝 제거, 골목 꺾임 노드를 옮겨 R 0.5 곡선이 들어가게 함 — run58 도착 9·맴돌기 0
    - 3판(11:11): 화장실 U자 대신 갈림 31(0.90, 5.68) + 가지 33. 휴게실→작업실 10.8→6.4 m,
    급한 코너 알림 0, 출발 ±0.4 m 경로 갈림 0 — run59 도착 8/8·회피 실패 0·최장 유턴 5.7 s
    - 2판은 maps/.route_backup/ 에만 남김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
2026-10-02 chore(maps): 안 쓰는 옛 지도 정리(사용자 삭제)·0630/0910 금지구역을 현재 앱 저장본으로
    - 사용자가 지운 옛 지도·금지구역(robot-4_0903, vica_map_00·01·0810·0819·0829·0903 계열 등)을 저장소에서도 삭제
    - 0630 금지구역: 앱 저장본(09-21, 구역 1개)과 마스크 pgm 을 함께 올림 — yaml 이 가리키던 pgm 이 저장소에 없던 상태 해소
    - 0910 금지구역: 앱이 만든 빈 마스크(구역 0개) json·pgm·yaml 추가
    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
    [robot-4_0903.yaml, robot-4_0903_keepout.yaml, robot_0903.yaml]
2026-10-02 feat(mission,nav2): 사람 접근은 레일 없이 자유주행 — 접근 goal 에만 전용 트리
    run60(시연 지도): 사람은 시작 지점 정남쪽 2.6 m 였는데 접근 goal 이 레일 트리로 가서
    레일을 8.5 m 돌았고, 레일 경로와 복귀 당근이 번갈아 와 87 s·1889° 맴돈 뒤 취소됐다.
    사람은 레일 위가 아니라 방 가운데 서 있고 접근 중엔 뒤에 사람이 없으므로 처음부터
    자유주행이 맞다.
    - vica_nav2/behavior_trees/vica_navigate_to_pose_approach.xml: 레일 트리의 "목적지까지
    자유주행" 갈래(GoalReached 문지기 + ComputePathToPose(GridBased) + AlignPathEndToGoal)와
    FollowPath(VCC)·복구(20회, co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
2026-10-05 config(vcc): 최고 속도 0.7 -> 0.6 — 출발 2단계·코너 미리 줄이기를 0.5 기준 1.2배로
    사용자 결정(10-05, 시연 준비). 10-01 에 0.7 로 올리며 1.4배로 맞췄던 값들을 0.6 에 맞춰 1.2배로.
    - VCC desired_linear_vel 0.6 + velocity_smoother max_velocity[0] 0.6(한 세트)
    - linear_accel 0.2 -> 0.17: 0.25 -> 0.6 을 약 2.1 s(0.5 때 1.75 s, 0.7 때 2.25 s)
    - curve_decel 0.42 -> 0.36: 같은 1.5 m 미리보기 안에서 줄이게
    - 그대로: slow_clearance 0.35(10-01 사용자 결정, 0.5 시절 값), 출발 1단계(0 -> 0.25 를 0.5 s),
    제동 1.25(정지거리 약 0.41 -> 0.32 m, 지연 포함), curve_min_radius 0.8, 도착 감속 0.6/0.10, 회전 0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
2026-10-05 feat(mission): 접근 질문·온보딩 짧은 원고 설정 short_approach_ments — 인수인계 "로컬 LLM 정비" 1번
    로컬 LLM 실행에서 접근 질문·온보딩을 줄인다. 이 멘트는 LLM 이 아니라 미션이
    말하므로 LLM 종류로 자동으로 갈리지 않는다 — 설정값으로 고른다. 기본 false 라
    값을 안 넘기면 지금 문구 그대로다.
    - 접근 질문: "안녕하세요? 시각장애인 안내로봇 비카입니다. 안내를 받으시겠어요?"
    - 온보딩: "저에게 말을 거실 때는 '비카야'라고 불러주세요. 어디로 가고 싶으신가요?"
    mission_manager_node 의 tts_done 대조도 지금 쓰는 원고로 바꿨다 —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
2026-10-05 fix(bt): 레일 거리를 '레일 선까지 옆 거리'로 — 지워진 출발 노드 착시 제거
    route_server 는 로봇이 첫 노드를 지나쳤으면(dot>0) 옆으로 얼마나 떨어졌든
    (max_prune_dist_from_edge 8 m) 그 노드를 지운다. IsRoutePathUsable 은 남은 경로의
    '가장 가까운 점'까지 거리를 재서, 노드가 지워지면 옆 거리는 그대로인데 잰 거리만 튀었다.
    근거(시연 지도 run61, 2026-10-02):
    - 시작→홈 출발 6.8 s: 유턴 호로 레일 옆 0.72 m 인데 1.01 m 로 재 0.8 m 문턱을 넘음
    -> 레일 3 m 앞 당근(모퉁이 너머 동쪽 변)으로 경로가 바뀌어 조준이 89° 어긋남
    -> VCC 회전 모드로 7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
2026-10-05 feat(bt): 레일 앞 막힘 검사를 몸통·0.5 m 건너뛰기로 — IsPathValid 대신 IsRailAheadClear (해결안 B)
    Nav2 1.1.20 IsPathValid 는 레일 앞 3 m 조각의 첫 점부터, 손잡이 꼬리까지 포함한 몸 윤곽을
    올려 본다. 그러면 로봇이 지금 서 있는 자리의 주변 — 손잡이 뒤에 선 사람, 곡선에서 옆으로 휘는
    꼬리 옆 벽 — 을 "앞이 막혔다"로 읽고 레일을 버려 지름길(당근)로 바꿨다. 홈→시작 코너가 각지게
    끊어 돈 원인 ①.
    근거(시연 지도 bag 재계산, global costmap 기록 + footprint 패딩 0.05):
    - 막힘 판정 첫 접촉 부위: run61 68번 중 손잡이 꼬리 38, run63 31번 중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
2026-10-05 feat(mission): 접근 질문·온보딩을 짧은 원고로 통일 — short_approach_ments 설정 제거
    9dca21d 에서 설정값(short_approach_ments, 기본 false)으로 로컬 실행만 짧은
    원고를 쓰게 했던 것을 걷어내고, 짧은 원고를 하나뿐인 정본으로 삼는다(사용자
    결정 10-05). 이 멘트는 LLM 이 아니라 미션이 말하므로 OpenAI·로컬 모두 같은
    녹음이 나간다 — LLM 종류로 가를 이유가 없다.
    la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
2026-10-05 feat(vcc): 유턴(Turn)의 끝을 정한다 — 목표 방향 붙들기·다시 고르기·누적 360° 상한·진입 0.3 s (해결안 C)
    Turn 은 들어갈 때 방향을 잠그고 "조준각 < 25°" 에서 끝난다. 그런데 경로가 매초 로봇 자리에서 다시
    그려지거나 레일↔당근으로 바뀌면 조준점이 로봇과 함께 돌아 끝 조건이 영영 안 맞았다(꼬리 잡기).
    누적 회전 상한도 없었다.
    근거:
    - run60 사람 접근: 73 s 연속 Turn, 반지름 0.33 m 원 5바퀴(1,889°), 사용자 취소
    - run63 시작→창구: R0.3 좌회전 중 실제 0.82 m 이탈 → 당근으로 바뀌어 조준이 남동(−89°)인데 좌회전
    잠금이라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
2026-10-05 feat(firmware): 스마트핸들 보드를 ESP32U 에서 아두이노 나노로 되돌린다
    ESP32 보드가 레벨시프터·GPIO 손상으로 고장 나 09-22 이전의 나노(FT232RL,
    serial B003UMKG)로 돌아왔다. 핀맵은 하드웨어 인수인계 문서(2026-10-05) 기준.
    - 핀: 터치 D2 · 진동 D7(L9110 A-IA) · 서보 D9 · LED 왼쪽 D10 · 오른쪽 D12 ·
    I2C A4/A5. 5V 보드라 레벨시프터·OE 핀이 빠진다.
    - LED 줄당 21개(실측). 20 이면 끝 1개가 갱신되지 않았다.
    - LED 좌우: "왼쪽" 명령에서 물결이 D12 줄로 흘러 D10=왼쪽으로 맞바꿈(실물 확인).
    - 서보: Adafruit_TiCoServo(Timer1 하드웨어 PWM, D9). 표준 Servo.h 는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
2026-10-05 fix(nav2): keepout 관리자가 얼어붙어도 마스크 서버 둘을 직접 살린다 [실기 전]
    증상(2026-09-03 17:20, vica_map_0903_1): lifecycle_manager_keepout 이
    keepout_costmap_filter_info_server 의 configure 응답을 잃고 Configuring 에서
    영원히 멈췄다(SIGKILL 로만 죽음). costmap 은 "KeepoutFilter: Filter mask was
    not received" 를 62회 찍었다.
    원인: nav2_util 의 change_state(transition) 은 시간제한이 없다
    (lifecycle_service_client.hpp 48행 → service_client.hpp 98행 invoke →
    spin_until_future_complete 무한 대기). get_state 는 2초 제한이라 어제
    collision_monitor 의 manage_nodes 재시도는 통했지만, 얼어붙은 관리자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
2026-10-05 feat(vcc): 경로 끝 연장 조준 + 지나침 도착 — 도착 정렬 전 반대 회전 제거 (해결안 가)
    도착할 때 정렬이 원래 방향의 반대로 1~17° 먼저 돌았다가 다시 제대로 돌았다(run62~64 도착 16번 중 9번).
    원인: 경로 끝이 L(0.6 m) 안에 들어오면 조준점이 끝점 하나로 쪼그라든다. 끝점이 0.05 m 앞·옆 4 cm 면 조준각
    39°, 곡률 2y/d² 가 19 1/m 까지 커져 회전 명령이 최대(±0.5)에 붙는다. 꺾는 방향은 그 몇 cm 가 정해 목적지
    방향과 무관했고, 정렬은 그 회전을 각가속 1.2 rad/s²(0.4 s)·모터 지연 0.4 s 동안 되돌려야 했다.
    (경로 자체는 마지막 0.6 m 가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
2026-10-05 feat(mission): 시연용 손잡이 스위치 — 진동 안내 5초 뒤 잡은 것으로 넘어간다
    10-06 시각장애인 대상 시연. 터치 모듈(LTK-01)이 고장 나 손을 안 대도 "잡음"을
    내므로(10-05 실측: OUT 선 뺀 채 35 mV) OUT 선을 빼고 시연한다.
    - grip_assume_held(새 파라미터, launch 기본 true): 잡기 대기 시간이 다 되면
    못 잡았어도 잡은 것으로 처리 → 확인 진동(tick) + 온보딩. 출발 때 활성 모드를
    쓰지 않아 손 놓침 정지가 걸리지 않는다(선이 빠져 늘 "놓음"이라 켜 두면
    출발 0.5 s 만에 선다).
    - grip_wait_timeout_sec launch 기본 15.0 → 5.0: 진동 안내(2초마다 길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
2026-10-05 config(vcc): run66 시험 — VCC 만 초음파를 받지 않는다(ultrasonic_topics 를 안 쓰는 토픽 하나로)
    run65(0630, 핸들 나노·초음파 8 첫 연동)에서 멈칫이 3.3/분으로 같은 지도 run58·59(0.7/분)의 4.7배였다.
    멈칫 11번 중 8번이 VCC 차선 옮김(속도 0.3/0.2/0.1 상한)이었고, 차선 목표 바뀜이 20.2/분(run58 6.1)으로
    67번 중 63번이 초음파 1.2 m 안 감지 순간이었다. 그때 VCC 가 놓은 초음파 호 151개 중 102개(68 %)는
    라이다로 빈 곳 — 30° 원뿔의 최근접 거리 하나를 호 7점 전체로 놓아 가장자리 벽·바닥 반사가 차선 위
    장애물이 된 것으로 본다.
    같은 조건에서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
2026-10-06 tune(firmware): 서보 좌우를 가운데에서 30도씩으로 줄인다 — 패들 교체 뒤
    서보 패들을 바꾼 뒤 좌우 끝(180/0, ±90도)이 너무 커서 사용자 요청으로
    SERVO_LEFT 120 · SERVO_RIGHT 60(±30도)으로 줄였다. 가운데 90 은 그대로다.
    결과(2026-10-05 나노 실물): 좌우 시험에서 서보가 ±30도로 움직이고 패들이
    걸리지 않음, '왼쪽' 명령에서 서보·LED 물결 둘 다 왼쪽(사용자 확인). 이어서
    VCC 실주행에서도 정상(사용자). 나노 컴파일 33 %/34 %, 계약 시험 37 통과.
    Claude-Session: https://claude.ai/code/session_01YE5j95Z2JJ8NQVai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
2026-10-06 feat(vcc): 평상 감속과 비상 감속을 나누고 최고 속도를 0.5 로 되돌린다 (해결안 ①)
    run66(초음파 끔)에서 멈칫은 사라졌지만 사용자 "감속이 너무 확 된다".
    감속 25번(14.9/분) 중 23번이 코너·도착·차선 옮김·옆 여유처럼 미리 계산된
    속도 상한이었는데, OutputStage 가 내려갈 때는 모두 비상 제동 1.25 m/s² 를 썼다.
    - OutputParams.planned_decel + Desired.planned: Track 의 상한은 평상 감속으로 내린다.
    조준점이 뒤(need)·Hold·충돌 직전은 그대로 1.25 / 즉시 0.
    - 새 파라미터 planned_linear_decel 0.5 (없으면 max_linear_decel 과 같아 예전 동작).
    최고 0.5 에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
2026-10-06 config(vcc): 최고 속도 0.5 -> 0.7 — 가감속을 0.5 기준 1.4배로
    run67(최고 0.5·평상 감속 0.5)에서 사용자 "감속이 부드럽다" 뒤, 사용자 결정으로 최고를 0.7 로 올린다.
    10-01 0.7 때와 같은 1.4배 비율로 함께 옮긴다.
    - desired_linear_vel 0.5 -> 0.7, velocity_smoother max_velocity[0] 0.5 -> 0.7
    - linear_accel 0.143 -> 0.2 (0.25 -> 0.7 을 2.25 s)
    - curve_decel 0.3 -> 0.42
    - planned_linear_decel 0.5 -> 0.7 (최고 -> 0 이 0.5 때와 같은 1.0 s, 거리 0.25 -> 0.35 m)
    - 그대로: 출발 1단계 0.25 m/s·0.5 m/s², 비상 제동 max_linear_decel 1.25, slow_clearance 0.35(10-01 사용자 결정)
    계약 시험 10 통과(curve_decel <= pla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
2026-10-06 fix(mission): 복귀 재개 사다리가 대화 중에는 기다린다 — 되묻기 답을 듣는 중 '응답이 없어' 출발 방지
    2026-10-06 15:20 실기: 복귀 중 '비카야'로 멈춘 뒤 로봇이 되물어(clarify) 답을
    기다리는데, 사다리가 브레이크 시각 기준 15초만 보고 예고 후 떠났다.
    - 복귀가 끊긴 IDLE 에서 intent 가 오면(대화가 오감) 시계를 그 시각부터 다시 잰다.
    - 귀가 열려 있거나 말이 LLM 으로 가는 중(_ear_holds)이면 예고·출발을 미룬다
    — 예고 중 '비카야'도 여기서 잡힌다.
    시험 4개 추가. test_progress_narration 3건 실패는 HEAD 에서도 같은 기존 실패.
    Co-Authored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
2026-10-06 chore(maps): 시연테스트(map_1002_150946)·복지관(map_1006_150446) 지도 추가
    run60~64 시연 지도와 run68 새 지도(10-06 15:04). 지도·금지구역·레일(geojson·앱 편집본)·표시 이름(meta.json).
    팀원이 최신 dev 에서 같은 지도로 작업하도록 올린다. 목적지 목록은 기존대로 저장소 밖(~/vica_data/destinations/)에 둔다.
    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
2026-10-07 feat(mission): 사람에게 다가가기 시작할 때 '안내로봇 비카가 다가가고 있어요.' 한 번
    2026-10-07 사용자 결정: 후진음은 '피하라'로 들려 쓰지 않고, 다가가는 것이 무엇인지 말로
    먼저 알린다. 접근 첫 승인(IDLE→APPROACHING)에서만 말하고 goal 갱신에서는 반복하지 않는다.
    Say 를 Navigate 앞에 둬 소리가 움직임보다 먼저 나간다. 다가가는 동안의 위치 알림은
    음성 쪽 차임(dialog_state=approaching) 몫. 구운 판은 음성 assets/baked 에 같은 글자로 넣을 것.
    시험 3개. test_progress_narration 3건 실패는 HEAD 기존 실패.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
2026-10-07 fix(mission): 접근 인사 문구를 '동행로봇 비카가 다가가고 있어요.'로 (사용자 청취 후 수정)
    '안내로봇'으로 구운 판이 어색하다는 사용자 판단(2026-10-07). 음성 assets/baked 의 구운 판도
    같은 글자로 다시 굽는다(글자 일치가 재생 조건).
    Claude-Session: https://claude.ai/code/session_019d3r5Lo3xoGRrEm7mcZ2QE
    (cherry picked from commit 95f84bdfaaf4cea8eba77506632a1651c4194612)
2026-10-07 feat(wait-spot): 안내 도착은 위치만, 대기 장소로 혼자 이동·앱 알림·가보기
    인수인계 문서 '작업 계획' 탭 1·2·3번(LLM 외). '비카야' 처리 옮기기(3번)는 음성과 같은 날.
    - RobotState 에 door_side·wait_place. destinations.yaml 에 door_yaw·wait_spot(저장·로더).
    - 미션: 상태 WAITING_RELEASE·MOVING_TO_WAIT_SPOT·MOVING_BACK_TO_DEST, M1(도착 멘트와
    한 발화)·M2/M2′·M3(10초)·M6·M7, 은/는 함수, 대기 시간은 M2 순간부터, 대기 중
    '비카야'는 대기 유지, 막힘 → M6·목적지 복귀·wait_spot_blocked, 만료 → M7·홈·
    wait_expired(키 wait_place·wait_minutes), 배송 도착 방향 = door_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
2026-10-07 feat(vcc): 위치만 판정하는 도착은 checker 원에 닿으면 바로·곧게 선다
    인수인계 문서 '작업 계획' 3번 '위치에 닿으면 바로 정지'. 사용자 안내 도착(position_goal_checker,
    yaw 허용 3.141)은 정렬이 없어 Track 에 남은 채 멈춤 반경(0.12)까지 끝점을 조준해 마지막에 꺾었다.
    - yaw_tol >= position_only_yaw_tol(3.0) 이면 dist < xy_tol(0.15)에서 속도 0·곡률 0.
    - 급정지 아님: 끝점 0.6 m 안 접근 감속으로 원 경계 약 0.17 m/s, planned_linear_decel 0.7 로
    약 0.25 s·2 cm. 방향까지 맞추는 도착(홈·배송·대기 장소)은 그대로. 끄기: 파라미터 0.
    - 시험 VccCorePositionOnly 3건.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
2026-10-07 feat(mission): '비카야' 반응표·주행 중 목적지 바꾸기·도착 답 관문 — 작업 계획 3번
    인수인계 문서 '작업 계획' 탭 3번(미션 + 음성 같은 날). vica-voice-llm 의 같은 이름 브랜치와
    함께 올린다 — 새 미션 + 옛 TTS 면 M3 의 "ambient:…"를 글자로 읽는다.
    - "비카야": on_wake_call 이 호출 반응표대로 정한다. 대답하는 상태 = 말 끊기·"네?"·WakeReply(listen),
    다가가는 중·도는 중·주행 실패·대기 장소로 가는 중 = 침묵 + ignore, 비상 정지 = "지금은 비상 멈춤
    상태입니다."만. 노드가 /vica/wake_reply("listen:N"/"ignore:N")를 낸다. 창 안 구제(/vica/wake
    "r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
2026-10-07 feat(mapping): 지도를 바르게 세워 저장 — 저장 팝업 '정렬해서 저장'(10-07 사용자 확정)
    Cartographer 는 매핑 시작 순간 로봇이 본 방향을 map +x 로 잡아 저장 지도가
    그만큼 기운다(저장된 6장 0.9~5.4°). yaml origin yaw 는 costmap 이 버리므로
    그림을 돌리고 origin x·y 를 다시 잡는다.
    - map_align.py(새): 기울기 측정(투영 막대, 벽칸 8000 상한), 회전(nearest 역매핑
    + 원본 벽칸 찍기 + 빈칸만 3×3 closing, 25만 칸씩), 2° 미만은 그대로, 원본은
    maps/.original/<id>.pgm·.json(B안), 실패 시 yaml 바이트 복원·사본 정리
    - SaveMap.srv: 요청에 bool align (옛 앱은 false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
2026-10-07 test(mission): 가짜 노드에 Nav2 준비 확인을 채운다 — 7789aed 뒤 노드 시험 16건 실패 수리
    7789aed 가 _start_nav 에 '_nav2_ready() 가 아니면 보내지 않음'을 넣었는데, 시험의 가짜 노드는
    액션 서버가 없어 늘 '미준비'라 goal 이 안 나가 16건이 깨졌다(ROS 환경을 켜야 도는 시험이라
    환경 없이 돌리면 건너뛰어 안 보였다). 미준비 거부 시험 1건 추가. 미션 733 통과(원래 실패 5).
2026-10-08 config(vcc): 최고 속도 0.7 -> 0.5 — 시연은 0.5(사용자 결정, run69 뒤)
    8884069 의 다섯 값을 0.5 기준으로 함께 되돌림: desired_linear_vel 0.5, planned_linear_decel 0.5,
    linear_accel 0.143, curve_decel 0.3, velocity_smoother max_velocity[0] 0.5. nav2 설정 계약 시험 통과.
    Claude-Session: https://claude.ai/code/session_01HLq66m6re2BYEkRfzaURkJ
2026-10-08 fix(guidance): 목적지 2 m 안 코너에는 회전 신호를 묶지 않는다 — 도착 뒤 왼쪽 신호가 남던 결함
    run69(10-08) 홈 도착 뒤 손잡이 왼쪽 신호가 63 s, 앞선 홈 도착 뒤 180 s 남았다. 레일 끝에 실제로
    없는 156°·160° U턴 코너가 생겼고, 도착 정렬 회전(왼쪽 20°)이 _claim 으로 그 코너에 묶인 뒤
    '코너 끝을 지날 때까지 유지'(pose.s <= end_s + 0.3)가 멈춘 로봇에서 영영 참이었다.
    _claim 에 예고(_next_prepare)와 같은 '남은 레일 handoff_m(2 m) 안이면 묶지 않음'을 넣었다.
    bag 재연(설치본): 15 s 넘는 신호 1건(180 s) -> 0건, 최장 12.3 s(실제 제자리 U턴).
    시험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
2026-10-08 fix(guidance): 달리며 비키는 작은 회전(35° 미만)에는 방향 신호를 켜지 않는다 — run69 차선 옮김 깜빡임
    run69(10-08) 짧은 신호(1.3 s 이하) 9번 중 대부분이 곧은 길에서 장애물을 비키는 차선 옮김이었다.
    몸이 S자로 21~33° 틀었다 돌아오는데 20° 사후 판정이 그때마다 0.8~1.3 s 켜졌다.
    0.25 m/s 이상 달리는 중, 레일 코너에 묶이지 않는 새 회전은 35° 를 넘어야 켠다.
    제자리 회전·느린 출발 유턴(0.25 m/s 미만)과 레일 코너 회전은 지금처럼 20° 에서 켠다.
    예고 중 반대로 작게 비키면 예고를 유지하고, 35° 를 넘게 틀면 새로 알린다(B안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
    [turn_guide_node.py, user_guidance.yaml]
2026-10-08 config(vcc): 초음파 앞쪽 2개(front_left·front_right)만 다시 읽는다 — 사용자 결정, run69 뒤
    10-05 run66 부터 VCC 는 초음파를 받지 않았다(빈 토픽 /ultrasonic/vcc_off). 바퀴 옆 2개는 끈 채로 둔다.
    다음 주행에서 차선 옮김 횟수(run65 20.2/분, run58 6.1/분)를 다시 잰다.
    끄기: ultrasonic_topics 를 ["/ultrasonic/vcc_off"] 로.
2026-10-08 fix(vcc): 새 경로 첫 주기의 정지거리 '닿는다'는 다음 주기에 한 번 더 확인하고 선다 — run69 헛 정지 2회
    run69(10-08) 205 s(사용자가 손잡이를 잡은 채)·1225 s 에 앞 2 m 가 비었는데 0.6 s 섰다. 둘 다 새 경로가 온
    첫 주기였다. 정지거리 검사는 '경로 선 + 차선 메모' 위에 몸을 놓고 보는데, 205 s 는 새 선 방향으로 몸을 돌려
    놓아 지나친 물체에 꼬리가 닿았고, 1225 s 는 옛 차선 메모(재동기는 일부러 2주기 대기)를 새 선에 얹어 몸을
    벽 쪽 0.26 m 에 놓았다.
    setPlan 이 core.onNewPath() 를 부르고, 그다음 step 한 번만 그 판정을 미룬다. 다음 주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
2026-10-08 config(vcc): 앞바퀴 양옆 초음파 2개도 읽는다 — run71 옆면 스침, 사용자 결정
    run71 17:06:53 앞 센서가 보던 물체가 옆으로 빠진 뒤 VCC 가 출발해 왼쪽 옆면이 스쳤다
    (left_wheel 0.03 m — 이 센서는 VCC 에 안 들어가 있었다). 10-05 원래 네 토픽으로 되돌린다.
    run65(같은 구성)는 원호 허상으로 차선 옮김 20.2/분 — 다음 주행에서 다시 잰다.
    초음파 기억 규칙(37f813e)은 그대로(사용자 지시). 끄기: ["/ultrasonic/vcc_off"].
2026-10-08 config(guidance): 회전 신호 창 1.5 -> 1.0 s·켜는 각 20 -> 15°·작은 회전 35 -> 25° — 패들 늦은 복귀
    run71(10-08) 사용자 지적: 패들이 늦게 돌아온다. 신호는 '최근 창 동안 돈 합이 10° 이하'에서 꺼져
    멈춘 뒤 (창 − 10°/회전속도) 만큼 늦었다. 창만 줄이면 1초 20° 가 제자리 회전 최고 속도와 같아
    켜는 각을 15° 로, 창 합으로 재는 작은 회전 문턱(6295950)도 25° 로 같이 줄였다(35° 그대로면
    달리며 돈 진짜 회전 2개가 사라졌다).
    run71 재생(검출기+조정기 전체): 사라진 신호 0, 13개가 0.2~0.85 s 일찍 켜짐,
    회전 끝 → 꺼짐 중앙 0.50 -> 0.25 s·최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
2026-10-08 config(guidance): 초음파 그리는 폭을 물리 빔과 통일 — 앞·뒤 30 -> 50°(바퀴 옆 60° 그대로)
    09-02 A/B 의 '의도된 불일치'(물리 50° · 그리는 30°)는 costmap 초음파 층과 옛 컨트롤러 시절 결과다.
    지금은 costmap 층이 꺼져 있고 VCC 만 이 폭으로 원호를 그린다. 30° 로 그리면 빔 가장자리 물체가
    가운데 쪽에 그려지고 몸 모서리 앞 띠가 0.63 m 안에서 원호 밖이 되어, 가까이 오면 '봤다 못 봤다'가
    됐다(run71 17:06:53, 사용자 관찰). 사용자 결정으로 통일한다.
    대가: 먼 물체 원호가 넓어진다(1.5 m 에서 0.79 -> 1.40 m) — 다음 주행에서 차선 옮김·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
2026-10-08 feat(mission): Home 알림 — 홈 0.5 m 안·IDLE 이면 1분마다 M3 를 ambient 로 말한다
    10-08 사용자 요청. 사람이 소리로 로봇 위치를 알게 하는 표지다. 홈인지는 상태가
    아니라 /amcl_pose 로 판정한다(RETURNING 은 실패해도 끝나므로). 대화 중이면
    건너뛰고 박자는 유지, 홈을 벗어나거나 IDLE 이 아니면 박자를 처음부터 잰다.
    파라미터 home_beacon_interval_sec(0 = 끔). M3 글자도 '비카가 대기 중입니다.'로 줄인다.
2026-10-08 feat(vcc): 초음파 채널별 거리 상한 — 바퀴 옆은 0.40 m 안만 VCC 에 넣는다(사용자 결정)
    run71 달리는 중 바퀴 옆 값의 약 95 % 가 0.4~1.5 m 의 벽·사람이었다. 0.40 m(= slow_clearance 0.35 +
    몸 여유 0.05)보다 먼 옆 값은 곧게 갈 때 속도를 바꾸지 못하고 차선·유턴 판단에만 들어가 허상을 만든다.
    상한보다 먼 값은 VCC 에겐 '에코 없음'(max_range)으로 바꾼다 — 확인·기억 규칙(37f813e)은 그대로.
    us_near_confirm_range 0.40 과 같은 경계라 남는 값은 한 번에 인정된다.
    us_max_range_per_topic: [0.0, 0.0, 0.40, 0.40](ultrasonic_topics 순서, 0 = 없음). 감속 범위 avoid_horizo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
2026-10-08 fix(guidance): 앞 초음파 두 개를 물리 빔·그리는 폭 모두 30° 로 — run72 50° 원호가 차선을 다 막음
    01f732b 로 그리는 폭을 50° 로 넓혔더니 run72(10-08 20:19~20:41)에서 콘 하나에 정지·제자리 회전이 났다.
    VCC 는 거리 하나를 빔 폭 전체 점 7개 원호로 찍는다 — 콘이 0.8 m 앞일 때 30° 는 바깥 2차선이 열리지만
    50° 는 13차선이 다 막히고 약 0.5 m 까지 열리지 않는다(단순 모형). 사용자 결정으로 앞 두 개는
    펌웨어 지향각 레벨 1(30°)·드라이버 그리는 폭 0.524 로 함께 맞춘다. 바퀴 옆 60°·뒤 50° 그대로.
    나노 업로드 완료(10,412 B, 33 %/34 %),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
    [smart_handle_firmware.ino, user_guidance.yaml]
2026-10-08 refactor(mission): 음성 요청 갈래를 로직(on_voice_intent)으로 옮긴다 — 반응표 전수 시험 준비, 동작 그대로
    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
2026-10-08 test(mission): 미션 요청 반응표 230칸 시험 — 바꿀 56칸은 작업마다 푼다(strict xfail)
    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
2026-10-08 fix(mission): 잠깐을 상태마다 같은 뜻으로 — 질문 중 '네?'·일시정지 중 같은 말·홈 복귀 중 세우기(반응표 규칙 1)
    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
2026-10-08 fix(mission): 기다려를 버리지 않는다 — 안내 중 멈춤·확인 질문은 아니요·대기 중 시간 다시(반응표 규칙 1)
    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
2026-10-08 fix(mission): 다 됐어를 버리지 않는다 — 안내 중·일시정지는 취소 되묻기, 확인 질문은 아니요(반응표 규칙 1)
    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
2026-10-08 fix(mission): 다시 가자에 맞는 답 — 가는 중이면 가는 곳, 도착 뒤·대기 중이면 어디로 모실까요(반응표 규칙 1)
    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
2026-10-08 fix(mission): 아니요·취소 — 시간 질문·M2 뒤는 마칠까요로 확인, 취소 확인의 네·아니요를 받는다(반응표 규칙 1)
    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
2026-10-08 feat(mission): 대기 중 취소는 '안내가 필요 없으신가요?'로 묻는다 — 사용자 결정 3
    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
2026-10-08 feat(mission): 홈 가는 중 기다려는 직전 목적지 대기 장소로 — 사용자 결정 1, 늦은 네·아니요는 질문의 뜻대로
    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
2026-10-08 feat(mission): 시간 질문의 네는 다시 묻고, 확인 질문 중 다른 목적지는 '네, XX로…'로 — 사용자 결정 2·4
    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
2026-10-08 feat(mission): 접근 질문에 목적지로 답하면 수락하고 돌아선 뒤 그 목적지를 묻는다(반응표 규칙 1)
    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
2026-10-08 feat(mission): 질문마다 한 번 다시 묻기 — 확인·취소 확인·도착 질문·대기 중 질문(사용자 제안 10-08)
    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
2026-10-08 feat(vcc): 초음파 '지나갈 때까지 기억' — 빔 밖으로 나간 콘을 잊지 않는다(사용자 결정, run74 뒤)
    옛 규칙(37f813e)은 에코 없음·더 먼 값이 2번(약 0.8 s)이면 기억을 지웠다. 몸을 틀어 콘이 앞 빔과
    바퀴 옆 빔 사이 대각선 사각으로 나가도 지워져, 콘 쪽 차선으로 돌아가 스쳤다(run71 17:06:53·run74 21:12:33).
    us_pass_memory 를 켜면:
    - 확인된 점을 지도(odom) 자리 그대로 채널당 최대 4개(us_memory_slots) 기억한다.
    - 센서가 그 자리를 다시 비추는데 에코 없음·더 먼 값이 2번이면 지운다 — 빔 밖으로 나간 점은 지우지 않는다.
    - 몸 뒤 끝 + 0.2 m(us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
2026-10-09 feat(ultrasonic): 이전 방식(costmap RangeSensorLayer)으로 비교 — 물리 50°·그리는 30°·바퀴 옆 0.40 m
    run76·77(10-09)에서 VCC 직접 읽기+지나갈 때까지 기억이 정지 32~49 %(run74 21 %). 센서 바로 앞(0.02 m)
    기억점이 센서 뒤로 가면 빔으로도 지나감으로도 안 지워져 us_memory_time 30 s 만료까지 막혔다.
    사용자 결정으로 이전 방식과 비교한다.
    - nav2: local costmap 초음파 층 4개(앞 2·바퀴 옆 2) 켬, VCC ultrasonic_topics = vcc_off.
    - 드라이버: ultrasonic_max_range_m_per_channel 추가(Nav2 층에는 거리 설정이 없어 메시지 max_range 를 쓴다).
    바퀴 옆 0.40 m — VCC 때 us_max_range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
2026-10-09 feat(ultrasonic): 주행에는 앞 두 개만 — 바퀴 옆·뒤 6채널을 펌웨어·드라이버에서 끔(앞 4.8 Hz)
    사용자 결정(10-09 run79 뒤): 안 쓰는 초음파가 주행에 조금도 영향을 주지 않게 한다. 엘리베이터·로봇팔
    주행 때 다시 켠다.
    - 펌웨어: US_CH_ON {0,1,1,0,0,0,0,0}. 꺼진 채널은 쏘지도 읽지도 않고(프레임 0 = 무효), 켜진 채널이
    없는 라운드는 건너뛴다 → A·B 2라운드 210 ms/바퀴, 앞 채널당 2.4 → 4.8 Hz. 8채널 프레임은 B 뒤.
    - 드라이버: ultrasonic_channel_enabled — 꺼진 채널은 토픽을 만들지도 발행하지도 않는다(RViz·costmap·
    VCC·bag 에 없음). measur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
2026-10-09 fix(mission): 반응표 최종 검토 — 지난 질문을 상황이 바뀌면 닫는다, 접근 확인의 아니요는 다시 묻기
    10-09 사용자 승인. 고친 것:
    - I-3 대기 중 "더 기다려"가 물어 둔 대기 질문을 닫는다 — 15초 뒤 같은 질문·"아니"에 홈으로 떠나던 결함
    - I-4 비상 정지가 대기 질문·대기 시간 기억을 버린다 — 해제 뒤 새 안내에서 옛 질문이 나오던 결함
    - I-5 도착·다시 출발이 "안내를 취소할까요?"를 닫는다 — 도착 질문의 "네"를 먹고 15초 뒤 또 묻던 결함
    - I-7 접근에서 온 확인 질문의 아니요·무응답은 온보딩 문장으로 어디 갈지 다시 묻는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
2026-10-09 feat(ultrasonic): 앞 초음파 두 개를 global costmap 에도 — 물리 30°·그리는 20°
    run80(10-09): 라이다보다 낮은 박스·병을 SMAC 과 레일 막힘 판정(IsRailAheadClear)이 못 봐서
    VCC 13 차선 안에서만 피하려다 막혔다(막힘 70 %). 경로를 그리는 쪽이 초음파를 보게 한다.
    - nav2 global_costmap: range_sensor_front_left/right 추가(obstacle_layer 뒤·obstacle_inflation_layer 앞)
    - 펌웨어 US_ANGLE_LEVEL_CH 앞 두 개 레벨 1(30°, 이 센서 최소). 업로드·되읽기 (1,1) 확인
    - 드라이버 그리는 폭 앞 두 개 20°(0.349). 1.5 m 에서 칠하는 폭 0.80 -> 0.53 m
    - 최대 거리 1.5 m 유지(VCC avoid_horizon 1.5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
    [smart_handle_firmware.ino, user_guidance.yaml]
2026-10-09 feat(mission): 장애물 안내 판정을 미션 패키지로 옮긴다 — 1단계 판정 그대로(run81 16번 모두 실물)
    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
2026-10-09 feat(mission): 장애물 안내 입력·지도·로그·보호막 — 오류가 나면 안내만 끄고 미션은 계속
    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
2026-10-09 feat(mission): 장애물 안내를 말할지 미션이 정한다 — 안내 주행 중만, 듣는 중·취소 확인 대기·2.5초 지남이면 안 함, ambient
    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
2026-10-09 feat(mission): 장애물 안내를 미션이 TTS 로 — 입력은 전용 콜백 그룹·라이다 깊이 최신 1장, 말할지는 _tick, 오류면 안내만 끔
    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
2026-10-09 fix(mission): 장애물 안내 최종 검토 — 후보 큐를 경쟁 없이 꺼내고(take_all), 설치 단계 오류도 안내만 끈다
    I-1: 판정 줄의 clear() 와 대화 줄의 popleft 가 겹치면 _tick 밖 IndexError 를 MultiThreadedExecutor 가 다시
    던져 미션이 끝날 수 있었다 — 판정 줄은 큐를 비우지 않고, 대화 줄은 take_all 로 꺼낸다.
    I-2: _setup_obstacle_narration 의 tf·구독·타이머 설치가 보호막 밖이라 예외면 미션이 안 떴다 — try 로 감싸
    안내만 끈다. 격리 도메인(42) 연기 시험: 정상·일부러 낸 설치 오류 둘 다 미션 계속.
    Claude-Ses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
2026-10-09 fix(mission): 접근 질문 — '비카야'에 접지 않고, 예·아니요가 아니면 한 번 다시 묻고 그다음 아니요(10-09 사용자 결정)
    run82(10-09) 세 장면: 17:14·17:17 '비카야'에 접근 질문이 접혀(IDLE·트랙 억제) 이어진 "그래"·
    "안내를 받을게요"가 버려졌고, 17:19 "나 골랐어"를 처리하는 사이 8초 시계로 "실례했습니다" 떠났다.
    - AWAITING_USER 의 '비카야': 말을 끊지 않고 "네?"도 없이 WakeReply(listen) — 질문을 접지 않는다
    (음성 귀도 이 단계에서 호출을 끄며, 이것은 새어 든 호출의 이중 장치).
    - 예·아니요가 아닌 말(질문·못 알아들음·잠깐·다시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
2026-10-09 config(nav2): global 새 물체 inflation 0.35 -> 0.30 — 우회 폭 줄이기
    run81(10-09) 레일 우회가 레일에서 0.74~1.10 m 벗어났다. 정지 시험(~/vica_data/bench_detour.py,
    병 1 m·0.6 m·박스 2 m)에서 0.30 은 이탈 폭 0~9 cm·각도 0~3° 감소. 0.25 는 내접 0.277 아래라
    띠 바깥 경사가 사라져 시험(test_global_costmap_inflates_walls_and_new_obstacles_separately)에 걸리고
    SMAC 이 몸 옆면이 닿는 경로를 낼 수 있어 0.30 으로 정했다(사용자 결정). 벽 0.55 는 그대로.
    시험: nav2 실패 13개는 변경 전과 같은 목록.
    Claude-Session: https://claude.ai/code/se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
2026-10-09 fix(mission): 접근 질문 다시 묻기를 세 번까지, 대답 없이 물러날 때는 '비카야'를 알려 준다(10-09 사용자 결정)
    10-09 18:12 실기: 다시 묻기가 한 번뿐이라 꺼 둔 호출어 '비카야'(STT '미카야.')가 못 알아들은 말로
    세어져 기회를 다 썼고(18:13), 두 번째 대답이 질문이면 LLM 답 직후 "알겠습니다. 이만 물러납니다."로
    떠나 묻고 떠나는 꼴이 됐다(18:39).
    - APPROACH_REASK_MAX = 3: 예·아니요가 아닌 말이나 8초 침묵에 '안내를 받으시겠어요?'를 세 번까지
    (_approach_reasked 참·거짓 → _approach_reasks 횟수). 다 쓴 뒤의 비답·침묵은 물러난다(홈 복귀).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
2026-10-09 feat(mission): 직전 안내가 성공으로 끝난 뒤 새로 출발할 때 local costmap 을 한 번 비운다
    run81 15:48(홈)·run82 18:14(사회 복지창구)에서 출발 제자리 회전이 각 10 s 섰다.
    접근·도착 끝의 회전(마지막 정렬, 손잡이 돌리기)으로 빔 밖에 남은 초음파 표시가
    막았고, 10초 포기(FollowPath 실패 -> BT ClearLocalCostmap) 뒤에야 돌았다.
    같은 서비스(local_costmap/clear_entirely_local_costmap)를 출발 순간에 미리 부른다
    (10-09 사용자 결정: 직전 안내가 다 끝나고 새로 출발할 때마다).
    - 앞 NavigateToPose 가 SUCCEEDED 로 끝났을 때만 비운다. 새 goal 이 수락되면 끈다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
2026-10-10 config(nav2): BT 서버 응답 대기 default_server_timeout 100 -> 300 ms (run83 뒤 사용자 결정)
    run83(10-09) 전부 다시 켠 뒤 CPU 가 쉴 때도 90 % 에 붙어, BT 가 0.1 s 안에 접수·응답을
    못 받은 시간초과가 126번 났다(compute_route 44·compute_path_to_pose 42·costmap 비우기 27·
    follow_path 8). 그 때문에 사회 복지창구 2번·홈 3번 Nav2 실패, run82 는 0번이었다.
    Humble BtActionNode·BtServiceNode 는 접수·응답을 RUNNING 으로 기다려 트리를 막지 않는다.
    막는 곳은 halt 뿐 — cancel·result 를 각각 이 시한까지 기다려 최대 0.2 -> 0.6 s 멈춘다.
    1 s 이상은 그 멈춤이 2 s 가 돼 쓰지 않는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
2026-10-10 feat(mission): 배송지 도착 이벤트에 "delivery": true — 웹에서 보낸 배송도 관리자 유심 폰이 문자를 보내게
    문자는 배송을 시작한 앱만 보냈다. 웹은 문자를 못 보내 웹 배송은 문자가 안 갔다(10-09 run83 408호).
    10-10 사용자 결정(웹 배송 문자 A안): 로봇이 배송지 도착에 표시를 싣고, 관리자 유심 폰 앱이
    누가 보냈든 그 표시를 보고 문자를 보낸다. 보내는 번호(관리자 유심)는 하나다.
    - 배송 요청(request_delivery)이 받아들여져 실제로 출발했을 때만 목적지 id 를 기억한다.
    - 그곳의 goal_succeeded 에만 "delivery": true 를 싣고 잊는다. 실패·취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
2026-10-10 perf(mission): 장애물 안내 입력은 안내 주행 중에만 받는다 — 쉴 때 미션 CPU 코어 하나 46 % -> 1.6 %
    2026-10-10 실측(로봇과 다른 도메인에 미션 노드를 띄우고 run82 녹화를 흘림): 장애물 안내를 켜면
    미션이 쉴 때도 코어 하나의 46 %(끄면 2.4 %) — 판정 계산이 아니라 메시지 받기(tf 52 Hz 약 21 %,
    라이다·깊이 약 13 %, rosout 약 6 %). 안내 멘트는 원래 NAVIGATING 에서만 나가므로 입력도 그때만 연다.
    - _tick 끝의 _obstacle_inputs_follow 가 dialog_state 로 _obs_start / _obs_stop 을 부른다(0.2 s 안).
    - 열 때: judge.clear_inputs() -> 새 tf Buffer·리스너 -> 라이다·깊이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
2026-10-10 feat(handle,mission): 대기 중 "비카야"에 손잡이 위치 알림 진동(locate) — 1초씩 두 번, 사이 1초
    볼일을 마친 사용자가 대기 장소의 비카를 소리(M3)에 더해 손으로도 찾게 한다(10-09 사용자).
    - 미션: WAITING 에서 "비카야"를 들을 때만 Haptic("locate"). 손 놓기 기다림(WAITING_RELEASE)·다른
    상태는 떨지 않는다. 일반 호출과 창 안에서 건진 호출 모두 한 번.
    - 손잡이: 펌웨어 HAPTIC_CMD_LOCATE 0x13(1000 ms on/1000 ms off x2), protocol·드라이버
    HAPTIC_PATTERNS 에 "locate", bench_test --haptic locate.
    - 나노 업로드 10-09 21:23(검증 통과), run83 21:41:17 대기 중 "비카야"에 0x1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
2026-10-10 fix(mission): 귀가 말을 받은 뒤 LLM 을 기다리는 유예 6 -> 8초(10-10 사용자 결정 2-가)
    10-10 12:13 주행: 접근 질문에 "그래."가 STT 를 지난(closed) 뒤 Realtime 이 9초 만에 시한 초과로 실패해(10-01 이후
    유일한 1건, 이날 Realtime 중앙 2.0 s·최대 4.6 s로 평소보다 느림) 글자 경로의 affirm 이 closed 7.4초 뒤 왔다.
    EAR_GRACE_SEC 6초가 먼저 끝나 미션이 "안내를 받으시겠어요?"를 다시 묻고, 1.3초 뒤 "네, 잠시만 기다려주세요."로
    수락해 묻고 바로 스스로 답한 꼴이었다.
    - EAR_GRACE_SEC 8.0: 귀 홀드를 쓰는 모든 대답 대기(접근 질문·도착 질문·대기 중 질문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
2026-10-10 feat(mission): LLM '생각 중'(/vica/thinking)이면 대답 대기 시계를 잡는다(10-10 사용자 결정)
    10-10 12:13 장면: 접근 질문의 "그래."를 Realtime 이 9초 만에 실패하는 동안 미션은 귀 유예만 보고 다시 묻고,
    1.3초 뒤 늦은 affirm 으로 수락했다. LLM 노드는 이미 Realtime·글자 경로 호출 전후로 /vica/thinking 을 켜고
    끄는데(2026-09-01, TTS 생각 중 운율용) 미션은 이 신호를 듣지 않았다 — 귀 홀드(08-30)가 먼저 고정 유예로
    만들어져 연결되지 않았다.
    - 노드: /vica/thinking(Bool) 구독(주 그룹) -> logic.on_llm_thinking.
    - 로직: 켜진 동안은 _ear_holds·_dest_prompt_holds 가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
2026-10-10 feat(vcc): 방향까지 맞추는 도착은 마지막 0.3 m 에서 끝점이 거의 정면이면 곧게 간다 — (b′), 사용자 결정 10-10
    남은 경로가 end_extend_min_length(0.3 m)보다 짧아지면 끝 연장 조준(해결안 가)이 꺼지고
    끝점을 바로 조준한다. 끝점이 코앞이라 옆 몇 cm 만 어긋나도 조준각이 커져 회전이 최대(0.5)까지
    붙고, 도착 정렬이 그 회전을 되돌렸다.
    - run65~67 도착 반대 회전 10~27°(10-05 원인 확정)
    - run82 사람 접근 track 69: 끝점 옆 1~5 cm 에서 −0.5 rad/s 로 9° 더 튼 뒤 정렬이 30° 되돌림
    끝점(goal)이 앞(x > 0)에 있고 옆으로 end_straight_lateral 안이면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
2026-10-10 feat(mission): 사람 접근 — 절반쯤에서 한 번 다시 재고, 같은 사람은 자리로 잇는다(B6, run84 뒤 사용자 결정)
    run84(10-10): 6 m 에서 잰 사람 위치가 다리보다 0.25~0.45 m 멀었고(라이다도 6 m 에선 +0.4), 도중
    추적기가 같은 사람에게 새 번호를 붙여(12→16, 24→26) 가까이서 잰 위치가 busy_approaching 으로
    거절됐다. 로봇은 다리 0.63~0.69 m 에 섰고 "네" 뒤 180° 가 손잡이 꼬리 원(padding 포함 0.62 m)에
    걸린 사용자 다리 때문에 96·129° 에서 멈췄다. 3.15 m 에서 목표가 고쳐진 A 만 1.13 m·187°.
    - 같은 사람 = 자리(approach_recheck.same_person, 반경 0.8 m): 접근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
2026-10-10 feat(mission): 사람 접근 거리 1.1 -> 1.0 m, 수락 뒤 손잡이 회전 명령 180 -> 175° (run85 뒤 사용자 결정)
    run85(10-10 17:38~18:13): 중간 재측정 뒤 다리가 목표 −0.01~+0.09 m 에 섰다(1.09~1.19 m) — "좀 멀다".
    1.0 이면 다리 약 0.99~1.09 m, "네" 뒤 회전의 손잡이 꼬리 원(padding 포함 0.62 m)까지 0.37 m.
    run85 costmap 으로 0.3 m 더 붙여 180° 돌려 봐도 안 막혔다. 지팡이를 다리보다 0.37 m 앞에 짚으면
    (run84 D) 0.62~0.72 m 라 장애물로 찍히면 막힐 수 있다 — 그때는 1.1 로 되돌린다.
    회전: behavior_server Spin 이 늘 6~8° 더 돈다(run84 187°, run85 186·186·188°, odom·IMU 일치).
    ru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
2026-10-10 perf(mission): 장애물 안내 입력을 보조 노드 단일 실행기로, 위치는 tf 대신 AMCL+odom — 안내 주행 중 미션 CPU 46 -> 20~24 %
    ① 37cf7fd(입력은 안내 주행 중에만) 뒤에도 주행 중 미션은 코어 하나의 42~53 %를 썼다. 판정 계산은
    녹화 재현 2.7 %뿐이고 나머지는 메시지 받기 부담이었다(tf 초당 52통 ≈ 21 %, rclpy 다중 실행기 ≈ 14 %).
    - ②-나: 위치는 tf 리스너 대신 /amcl_pose(헤더 시각) + 그 뒤 /odom 변화(OdomTrail.pose_since).
    /tf_static 만 Buffer.set_transform_static 으로 넣는다(라이다 위치). package.xml 에 tf2_msgs.
    녹화본 run81·run82 판정 185/185·89/89 같음, 방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
2026-10-10 fix(mission): 장애물 안내는 이번 말의 LLM 답이 이미 왔으면 대답 유예(8초)를 기다리지 않는다 — A′, 사용자 결정 10-10
    3c39015 가 귀 닫힘 뒤 유예를 6 -> 8초로 늘리면서 장애물 안내(obstacle_cue)도 같은 _ear_holds 를 봐
    더 오래 막혔다. 10-10 12:10 주행: 확인 "네"의 답이 닫힘 0.18초 뒤에 와 출발했는데도 장애물 안내가
    8초 동안 ear_busy 로 빠졌다.
    - _obstacle_ear_holds: 듣는 중(상한 EAR_HOLD_MAX_SEC)·생각 중(꼬리 1초 포함)은 그대로 잡는다.
    닫힘 뒤 유예 안이어도, 이번 창이 열린 뒤(_ear_busy_since 이후) 생각 중이 켜졌다 꺼졌으면 답은 온
    것으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
2026-10-10 fix(mission): 장애물 '한 번만' 기억은 앞 안내가 끝난 뒤 새 출발에서 지운다 — 수리 B, 사용자 결정 10-10
    '한 번만' 기억(last_ann)은 평상 주행(calm: TRACK·|조향|<0.3·v≥0.3 이 2초)으로만 풀렸다. ①(입력은 안내
    주행 중에만, 37cf7fd) 뒤로는 귀가·대기 장소 이동 중 calm 이 채워질 기회가 없어, 10-10 12:12·12:14 새
    안내의 장애물이 전부 '묶음'으로 빠졌다(12:10:33 에 말한 기억이 주행을 넘어 남음).
    - on_goal: goal_paused 가 아닌 끝(도착·취소·실패·중단·거절·return_home_*) 뒤 다음 GOAL_START 에서
    last_ann·calm_start·calm_done 을 지운다(trip_ended). 일시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
2026-10-10 feat(mission): 출발 전 비우기에 global costmap 도 넣는다 — run84 치운 상자 유령, 사용자 결정 A(10-10)
    run84(10-10 15:29)에서 창구 안내가 왼쪽 위 코너를 대각선으로 잘랐다. 레일 앞 검사
    (IsRailAheadClear)는 global costmap 을 보는데, 접근 때 그린 상자의 초음파 표시가
    상자를 치운 뒤에도 남아 레일을 막았다(15:26:55 표시 -> 앞 빔이 다시 본 15:31:18 까지).
    초음파 층은 빔 원뿔 안 칸만 고치고 시간 소거가 없어, 비켜 가면 다시 못 본다.
    어제(d66ec26) 출발 전 비우기는 local 만 비웠다.
    - 같은 규칙(앞 NavigateToPose 가 SUCCEEDED 일 때만, 앞 task 가 돌면 건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
2026-10-10 chore(maps): 시연테스트 레일을 ∩ 한 줄로 바꾸고 통째로 오른쪽 +0.50 m — 시연장 구역 맞춤·왼쪽 치우침(10-10 사용자 지시)
    이전 판(10-02, 노드 11·갈래 여러 개)을 시연장 '최소 사용 구역 3.8×6.5 m' 와 같은
    ∩ 한 줄로 바꿨다. 둘 다 /vica/route/save(앱과 같은 길)로 저장·검사했다.
    - 12:26 ∩ 판: 홈 (5.34, 2.264) 을 왼쪽 위 꼭짓점으로 (5.34,−2.636)-(5.34,2.264)-
    (7.58,2.264)-(7.58,−2.636). 11.4 m·노드 21·코너 R 1.0/0.56, 경고 2(왼쪽 레일이 kz_5 안
    책상에서 0.65 m).
    - 17:21 +0.50 m: (5.84,−2.636)-(5.84,2.264)-(8.08,2.264)-(8.08,−2.636). 경고 0·벽 최소
    0.95 m. 이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
2026-10-11 feat(mission): 장애물 안내를 비켜 감·감속·정지 셋으로 — 실제로 선 때 '정지합니다', 실기 수리 ①~③(10-10·10-11 사용자 결정)
    10-10 사용자 결정: 멘트 셋 "앞에 장애물이 있어 비켜갈게요." / "…감속할게요." / "…정지합니다.",
    기준은 로봇이 실제로 한 일. 옛 '천천히 갈게요' 16번 중 6번이 실제 정지였다(10-10 로그).
    - obstacle_judge: PHRASES 3개, VCC HOLD·충돌감시 stop 은 'stop'. 감속 문장은 STOP_UPGRADE 0.7 s
    기다려 그 안에 뺄 이유 없는 정지가 시작되면 '정지' 한 마디(뒤 정지는 묶음). 대가: 감속 멘트 0.7 s 늦음.
    - mission_logic: MSG_OBSTACLE_AVOI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
2026-10-11 fix(mission): 질문보다 먼저 시작한 예/아니요는 그 질문의 대답으로 쓰지 않는다 — run90 18:43 늦은 "네"(10-11 사용자 결정 ②)
    run90 18:43:35 주행 중 "비카야"→"네?"에 한 "네"(말 시작 36 쯤)가, 그 사이 도착해 39.55 에 물은
    "여기서 대기할까요?"의 대답으로 쓰여 곧바로 "몇 분쯤 걸리실까요?"로 넘어갔다 — 대답도 안 했는데 질문이
    이어졌다. 음성 노드는 단일 실행기라 처리 중 질문 신호를 못 받아 음성 쪽만으로는 못 고친다 -> 미션에서
    가린다(인터페이스 변경 없음).
    - 노드 _run_actions: 대답을 청하는 말(Say.expects_reply)을 내보낼 때 lo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
2026-10-11 feat(mission): 목적지 1 m 안에서는 손잡이를 놓아도 세우지 않고 그대로 도착한다(10-11 사용자 결정)
    사용자: "목적지 1m안에서는 손 놓아도 그대로 도착하게 합시다. 1m면 괜찮을듯해요."
    로봇이 목적지 앞에서 느려지면 시각장애인은 "다 왔구나" 하고 먼저 손을 뗀다 — 0.5 s 놓침으로 코앞에서
    PAUSED + "손잡이를 놓쳤어요"가 나오면 다시 잡아 몇십 cm 를 더 가야 한다.
    - HANDLE_ARRIVAL_FREE_M = 1.0: 로봇 위치와 목적지의 지도 위 직선 거리.
    - HANDLE_ARRIVAL_FREE_PATH_M = 1.5: Nav2 남은 경로(distance_remaining)를 알면 그것도 이 안이어야 한다 —
    직선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
2026-10-12 chore(maps): 시연테스트 금지구역 kz_6(x 6.07~6.19 세로 띠) 지움 — 10-08 사용자 편집, 그 뒤 주행은 모두 이 상태
    10-08 10:39 앱에서 지운 것이 커밋되지 않고 남아 있었다. 10-08 이후 run69~ 주행과
    10-12 4×7 레일 배치(아래 직선 y −2.997)가 모두 이 금지구역 없이 계산됐다.
2026-10-12 chore(maps): 시연테스트 레일을 사방 금지구역 가운데 4×7 로 — 12.4 m·코너 R 1.00/1.00(10-12 사용자 지시)
    rail_template.py apply --map map_1002_150946 --zone 4x7 --home 5.357,2.103,270
    --ignore-zone --offline 로 씀(새 둥글기 코드, 켜져 있던 레일 노드는 옛 코드라 --offline).
    - 꼭짓점 (5.657,−2.997)(5.657,2.403)(8.097,2.403)(8.097,−2.997). 홈 위치와 무관하게
    금지구역 안쪽(x 4.69~9.06, y −3.65~3.05) 대략 가운데.
    - 금지구역까지 양옆 0.97 · 위아래 0.65 m, 벽 여유 최소 0.86 m, 홈↔레일 0.80 → 0.58 m,
    장소는 모두 레일 0.6 m 안. 장소·홈 파일은 그대로.
    - --ignore-zone: 도장 칸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
2026-10-12 feat(maps): 레일테스트 지도 map_1012_095323 추가 — 10-12 매핑, 금지구역 4개, 레일 4×7(옛 둥글기)
    - 10-12 09:53 사용자 매핑("레일테스트"), 10:02 홈 앞 까만 점 (1.45, 0.75) 지움
    (원본은 *.erase-20261012.bak, 저장소 제외), 10:24 지도 테두리 둘레 금지구역 4개.
    - 레일: 레일 도장으로 3.8×6.5(10:20) → 4×6.5(11:10) → 4×7(11:29) 차례로 깔아 주행.
    세 버전 모두 사용자 판정 "잘 깔리고 주행 경로 정상", Nav2 중단·오류 0.
    - 지금 레일은 4×7, 12.5 m, 코너 R 1.00/0.65(12:16 둥글기 수정 전). 새 도장으로 다시
    찍으면 12.4 m·R 1.00/1.00 — 다시 찍을지는 사용자 결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
2026-10-12 feat(motor): 모터 노드 C++ 판 mdrobot_can_control_cpp — 파이썬 판과 같은 이름·판정·로그, 원본 대조 시험
    왜: 모터 노드는 주행·정지와 무관하게 30 Hz 로 돌아 코어 하나의 평균 8.7 %(기록 25회차,
    6.2~11.6 %)를 썼다. 격리 벤치(가상 CAN, 실제 버스와 같은 프레임 주기)에서 C++ 가 같은 일을
    약 1/5 로 했다(10-12 격리 launch 시험: 파이썬 6.45 % / C++ 1.38 %).
    같게 맞춘 것:
    - 노드 이름 mdrobot_can_keyboard_knob_node, 실행 파일 keyboard_knob(터미네이터 guard
    pgrep -x, CPU 기록기, 진단 프로브가 이 이름을 본다), 파라미터 이름·타입·기본값·순서,
    /cmd_vel_safe·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
2026-10-12 feat(motor): motor_bringup 기본을 C++ 판으로 — motor_impl:=python 으로 되돌린다
    - motor_bringup.launch.py: motor_impl 인자(cpp 기본 | python). 실행 파일·노드 이름·파라미터는
    두 판이 같아 package 만 바꾼다. 그 밖의 값이면 launch 를 오류로 멈춘다(조용히 모터를 안
    띄우면 원인을 찾기 어렵다). 매핑 bringup 의 include 도 기본값(cpp)을 받는다.
    - package.xml: exec_depend mdrobot_can_control_cpp — --packages-up-to 로 함께 빌드되게.
    주의: --packages-select mdrobot_can_control 만 빌드하면 C++ 판이 없어 모터가 안 뜬다.
    - README: 되돌리는 명령, 파이썬 코드는 C++ 대조 시험의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
2026-10-12 feat(mission): 서 있을 때 "멈춰"도 "지금은 비상 멈춤 상태입니다."로 알린다 — 사용자 결정 B(10-12)
    08-31 결정(5bc328b)으로 정지 중 E-stop 은 침묵했는데, 그 규칙이 음성 "멈춰"에도 걸려 서 있는 로봇에게
    "멈춰"라고 하면 래치는 걸리고(관리자 해제 필요) 로봇은 아무 말도 하지 않았다 — 말한 사람은 들렸는지·잠겼는지
    알 수 없다(시각장애인은 앱도 못 봄). 사용자가 "서 있으면 무시?"를 물었으나 무시는 거절: '서 있음'은 바퀴가 아니라
    미션 상태(_GOAL_ACTIVE_STATES)라 앱 원격 조종(/cmd_vel_req 직행) 중에도 IDLE 이고, 확인 질문·출발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
2026-10-12 fix(handle): 레일 방향지시 예고를 몸 회전 약 2초 전으로 — 조준거리 보정 0(VCC), 첫 점 뒤 레일 위 판정, 늦은 예고 막기, U 한 신호(10-12 사용자 결정 A·C)
    사용자 "방향지시가 좀 일러". 녹화 5개(run84~90)에서 예고 → 몸 10° 중앙 5.0 s.
    - A: 예고 시점의 조준거리 보정(2.5 s·0.6~1.2 m)은 RPP 가 조준거리만큼 일찍 돌던 것을 맞춘 값.
    VCC 는 코너 시작에서 돈다 → yaml 보정 0. 0.5 m/s 에서 코너 시작 1.0 m 앞(2 s 전).
    계약 시험: FollowPath 가 VCC 면 0, RPP 면 FollowPath 값과 같아야 한다.
    - C: Route Server 가 레일을 로봇 앞 노드(≈1 m 간격)부터 잘라 1 Hz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
2026-10-13 perf(mission): 주행 중 'Nav2 끝났나' 확인의 기다림 0.1 초 → 0.03 초 — 트리 전환 기다림은 그대로
    사용자: "0.03초가 맞아. 미션수정하고"(10-13).
    왜: nav2_simple_commander 의 isTaskComplete 는 Nav2 소식을 0.1 초 동안 기다리며 처리한다. 쉬는 시간
    없이 도는 예제 반복문(example_nav_to_pose.py)의 쉼 겸 우편함 확인으로 정해진 라이브러리 기본값이고
    (설치본 1.1.20 원본, 우리가 바꾼 적 없음 — dpkg -V·git 기록 확인), 미션은 자기 틱(_tick 5 Hz)이 있어
    그 위에 0.1 초가 겹쳤다. 그동안 오는 진행 소식(bt_loop_duration 10 ms → 최대 100 Hz)을 다 처리하느라
    CPU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
2026-10-13 feat(handle): 손잡이 드라이버 C++ 판 vica_user_guidance_cpp — 파이썬 판과 같은 이름·판정·로그, 원본 대조 시험, launch 기본 cpp
    - 새 패키지 vica_user_guidance_cpp: 실행 파일·노드 이름 user_guidance_driver_node(터미네이터 guard 앞 15자
    user_guidance_d 그대로), 파라미터 이름·순서·기본값·QoS·타이머(STEADY)·로그 글자가 파이썬 판과 같다.
    판정·순서는 DriverCore(파이썬 메서드를 옮김), 시리얼은 pyserial 3.5 동작을 옮긴 tty, /vica_goal_event 는
    json.loads 와 같은 문법(미션 json.dumps 의 NaN·Infinity 허용). TF 수신은 TransformListener 자기 스레드,
    나머지 콜백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
2026-10-13 feat(handle): 방향지시 C++ 판 turn_guide_node — 파이썬 판과 같은 판정·로그, 원본·실주행 녹화 대조, launch 기본 cpp
    방향지시(turn_guide_node)는 판정 20 Hz·/odom 30 Hz 에 레일 예고용 /tf(≈135 건/s)를 모두 받아 파이썬에서
    12 % 안팎을 썼다(run94). 손잡이 드라이버와 같은 방식으로 vica_user_guidance_cpp 에 C++ 판을 더한다.
    - turn_detector·rail_turn_forecast·turn_core: 파이썬 모듈을 그대로 옮김(파이썬 max/min 의 NaN 처리, 연쇄 비교,
    None·s_hint 걸러내기까지). pymath: math.hypot/dist 는 CPython 3.10 vector_norm 을 옮겨 비트까지 같다(200만 건).
    - rclpy_compat: 타이머 주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
2026-10-16 feat(sensor): 몸통 넘어짐 판정을 IMU 어댑터 C++ 판에 — 45° 넘게 1초면 /vica/tipped=true(10-15 사용자 결정)
    이미 만드는 base_link 기준 가속도(중력 포함)로 기울기 acos(z/|a|) 를 잰다. 바뀔 때만
    /vica/tipped(std_msgs/Bool, reliable·transient_local)를 내고, 켤 때도 1초 판정 뒤 첫 상태를
    낸다(넘어진 채 다시 켜도 '서 있음'이 먼저 나가지 않게). 풀림은 30° 아래 1초(기대 세운 로봇이
    오가지 않게), 표본 사이가 0.25 s 넘게 비면 처음부터 센다(멈췄다 돈 노드가 진동 표본 두 개로
    1초를 채우지 않게). 끊김 감시는 하지 않는다(사용자 결정 — IMU 가 끊기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
2026-10-16 feat(safety): 비상정지 원인 tipped 와 원인별 앱 팝업 본문 — 넘어짐은 관리자만 해제(10-15 사용자 결정)
    - emergency_latch·emergency_stop_node: 원인 tipped, /vica/tipped 구독(transient_local). 세우면 입력만 풀림.
    - auto_recovery: tipped 를 HUMAN_SOURCES 에 — 통신 원인과 섞여도 세우는 순간 저절로 풀리지 않게.
    - app_emergency_node:
    · 걸릴 때 원인별 한 줄을 팝업 본문으로(어긋남 1 — 예전엔 직전 메시지 '자동 해제했습니다' 등이 남음):
    넘어짐 > 버튼 > 음성 > 통신 순. 앱 버튼은 handle_activate 가 쓴다.
    · 세우기 전 해제는 "비카가 아직 넘어져 있습니다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
2026-10-16 feat(mission): 넘어짐 멘트 한 번·10초 반복, 앱 버튼 걸림은 '관리자를 호출했습니다' 빼기(10-15 사용자 결정)
    - on_tipped: "비카가 넘어져 관리자를 호출했습니다. 지나가실 때 주의하세요."(음성 구운 녹음과 같은 글자)
    하나만 — /vica/tipped 와 /emergency_stop 이 어느 순서로 와도 한 번, 서 있다 넘어져도 말함.
    세울 때까지 TIP_REPEAT_SEC 10 s 마다, 세우면 반복만 멈춤, 넘어진 동안 ESTOPPED 에서 안 나감,
    해제 뒤 '비상멈춤이 해제되었습니다.' 한 번. 넘어진 동안 '비카야'·목적지 대답을 하면 반복 시계를 다시
    세고, 넘어짐 멘트 뒤 7 s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
2026-10-16 feat(mission): 관리자 호출(도움 요청) — 안내 주행 중 help 확인·일시정지·앱 알림 10초 재전송·앱 확인
    설계: Claude Docs '비카 관리자 호출 설계서'(2026-10-15) + 10-16 사용자 결정.
    - help 는 안내 주행 중에만 받는다. "직원의 도움이 필요하신가요?" → 네 → 일시정지(목적지 보관)
    "지금 도움 요청을 보냈습니다" + help_requested(uuid4). 관리자 확인까지 10초마다 같은 id.
    - /vica/mission/help_ack(MissionCommand, request_id=help_id) → "관리자가 오고있습니다. 잠시만
    기다려주세요" + help_acknowledged. 확인 뒤엔 음성 다시 가자·새 목적지로 움직이지 않는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
2026-10-16 fix(mission): 도움 확인 질문 중 '다 됐어'는 질문을 접고 취소 질문으로 — 그 '네'가 도움 요청이 되던 것
    독립 검토(10-16): asking 블록이 finish 를 몰라 옛 갈래가 "안내를 취소할까요?"를 물었는데 도움 질문이
    남아, 그 질문의 "네"가 _send_help 로 잡혀 로봇이 서고 관리자를 불렀다. 질문은 하나만 살린다.
2026-10-16 feat(mission): 비상정지가 풀리면·관리자 홈 복귀·대기 장소 가보기 때 도움 요청을 끝낸다(10-16 사용자 결정)
    독립 검토: 비상정지를 거쳐 안내 없음으로 가면 도움 요청이 남아 알림이 끝없이 가고, 확인 뒤면 사용자
    말이 막혔다(앱 '주행 취소'는 주행·일시정지 때만 보여 끌 길도 없었다). 해제는 관리자가 앱에서 하므로
    그때 끝낸다 — 확인 전이면 help_canceled 로 앱 팝업을 닫는다. 걸려 있는 동안은 그대로(D5).
    관리자가 로봇을 보내는 홈 복귀·대기 장소 가보기도 새 목적지 선점처럼 끝낸다. 시험 5 추가.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
2026-10-16 fix(handle): 작업자 재배선 핀맵 반영 — LED 왼쪽 D9·오른쪽 D11, 서보 D8, 진동 D6(10-16)
    10-16 작업자가 손잡이 나노를 다시 배선했다(사용자 전달). 터치 D2·초음파 A4/A5 는 그대로.
    이전(10-05): 서보 D9, LED 왼쪽 D10·오른쪽 D12, 진동 D7.
    - 서보가 D8 로 옮겨져 Adafruit_TiCoServo 를 쓸 수 없다(나노에서는 Timer1 하드웨어 PWM
    핀 D9·D10 만). 표준 <Servo.h> 로 되돌리고, LED 는 서보 펄스 밖 시간 창(ledShowSafe)
    에서만 갱신한다. 10-05 실물에서 시간 창만으로는 대기 중 작은 틱이 가끔 남았다 — 거슬리면
    서보를 D9/D10 으로 옮겨 TiCoServo 로 돌아간다.
    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
2026-10-19 docs(handle): 옛 핀 번호 문구를 지금 배선으로 — 터치 D2, 진동 D6(10-16 재배선·10-19 터치 확정)
    동작 변경 없음. 로그·주석에 남아 있던 옛 핀 번호만 고쳤다.
    - 드라이버 기동 로그(파이썬판·C++판): 터치 "D11" -> "D2"
    - protocol.py: 터치 센서 "D11" -> "나노 D2", 햅틱 "D10 의 진동모터" -> "D6"
    - bench_test.py 주석: "D10 의" -> "D6 의"
    - user_guidance.yaml 터치 머리줄: "나노 시절 D11" -> "나노 D2"(옛 번호는 괄호로 남김).
    161행 "D11 이 LOW 가 안 돼" 는 그때 기록이라 그대로.
    10-19 실물: 터치 모듈 A1 패드 납땜 뒤에도 잡으면 D2 LOW·떼면 HIGH(active-low 그대로,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
